wmsz88/flex-vib-monitor/资料/README.md

# 资料索引

> 本目录保存赛题原文、评分规则、硬件设计与软件方案说明，便于和代码对照阅读。
> 官方文件版权归竞赛组委会所有，此处仅作本项目归档与复盘使用。

## 00_命题

| 文件 | 说明 |
|---|---|
| `柔性检测模块设计及制作赛项命题（更新版）.pdf` | 2026 赛项一正式命题（10 页，答辩/实现以此为准） |
| `柔性检测模块设计及制作赛项命题（更新版）.docx` | 命题 Word 版，便于摘录 |
| `命题文字版.txt` | 从 PDF 提取的纯文本，方便全文搜索 |
| `旧版命题_20260908.pdf` | 早期版本，保留用于对比（线序、外框曾有冲突） |

## 01_规则与评分

| 文件 | 说明 |
|---|---|
| `2026年评分标准.pdf` | PCB 设计 40 分（扣分制）+ 制作及测试 60 分（现场发布） |
| `2026年评分标准_文字版.txt` | 评分标准纯文本 |
| `2026年竞赛通知及实施方案.pdf` | 赛事组织、赛程、参赛要求 |
| `规则与要求整理.md` | **推荐先读**：命题逐条整理、物料表、PCB 规范、模块说明 |

## 02_硬件设计

| 文件 | 说明 |
|---|---|
| `物料清单.xlsx` | 组委会物料清单（只能用清单内器件） |
| `网表_20260921.tel` | 定稿网表（PCB 与固件引脚依据） |
| `MPU6050引脚定义.docx` | 传感器模块引脚说明 |
| `柔性振动检测模块PCB设计文档.docx` | 本项目 PCB 设计说明 |
| `电路连接图.png` | 系统电路连接示意 |
| `系统框图.png` | 硬件系统框图 |
| `PCB布局分区图.png` | 柔性板布局与弯曲避让区 |
| `硬件设计说明/01-requirements.md` | 硬件需求 |
| `硬件设计说明/02-architecture.md` | 硬件架构 |
| `硬件设计说明/03-components.md` | 器件选型 |
| `硬件设计说明/04-constraints.md` | 结构与电气约束 |
| `硬件设计说明/05-validation.md` | 验证计划 |
| `硬件设计说明/06-decisions.md` | 关键决策记录 |
| `硬件设计说明/07-pinout.md` | **引脚分配总表** |
| `硬件设计说明/08-lceda-design-rules.md` | 立创 EDA 设计规则 |

## 03_软件与方案

| 文件 | 说明 |
|---|---|
| `软件说明书.md` | 固件结构、模块职责、串口命令、参数 |
| `现场输出文档.md` | 比赛口/调试口输出格式与现场排障 |
| `历届比赛串口协议调研.md` | 历届队伍协议做法与 `$VD` 设计依据 |
| `版本讲解/v5到v9说明书.md` | **推荐先读**：v5~v9 角色、差异、判据语义 |
| `版本讲解/v5到v6逐行讲解.md` | v6 接触三条逐行说明 |
| `版本讲解/v6到v7逐行讲解.md` | v7 输出适配逐行说明 |
| `版本讲解/v7到v8逐文件讲解.md` | v8 分层检测逐文件说明 |
| `版本讲解/可调参数总表.md` | `config.h` 参数分类与现场调整 |
| `版本讲解/其他改动要求.md` | 现场常见改法合集 |
| `版本讲解/三列输出改法.md` | 平台只要三列时的改法 |
| `版本讲解/指示灯闪烁常亮改法.md` | LED 语义与改法 |

## 阅读顺序建议

1. `背景与题目.md`（在仓库根目录）——先知道比赛要做什么；
2. `01_规则与评分/规则与要求整理.md`——逐条看硬性要求；
3. `00_命题/柔性检测模块设计及制作赛项命题（更新版）.pdf`——看原图与尺寸；
4. `02_硬件设计/硬件设计说明/07-pinout.md`——确认引脚；
5. `03_软件与方案/版本讲解/v5到v9说明书.md`——再看代码。
