wmsz88/flex-vib-monitor/资料/02_硬件设计/硬件设计说明/01-requirements.md

# 01 需求冻结 — 柔性振动检测模块（赛项一）

**项目**：2026 广东省工科大学生实验综合技能竞赛 · 柔性振动检测模块
**日期**：2026-09-20 | **模式**：快速模式（约束由竞赛命题锁定）
**参赛目标**：拿奖 + **软硬件全面能力提升**——硬件侧练柔性 PCB/电源设计/DFM 规则，软件侧练 I2C 驱动、采样与频谱分析（FFT/包络检测）、FreeRTOS 任务划分，一块板子把两条线都串起来

## 工程约束表

| 约束项 | 取值 | 来源 |
|---|---|---|
| 产品形态 | 柔性 PCB（PI 基底），贴合仿生手单指弧面 | 命题 |
| 外形尺寸 | 上限 ≤100×25mm；外框总长 **90.0mm = 左段 55.0×22.3mm + 右段 35.0×12.6mm**，弯曲避让区 15.2mm **嵌在右段起始处**（避让区之后净剩 **19.8×12.6mm** 可放器件） | 命题图4（2026-09-21 重测更正，详见 08 文档 §一） |
| 功能 | 检测 80~180Hz 持续振动频率 + 0~3Hz 启停频率（振动/静止周期）；接触状态识别；串口实时输出 | 命题 |
| 主控 | ESP32-C3 扩展模块（组委会封装，邮票孔，19×23mm） | 命题，锁定 |
| 传感 | MPU6050 扩展模块（组委会封装，14.86×11.5mm，板载 LDO + 5.1K I2C 上拉） | 命题，锁定 |
| 供电 | 外部 12V DC（杜邦线），4pin 接口线序 **①TX ②RX ③GND ④VIN** | 命题图 3（更新版 2026-09-29 确认，与网表一致） |
| 电源 | AMS1117-ADJ（SOT-223）12V→5V，红色 LED 指示输出正常 | 命题 |
| 电源开关 | 滑动开关 SK-3245S-L1-A，串联在 12V 前端，断开时零静态功耗 | 命题 |
| 指示灯 | 红=电源常亮；绿=MCU 控制闪烁；黄=预留可控 | 命题 |
| 串口 | TTL 电平（ESP32-C3 为 3.3V），GPIO21=TX / GPIO20=RX | 命题 + 模块引脚图 |
| 器件 | 只允许使用组委会物料清单（表1），不得超数量、不得外增 | 命题红线 |
| 提交 | 原理图源文件 + 原理图 PDF + PCB 源文件 + Gerber RS-274X，命名"学校+队名+PCB设计" | 命题 |
| 截止 | 校赛 2026-09-30 | 学校通知 |

## 假设清单（快速模式，可事后修改）

1. [假设] 现场考核不使用 Wi-Fi/蓝牙，仅 CPU + I2C + UART → 功耗按 ~100mA 预算。若必须开射频，需重新做热评估。
2. [假设] MPU6050 模块 VCC 接 5V 轨（模块板载 LDO 降压），其 I2C 上拉在模块内部。
3. [假设] 绿/黄 LED 由 GPIO 直驱（3.3V 逻辑），驱动电流 ~3mA 足够点亮 0805 LED。
4. [假设] 物料清单中 0805 电容耐压满足 12V 输入侧需求（组委会配套物料，默认按可用处理，焊接前复核丝印）。
5. [假设] 无反接保护（BOM 无二极管）→ 现场接线是唯一防线，列入高风险。
