wmsz88/flex-vib-monitor/资料/02_硬件设计/硬件设计说明/07-pinout.md

# 07 逐引脚接线表 — 柔性振动检测模块

**日期**：2026-09-20

> **用法**：本表逐脚列完全部器件的接线。已用的脚给出"接到哪"；未用的脚给出"**能接什么、什么类型、有什么限制**"，现场遇到余量时可直接照此扩展，不必回查手册。
> **依据**：引脚号与电气参数全部来自组委会《数据手册》原始文件（见每节"出处"行），**不以 AI 示意图为准**。
> **电平约定**：本文档"3.3V"指 ESP32-C3 供电域电平，VIH≥0.75×VDD=2.48V、VIL≤0.25×VDD=0.83V（手册表 5-4）。

---

## 0. 引脚清单总览（先看这张）

| 器件 | 引脚数 | 已接 | 未接（可扩展） |
|---|---|---|---|
| 4pin 开窗焊盘 | 4 | 4 | 0 |
| AMS1117-ADJ | 3（+散热片） | 3 | 0 |
| MPU6050 模块 | 8 | 5（VCC/GND/SCL/SDA/AD0） | 3（AUX_CL/AUX_DA/INT） |
| ESP32-C3 模块 | 16 邮票孔 | 6（5V/GND/GPIO8/GPIO9/GPIO10/GPIO20/GPIO21） | GPIO0~GPIO4、GPIO6、GPIO7、3.3V |
| 红 LED / 绿 LED / 黄 LED | 各 2 | 各 2 | 0 |
| 360Ω 限流电阻 | 2 | 2 | 0 |
| 滑动开关 | 6 焊盘（3 触点组） | 3 组 | 0 |
| 杜邦线 | 4 根 | 4 | 0 |
| 仿生手 | — | — | 机械件，无电气连接 |

---

## 1. 4pin 开窗焊盘（对外电源 + 串口）

**规格**：4 个开窗焊盘，每个开窗 **> 4mm × 2mm**；焊 4 根 **30mm 公头杜邦线**；线序按命题**图 3**（AT 已实测命题 PDF 第 4 页）。
**✅ 更新版赛题（2026-09-29）已删除旧正文"VIN/GND/TXD/RXD"的矛盾文字，图 3 为唯一权威：①TX ②RX ③GND ④VIN，与本项目网表一致，无需改动。**
**⚠ 线序是 Tx→Rx→GND→VIN，与"电源在前"的直觉相反，焊错会把 12V 灌进 GPIO21 烧模块。**

| 焊盘 | 丝印 | 名称 | 类型 | 数值 | 接到哪 | 备注 |
|---|---|---|---|---|---|---|
| ① | Tx | 串口发送 | 数字 **输出**（3.3V TTL） | 高电平 ≥2.64V | **ESP32-C3 GPIO21（U0TXD，芯片第 28 脚）** | 出板方向：MCU → 测试平台 |
| ② | Rx | 串口接收 | 数字 **输入**（3.3V TTL） | VIH≥2.48V | **ESP32-C3 GPIO20（U0RXD，芯片第 27 脚）** | 入板方向：测试平台 → MCU；该脚复位后带弱上拉 |
| ③ | GND | 地 | 电源 | 0V | GND 轨（返回外部电源负极） | 与 ④ 成对，必须共地 |
| ④ | VIN | 电源输入 | 电源 **输入** | **12V DC**，≤350mA 峰值 | **滑动开关 → AMS1117-ADJ VIN** | 主回路入口，按 30mil 以上加宽 |

**可接什么（若现场需要扩展）**：这 4 个焊盘是唯一对外接口，不可挪作他用。若要取 3.3V 给外部，**不能从 ① 或 ② 借线**（那是 UART），需另找模块的 3.3V 脚（见第 4 节）。
**出处**：命题 PDF 图 3、`附件1/柔性振动检测模块的设计赛项命题.pdf` 第 4 页；电平见单片机制手册表 5-4。

---

## 2. AMS1117-ADJ（SOT-223）

**⚠ 本芯片不是"VIN/GND/VOUT"排版：第 ① 脚是 ADJ/GND，不是 GND。** 引脚定义来自手册第 1 页 Pinning information。

| 引脚 | 名称 | 类型 | 数值 | 接到哪 | 备注 |
|---|---|---|---|---|---|
| ① | **ADJ/GND** | 反馈输入 | VREF 1.231~1.269V | **R1 120Ω → GND 轨** 且 **R2 360Ω → VOUT** | 只有约 1.25V，**不是地**；两路电阻都没焊时会输出接近 VIN 的电压 |
| ② | VOUT | 电源 **输出** | **5.02V**，≤1A | **5V 轨**（供 ESP32 5V 脚、MPU VCC、红 LED、去耦电容） | 主输出；输出精度 = ±1.5%（VREF 容差）± Iadj 项 |
| ③ | VIN | 电源 **输入** | 12V DC（极限 18V，推荐 12V） | **滑动开关动端**；CIN 10µF 就近到 GND | 与 VOUT 压差 7V，远大于压差 1.2V@1A |
| TAB | 散热片 | 机械/电气 | 与 ② 内部相连 | 铜皮加宽散热（**Rja=120°C/W**） | 不接也能工作，接 ② 更好散热；**切勿接到 ① 或地** |

**反馈网络两个电阻**（务必核对，这里最容易焊反）：

```
VOUT (②) ──[ R2 = 360Ω ]── ADJ (①) ──[ R1 = 120Ω ]── GND
                              │
                         Cadj 10µF → GND
```

| 电阻 | 位置 | 数值 | 若焊错会怎样 |
|---|---|---|---|
| R1 | ADJ → GND | 120Ω | R1/R2 对调 → Vout ≈ 1.63V，模块欠压不启动 |
| R2 | VOUT → ADJ | 360Ω | 同上 |

**出处**：`数据手册/电源稳压芯片.pdf`（UMW/UTD AMS1117，Mar.2025）第 1 页 Pinning、第 4 页电气特性、第 3 页热阻。

---

## 3. MPU6050 传感器模块（8 脚邮票孔）

**⚠ 引脚名以命题表 2 为准。** 规则整理文档里写的 "p4=SDA、p3=SCL" 与命题表 2 相反，**本表按命题表 2**（p3=SCL、p4=SDA）；布线前请再核一次组委会库的符号引脚名。

| 引脚 | 名称 | 类型 | 数值 | 接到哪 | 备注 |
|---|---|---|---|---|---|
| 1 | VCC | 电源 **输入** | **5V**（命题表 2 明写"工作电压 5V"） | **5V 轨**（跨弯曲避让区，20mil） | 模块板载 LDO 再稳到 3.3V 给芯片；**不要改接 3.3V 脚** |
| 2 | GND | 电源 | 0V | GND 轨（跨弯曲避让区） | 必须与 5V 一同跨区，共 2 根 |
| 3 | SCL | 数字 **输入**（双向总线） | 3.3V，模块板载 **5.1K 上拉** | **ESP32-C3 GPIO9**（跨弯曲避让区） | I2C 时钟，**板载上拉不可改**；跨区第 3 根 |
| 4 | SDA | 数字 **双向 I/O** | 3.3V，模块板载 **5.1K 上拉** | **ESP32-C3 GPIO8**（跨弯曲避让区） | I2C 数据，**跨区第 4 根** |
| 5 | AD0 | 数字 **输入** | — | **GND 轨**（就地接，在窄条侧） | 决定从机地址：AD0=0 → **0x68**（手册 6.4 节） |
| 6 | AUX_CL | 数字 **输出**（主机 I2C 时钟） | 3.3V 域 | **未接（悬空）** | **可接**：第二个 I2C 从器件的 SCL（MPU6050 可当主机读外部传感器）。本设计不用；焊盘留一个**过孔或测试点**，现场不必加器件 |
| 7 | AUX_DA | 数字 **双向 I/O**（主机 I2C 数据） | 3.3V 域 | **未接（悬空）** | **可接**：同 ⑥，第二从器件的 SDA。留测试点 |
| 8 | INT | 数字 **输出**（中断） | 3.3V，低有效可配，脉冲宽度 50µs | **未接（悬空）** | **可接**：任意空闲 GPIO（首选 **GPIO1**，见第 4 节），配 `INT_ENABLE` + `INT_PIN_CFG` 后可用中断唤醒代替轮询，降低 I2C 占用。本设计用轮询 |

**悬空脚的收尾要求**：⑥⑦⑧ 三个脚虽不用，但**建议各引出一个 ≥10mil 的测试点/过孔**，方便现场用示波器看 INT 波形或临时飞线，不占清单元件。

**芯片域参数（供固件配置，来自 InvenSense PS-MPU-6000A-00 Rev 3.4）**：

| 项目 | 值 | 对设计的意义 |
|---|---|---|
| 加速度量程 / 灵敏度 | ±2 / ±4 / ±8 / ±16g；16384 / 8192 / 4096 / 2048 LSB/g | **默认用 ±2g**（分辨率最高）；冲击削顶再退 ±4g |
| 输出数据率 ODR | 4 ~ 1000 Hz | 80~180Hz 振动需 ≥360Hz 采样，取 **500Hz 或 1kHz** |
| 低通滤波 LPF | 5 ~ 260 Hz | 截止频率取 **≥200Hz**，别把 180Hz 滤掉 |
| 工作电流 | 加速度计单独 **500µA**；陀螺+加速度计 3.8mA | 只开加速度计可省电，但电流预算已按 5mA 留 |
| I2C 速率 | 标准 100kHz / 快速 400kHz；**总线电容 Cb < 400pF** | **固件降到 100kHz**（见 04 文档约束） |
| 供电敏感性 | 0.2°/s（10–250Hz，100mVpp 纹波） | 5V 轨纹波会串成零漂，覆盖你要测的频段 → 去耦必须到位 |
| 零偏 | ±50mg（X/Y）、±80mg（Z） | 上电必须做静态零偏标定 |

**出处**：命题 PDF 表 2（模块引脚表、工作电压 5V、尺寸 14.86×11.5mm）；`数据手册/传感器模块.pdf`（InvenSense 原厂手册，即芯片级）6.1~6.9 节。

---

## 4. ESP32-C3 单片机模块（16 邮票孔，2.54mm 间距）

**⚠ 引脚序号不写死**：模块有 **16 个邮票孔**（手工数，见 `数据手册/单片机模块.pdf` 嵌图；文字层编码损坏，未文本化），但"第几号孔对应哪个 GPIO"**必须照组委会封装库的符号引脚名**逐脚核对后再落网表，不要凭本表序号布线。题目原文：*"Layout 时参考'封装库'文件中的封装。"*

**模块本身已包含**：板载 3.3V LDO、USB Type-C（烧录）、RST 键、BOOT 键。**12V/5V 不直接进芯片**。

### 4.1 已接引脚

| 信号名 | 类型 | 数值 | 接到哪 | 备注 |
|---|---|---|---|---|
| 5V | 电源 **输入** | 5.0V | **5V 轨** | 模块内 LDO 转 3.3V；这是模块唯一供电入口 |
| G / GND | 电源 | 0V | **GND 轨** | 与 4pin 的 GND 同网 |
| GPIO8 | 数字 **双向**（I2C SDA） | 3.3V，内部弱上拉 45kΩ | **MPU6050 p4**（跨弯曲避让区） | **复位时 IE，有内部弱上拉**：MPU 的 5.1K 上拉会让它上电即为高——这是正常态；**布线/调试时严禁把 SDA 短路到地** |
| GPIO9 | 数字 **双向**（I2C SCL） | 3.3V，内部弱上拉 45kΩ | **MPU6050 p3**（跨弯曲避让区） | 同上，**复位时 IE + WPU** |
| GPIO10 | 数字 **输出**（驱动 LED） | 3.3V，IOH=40mA | **→ 360Ω → 绿 LED → GND** | 心跳闪烁；电流约 2.8mA，余量充足 |
| GPIO20 | 数字 **输入**（U0RXD） | 3.3V，复位后 IE+WPU | **4pin 焊盘② Rx** | 接测试平台发送端 |
| GPIO21 | 数字 **输出**（U0TXD） | 3.3V | **4pin 焊盘① Tx** | 接测试平台接收端 |

### 4.2 未接引脚 —— 每脚能接什么（现场扩展直接照这个用）

| 引脚 | 芯片脚号 | 能做输入/输出 | 特殊功能 | 限制与建议 |
|---|---|---|---|---|
| **GPIO0** | 4 | 双向 I/O/T | ADC1_CH0、XTAL_32K_P、RTC 域 | **最佳备用脚**。属于 RTC 电源域，Deep-sleep 下仍可工作；**可接**：MPU6050 的 INT（省一个中断源）、测试点 |
| **GPIO1** | 5 | 双向 I/O/T | ADC1_CH1、XTAL_32K_N、RTC 域 | 同 GPIO0，**次选备用脚**；**可接**：MPU INT 首选（用 32K 晶振时避开 GPIO0/1） |
| **GPIO2** | 6 | 双向 I/O/T | ADC1_CH2、FSPIQ | ⚠ **复位时有 IE**，与 strapping 相关；**上电时禁止被外部拉低**，否则可能进不了正常运行。**建议不接任何东西**，最多留测试点 |
| **GPIO3** | 8 | 双向 I/O/T | ADC1_CH3 | 普通数字 I/O；**可接**：第二路 LED、按键、蜂鸣器（注意清单元件限制） |
| **GPIO4** | 9 | 双向 I/O/T | ADC1_CH4、MTMS、FSPIHD | **完全可用**。MTMS 只是芯片的默认复用功能，模块没引出 JTAG 排针、也没连外部调试器（调试走板载 USB 的 USB Serial/JTAG，在芯片 GPIO18/19 上，未引出），**重映射后就是普通 I/O**。**可接**：MPU INT（次选）、备用输出 |
| **GPIO5** | 10 | 双向 I/O/T | ADC2_CH0、MTDI、FSPIWP | **已是黄 LED 的预留控制脚**（见第 5 节）；同上，MTDI 只是默认复用 |
| **GPIO6** | 12 | 双向 I/O/T | MTCK、FSPICLK、I2S | **完全可用**，同上。**可接**：备用数字输出、I2S |
| **GPIO7** | 13 | 双向 I/O/T | MTDO、FSPID、I2S | **完全可用**，同上。**可接**：备用数字输出、I2S |
| **3.3** | — | 电源 **输出** | 3.3V（模块板载 LDO 输出） | **可接**：给外部小负载（≤模块 LDO 余量）、给 LED 做电平参考。**不要**用它给 MPU6050 供电（模块要求 5V，其内部 LDO 在 3.3V 输入下会压差不足）；**不要**用它给 5V 轨上的任何东西供电 |

**蜂鸣器/按键能否加**：清单元件里**没有按键和蜂鸣器**，所以这些脚在本次比赛中**只能做测试点或飞线口**，不得焊清单外器件（命题：非清单器件即取消资格）。

### 4.3 空闲引脚统计（决定能不能加第 5 根跨区线）

**真正空闲且无功能的脚有 7 个**：GPIO0、GPIO1、GPIO3、GPIO4、GPIO6、GPIO7（GPIO2 建议不接）。其中
**首选中断脚 = GPIO1**，理由：非 strapping 脚、非 RTC 域冲突脚、复位后为输入态、无外部上拉要求（对比 GPIO0 在部分模块上被用作 BOOT 键，接了会冲突）。

**结论：引脚完全不是瓶颈，跨弯曲避让区的走线额度才是**（见第 8 节）。

**模块自身的隐藏脚（不可用，仅供理解）**：芯片的 GPIO18/GPIO19（USB_D-/D+）、GPIO11~GPIO17（内部 SPI flash）、CHIP_EN、XTAL、VDDA 等**已被模块内部占用**，没有引到邮票孔。

**出处**：`数据手册/单片机模块.pdf`（乐鑫《ESP32-C3 系列芯片技术规格书 v1.9》）**附录 A 管脚总览**（第 60 页）、表 5-4 直流电气特性（第 49 页）、表 5-8/5-9 功耗（第 51 页）、图 2-3 电源管理（第 23 页）；模块外形/16 邮票孔/2.54mm 见命题第九节。

---

## 5. 三颗指示 LED

| LED | 阳极（+）接 | 阴极（−）接 | 类型 | 电流 | 亮度/用途 |
|---|---|---|---|---|---|
| **红** NCD0805R1 | **5V 轨** | **360Ω → GND 轨** | 电源指示 | **≈8.0mA** | 常亮 = 稳压输出正常（命题硬性要求） |
| **绿** NCD0805G1 | **GPIO10 → 120Ω** | GND 轨 | MCU 数字输出驱动 | **≈2.5mA**（VF≈3.0V 时） | 程序闪烁 = 电路正常运行 |
| **黄** NCD0805Y1 | **GPIO5 → 360Ω** | GND 轨 | MCU 数字输出驱动 | **≈2.8mA** | 预留，可控制亮灭 |

> 限流电阻以**定稿网表 `Netlist_PCB1_2026-09-24.tel` 为准**：R7=**120Ω**（绿）、R8=360Ω（黄）、R3=360Ω（红）。
> 本表旧版把绿 LED 写成 360Ω，已更正——120Ω 对绿 LED 更有利（见下方风险）。

**限流电阻位置说明**：红 LED 的 360Ω 画在**阴极→GND** 之间（与文档写法一致）；绿/黄 LED 的 360Ω 画在**GPIO→阳极** 之间。二者电气等效，**但要在原理图上统一**，避免评审对不上。

**电流校核（按最劣 VF 算）**：

| LED | 供电 | VF 范围（更新版表1 官方规格） | I = (V − VF)/R | 手册极限 IF | 余量 |
|---|---|---|---|---|---|
| 红 | 5.02V | 1.6 ~ 2.6V | 6.7 ~ 9.8mA（R3=360Ω） | 25mA | ≥2.5× |
| 绿 | 3.3V | **2.5 ~ 3.6V**（@20mA） | **0 ~ 6.7mA**（R7=120Ω） | **20mA** | 最劣 VF 时**可能不亮**，需实测 VF |
| 黄 | 3.3V | 1.6 ~ 2.6V | 1.9 ~ 5.0mA（R8=360Ω） | 25mA | ≥5× |

**⚠ 绿 LED 的风险（更新版表1 已把 VF 2.5~3.6V 写成官方规格）**：VF 上限 3.6V **高于 GPIO 的 3.3V**。
若实物 VF 偏高，绿 LED 电流趋近 0，可能不亮或极暗。**已决策（2026-09-29）：不改板**，理由是典型 VF≈3.0V 时
(3.3−3.0)/120Ω ≈ 2.5mA 仍可辨，且赛题只考核"闪烁"行为，距提交时间紧。现场预案（按序执行）：
1. 先换备件绿灯（清单每色 2 颗，本设计各用 1 颗）再观察；
2. 仍不亮 → 飞线改灌电流：LED 反接（阳极→5V 轨、阴极→R7→GPIO10），R7 由 120Ω 换 360Ω（(5−3.0)/360≈5.6mA 更稳，同封装换料，清单内）；
3. 固件 `LED_ACTIVE_LOW` 宏改 `1` 重烧（selftest / vibmon 顶部配置区均已预留）。

**"每个器件只能用一次"核对**：红/绿/黄 LED 清单各 **2 颗**，本设计各用 **1 颗**，剩余各 1 颗作为现场备件（焊接损坏时可换）。**三路指示必须用三颗不同颜色的 LED，不可一颗 LED 兼作两个指示**（命题要求红=常亮、绿=闪烁、黄=可控，三者状态独立）。

**出处**：`数据手册/红色LED.pdf`、`绿色LED.pdf`、`黄色LED.pdf`（国星 NCD0805 系列，表单 FGH/BD-0053.01-21B）；驱动能力见 ESP32-C3 手册表 5-4（IOH=40mA/IOL=28mA）。

---

## 6. 滑动开关 SK-3245S-L1-A

| 触点组 | 类型 | 接到哪 | 备注 |
|---|---|---|---|
| 组 1（焊盘 1 / 4，成对） | 电源 **输入** | **4pin 焊盘④ VIN（12V）** | 12V 入端 |
| 组 2（焊盘 2 / 5，成对） | 电源 **输出** | **→ AMS1117-ADJ 引脚③ VIN** | 开关闭合时导通 |
| 组 3（焊盘 3 / 6，成对） | 电源 **回流** | **GND 轨** | 供内藏指示/第二极用 |

**⚠ 封装与符号的引脚号必须对齐**：手册封装图上是 **6 个焊盘**（编号 1~6，1-4 / 2-5 / 3-6 在机械上成对），而题目文字是"卧贴**两档 3 脚**"。**建原理图符号时务必照组委会库的引脚编号**，否则网表上的 1/2/3 会落到错误的焊盘上（症状：开关不起作用或 12V 直通 LDO）。

**额定值校核**：开关额定 **DC 12V / 50mA**。AMS1117 是**线性稳压器，输入电流≈输出电流**（无 DC-DC 的 1/效率变换），12V 侧电流 = 5V 轨总负载 ≈ **75mA（典型）**，已**超过开关额定 50mA**——超幅 50%，属持续过载但 LDO 不产生开关峰，实际触点容量经验上可承受；**固件禁止开 Wi-Fi/BT**（峰值 350mA 属瞬态且射频禁用，不构成损坏，但会加剧触点负载）。**缓解手段 = 走线加宽给触点降阻补强**（开关前后 12V/5V 走线都取 30mil，减小接触电阻外的回路阻抗）。
→ **这是"固件禁止开 Wi-Fi/BT"的第二个理由**（第一个是 LDO 过热）。

**"断开时不得有静态功耗"**：开关串在 LDO **前端**，断开后 CIN/Cadj/Cout 随 5V 消失，反馈分流（10.4mA）也消失，**整板静态电流为 0**，满足命题要求 ✓。

**出处**：`数据手册/滑动开关.pdf`（XKB Industrial Precision，SK-3245S-X，Rating: DC 12V 50mA，Life 10,000 cycles）；封装配对表 `SK-3245S-L1-A → L1.2mm, foot A/B`。

---

## 6.5 MPU6050 的 INT 与 AUX（XDA/XCL）—— 题设"启停频率"到底要不要用？

**先说结论**：

| 问题 | 结论 |
|---|---|
| 测 0~3Hz 启停频率，**要不要接 XDA/XCL**？ | **不需要，要了也没用**。XDA/XCL 不是时钟输入、不是计时资源 |
| 要不要接 INT？ | **推荐接**，但**它不是"频率源"，是"采样时刻触发器"**；接了能消掉采样抖动 |
| 不接 INT 行不行？ | 行。1kHz/500Hz 定速轮询，每 3Hz 周期仍有 166~333 个样本点，足够 |

### 6.5.1 为什么 XDA/XCL 帮不上"启停频率"

手册对这两个脚的原文定义（第 7.6 节功能框图 + 引脚表）：

> **Master I2C Serial Interface / Auxiliary I2C serial interface for 3rd party magnetometer & other sensors**
> Pin 6 **AUX_DA**：I2C master serial data, for connecting to external sensors
> Pin 7 **AUX_CL**：I2C Master serial clock, for connecting to external sensors

即：这是 MPU6050 **当主机**、去读**第二个从器件**（磁力计等）的总线。它的电气特性（手册 Auxiliary I2C I/O 表）明确是 **I/O**：

| 参数 | 值 | 含义 |
|---|---|---|
| VIL / VIH | −0.5 ~ 0.3×VLOGIC / 0.7×VLOGIC ~ VLOGIC+0.5 | 是**信号电平**，不是时钟源指标 |
| IOL | 1mA @ VOL=0.4V | **只有 1mA 驱动能力**，极弱 |
| CI | < 10pF | — |

**三条硬理由说明它不参与计时**：

1. **它不是时钟输入**。芯片真正用于"与外部世界同步"的引脚是 **FSYNC**（手册 5.1 节："External sync signal connected to the FSYNC pin supports image, video and GPS synchronization"）和 **CLKIN**（可选外部基准时钟，32.768kHz 或 19.2MHz）。**这两个脚在模块上都没有引出**（模块只有 8 脚：VCC/GND/SCL/SDA/AD0/AUX_CL/AUX_DA/INT；手册第 7.1 节："FSYNC: Connect to GND if unused"）。
2. **驱动能力只有 1mA、且必须配从器件地址**，不能当 GPIO 用、不能做边沿计数。
3. **启停频率的"时基"根本不来自外部**。它来自 **MPU6050 自己的 ODR 时钟**（片上 timing generator，手册 5.5 节："On-chip timing generator **±1% frequency variation** over full temperature range"）。±1% 对 0~3Hz 的包络测量是 0.03Hz 的误差，完全够用。真正决定精度的不是有没有外部时钟，而是**你怎么判定"起/停"**（见 6.5.3）。

### 6.5.2 INT 有用在哪：它消掉的是**采样抖动**，不是频率误差

手册引脚表原文：

> Pin 12 **INT**：Interrupt digital output (**totem pole or open-drain**)
> （电气）VOL.INT1, INT Low-Level Output Voltage：OPEN=1, 0.3mA sink current → **0.1V**

数据手册级别**没有**中断源清单（它另外引用了《MPU-6000/MPU-6050 Register Map and Register Descriptions》——**那份文件不在组委会资料包里**，见第 10 节）。但按 MPU6050 通用寄存器定义，INT 的常用可编程事件包括：**Data Ready（DRDY，每个 ODR 周期触发一次）**、FIFO 水位、运动/零运动检测、自由落体、tap 检测。

**关键区别**：

- **DRDY 中断不是"频率源"**。它只是说"此刻有新样本"，跳变沿**不等于**振动周期。所以接到 MCU 上**不能直接拿去计数得到 80~180Hz**。
- 它的价值在于**把采样时刻锚定到传感器**：不接 INT 时，你在 I2C 读取完成时打时间戳，读 14 字节的耗时随总线竞争、电容、固件调度波动 → 时间戳抖动；接了 INT，DRDY 跳变即为新样本的字面时刻，抖动被消掉。
- 对 **80~180Hz 主频**来说这个抖动是"锦上添花"（500Hz 采样对 180Hz 只有 2.8× 过采样，抖动会影响波形质量）；对 **0~3Hz 启停包络**来说它**几乎无意义**（166 个样本点/周期，抖动淹没在判据里）。

**代价（这是真正的约束）**：MPU6050 在窄条区，INT 若要接回主体区，**弯曲避让区就从 4 根线变 5 根**。第 8 节的 4 根是"5V/GND/SDA/SCL 必须过"的最小集，第 5 根是纯余量——**弯曲区只有 15.2mm，是否能容纳第 5 根要按线距 ≥10mil 实算，不要想当然**。

### 6.5.3 真正决定启停频率精度的是判据，不是引脚

0~3Hz 启停频率 = **振动包络的周期性**。算法本身长这样，与 XDA/XCL、INT 都无关：

```
每个 ODR 周期读一次加速度幅值 A[n] = |a|（或某轴峰值）
  → 滑动窗 RMS / 包络检波 得 E[n]（窗长取 180Hz 的若干个周期）
  → 与滞回阈值 Th 比较：E>Th 判"振"，E<Th 判"停"
  → 对"振/停"边沿序列计时 → 求周期 → 得 0~3Hz
```

- **必须用滞回阈值（双阈值）**，单阈值会在噪声边界反复穿越，把 3Hz 数成几十 Hz；
- 采样率按 80~180Hz 奈奎斯特取 **≥500Hz**（建议 1kHz），此采样率下 3Hz 周期有 333 点，**分辨率绰绰有余**；
- 判定门限建议由现场静置标定得到（用 6.2 节的零偏 ±50mg 做基准，阈值取零偏噪声的 3~5 倍）。

**所以三项排序**：判据设计 ≫ INT 触发 ≫ XDA/XCL（后者为 0）。把精力放在阈值和包络窗上。

---

## 7. 被动件与去耦电容

| 元件 | 一端接 | 另一端接 | 位置要求 |
|---|---|---|---|
| CIN 10µF | AMS1117 引脚③ VIN | GND 轨 | 紧贴 LDO 输入脚（≤5mm） |
| Cadj 10µF | AMS1117 引脚① ADJ | GND 轨 | 紧贴 ADJ 脚，与 R1 同一节点 |
| Cout 22µF | 5V 轨 | GND 轨 | 紧贴 LDO 输出脚 |
| 0.1µF（去耦） | 5V 轨 | GND 轨 | **放窄条侧、MPU6050 模块 VCC 旁**（跨区后 5V 已劣化，去耦必须在负载端；若窄条空间不足才移至主体区，此时需实测 5V 纹波） |
| R1 120Ω | ADJ（①） | GND 轨 | 见第 2 节 |
| R2 360Ω | VOUT（②） | ADJ（①） | 见第 2 节 |
| 360Ω ×2 | GPIO10 / GPIO5 | 绿 LED / 黄 LED 阳极 | 紧邻 LED |
| 360Ω ×1 | 红 LED 阴极 | GND 轨 | 紧邻 LED |

**未使用的清单器件**：1µF×3、1KΩ×5、1.5KΩ×5、3KΩ×5、4.7KΩ×5（全部未用，**不要为了"用满清单"而加**——命题只限制"不得超过数量"，不要求用尽）。仅备选：若 LDO 过热，按 03 文档备选方案把 R1 改 1K∥1K、R2 改 1.5K。

---

## 8. 跨弯曲避让区的 4 根线（唯一允许跨区的线）

| # | 网络 | 从 | 到 | 线宽 |
|---|---|---|---|---|
| 1 | 5V | AMS1117 VOUT（主体区） | MPU6050 VCC（窄条） | 20mil |
| 2 | GND | 主体区 GND 轨 | MPU6050 GND（窄条） | 20mil |
| 3 | SDA | ESP32-C3 GPIO8 | MPU6050 p4 | 20mil |
| 4 | SCL | ESP32-C3 GPIO9 | MPU6050 p3 | 20mil |

**规则③（弯曲区禁放任何元器件、只允许走线+过孔）+ 04 文档要求 = 恰好 4 根** ✓
**AD0 的处理**：AD0 接 GND，但 **MPU6050 模块就在窄条上**，AD0→GND 的连线**在窄条侧就地完成**，不需要跨区（若误接回主体区，跨区线变 5 根，违规）。

---

## 9. 本表与旧文档的冲突清单（务必同步修正）

| # | 旧写法 | 正确写法 | 依据 |
|---|---|---|---|
| 1 | 4pin 线序 "VIN/GND/TXD/RXD" | **Tx / Rx / GND / VIN**（焊盘①→④） | ✅ **已由更新版赛题（2026-09-29）解决**：旧正文矛盾句删除，图 3 为唯一权威 |
| 2 | 02 文档路径⑯⑰ 把 TXD/RXD 写成焊盘③④ | 焊盘**①**/② | ✅ 同上，更新版图 3 确认 |
| 3 | 规则整理 "MPU6050 p4=SDA、p3=SCL" | **p3=SCL、p4=SDA** | ✅ 更新版表 2 再次确认（p3=SCL、p4=SDA、VCC=5V） |
| 4 | 04 文档 "MPU_VCC ← 5V 轨 → MPU6050 p1" ✓ 正确 | 保持 | ✅ 更新版表 2 "VCC 接标准电压 5V" 再次坐实；02 文档"MPU 改接 3.3V"的说法**作废** |
| 5 | 02 文档 "MPU6050 SDA(p4)" / "(p3)" | 保持 ✓ | — |
| 6 | 02 文档反馈支路标注 `R1=120Ω(Vout-ADJ)` | 应为 **R1(Vout-ADJ)=120Ω、R2(ADJ-GND)=360Ω** | 公式 Vout=1.25(1+R2/R1)+Iadj·R2；以网表 09-24 为准 |
| 7 | 07 文档初版把 GPIO4/6/7 标为"JTAG 占用、不接" | **错**，三者重映射后完全可用 | 附录 A：GPIO4=I/O/T(MTMS 仅默认复用)；模块未引出 JTAG | 
| 8 | 本表旧版把绿 LED 限流写成 360Ω | **R7=120Ω**（绿）、R8=360Ω（黄）、R3=360Ω（红） | 定稿网表 `Netlist_PCB1_2026-09-24.tel` |
| 9 | 嘉立创规则清单"55+15.2+35=105.2 与 90 矛盾" | **外框 90.0 = 55.0 + 35.0，15.2 弯曲区嵌在右段起始处** | 更新版图 4（新旧图一致，是清单自己相加的口径错了） |

---

## 10. 换器件前必须知道的认识边界

本表所有电气数值都来自组委会《数据手册》本地文件。有一份**关键文件组委会没有提供**：

**《MPU-6000/MPU-6050 Register Map and Register Descriptions》缺位。** MPU6050 的产品规格书（PS-MPU-6000A-00）里明确写着：

> "For references to register map and descriptions of individual registers, please refer to the MPU-6000/MPU-6050 Register Map and Register Descriptions."

也就是说：**寄存器名、寄存器地址、中断源清单、DMP 固件**这些"写代码才需要的东西"，**产品规格书里没有**。本表据此的表述边界：

| 内容 | 依据强度 |
|---|---|
| 引脚定义、电平、电流、量程、ODR、I2C 时序、地址 0x68 | **强**：产品规格书原文，可写进报告 |
| INT 支持哪些事件、`INT_ENABLE`/`INT_PIN_CFG` 寄存器地址 | **弱**：产品规格书只说"programmable interrupts（第 8 节）"，未列表。需另找官方寄存器手册（InvenSense/TDK 官网可下载），**报告里不要凭记忆写寄存器地址** |
| DMP 做运动/启动检测 | **不可用**：DMP 需要厂商提供的固件镜像，资料包里没有。**不要在设计里依赖 DMP** |

**行动项**：若报告要写寄存器级实现，**先联网下载官方《Register Map and Register Descriptions》（文档号 RM-MPU-6000A-00）**，再落笔。
