wmsz88/flex-vib-monitor/串口练习.md

# 串口练习：从 0x55 帧到能自己写协议

> 配套代码：`tools/serial_drill.py`
> 参考答案：`串口练习_答案.md`（做完再看）
> 目标：不是“看懂”，而是能独立写出编码器、解析器和测试，并能上板抓 hex 验证。

---

## 0. 先记住这张图

```text
发送端                                    接收端
Result                                  字节流
  │                                       │
  ├─ encode_frame() → bytes ── UART ──→  decode_frames() → 记录
  │     0x55 A5 02 01 01 0D              │
  │                                       └─ 缓冲、找帧头、校验、拼帧
```

串口问题永远分三层，排错也按这个顺序：

| 层 | 内容 | 典型问题 |
|---|---|---|
| 物理层 | TX/RX、GND、电平、波特率、8N1 | 没共地、TX/RX 接反、波特率不一致 |
| 帧层 | 字节顺序、帧头、长度、帧尾、校验 | 发成 ASCII、多一个 `\r\n`、字节序反了 |
| 应用层 | 字段含义、单位、无效值、更新率 | 165.2 发成 1652、无效值发 0 分不清 |

---

## 1. 热身题（不写代码，先算）

**1.1** 9600 8N1，1 个字节（8 数据位 + 1 起始位 + 1 停止位）在线上占多少毫秒？

**1.2** 6 字节一帧，在 9600 下传完需要多少毫秒？

**1.3** 每 20ms 发一帧，串口占用率大约是多少？

**1.4** 下面两句话分别错在哪？

```c
Serial1.print(buf);      // buf 里是 0x55 0xA5 ...
Serial1.println("OK");
```

**1.5** “8N1 的 1 位停止位”和“帧尾的停止位字节 0x0D”是一回事吗？

---

## 2. Level 1：手工编码

协议（默认 6 字节）：

```text
0x55 | 振动整数 | 振动小数 | 启停 | 接触 | 0x0D
```

规则：

- 频率按 0.1Hz 拆分，四舍五入；
- 无效频率发 `0, 0`；
- 启停：1 = 振动，0 = 停；
- 接触：1 = 接触，0 = 未接触；
- 整数部分超过 255 时饱和到 255。

写出下面每一组的十六进制字节：

| # | 频率 | 启停 | 接触 | 期望帧 |
|---|---|---:|---:|---|
| 1 | 165.2Hz | 1 | 1 | ? |
| 2 | 80.0Hz | 1 | 0 | ? |
| 3 | 179.9Hz | 1 | 1 | ? |
| 4 | 无效 | 0 | 0 | ? |
| 5 | 99.99Hz | 1 | 0 | ? |
| 6 | 165.26Hz | 1 | 1 | ? |
| 7 | 300.0Hz | 1 | 0 | ? |

**加练**：如果平台要求 5 字节（没有 0x0D），第 1 组应该是什么？

---

## 3. Level 2：写编码器

打开 `tools/serial_drill.py`，实现：

```python
def encode_frame(freq, vib, contact, trailer=True) -> bytes:
    ...
```

要求：

1. `freq is None`、`NaN`、`inf`、`<= 0` 都按无效处理，发 `0, 0`；
2. 用 `+0.5` 做四舍五入（不要用 `round()`，Python 的银行家舍入会让你踩坑）；
3. 整数部分限制在 `0..255`；
4. `trailer=False` 时返回 5 字节；
5. 不允许用字符串拼接，直接返回 `bytes`。

验收：

```text
python 代码\tools\serial_drill.py
```

做到 Level 2 时，编码相关用例应全部通过。

---

## 4. Level 3：写解析器

实现：

```python
class FrameParser:
    def feed(self, data: bytes) -> list[dict]:
        ...
```

要求：

1. 数据可能被任意切块：一次 1 字节、一次 100 字节都要能拼出完整帧；
2. 帧前可以有垃圾字节；
3. 帧尾不是 `0x0D` 时丢弃，并继续向后找下一帧；
4. 不完整帧要留在缓冲区，等下次 `feed()`；
5. 返回记录格式：

```python
{"freq": 165.2, "vib": 1, "contact": 1}
```

6. `fi == 0 and fd == 0` 时，`freq` 返回 `None`（表示无效）。

**关键陷阱**：85.0Hz 的整数部分是 `0x55`，和帧头一模一样。
解析器不能“看到 0x55 就当帧头”，必须按固定长度 + 帧尾判断。

验收用例：

| 输入 | 期望 |
|---|---|
| 单帧 | 1 条记录 |
| 两帧粘连 | 2 条记录 |
| 逐字节喂 | 1 条记录 |
| 帧前有 `AA BB` | 1 条记录 |
| 坏帧尾 + 好帧 | 只出好帧 |
| 85.0Hz 帧 | `freq=85.0`，不能被当成两个帧头 |
| 半帧 | 0 条记录，且保留缓冲 |

---

## 5. Level 4：故障注入

在解析器测试里加下面几组，必须都能过：

1. **帧头出现在数据里**：`55 55 00 01 00 0D`（85.0Hz）；
2. **坏帧尾**：`55 A5 02 01 01 00`；
3. **截断帧**：`55 A5 02`，再喂 `01 01 0D`；
4. **重复帧头**：`55 55 A5 02 01 01 0D`；
5. **高字节饱和**：频率 300Hz → 整数 255，小数 0。

想一想：如果协议没有帧尾、也没有长度，只靠 `0x55` 找帧，会出什么问题？

---

## 6. Level 5：上板验证

### 6.1 抓 hex

把串口助手切到 **HEX 显示**，确认收到：

```text
55 A5 02 01 01 0D
```

对应 165.2Hz、振动、接触、0x0D。

### 6.2 改 5 字节

把 `config.h` 改成：

```c
#define COMP_FRAME_TRAILER_EN 0
```

重新编译、烧录，确认收到 `55 A5 02 01 01`，并且主机测试仍是 22/22。

### 6.3 量波特率

用逻辑分析仪或示波器抓一个字节：

- 9600 下 1 bit ≈ **104.17µs**；
- 一个字节 10 bit ≈ **1.04ms**；
- 如果量到 52µs，说明实际是 19200，不是 9600。

### 6.4 故意制造故障

每次只改一个变量，记录现象：

| 改动 | 预期现象 |
|---|---|
| 波特率改成 115200，接收端仍 9600 | 全是乱码 |
| TX/RX 接反 | 完全收不到 |
| 不共地 | 偶发乱码或完全不通 |
| 把 `write` 改成 `print` | 遇到 `0x00` 截断，帧不完整 |
| 多加 `println` | 每帧后面多 `0D 0A`，解析错位 |

---

## 7. 自测清单

做完后，不看答案回答：

- [ ] 能说出 9600 8N1 每字节 1.04ms 是怎么来的；
- [ ] 能手算 165.2Hz → `A5 02`；
- [ ] 能解释为什么不能用 `print` 发二进制；
- [ ] 能写出带缓冲的解析器，并处理半帧；
- [ ] 能解释 85Hz 为什么会和帧头 `0x55` 撞车；
- [ ] 能说出帧尾/长度/校验各自解决什么问题；
- [ ] 能在串口助手里用 HEX 模式核对一帧；
- [ ] 能独立把协议从 6 字节改成 5 字节，并同步改测试。

全部打勾，再去看 `串口练习_答案.md`。

---

## 8. 延伸：如果让你设计下一版协议

在 `0x55 | fi | fd | vib | ct` 的基础上，加一个字节的 XOR 校验：

```text
0x55 | fi | fd | vib | ct | XOR | 0x0D
```

要求：

1. XOR 覆盖 `0x55` 到 `ct`；
2. 解析器校验失败时丢弃并重新同步；
3. 更新主机测试；
4. 想一想：加了校验后，帧尾还有必要吗？各解决什么问题？
