wmsz88/flex-vib-monitor/串口练习_答案.md

# 串口练习参考答案

> 对应练习：`串口练习.md`
> 建议先做完，再对照这里。

---

## 1. 热身题

**1.1** 8N1 一个字节 = 1 起始位 + 8 数据位 + 1 停止位 = 10 bit。
`10 / 9600 = 1.0417ms`，约 **1.04ms**。

**1.2** 6 字节 = 60 bit，`60 / 9600 = 6.25ms`。

**1.3** `6.25ms / 20ms = 31.25%`。
50Hz 发 6 字节在 9600 下完全来得及。

**1.4**

- `Serial1.print(buf)`：按文本发送，遇到 `'\0'` 会停；`0x00` 还会被当成字符串结束。
- `Serial1.println("OK")`：会自动追加 `\r\n`，打乱定长帧。

二进制协议必须用 `write(ptr, len)`。

**1.5** 不是一回事。

- 8N1 的停止位是 UART 电气层每个字节后面的 1 bit；
- 帧尾 `0x0D` 是协议层的一个数据字节，用来帮助接收端判断一帧结束。

---

## 2. Level 1 答案

| # | 频率 | 启停 | 接触 | 期望帧 |
|---|---|---:|---:|---|
| 1 | 165.2Hz | 1 | 1 | `55 A5 02 01 01 0D` |
| 2 | 80.0Hz | 1 | 0 | `55 50 00 01 00 0D` |
| 3 | 179.9Hz | 1 | 1 | `55 B3 09 01 01 0D` |
| 4 | 无效 | 0 | 0 | `55 00 00 00 00 0D` |
| 5 | 99.99Hz | 1 | 0 | `55 64 00 01 00 0D` |
| 6 | 165.26Hz | 1 | 1 | `55 A5 03 01 01 0D` |
| 7 | 300.0Hz | 1 | 0 | `55 FF 00 01 00 0D` |

几个换算：

- `165 = 0xA5`，`179 = 0xB3`，`80 = 0x50`，`100 = 0x64`，`255 = 0xFF`；
- `99.99 × 10 = 999.9 → +0.5 → 1000.4 → 1000 → 100, 0`；
- `165.26 × 10 = 1652.6 → +0.5 → 1653.1 → 1653 → 165, 3`；
- 300Hz 整数部分超过 255，饱和成 `0xFF`。

**5 字节版第 1 组**：`55 A5 02 01 01`。

---

## 3. Level 2 参考实现

```python
import math

HEADER = 0x55
TRAILER = 0x0D

def encode_frame(freq, vib, contact, trailer=True):
    fi = 0
    fd = 0

    if freq is not None:
        try:
            f = float(freq)
        except (TypeError, ValueError):
            f = float("nan")

        if math.isfinite(f) and f > 0.0:
            fq = int(f * 10.0 + 0.5)   # 0.1Hz，四舍五入
            fi, fd = divmod(fq, 10)
            if fi > 255:
                fi = 255

    out = bytes([
        HEADER,
        fi,
        fd,
        1 if vib else 0,
        1 if contact else 0,
    ])
    if trailer:
        out += bytes([TRAILER])
    return out
```

为什么不用 `round()`：

```python
round(1652.5)   # 1652，Python 是银行家舍入
int(1652.5 + 0.5)  # 1653，符合我们的预期
```

---

## 4. Level 3 参考实现

```python
class FrameParser:
    def __init__(self):
        self._buf = bytearray()

    def feed(self, data):
        self._buf.extend(data)
        out = []

        while True:
            i = self._buf.find(HEADER)
            if i < 0:
                # 没有帧头，全是垃圾，丢掉
                self._buf.clear()
                break
            if i > 0:
                del self._buf[:i]

            # 帧不完整，保留到下次
            if len(self._buf) < 6:
                break

            # 帧尾不对：丢掉这个 0x55，继续向后找
            if self._buf[5] != TRAILER:
                del self._buf[0]
                continue

            fi = self._buf[1]
            fd = self._buf[2]
            vib = self._buf[3]
            contact = self._buf[4]

            freq = None if (fi == 0 and fd == 0) else fi + fd / 10.0
            out.append({
                "freq": freq,
                "vib": vib,
                "contact": contact,
            })
            del self._buf[:6]

        return out
```

### 为什么 85Hz 不会解析错

85.0Hz 的帧是：

```text
55 55 00 01 00 0D
│  └─ 85，正好等于帧头
└─ 帧头
```

解析器不是“见到 0x55 就切一帧”，而是：

1. 从 0x55 开始取固定 6 字节；
2. 检查第 6 个字节是不是 `0x0D`；
3. 不是就丢掉当前字节，从下一个位置重新找。

所以第二个 `0x55` 在“帧内”时不会被误判。

### 为什么坏帧尾能恢复

```text
55 A5 02 01 01 00   55 A5 02 01 01 0D
└──── 坏帧 ────┘   └──── 好帧 ────┘
```

第一个 0x55 取 6 字节，帧尾 `00 != 0D`，丢掉它；
继续找下一个 0x55，正好是好帧的帧头。

---

## 5. Level 4 讨论

**如果只有 0x55 帧头，没有长度、帧尾、校验会怎样？**

- 数据里出现 `0x55` 就会被当帧头；
- 接收端无法知道一帧到哪里结束；
- 丢一个字节后可能永久错位；
- 只能靠“等一段时间没有新字节”来猜帧尾，不可靠。

所以至少要三选二：

| 手段 | 解决 |
|---|---|
| 固定长度 | 知道一帧取多少字节 |
| 帧尾 | 知道一帧在哪里结束 |
| 校验/CRC | 知道这帧是不是完整的 |

我们的 0x55 帧是“固定长度 + 帧尾”。再加 XOR 就更稳。

---

## 6. 扩展：加 XOR

```python
def encode_xor(freq, vib, contact):
    body = encode_frame(freq, vib, contact, trailer=False)  # 5 字节
    chk = 0
    for b in body:
        chk ^= b
    return body + bytes([chk, TRAILER])
```

解析时：

```python
if len(self._buf) < 7:
    break
if self._buf[6] != TRAILER:
    del self._buf[0]
    continue
chk = 0
for b in self._buf[:5]:
    chk ^= b
if chk != self._buf[5]:
    del self._buf[0]
    continue
```

帧尾和校验各解决不同问题：

- 帧尾：快速判断“这里是不是一帧的结束”；
- XOR：判断“这 5 个字节有没有被改坏”。

两者不能互相替代。

---

## 7. 上板核对

165.2Hz、振动、接触：

```text
55 A5 02 01 01 0D
```

5 字节版：

```text
55 A5 02 01 01
```

9600 下：

- 1 bit ≈ 104.17µs
- 1 字节 ≈ 1.04ms
- 6 字节 ≈ 6.25ms

如果串口助手文本模式看到乱码，先切 HEX；HEX 对得上，协议就对了。

---

## 8. 自测结果

参考实现跑 `tools/serial_drill.py`：

```text
serial_drill: 19 pass / 0 fail
```

如果你也是 19/19，说明编码、拆帧、缓冲、重同步都掌握了。
