wmsz88/flex-vib-monitor/背景与题目.md

# 背景与题目

> 赛项：2026 年广东省工科大学生实验综合技能竞赛 · 赛项一
> 题目：柔性振动检测模块的设计及制作
> 本文根据组委会命题与评分标准整理，原文见 `资料/00_命题/`。

---

## 一、赛项背景

机器人末端执行器正在从「刚性抓取」走向「柔性感知」。在精密抓取、易损物品、
复杂表面和动态交互场景里，仿生手不仅要夹得住，还要知道：

- 有没有接触目标物体；
- 接触是否稳定；
- 目标物体有没有在振动、振动频率是多少。

仿生手表面是弧面，传统刚性 PCB 很难稳定贴合，振动信号也容易衰减。
所以题目要求用**柔性 PCB（PI 基底）**贴合弧形单指结构，把 MPU6050
采集到的振动信号交给 ESP32-C3 处理，再通过串口实时输出给测试平台。

仿生手单指宽度约 **13mm**。

---

## 二、竞赛任务

赛项分三个环节：

| 环节 | 内容 |
|---|---|
| 第一环节 | 柔性 PCB 设计（赛前校内完成，按设计结果评分） |
| 第二环节 | 现场创新实践：焊接、组装、程序开发与调试，并提交方案文档 |
| 第三环节 | 现场考核：作品与测试装置连接，完成测评 |

总成绩 = 三个环节得分之和。

现场提供的物料包用于组装、结构集成和程序调试；参赛队需自备电脑、
PCB 设计软件、烧录工具（CH340 / USB Type-C）、可调温电烙铁（最低可设 180℃）、
12V 直流电源、少量杜邦线等。

---

## 三、功能指标

检测模块要完成三件事：

1. **接触状态识别**：判断仿生手是否接触目标物体；
2. **持续振动频率检测**：范围 **80Hz ~ 180Hz**；
3. **启停频率检测**：范围 **0 ~ 3Hz**
   （某一固定频率振动状态与无振动状态组成的周期频率）。

处理结果通过串口实时输出给外部测试平台。

---

## 四、硬件要求

### 4.1 核心器件

- 单片机：**ESP32-C3**（组委会提供的 SUPER MINI 模块）；
- 传感器：**MPU6050**（三轴加速度 + 三轴陀螺）；
- ESP32-C3 通过 **I2C** 连接 MPU6050，实时读取加速度信息；
- 数据处理与频率解析在单片机上完成。

### 4.2 电源

- 输入 **12V**，稳压到 **5V** 给单片机和传感器供电；
- 稳压芯片：**AMS1117-ADJ**（SOT-223）；
- **红色 LED 常亮**表示稳压输出正常（硬件直连，软件不可控）；
- **绿色 LED** 由单片机控制闪烁，表示电路正常运行；
- **黄色 LED** 预留，可控制亮灭；
- 电源总开关串在 **12V→5V 稳压电路前端**；
  开关断开时模块必须完全断电，**不得有静态功耗**。

### 4.3 结构与柔性

- 柔性 PCB，PI 基底，单面板或双面板；
- 最大外形 **100mm × 25mm**；
- 官方外框实测总长 **90mm**：左段 55mm（高 22.3mm）+ 右段 35mm（高 12.6mm）；
- 右段起始处有 **15.2mm 强制弯曲避让区**，区内严禁放器件，只允许走线与过孔；
- PCB 必须能完整贴合标准弧形仿生手单指结构。

### 4.4 4pin 接口

- 4 个开窗焊盘，每个开窗尺寸 **> 4mm × 2mm**；
- 焊 4 根 30cm 公头杜邦线；
- 线序以命题图 3 为准：

| 引脚 | 信号 |
|---|---|
| ① | TX |
| ② | RX |
| ③ | GND |
| ④ | VIN（12V） |

本项目网表：`U4.1=TX / U4.2=RX / U4.3=GND / U4.4=VIN`，与命题一致。

---

## 五、物料与资格规则

- 作品必须**全部使用组委会发放的物料**；
- 使用清单外物料 → **取消比赛资格**；
- 器件数量不得超过物料清单规定数量；
- 柔性 PCB 不能正常工作，或放弃使用自己设计的板子，可改用组委会标准板，
  但**扣除总分的 50%**；
- PCB 设计未按时提交、文件不全或命名含学校/个人信息 → 不予制板，不能参加后续比赛。

物料清单见 `资料/02_硬件设计/物料清单.xlsx`。

---

## 六、评分构成

| 部分 | 分值 | 说明 |
|---|---:|---|
| 柔性振动检测模块 PCB 设计 | 40 | 扣分制，扣完为止 |
| 制作及测试 | 60 | 评分标准现场发布 |

PCB 设计的主要扣分点：

- 文件命名/存放不规范，每类扣 1 分；
- 四类文件（原理图源文件、原理图 PDF、PCB 源文件、Gerber）缺一类扣 1 分；
- 文件里出现个人信息、学校信息、特殊标记，扣 10 分；
- 器件标号/参数/网络标号错误，或用了清单外器件，扣 1~6 分；
- 电源、单片机外围、传感器外围、指示灯电路不符合命题，每处扣 2~4 分；
- 板框不闭合、超尺寸、无布线、铺铜、Gerber 不可读等，扣 10 分；
- 线宽/线距/孔径/禁布区违规，按处扣分。

---

## 七、我们的实现

### 7.1 数据流

```text
MPU6050（I2C，1kHz）
  → sampler（环形缓冲、缺口检测）
  → dsp（去零偏 → 70Hz 高通 → 过零测频 / RMS 包络 / 启停状态机）
  → posture（START 姿态基线、开合角）
  → state（接触状态机）
  → output（比赛串口帧 + 调试串口 + LED）
```

### 7.2 关键设计

- 1kHz 定时采样，样本带序号与时间戳；
- 70Hz 二阶高通，覆盖 80~180Hz 命题频段；
- 过零 + 线性插值 + 周期中位数测主频；
- RMS 包络 + 双阈值滞回测启停；
- 陀螺积分测闭合角，加速度负责「认零位」；
- 接触三条（v6 起）：收拢并停 + 振动证据 → 接触；
  保持只看陀螺；张开或再转 10° → 分离；
- 参数全部集中在 `config.h`，编译期检查。

### 7.3 版本

| 版本 | 定位 |
|---|---|
| v1 | 单文件跑通 |
| v2 | 模块化重构 |
| v3 | 烧录版 |
| v4 | 平放基准 + 三重与 |
| v5 | 陀螺测闭合角 |
| v6 | 接触三条，出发版 |
| v7 | 现场输出适配 |
| v8 | 分层检测实验 |
| v9 | 平放基准时机实验 |

每一版的改动与遗留问题见 `版本沿革_v1-v9.md`。

### 7.4 串口协议

现场平台最终要求 **9600 8N1**，二进制定长帧：

```
0x55 | 振动整数 | 振动小数 | 启停 | 接触 | 停止位(0x0D)
```

赛后已将 v6 的 `compBuildFrame()` 改为该格式。
如果平台按 UART 的 1 位停止位理解（帧只有 5 字节），
把 `config.h` 的 `COMP_FRAME_TRAILER_EN` 改成 `0`。

---

## 八、决赛结果

2026-11-08 决赛中，模块链路正常、9600 波特率正确，但发出的仍是自定的
`$VD` ASCII 帧，平台只认 `0x55` 二进制帧，因此串口判为未通信。

抓包证据、时间线与教训见 `vibmon_v6/复盘_20261108_串口失分.md`。

一句话总结：**链路通不等于协议通，平台实机抓 hex 才算验证。**

---

## 九、资料索引

- 命题原文：`资料/00_命题/`
- 评分与规则：`资料/01_规则与评分/`
- 硬件与引脚：`资料/02_硬件设计/`
- 软件说明与版本讲解：`资料/03_软件与方案/`
- 总索引：`资料/README.md`

> 官方命题、评分标准、通知等文件版权归竞赛组委会所有，本仓库仅作学习与复盘归档。
