wmsz88/flex-vib-monitor/版本沿革_v1-v9.md

# 版本沿革：v1 → v9

> 项目：2026 广东省工科赛 · 赛项一「柔性振动检测模块」
> 硬件：ESP32-C3 + MPU6050
> 整理日期：2026-11-08

一句话主线：

**v1 单文件跑通 → v2 拆模块修缺陷 → v3 压缩成烧录版 → v4 换平放基准判据
→ v5 上陀螺测闭合角 → v6 定接触三条 → v7 做现场输出适配 → v8/v9 两条实验线。**

---

## 一、总览

| 版本 | 代码目录 | 时间 | 定位 | 一句话改动 | 结果 |
|---|---|---|---|---|---|
| v1.0 | `zlj/sketch_oct12a/` | 2026-10-12 | 单文件初版 | 1kHz 采样 + 高通 + 过零测频 + RMS 包络 + `$VD` 帧 | 跑通 |
| v1.1 | `vibmon/` | 2026-10-12 | 评审修正版 | M1~M9 九条修正，加调试总开关 | 稳定 |
| v2 | `vibmon_v2/` | 2026-10-12 | 模块化重构 | 拆成 mpu/sampler/dsp/state/output，修 12 类缺陷 | 可维护 |
| v3 | `vibmon_v3/` | 2026-10-19 | 烧录版 | 只做减法：删测试与 motor_test，算法不动 | 上板 |
| v4 | `vibmon_v4/` | 2026-10-29 | 判据换代 | 接触改用「平放基准 + 三重与」（`CT_MODE=3`） | 上板 |
| v5 | `vibmon_v5/` | 2026-10-30 | 陀螺版 | 陀螺积分测闭合角（`CT_MODE=4`），加 35 字节 `$VD` 帧 | 冻结基线 |
| v6 | `vibmon_v6/` | 2026-11-06 | 出发版 | 接触三条：收拢并停 + 振动证据；保持只看陀螺 | T013 验收 |
| v7 | `vibmon_v7/` | 2026-11-06 | 现场适配版 | 黄灯联动 + `y` 命令 + 三只预案宏 + 7 个变体 | 实板 7 条全过 |
| v8 | `vibmon_v8/` | 2026-11-07 | 分层检测实验 | 新增 `layered_detection` 与 `#LAYER` 行 | 未上板 |
| v9 | `vibmon_v9/` | 2026-11-08 | 基准时机实验 | 平放基准重采必须「真张开」 | 未上板 |

关系图：

```text
v1.0 ──→ v1.1 ──→ v2 ──→ v3 ──→ v4 ──→ v5 ──→ v6 ──┬──→ v7（输出适配）
                                                      ├──→ v8（分层检测）
                                                      └──→ v9（基准时机）
```

v7 / v8 / v9 都从 v6 拷贝，判据链保持可一键回退到 v6。

---

## 二、v1：单文件跑通

### v1.0（2026-10-12）

代码：`zlj/sketch_oct12a/sketch_oct12a.ino`

第一版把所有东西写在一个 `.ino` 里：

- `esp_timer` 1kHz 定时读 MPU6050，环形缓冲 512 点；
- 去直流 + 二阶高通（70Hz）保住 80~180Hz 命题频段；
- 每 64 点做滞回过零 + 线性插值 + 周期中位数，得到主频；
- RMS 包络 100Hz，双阈值滞回判振动启停；
- 启停频率用边沿周期统计；
- 50Hz 组 `$VD` ASCII 帧，115200 8N1 从 GPIO21 发出。

这一版证明了整条链路能跑：采样、滤波、测频、启停、串口输出。

### v1.1（2026-10-12）

按评审意见做了 9 条修正（代码头注释 M1~M9）：

| 编号 | 修正 |
|---|---|
| M1 | 补 `stdarg.h` / `stdio.h`，不再依赖 Arduino 隐式包含 |
| M2 | 新增 `SERIAL_VERBOSE` 总开关：关闭时比赛口只发 `$VD`，横幅/帮助/调试全静默 |
| M3 | 调试行默认关闭，现场按 `d` 打开 |
| M4 | 传感器故障改成「绿灯灭 + 黄灯 2Hz 快闪」，避免误判为正常运行 |
| M5 | 标定忙等里定期 `delay(1)`，喂空闲任务狗 |
| M6 | 启停统计窗 4s→8s，边沿缓存 16→32，下限 0.5Hz→0.25Hz |
| M7 | 去掉 UART 引脚上的 `pinMode`，避免与 UART 驱动抢引脚 |
| M8 | 帧格式加 `FRAME_WITH_CONTACT` 开关，默认与 v1.0 一致 |
| M9 | 状态行补协议开关与接触门限，方便现场排障 |

**遗留**：单文件难维护；接触判据只是「减零偏后的模长 EMA」，振动本身会把模长抬高。

---

## 三、v2：模块化重构

时间：2026-10-12（10-18 又同步过一版开发改动）
目录：`vibmon_v2/`（历史提交 `dc2d2c6` 的完整版，含主机测试与 `motor_test`）

核心算法与 v1.1 相同，重点是拆模块、补工程性缺陷：

```text
config.h   参数与编译期检查
mpu.*      MPU6050 驱动、寄存器回读、I2C 错误计数
sampler.*  1kHz 采样、序号/时间戳、环形缓冲、缺口检测
dsp.*      标定、去零偏、高通、RMS 包络、主频估计
state.*    启停、启停频率、接触状态、有效性
output.*   绘图行、调试行、LED、串口命令
```

相对 v1.1 修的 12 类问题，主要的几条：

- RMS 缓冲没清空，重标定后累计和会错位甚至开方出 NaN；
- MPU 初始化写入不检查返回值，现在逐项回读比对；
- 样本没有时间信息，现在带节拍序号与 `micros()`，断流可检测；
- 丢样后仍按等间隔算主频，现在不连续就清窗重攒；
- 启停频率原来用 8s 窗边沿数/时间，一次误触发就拉偏；改成相邻起沿周期取中位数、至少 2 个周期、1.5 倍稳定性检查；
- 主频旧值不清零，现在停振立即清零、300ms 未更新也清零；
- 运行中 I2C 断线一直发旧值，现在连续 20 次失败或 100ms 无新样本进入故障并自动重连；
- 接触判据加低通、滞回与 100ms 确认；
- 标定增加质量检查（标准差、零偏模长）；
- 统计削顶样本；
- 定时器回调去掉 `IRAM_ATTR`，改用 `ESP_TIMER_TASK`。

**遗留**：接触判据仍是「姿态距离」，振动与姿态耦合，空握/握物容易混。

---

## 四、v3：烧录版

时间：2026-10-19
目录：`vibmon_v3/`

这一版只做减法，不改算法：

- 删除 `test/` 主机测试与桩文件；
- 删除同板驱动马达的临时模块 `motor_test.*`；
- 清理 `.ino` / `output.cpp` 里对它们的引用与命令分支。

接触判据此时定为 **`CT_MODE=2`：到接触姿态的距离**。

**定位**：能烧、能演示的干净版本；算法与 v2 最后一版完全一致。

---

## 五、v4：平放基准 + 三重与

时间：2026-10-29
目录：`vibmon_v4/`

核心改动是 Q4 接触判据：从「到接触姿态的距离」换成
**`CT_MODE=3`：平放基准 + 姿态、幅值、频率三重与**。

- 上电平放静置，自动采一次平放基准（免现场按键）；
- 姿态回到基准附近，且幅值、主频同时过门限，才算接触；
- 三路都带滞回，避免边界抖动；
- 增加「夹住但没振动」与「有振动但没夹住」的区分能力；
- 同时修了数据无效时保持门不清零的问题，`STRICT=1` 成为默认。

**遗留**：平放基准用的是加速度姿态距离 `flatDist(D)`，分辨力不够，
夹持角度变化小时区分不开「张开」和「闭合」。

---

## 六、v5：陀螺测闭合角

时间：2026-10-30 ~ 10-31
目录：`vibmon_v5/`

这一版把接触判据升级为 **`CT_MODE=4`**：

- 新增陀螺仪支路：250Hz 读取（`GYRO_DIV=4`），积分得到闭合角度；
- 加速度继续负责「认零位」（`D` 小 = 已回到张开），陀螺负责「量转了多少度」；
- 闭合角 60° 进入、45° 退出；
- 幅值 400/300mg、主频 75/63Hz 作为振动证据；
- 每轮闭合后可自动重采平放基准；
- 新增 `posture.*` 静态姿态诊断（只诊断，不参与 contact）；
- 补上 35 字节 `$VD` 比赛帧与 `comp_frame_test`；
- T011 加启停保持门，`SS_HI/LO` 调整到 120/80mg。

实板结果：单轮接触/启停通过；5 轮重复性被 MPU6050 I2C 间歇掉线挡住。
2026-10-31 冻结为回退基线。

**遗留**：关掉振源后，只要手不动，接触仍会保持一段时间；
需要明确「保持」和「分离」的语义。

---

## 七、v6：接触三条（出发版）

时间：2026-11-06
目录：`vibmon_v6/`

从 v5 拷贝，只改接触逻辑：

1. **进入**：手指收拢 **并且已经停下**（4Hz 低通后 <10dps 持续 150ms）
   并且有振动证据（幅值+频率，或启停 ≥1.5Hz）；
2. **保持**：不再看加速度，只看陀螺——振源关掉但手不动，接触保持；
3. **分离**：陀螺判出张开，或进入后又净转过 10°（500ms 泄漏积分，来回摆会抵消）。

同时：

- 启停门 `SS_HI/LO` 从 180/150 降到 120/80；
- 收拢后第一次停住清启停历史；
- 接触中启停频率取最新一致段。

T013 实板验收：

- 松手 20~396ms 退出接触；
- 关振源但手握着，接触保持 16.4s 不退（有意设计）；
- 旧振子 2Hz 接触 100% 不掉；空握 0 误进；
- `$VD` 帧 35 字节、CHK 全对。

**v6 被定为出发固件，后续 v7/v8/v9 都从它拷贝。**

---

## 八、v7：现场输出适配

时间：2026-11-06
目录：`vibmon_v7/`

判据链（`state/dsp/posture/sampler/mpu`）与 v6 逐字节相同，只动输出侧：

- 黄灯从「振动中常亮」改成接触联动：CT=1 时 2Hz 闪；
- 新增 `y` 命令三态：AUTO → ON → OFF；
- 三只现场预案宏，默认全关：

| 宏 | 默认 | 作用 |
|---|---|---|
| `COMP_FRAME_CSV` | 0 | 改发 CSV 文本行 |
| `COMP_FRAME_DIV` | 1 | 2 = 25Hz，5 = 10Hz |
| `COMP_FRAME_GATED` | 0 | 收 `S` 开始发，`X` 停止 |

- 预编译 7 个变体：def / cl / csv / div2 / gate / v5sem / uart。

实板 7 条验收全过：黄灯闪/灭/闪、`$VD` 506 帧全 35 字节、CHK 全对。

**注意**：这一版仍然沿用 `$VD` ASCII 帧，现场平台最终要的是 `0x55` 二进制帧，
这个口径差异就是决赛失分的原因，详见 `vibmon_v6/复盘_20261108_串口失分.md`。

---

## 九、v8：分层检测实验

时间：2026-11-07
目录：`vibmon_v8/`

从 v6 拷贝，T014 实验线，新增 `layered_detection.h/.cpp`：

- 实时层：滞回 + 3 点确认，输出分层振动/接触标志；
- 均匀层：50 点滑窗中位数、P90-P10 离散度、有效率、`stable` 判据；
- `state.cpp` 每个包络点 `layerPush()` 旁挂喂数，不改判据；
- `output.cpp` 调试行加 `#LAYER`；
- `LAYERED_DETECT_ENABLE=0` 可完整回 v6（`v6_fallback` 89/89 证明）。

为保持实验静默，`COMP_FRAME_ENABLED=0`，不参加比赛输出。

宿主测试：contact 89/89、gyro 8/8、comp_frame 22/22、layered 8/8。
**未实板验证。**

---

## 十、v9：平放基准时机实验

时间：2026-11-08
目录：`vibmon_v9/`

从 v6 拷贝，删掉 v8 的分层件，只做基准时机：

- 新宏 `CT_REF_REOPEN_ONLY=1`：自动重采平放基准除了原来的三条件
  （静止 ≥2s、幅值 <100mg、角度 <8°），还要求角度确实回到张开区；
- 防的坑：手一直握着只关振源时，角度仍在闭合区，旧逻辑会把握持姿态
  当平放零点，下一轮接触判据全歪；
- 预留 `FLAT_REF_REZERO_ON_CLOSE=0`（默认禁止闭合时重采）；
- 新增宿主用例 R1（握着关源基准保持）/ R2（真张开+静止才重采）。

测试：contact 92/92、gyro 8/8、comp_frame 22/22、dump 15/19（既有）、ss_replay 可运行。
**未实板验证。**

计划中的「频率自适应幅值门」（80~180Hz 线性 250→300mg）没有落到 v9，
只留了 `CT_AMP_F_ENABLE` 宏。

---

## 十一、接触判据的四代演进

| 代 | 版本 | 判据 | 解决的问题 | 留下的问题 |
|---|---|---|---|---|
| 1 | v1 | 减零偏模长 EMA | 能判断「有没有压住」 | 振动会把模长抬高 |
| 2 | v2/v3 | 到接触姿态的距离 + 滞回 | 降低振动耦合，边界不抖 | 分辨力不足 |
| 3 | v4 | 平放基准 + 姿态/幅值/频率三重与 | 能区分空握与握物 | 加速度姿态距离分辨力仍不够 |
| 4 | v5 | 陀螺积分闭合角 + 幅值/频率 | 角度可量化，张开/闭合可分 | 关源手不动会一直保持 |
| 5 | v6 | 进入要「收拢并停」，保持只看陀螺，张开或转 10° 才分离 | 语义明确，误进/误退都低 | 需要上电时处于 START 姿态 |

关键教训：**模块上电/复位必须在张开（START）姿态**，
否则角度恒 0、闭合角失效，接触判据整体不可信。

---

## 十二、串口帧的演进

| 阶段 | 帧 | 说明 |
|---|---|---|
| v1 ~ v6 | `$VD,SEQ,FREQ,AMP,VIB,CT,SS,VALID,CHK\r\n` | 35 字节 ASCII，115200，XOR 校验 |
| v7 | 同上 + 3 只预案宏 | CSV / 分频 / 命令门控，均为自定格式 |
| 赛后 v6 | `0x55 / 振整数 / 振小数 / 启停 / 接触 / 0x0D` | 9600 8N1，现场平台口径 |

决赛失分的根因不是链路，而是**协议口径没有在赛前对齐**：
我们发的是自己设计的 `$VD`，平台只认 `0x55`。
这条教训已经写进复盘文档，也应该写进下一届的赛前检查表。

---

## 十三、每个版本留下的经验

| 版本 | 经验 |
|---|---|
| v1 | 先跑通整条链路，再谈优化 |
| v1.1 | 比赛口必须能一键静默，调试输出不能污染协议 |
| v2 | 时间戳、缺口检测、故障恢复要在第一版就补齐 |
| v3 | 烧录版要只做减法，避免「清理」顺手改算法 |
| v4 | 判据要能区分「没夹住」和「夹住但没振动」 |
| v5 | 加速度认零位、陀螺量角度，两个传感器各干各的活 |
| v6 | 接触语义要写清楚：进入、保持、分离三件事分开定义 |
| v7 | 现场预案要预编译好，不能现场改代码 |
| v8 | 实验版要能一键回退，且默认静默 |
| v9 | 基准重采的时机比阈值更关键 |

---

## 附：目录说明

- `zlj/sketch_oct12a/`：v1.0 单文件版
- `vibmon/`：v1.1 单文件评审修正版
- `vibmon_v2/`：v2 模块化重构完整版（含主机测试与 `motor_test`）
- `vibmon_v3/` ~ `vibmon_v9/`：各版本源码
- `vibmon_v10/`：现场临时拷贝目录，不属于正式版本线
