wmsz88/flex-vib-monitor/串口帧协议草案.md

# 串口比赛帧协议（v5 · 35 字节定长帧）

> 对应固件：`代码\vibmon_v5\output.cpp` `compBuildFrame()`
> 主机测试：`vibmon_v5\test\comp_frame_test.cpp` 22/22 通过
> 制定日期：2026-09-28 ｜ 更新日期：2026-10-31
> 状态：**待与组委会测试平台核对帧头/字段集后定稿**

---

## 一、物理层

| 项目 | 取值 | 说明 |
|---|---|---|
| 电平 | TTL（3.3V） | 4pin 开窗焊盘 + 杜邦线（30cm 公头） |
| 波特率 | **115200** | `config.h` `COMP_BAUD`，现场可改 |
| 数据格式 | **8N1** | |
| 引脚 | 本板 TX = **GPIO21**（4pin ①）；本板 RX = **GPIO20**（4pin ②）；③GND ④VIN(12V) | 命题图3 已确认 |
| 流控 | 无 | |

**接线**：平台 RX ← 本板①TX ；平台 TX → 本板②RX ；③GND 共地 。

---

## 二、帧格式

```
$VD,SEQ,FREQx10,AMP_MG,VIB,CT,SSx100,VALID,CHK\r\n
```

定长 **35 字节**（正文 30 + `,` + 2 位校验 + `\r\n`）。

| 字段 | 宽度 | 含义 | 标度与取值 |
|---|---|---|---|
| `$VD` | 3 | 帧头，固定 | 恒 `"$VD"` |
| `SEQ` | 4 | 循环序号 | `0000`~`9999`，发满回绕 |
| `FREQx10` | 5 | **持续振动主频** | 主频 ×10，0.1Hz 分辨率；`00000` = 无效/无振动 |
| `AMP_MG` | 5 | 振动幅值 | 三轴合成交流 RMS 包络，单位 mg；`99999` = 饱和 |
| `VIB` | 1 | 振动状态 | `0` = 停 ；`1` = 振 |
| `CT` | 1 | 接触状态 | `0` = 未接触/不可信 ；`1` = 接触 |
| `SSx100` | 3 | **启停频率** | 启停频率 ×100，0.01Hz 分辨率；`000` = 未确立/超时 |
| `VALID` | 1 | 有效性位图（见下） | `0`~`F` 十六进制 |
| `CHK` | 2 | XOR 校验 | 2 位大写十六进制 |

### VALID 位图

| bit | 含义 | 置 1 条件 |
|---|---|---|
| bit0 | 幅值有效 | 采样连续、未超时 |
| bit1 | 主频有效 | 频率窗预热完毕且未削顶降级 |
| bit2 | 启停频率有效 | 已测到 ≥2 个完整周期 |
| bit3 | 接触判定可信 | 已记录姿态基准（模式 2/3） |

示例：`F` = 全部有效；`1` = 仅幅值有效；`0` = 全部无效。

### CHK 算法

`CHK` = 从 `$` 到 `VALID` 最后一位之间所有字符的逐字节异或，取 2 位大写十六进制。

```c
uint8_t xorChk(const char* s, int n) {
  uint8_t x = 0;
  for (int i = 0; i < n; i++) x ^= (uint8_t)s[i];
  return x;
}
// body = "$VD,0137,01652,00966,1,1,120,F"（长度 30），CHK = xorChk(body, 30)
```

### 校验过的示例帧

| 场景 | 完整帧 |
|---|---|
| 上电静止、全部无效 | `$VD,0000,00000,00000,0,0,000,0,1A` |
| 仅幅值有效（静压 500mg） | `$VD,002A,00000,00500,0,0,000,1,?` |
| 接触振动 165.2Hz / 966mg / 启停 1.20Hz | `$VD,0137,01652,00966,1,1,120,F,63` |
| 主频饱和 9999.9Hz / 幅值 123456mg | `$VD,0000,99999,99999,1,1,999,F,?` |

> 饱和策略：字段超上限时直接钳位到 `99999` / `999`，由 `VALID` 位图辅助判断可信度。

---

## 三、调试行（`#` 前缀）

调试口（USB CDC 或 GPIO20/21）输出的可读行，**以 `#` 开头**。

约定：平台解析时忽略所有以 `#` 开头的行。

主要调试行：

| 命令 | 输出 | 说明 |
|---|---|---|
| `S` | 多行状态文本 | 配置、阈值、统计 |
| `w` | 一行 `#SWEEP` | `F A D ang tr vib ct grip cl w cliplim ax ok` |
| `Q` | 一行 `#POST` | 姿态分类诊断帧 |
| `T` | 多行时序统计 | 采样/输出时序诊断 |

比赛口（GPIO21/20）**只发 `$VD` 帧，绝不发任何 `#` 调试行**。

---

## 四、与 v1/v2（31 字节帧）的差异

| 项目 | v1/v2 | v5 |
|---|---|---|
| 总长度 | 31 | **35** |
| `VIB` / `CT` | 合并为 1 位（CT 字段实际发振动状态） | 拆分为独立 2 字段 |
| `VALID` | 无 | 新增 1 位十六进制位图 |
| 主机测试 | 无 | `comp_frame_test.cpp` 22/22 |
| 比赛口默认 | 编译即发 | `COMP_FRAME_ENABLED=0` 静默（协议未定） |

**切换**：改 `config.h` 中 `COMP_FRAME_ENABLED` 为 `1` 即可启用帧输出。

---

## 五、现场对接时最可能被要求改的三处

| # | 可能的要求 | 改哪里 | 工作量 |
|---|---|---|---|
| 1 | 换波特率（9600 / 230400 …） | `config.h` `COMP_BAUD` | 1 行 |
| 2 | 换帧头（如 `$VIB`） | `output.cpp` `compBuildFrame()` 格式串 | 1 行 |
| 3 | 换字段集 / 字段顺序 / 二进制帧 | `compBuildFrame()` 整体 + 主机测试 | 约 30 行 |

---

## 六、待确认清单

1. 平台的**确切波特率**（暂定 115200）
2. 平台是否接受 `#` 开头的调试行
3. 平台期望的**帧头与字段集**是否需要调整
4. 是否要求固定帧率（当前 50Hz / 20ms）或事件驱动
5. `AMP_MG` 的物理定义是否需明确（当前为三轴合成 RMS 包络）
6. 是否需要固件侧发 ACK / 心跳 / 请求-响应模式

---

## 七、Python 解析脚本（参考）

```python
import serial

def xor_chk(s: str) -> int:
    x = 0
    for c in s.encode("ascii"):
        x ^= c
    return x

def parse(line: bytes):
    s = line.decode("ascii", "replace").strip()
    if not s.startswith("$VD,"):
        return None
    body, chk = s.rsplit(",", 1)
    if xor_chk(body) != int(chk, 16):
        return None
    _, seq, f10, amp, vib, ct, ss100, valid = body.split(",")
    return dict(seq=int(seq), freq_hz=int(f10)/10.0, amp_mg=int(amp),
                vib=int(vib), contact=int(ct), ss_hz=int(ss100)/100.0,
                valid=int(valid, 16))

if __name__ == "__main__":
    ser = serial.Serial("COM8", 115200, timeout=1)
    while True:
        d = parse(ser.readline())
        if d:
            print(d)
```
