wmsz88/flex-vib-monitor/MPU6050寄存器速查.md

# MPU6050 寄存器速查（本工程用到的全部寄存器）

> 来源：**InvenSense《MPU-6000 and MPU-6050 Register Map and Descriptions》Rev 3.2（文档号 RM-MPU-6000A-00）**
> 核对日期：2026-09-28　｜　核对方式：逐项对照官方原文（含 DLPF 表与采样率公式）
>
> 为什么要单独做这份表：`docs\hardware\07-pinout.md` 第 10 节已明确 —— 组委会发放的
> 《传感器模块.pdf》只是**产品规格书**（PS-MPU-6000A-00），里面**没有寄存器地址**，
> 开头就写着 "please refer to the MPU-6000/MPU-6050 Register Map and Register Descriptions"。
> 所以寄存器地址**不能凭记忆写**，也不能抄中文博客。写方案文档要引用时，先下载官方 RM 原文留档。

---

## 一、器件标识

| 项目 | 值 |
|---|---|
| 7 位 I2C 地址 | **0x68**（AD0 接 GND）／ 0x69（AD0 接 VDD） |
| 8 位写地址 / 读地址 | 0xD0 / 0xD1 |
| I2C 速率 | 最高 **400kHz**（Fast Mode） |
| 本设计 AD0 | 接地 ⇒ **0x68**（定稿网表 `GND ; ... U3.5`） |

---

## 二、本工程用到的寄存器

| 地址 | 名称 | 位域 | 本工程写入值 | 含义 |
|---|---|---|---|---|
| **0x19** | `SMPLRT_DIV` | [7:0] | **`0x00`** | 采样率分频。见第三节公式 |
| **0x1A** | `CONFIG` | [2:0] `DLPF_CFG` | **`0x00`** | 数字低通滤波。见第四节 DLPF 表 |
| | | [5:3] `EXT_SYNC_SET` | `000` | FSYNC 输入关闭（本设计 FSYNC 未引出） |
| **0x1B** | `GYRO_CONFIG` | [4:3] `FS_SEL` | **`0x00`** | 陀螺仪量程 ±250 dps（131 LSB/(°/s)）。本程序不用陀螺仪，保持默认 |
| **0x1C** | `ACCEL_CONFIG` | [4:3] `AFS_SEL` | **`0x00`** | 加速度量程 ±2g（**16384 LSB/g**）。振动幅度小，用最细档 |
| **0x3B** | `ACCEL_XOUT_H` | — | 只读 | 突发读起点。0x3B~0x40 = X/Y/Z 各 2 字节，**大端**，二进制补码 |
| **0x41** | `TEMP_OUT_H` | — | 只读 | 0x41~0x42，温度；`T(°C) = raw/340 + 36.53`（自检程序用） |
| **0x43** | `GYRO_XOUT_H` | — | 只读 | 0x43~0x48；本程序不读（省 I2C 时间） |
| **0x6B** | `PWR_MGMT_1` | [6] `SLEEP` | **`0x00`** | 必须清 0 才退出睡眠（**上电默认是睡眠**，这是最常见的"读不到数"原因） |
| | | [2:0] `CLKSEL` | `0` | 内部 8MHz 振荡器（模块无外部晶振，只能选它） |
| | | [7] `DEVICE_RESET` | 先写 `0x80` | 软复位，自清零；等 100ms 再配置更可靠 |
| **0x75** | `WHO_AM_I` | [6:1] | 只读 | **MPU-6050 返回 `0x68`**。调 I2C 第一步就读它 |

### 关键地址一览（供查错）

```c
#define REG_SMPLRT_DIV   0x19   // 采样率分频
#define REG_CONFIG       0x1A   // DLPF_CFG
#define REG_GYRO_CONFIG  0x1B   // 陀螺仪量程
#define REG_ACCEL_CONFIG 0x1C   // 加速度量程
#define REG_ACCEL_XOUT_H 0x3B   // 加速度数据起始
#define REG_TEMP_OUT_H   0x41
#define REG_GYRO_XOUT_H  0x43
#define REG_PWR_MGMT_1   0x6B   // 睡眠/时钟
#define REG_WHO_AM_I     0x75
```

---

## 三、采样率公式（官方原文）

```
Sample Rate = Gyroscope Output Rate / (1 + SMPLRT_DIV)

其中 Gyroscope Output Rate = 8 kHz  — 当 DLPF 关闭（DLPF_CFG = 0 或 7）
                          = 1 kHz  — 当 DLPF 打开（DLPF_CFG = 1~6）

★ 官方原文 Note：The accelerometer output rate is 1 kHz.
  （即加速度输出率恒为 1kHz，与 SMPLRT_DIV 无关；采样率高于 1kHz 时，
    同一个加速度样本会被重复送到 FIFO / 传感器寄存器）
```

**这句话是本工程采样方案成立的根本依据**：

- 我们写 `DLPF_CFG = 0` + `SMPLRT_DIV = 0` ⇒「采样率」= 8000 Hz，但加速度计每 1ms 才产生一个新样本；
- 我们的 MCU 定时器也按 **1kHz** 读 ⇒ **每次读到的都是新样本，不重不漏，也不会混叠**；
- 因此「1kHz 采样 + 只突发读 6 字节加速度」是自洽的，且 I2C 只花 0.42ms（@200kHz），余量 2.4×。

> 如果改 `DLPF_CFG = 1`：基准变成 1kHz，`SMPLRT_DIV = 0` ⇒ 采样率恰好 1000Hz，寄存器刷新率与读取率严格 1:1。
> 代价是加速度带宽从 260Hz 降到 184Hz（180Hz 处约 -3dB）。**测频率不受影响**（过零点位置不变），
> 但幅值读数偏小 —— 若现场发现 180Hz 附近幅值偏低，先怀疑这里。

---

## 四、DLPF 配置表（官方原文，加速度 Fs = 1kHz）

| `DLPF_CFG` | 加速度带宽 | 加速度延迟 | 陀螺仪带宽 | 陀螺仪延迟 | 陀螺仪 Fs | 本工程 |
|---|---|---|---|---|---|---|
| **0** | **260 Hz** | 0 ms | 256 Hz | 0.98 ms | 8 kHz | **采用**（保住 180Hz） |
| 1 | 184 Hz | 2.0 ms | 188 Hz | 1.9 ms | 1 kHz | 备选（压噪声，180Hz 约 -3dB） |
| 2 | 94 Hz | 3.0 ms | 98 Hz | 2.8 ms | 1 kHz | 不可用（会砍掉 180Hz） |
| 3 | 44 Hz | 4.9 ms | 42 Hz | 4.8 ms | 1 kHz | 不可用 |
| 4 | 21 Hz | 8.5 ms | 20 Hz | 8.3 ms | 1 kHz | 不可用 |
| 5 | 10 Hz | 13.8 ms | 10 Hz | 13.4 ms | 1 kHz | 不可用 |
| 6 | 5 Hz | 19.0 ms | 5 Hz | 18.6 ms | 1 kHz | 不可用 |
| 7 | RESERVED | — | RESERVED | — | 8 kHz | 禁用 |

**选型理由**：赛题上限 180Hz，只有 `DLPF_CFG = 0`（260Hz）和 `1`（184Hz）能保住。
选 `0` 是因为带宽余量更大（180Hz 处约 -0.7dB，而 `1` 约 -3dB），且延迟为 0。

---

## 五、量程与换算

### 加速度计 `ACCEL_CONFIG` [4:3] AFS_SEL

| AFS_SEL | 量程 | LSB/g | 换算 |
|---|---|---|---|
| **0** | **±2g** | **16384** | `mg = raw * 1000 / 16384` |
| 1 | ±4g | 8192 | `mg = raw * 1000 / 8192` |
| 2 | ±8g | 4096 | |
| 3 | ±16g | 2048 | |

为什么选 ±2g：振动引起的加速度变化通常只有几十~几百 mg，±2g 档分辨率最高（0.061 mg/LSB）。
副作用：猛击模块时可能饱和 —— 但赛题测的是稳态振动，饱和由协议的 `AMP_MG = 99999` 标出。

### 陀螺仪 `GYRO_CONFIG` [4:3] FS_SEL

| FS_SEL | 量程 | LSB/(°/s) |
|---|---|---|
| **0** | **±250** | **131** |
| 1 | ±500 | 65.5 |
| 2 | ±1000 | 32.8 |
| 3 | ±2000 | 16.4 |

### 温度

```
T(°C) = TEMP_OUT / 340 + 36.53      // TEMP_OUT 为 int16
```

---

## 六、突发读的字节顺序

从 `0x3B` 起突发读，寄存器地址自动递增，**大端（高字节在前）**：

| 偏移 | 寄存器 | 内容 |
|---|---|---|
| +0 / +1 | `ACCEL_XOUT_H` / `_L` | Accel X（int16） |
| +2 / +3 | `ACCEL_YOUT_H` / `_L` | Accel Y |
| +4 / +5 | `ACCEL_ZOUT_H` / `_L` | Accel Z |
| +6 / +7 | `TEMP_OUT_H` / `_L` | 温度 |
| +8 / +9 | `GYRO_XOUT_H` / `_L` | Gyro X |
| +10 / +11 | `GYRO_YOUT_H` / `_L` | Gyro Y |
| +12 / +13 | `GYRO_ZOUT_H` / `_L` | Gyro Z |

- **vibmon**（主程序）只读 **6 字节**（+0~+5），不看陀螺仪 —— 省一半 I2C 时间，为 1kHz 采样留余量。
- **selftest**（自检）读 **14 字节**，把六轴 + 温度全打出来，人眼判好坏。

---

## 七、本工程**不用**的东西（避免误用）

| 项目 | 为什么不用 |
|---|---|
| `INT_ENABLE`(0x38) / `INT_PIN_CFG`(0x37) / DRDY 中断 | **INT 脚在柔性板上悬空**（网表未接），拿不到中断；改用 MCU 定时器定速采样 |
| `FIFO_EN`(0x23) / `FIFO_R_W`(0x74) | 不用 FIFO —— 1kHz 定时读已足够，且 FIFO 读更复杂更难调 |
| DMP | **DMP 需要厂商固件镜像，组委会资料包里没有**，设计里不得依赖 |
| `USER_CTRL`(0x6A) 的 I2C master 模式 | 外接磁力计才用；本设计 AUX_CL/AUX_DA 悬空 |
| `PWR_MGMT_2`(0x6C) 低功耗周期唤醒 | 采样率太低，不够测 80~180Hz |

---

## 八、调 I2C 的排错顺序（照这个顺序查，别乱试）

1. `WHO_AM_I`(0x75) 读回 **0x68**？读 `0xFF` = 总线没通；读 `0x70/0x98/0x72` = 疑似克隆片或别的芯片。
2. 读回值恒为 `0x40`？说明 `PWR_MGMT_1` 写的 `SLEEP=0` 没生效 —— 芯片还在睡眠。
3. 全部读到 `0x00` 或固定值？总线被拉死，或地址错（AD0 悬空则为 0x69）。
4. 静态 Z 轴不是 ≈ +1000mg？量程没配对，或模块焊歪，或片子坏。
5. 通信偶发失败？降 I2C 速率（200k → 100k），查上拉是否存在、杜邦线是否过长。
6. **上电前必做**：万用表量 SDA/SCL 对 GND 的空闲电压，**必须 ≤ 3.3V**。
   命题表2 只写了模块「内置 5.1K 上拉」但没写拉到哪一档；若拉到模块 VCC(5V)，
   会超过 ESP32-C3 的 IO 绝对最大值 3.6V。若是 5V，把 MPU 模块 VCC 改接 ESP32 的 3V3 脚。
