wmsz88/flex-vib-monitor/资料/01_规则与评分/规则与要求整理.md

# 2026年广东省工科大学生实验综合技能竞赛

# 「柔性振动检测模块的设计」赛项规则与要求整理

> **依据版本（2026-09-29 更新）**：`柔性检测模块设计及制作赛项命题（更新版）.pdf`（10 页）。  
> 已与旧版 `柔性振动检测模块的设计赛项命题.pdf` 逐句、逐图比对。  
> 两个历史冲突已由更新版解决：① 4PIN 线序**以图 3 为准 ①TX ②RX ③GND ④VIN**（旧版正文"VIN/GND/TXD/RXD"一句已删除）；② 外框 90 = 55 + 35（15.2 弯曲区嵌在右段起始处），见更新版图 4。

## 一、赛项背景

- 面向仿生手"柔性感知"应用：仿生手接触目标物体时，需实时感知接触状态、接触稳定性及目标物体微振动特征。
- 仿生手表面为弧面结构，传统刚性电路难以稳定贴合、振动信号易衰减，因此需采用**柔性PCB + 弧形结构贴合设计**。
- 模块工作原理：外部电源供电 → 仿生手单指接触带振动激励的目标物体 → 振动经接触面传导至柔性振动检测模块 → 板载传感器实时采集 → 单片机数据处理与频率检测 → **串口输出**给外部测试平台。
- 模块设有供电接口，并预留 4pin 标准接口（电源2pin + 串口信号2pin）。
- 仿生手单指宽度约 **13mm**。

## 二、竞赛任务

参赛队需完成：

1. 检测模块**柔性PCB（PI基底）的设计及制作**（设计由队伍完成，制板由组委会统一制作）；
2. **元器件焊接和组装**；
3. 接上电源后完成**程序编写和调试**。

组委会现场提供的物料包用于模块的组装、结构集成和程序调试。

## 三、核心规则

- **物料限制**：参赛作品必须**全部采用组委会发放的物料**制作；使用非组委会发放的物料 → **取消比赛资格**。
- **PCB设计提交**：校内完成柔性PCB设计并按规定时间/方式提交组委会评审，由组委会统一制作柔性PCB。
  - 设计不符合要求无法制板的队伍 → **不参加后续现场比赛**。
- **现场实践环节**：向PCB设计合格的队伍发放其设计并制作好的柔性PCB板和物料包，在规定时间内完成焊接、组装、程序开发和调试。
- **备用方案（惩罚性规则）**：柔性PCB不能正常工作、或放弃使用自己设计的PCB的队伍，可选用组委会提供的标准柔性PCB板和物料包完成焊接、程序开发、调试，但**扣除总分的50%**。
- 自备设备：笔记本电脑、PCB设计软件、嵌入式开发工具及烧录工具（CH340、USB Type-C线）、**可调温电烙铁（最低可设置到180℃）**、直流12V电源等调试仪表、少量杜邦线。

## 四、赛程安排（三个环节）

| 环节 | 内容 | 地点/时间 |
| ---- | --- | --- |
| 第一环节 | 柔性PCB设计 | 赛前校内完成，按设计结果评分 |
| 第二环节 | 现场创新实践：作品制作 + 程序调试 + 方案文档输出 | 现场，具体要求和评分标准现场发布 |
| 第三环节 | 现场考核 | 现场抽签定赛位号，作品与测试装置连接考核 |

**成绩** = 三个环节得分总和。

**同分排序规则**：现场考核成绩 → 设计环节成绩 → 仍相同则抽签。

**运行环境**：组委会提供以可控振动激励标准测试件为基础的标准化测试平台；现场提供220V交流电及必要辅助材料。

## 五、检测模块功能要求（第一环节设计内容）

### 功能指标

- 检测仿生手与目标物体的**接触状态**、目标物体的**持续振动或周期振动**。
- 需检测：
  - **持续振动频率：80Hz ~ 180Hz**
  - **启停频率：0 ~ 3Hz**（某固定频率振动状态与无振动状态组成的周期频率）

### 硬件架构要求

- 基**于ESP32-C3单片机模块 + MPU6050传感器模块，以柔性电路板为基础。**
- **ESP32-C3 通过 I2C 连接 MPU6050，实时读取加速度计信息，单片机完成数据处理与频率解析。**
- **稳压电路：输入 12V → 输出 5V（单片机和传感器供电）。**
  - **红色LED常亮 表征稳压输出正常；**
  - **绿色LED由单片机控制闪烁，显示电路正常运**行。
- **电源总开关**：串联在12V转5V稳压电路**前端**；断开时模块**完全断电，不得存在静态功耗**。
- **黄色LED**：需预留并可控制亮灭。
- 供电：组委会提供 **12V** 电源；电源接口采用**杜邦线方式**连接，通过指定焊盘预留焊接位置，**现场焊接杜邦线**。
- 串口：TTL电平，杜邦线方式连接，指定焊盘预留焊接位置，现场焊接。

### 4pin 标准接口要求

- 采用 **4个开窗焊盘**（每个开窗尺寸 **> 4mm × 2mm**）。
- 焊接 4 根 **30mm 公头杜邦线**作为电源与串口连接线（更新版正文写"30CM"，但表1 封装规格为"单公头 30mm"，以表1 为准）。
- **线序以命题图 3 为准：①TX ②RX ③GND ④VIN**。  
  （更新版已删除旧版正文中"线序依次为 VIN、GND、TXD、RXD"的矛盾表述，图 3 新旧版本一致，  
  与本项目网表 `U4.1=TX / U4.2=RX / U4.3=GND / U4.4=VIN` 完全吻合，PCB 无需改动。）

### 尺寸与外形

- 整体外形参考组委会提供的标准外框，**最大不超过 100mm(长) × 25mm(宽)**。  
  更新版图 4 实测：**总长 90.0mm = 左段 55.0mm（高 22.3mm）+ 右段 35.0mm（高 12.6mm）**，  
  15.2mm 强制弯曲避让区**嵌在右段起始处**（即右段净剩 19.8mm × 12.6mm 放器件）。
- **强制弯曲避让区**（外框图中黄色边框区域）：**严禁放置任何元器件**，只允许电气布线与过孔。
- 柔性PCB须能完整贴合组委会提供的标准弧形仿生手单指结构表面，需考虑弯曲区域设计。

## 六、元器件清单（表1，更新版新增"规格"列；只能用清单内器件，数量不得超）

| 序号 | 名称 | 型号/数值 | 封装 | 规格（更新版新增） | 数量 |
| -- | --- | --- | --- | --- | -- |
| 1  | 贴片电容 | 0.1uF | 0805_C | ±10%，50V | 3  |
| 2  | 贴片电容 | 1uF | 0805_C | ±10%，50V | 3  |
| 3  | 贴片电容 | 10uF | 0805_C | ±10%，**16V** | 2  |
| 4  | 贴片电容 | 22uF | 0805_C | ±20%，**16V** | 2  |
| 5  | 贴片电阻 | 120Ω | 0805_R | ±1%，125mW | 5  |
| 6  | 贴片电阻 | 360Ω | 0805_R | ±1%，125mW | 5  |
| 7  | 贴片电阻 | 1KΩ | 0805_R | ±1%，125mW | 5  |
| 8  | 贴片电阻 | 1.5KΩ | 0805_R | ±1%，125mW | 5  |
| 9  | 贴片电阻 | 3KΩ | 0805_R | ±1%，125mW | 5  |
| 10 | 贴片电阻 | 4.7KΩ | 0805_R | ±1%，125mW | 5  |
| 11 | 贴片LED  | 红色 | 0805_LED | **正向压降 1.6~2.6V**，测试电流 25mA | 2  |
| 12 | 贴片LED  | 绿色 | 0805_LED | **正向压降 2.5~3.6V**，测试电流 20mA | 2  |
| 13 | 贴片LED  | 黄色 | 0805_LED | **正向压降 1.6~2.6V**，测试电流 25mA | 2  |
| 14 | 滑动开关 | 卧贴两档3脚 | SK-3245S-L1-A | 柄长 2mm，卧贴双档 | 1  |
| 15 | 电源稳压芯片 | AMS1117-ADJ | SOT-223 | 输出电压 1.25V~10V，输出电流 1A | 1  |
| 16 | 单片机模块  | ESP32-C3 | ESP32C3 | **ESP32-C3-SUPER MINI** | 1  |
| 17 | 传感器模块  | MPU-6050模块  | MPU6050 | MPU6050 | 1  |
| 18 | 杜邦线 | 单公头30mm | 4PIN-Land | — | 6  |
| 19 | 仿生手 | / | / | — | 1  |

**规格列带来的三个工程结论**（详见《数据手册中文要点》与《07-pinout》）：

1. **绿 LED 风险被官方坐实**：VF 上限 3.6V 高于 GPIO 的 3.3V。本设计 GPIO10 → R7(120Ω) 拉电流驱动，  
   典型 VF≈3.0V 时约 2.5mA（偏暗但可辨）。已决定**不改板**，现场预案见第九节"三灯与绿灯预案"。
2. **C3(10µF) 压在 12V 输入**：耐压 16V，余量 1.33×，可接受；注意陶瓷电容直流偏压下容量衰减  
   （数据手册要点文档已有提醒）。22µF/16V 在 5V 轨 ✅。
3. **反馈电阻功耗**：R2(360Ω) 压差 3.77V → 39mW < 125mW ✅；R1 13mW ✅。

## 七、设计文件提交要求

- 使用电路设计软件（如 **Altium Designer、嘉立创EDA**）完成原理图和PCB设计。
- PCB采用**双面板或单面板**；器件标识和网络关系必须与原理图一致。
- 生成规范 **Gerber（RS-274X）** 制板文件。

### 提交内容

1. 原理图源文件
2. 原理图 PDF 格式文件
3. PCB 设计源文件
4. Gerber（RS-274X）制板文件（**单独放入以队伍编号命名的文件夹**）

### 打包与命名

- 每个文件以**队伍编号**命名（报名结束后发布）。
- 所有文件打包为：**队伍编号 + ZIP/RAR**，按组委会要求方式提交（时间/方式见后续通知）。

### 后果

- **未按时提交设计文档 → 取消后续比赛资格**。
- 制板文件数量不足、格式错误、文件命名出现学校或个人信息 → **不予制作**。

## 八、PCB设计规范（硬性制板要求）

1. **物料**：只能使用《物料清单》中的物料。
2. **板框**：放置在 **Keep-Out Layer（GKO）**；必须为**闭合图案**、线条宽度一致、**有且只有1个边框**；除边框外GKO层不能有其他任何图案。非闭合边框或超尺寸 → 不予制作。
3. **层与文件**：
   - 双面板至少包含：`GKO`、`GTL`、`GBL`、孔层（`TXT/DRL`）共 **4个文件**；
   - 单面板至少包含：`GKO`、`GTL/GBL`、孔层（`TXT/DRL`）共 **3个文件**。
4. **线宽与间距**：
   - 最小线宽 / 最小线间距（线边缘间距）：**10mil (0.254mm)**
   - 最大线宽：**100mil (2.54mm)**
   - 元器件最小间距：**20mil (0.508mm)**
   - 导线-焊盘、导线-过孔、焊盘-焊盘、过孔-过孔、焊盘-过孔间距：**≥ 10mil (0.254mm)**
   - 导线/过孔/焊盘 与 边框间距：**≥ 12mil (0.305mm)**
   - 单个封装内：焊盘宽度 ≥ 12mil (0.305mm)，焊盘中心间距 ≥ 25mil (0.635mm)，焊盘边缘间距 ≥ 12mil (0.305mm)
   - 板载连接器引脚最小间距：**≥ 100mil (2.54mm)**
   - 超范围 → 不予制作
5. **孔的规格（只有3种，全部圆形）**：
   - 插件焊盘（通孔）：内径 **47mil (1.20mm)**，外径 **90mil (2.3mm)**
   - 过孔：内径只有 **25mil (0.635mm)** 一种，外径 ≥ **45mil (1.143mm)**
   - 固定孔：以过孔形式放置，孔内径只能为 **118mil (3mm)**
   - 其他尺寸/形状的过孔、钻孔、通孔 → **一概不予制作**
6. **禁止铺铜**：所有电气连接均以走线（Track）方式连通，**不可使用铺铜（Poly）**，否则不予制作。

## 九、关键模块说明

### ESP32-C3 单片机模块

- 32位 RISC-V CPU，含FPU，支持单精度浮点；Wi-Fi/蓝牙双模。
- 组委会提供**扩展封装板**：单片机已焊好，13个引脚以**邮票孔**引出，脚间距 **2.54mm**，模块尺寸 **19mm × 23mm**。
- 板上有 RESET 按钮和 BOOT 按钮；用 **USB Type-C** 连接即可烧录。
- **进入下载模式**：按住BOOT → 按下RESET → 松开RESET → 松开BOOT。
- Layout时参考"封装库"文件中的封装。
- **禁止布线区**：为防止模块板后Type-C连接器部位两侧与PCB短接，需在PCB对应网格区域禁止布线（见命题图7）。

### MPU6050 传感器模块

- 集成外围LDO、I2C上拉电阻；3轴陀螺仪 + 3轴加速度计，各3个16位ADC。
- 扩展封装板：I2C引脚及控制引脚**邮票孔**引出，脚间距 2.54mm，尺寸 **14.86mm × 11.5mm**，工作电压 **5V**。

| 引脚号 | 名称 | 类型  | 功能 |
| --- | --- | --- | --- |
| 1 | VCC | 电源  | 电源输入，接5V |
| 2 | GND | 电源  | 电源地 |
| 3 | SCL | I/O | I2C时钟，内置5.1K上拉 |
| 4 | SDA | I/O | I2C数据，内置5.1K上拉 |
| 5 | AD0 | I/O | I2C地址配置脚 |
| 6 | AUX_CL | I/O | 主机I2C时钟接口（接外部传感器SCL） |
| 7 | AUX_DA | I/O | 主机I2C数据接口（接外部传感器SDA） |
| 8 | INT | I/O | 中断输出脚 |

### 三灯状态与绿灯现场预案（2026-09-29 决策：不改板）

| 灯 | 驱动 | 状态含义 |
| - | --- | --- |
| 红 | 硬件直连 5V 常亮（+5V→R3→LED3→GND），软件不可控 | 稳压输出正常 |
| 绿 | **GPIO10 → R7(120Ω) → LED1 → GND**（拉电流） | MCU 控制闪烁 = 电路正常运行 |
| 黄 | GPIO5 → R8(360Ω) → LED2 → GND（预留可控） | 固件赋予"检测到持续振动"语义 |

**绿灯风险**（更新版表1 官方规格：绿 VF 2.5~3.6V @20mA）：VF 上限 3.6V 高于 GPIO 高电平 3.3V。  
典型 VF≈3.0V 时电流约 (3.3−3.0)/120Ω ≈ 2.5mA，偏暗但肉眼可辨，赛题只考核"闪烁"行为，**决定不改板**。

**现场预案（若绿灯不亮/极暗，按序执行）**：

1. 断电，先换上剩余的备件绿灯（清单每色 2 颗，本设计各用 1 颗）再观察——可能只是器件 VF 离散；
2. 仍不亮 → 飞线改灌电流：LED 反接（阳极改接 5V 轨、阴极经 R7 接 GPIO10），R7 由 120Ω 换 360Ω  
   （(5−3.0)/360 ≈ 5.6mA，同封装直接换料，均在清单内）；
3. 固件把 `LED_ACTIVE_LOW` 宏改为 `1` 重新编译烧录（`代码\vibmon\vibmon.ino` / `selftest.ino` 顶部配置区）。

## 十、第二环节（现场实践）要点

- 规定时间内，按**现场发布**的任务命题，用现场材料完成电路制作、程序开发及烧写、调试。
- 需完成**方案文档**输出（含硬件设计与软件设计原理，模板由组委会提供）。
- 未完成电路制作/程序开发，或未提交方案文档 → 不能参与后续比赛环节。
- 自带焊接和调试工具；**有安全隐患的物品及不允许携带的物品不得带入现场，否则取消比赛资格**。

## 十一、组委会提供的资料

1. 物料清单
2. 主要物料的数据手册
3. 电子元器件PCB封装库与原理图库
