wmsz88/flex-vib-monitor/资料/02_硬件设计/硬件设计说明/04-constraints.md

# 04 约束输出 — 接口矩阵 / 电源树 / PCB 规则自检清单

**日期**：2026-09-20

## 接口矩阵

| 信号 | 源 | 目标 | 电平 | 方向 | 备注 |
|---|---|---|---|---|---|
| VIN | 4pin 大焊盘① | 开关→LDO IN | 12V | 输入 | 大焊盘开窗>4×2mm |
| GND | 4pin 大焊盘② | 全板地 | — | — | 与 5V 轨共地 |
| TXD | 4pin 大焊盘③ | ESP32 GPIO21(UART0 TX) | 3.3V TTL | 输出 | 对外测试平台 |
| RXD | 4pin 大焊盘④ | ESP32 GPIO20(UART0 RX) | 3.3V TTL | 输入 | |
| SDA | ESP32 GPIO8 | MPU6050 p4 | 3.3V，5.1K 上拉（模块内） | 双向 | 跨弯曲区 |
| SCL | ESP32 GPIO9 | MPU6050 p3 | 同上 | 双向 | 跨弯曲区 |
| AD0 | MPU6050 p5 | GND | — | — | 地址 0x68 |
| MPU_VCC | ESP32 模块 3.3V 脚 | MPU6050 p1 | 3.3V | — | 上拉电平须与 IO 耐压匹配（见 02 文档⑥说明） |
| 红 LED | 5V —360Ω—LED—GND | — | ~8mA | 常亮 | 输出正常指示 |
| 绿 LED | GPIO10 —360Ω—LED—GND | — | ~3mA | 程序闪烁 | 心跳 |
| 黄 LED | GPIO5 —360Ω—LED—GND | — | ~3mA | 预留 | |
| 烧录 | 模块 USB Type-C | — | — | — | 周围禁布区让开 |

## 电源树与电流预算

| 轨 | 来源 | 负载 | 电流（典型/峰值） |
|---|---|---|---|
| 12V 输入 | 外部电源，开关串联 | AMS1117 | ~100mA / 350mA（峰值仅瞬态） |
| 5V 轨 | AMS1117-ADJ（R1=120Ω/R2=360Ω → 5.02V） | ESP32 模块 ~50mA + MPU 模块 ~5mA + 红LED 8mA + 反馈分流 10.4mA | ~75mA / 350mA |
| 3.3V | ESP32 模块板载 LDO | 芯片本体 + GPIO 驱动 LED ~6mA | 模块内部 |

**热校核**：AMS1117 为线性稳压器，**输入电流≈输出电流**（无效率折算），12V 侧典型电流 = 5V 轨负载 ≈ 75mA；Pd = (12−5)V × 0.075A ≈ 0.53W（典型），SOT-223 ΔT ≈ 60~90°C/W × 0.53 ≈ 32~48°C——FPC 散热比 FR4 差，把 AMS1117 放主体区边缘、铜皮走线加宽散热；**固件禁止开 Wi-Fi/BT**（峰值 350mA 会把 Pd 推到 2.4W，过热保护会跳）。

**上电时序**：单轨上电，无次序要求；开关断开时全轨失电，无静态通路（反馈分流随 5V 消失）。

## PCB 规则自检清单（命题硬性红线，出 Gerber 前逐条打勾）

| # | 规则 | 限值 | ✅ |
|---|---|---|---|
| 1 | 板框 | KeepOut 层唯一闭合边框、等线宽、无其他图案 | ☐ |
| 2 | 外形 | 外框总长 90.0mm = 左段 55.0×22.3 + 右段 35.0×12.6；上限 ≤100×25mm | ☐ |
| 3 | 弯曲避让区（右段起始 15.2×12.6mm 黄框区） | 禁放任何元器件，只允许走线+过孔 | ☐ |
| 4 | 线宽/线距 | ≥10mil（0.254mm），最大 100mil | ☐ |
| 5 | 器件间距 | ≥20mil（0.508mm） | ☐ |
| 6 | 线/盘/孔间距 | 互间距 ≥10mil；与板框 ≥12mil | ☐ |
| 7 | 插件通孔 | 仅内径 47mil/外径 90mil 一种 | ☐ |
| 8 | 过孔 | 内径仅 25mil，外径 ≥45mil | ☐ |
| 9 | 固定孔 | 仅 118mil（3mm）过孔形式，全圆孔 | ☐ |
| 10 | 铺铜 | **禁止一切铺铜，全部走线连通** | ☐ |
| 11 | 4pin 焊盘 | 4 个开窗焊盘各 >4×2mm，线序 **①TX ②RX ③GND ④VIN**（更新版图 3 已确认） | ☐ |
| 12 | 器件 | 仅限物料清单，数量不超 | ☐ |
| 13 | 封装 | 使用组委会封装库（勿改动） | ☐ |
| 14 | Type-C 区 | 模块背面 Type-C 对应网格区禁止布线（命题图7） | ☐ |
| 15 | Gerber | RS-274X 双面板 4 件：GKO/GTL/GBL/TXT | ☐ |
| 16 | 命名 | 文件名不含学校/个人信息，命名"学校+队名+PCB设计" | ☐ |

## 布局分区建议

@image#2:"PCB布局分区图.png"

> 图：布局分区示意（AI 示意图，分区比例和位置以本节文字与组委会外框图4为准；图中 4pin 焊盘实际放主体区板边，非传感器区）

- **主体区 55×22.3mm**：ESP32-C3 模块（组委会封装实测 22.5×18.0mm，横向放）+ AMS1117（板边散热）+ 开关 + 红/绿/黄 LED + 4pin 大焊盘（板边一字排开，方便现场焊杜邦线）
- **弯曲避让区（右段起始 15.2×12.6mm）**：仅 3.3V/GND/SDA/SCL 四线跨越，线宽 20mil，尽量不过孔（MPU VCC 取自 ESP32 模块 3.3V 脚，保证 I2C 上拉电平 3.3V）
- **窄条余量（避让区之后）19.8×12.6mm**：MPU6050 模块（封装包围盒 18.67×9.14mm）**紧贴弯曲区一侧、不能居中**——横向仅余 1.13mm 总余量；0.1µF 去耦放模块 VCC 旁（若空间不足放主体区）
- 12V/5V 主干线宽 ≥30mil，GND 建议双面板背面整片走 GND 网络（注意规则10：不能用铺铜——用粗走线网格或顶层加粗地线）
