wmsz88/flex-vib-monitor/资料/02_硬件设计/硬件设计说明/06-decisions.md

# 06 决策门 — 已确定 / 待确认 / 高风险

**日期**：2026-09-20

## ✅ 已确定（可进入原理图绘制）

1. 主控/传感器/电源芯片 = 组委会指定器件，封装用组委会库
2. 稳压方案：AMS1117-ADJ，R1=120Ω / R2=360Ω，Vout≈5.02V，ADJ 旁路 10µF
3. 引脚分配：GPIO8=SDA、GPIO9=SCL、GPIO10=绿LED、GPIO5=黄LED、GPIO21/20=TXD/RXD
4. MPU6050 置于窄条紧贴弯曲区，跨区仅 4 线（5V/GND/SDA/SCL）
5. 双面板 + Gerber RS-274X 四件套
6. strapping 引脚核查：GPIO2 未使用 ✓；GPIO8（strapping，需高电平启动）被 MPU6050 模块板载 5.1K 上拉至 3.3V ✓；GPIO9=BOOT（模块板载按键+上拉，组委会模块本身如此设计）✓——不影响正常启动
7. **I2C 实现方式：用硬件 I2C（Wire 库），不用软件 I2C**（2026-10-01 定）。依据：ESP32-C3 内核 `variants/esp32c3/pins_arduino.h` 第 19/20 行 `SDA = 8`、`SCL = 9`——**本项目引脚恰好就是硬件 I2C 默认引脚**，`Wire.begin()` 零配置即正确；200kHz 下 1kHz 采样 × 7 字节 ≈ 72kbit/s，总线余量充足且 CPU 不空转；软件 I2C 在 ESP32 上稳定上限约 100kHz，1kHz 采样要吃掉约 2/3 的 CPU 周期，会挤压串口输出与包络计算。C3 只有 1 个 I2C 控制器——本项目 MPU6050 独占该总线，无需第二组，故无软件 I2C 的适用场景
8. **检测逻辑：两项指标同时输出，不切换采样率；不引入 PID**（2026-10-01 定）
   - 命题五节原文：需检测「**持续振动频率 80~180Hz**」与「**启停频率 0~3Hz**（某固定频率振动状态与无振动状态组成的周期频率）」。二者是**载波 / 包络**关系，**不是二选一**。
   - **逻辑上是串联依赖**：要算启停频率，必须先有「有振动 / 无振动」的判据；该判据来自 80~180Hz 那一路的能量（包络）经阈值判决。故两路共用同一条信号链，**不切换、不分时**。
   - **一个采样率吃两项**：1kHz 对 180Hz 载波是 5.5× 奈奎斯特余量，对 3Hz 包络余量 300×+。采样率无需切换；关键是 **DLPF 不能设窄**（DLPF_CFG=0 → 260Hz；设成几 Hz 会把 80~180Hz 直接滤没），并用高通（≥70Hz）去掉重力直流与低频漂移。
   - **不上 PID**：本模块是**检测/测量**设备，单向串口输出给外部平台，无执行器、无被控量、无设定值跟踪——PID 是闭环控制工具，此处无适用对象。幅度自适应应走**自适应阈值**（噪声底滑动平均 × 倍率），属统计方法而非 PID。唯一变数：第二环节任务现场发布，若临时包含控制要求再另行评估，但硬件上可控执行器仅三只 LED，不存在可 PID 的连续被控量。

## ❓ 待确认（负责人：际遇，截止 9/24）

1. 队伍名单/队名/指导老师 → 影响文件命名与报名（校赛 9/30 前必须定）
2. 学校提交方式与校赛具体时间地点 → 找负责老师确认
3. 绿/黄 LED 具体引脚是否与现场第二环节任务冲突 → 现场发布任务后可在固件层改，硬件无需改（预留即为此设计）

## 🔴 高风险（有缓解措施，需盯住）

| 风险 | 影响 | 概率 | 缓解/验证 |
|---|---|---|---|
| 12V 杜邦线接反（BOM 无反接保护） | 上电即烧 LDO/模块 | 中 | 现场接线时双查线序；上电前先测 VIN 极性 |
| LDO 过热（FPC 散热差） | 过热保护跳、输出掉电 | 中 | 固件不开 Wi-Fi；备选 R1=1K∥1K/R2=1.5K；V13 温升测试 |
| PCB 规则违例不予制板 | 直接失去比赛资格 | 低-中 | V1 十六条清单 + 嘉立创 DRC 双保险，9/27 前完成 |
| 弯曲区焊点疲劳 | 现场断线 | 低 | 跨区走线垂直弯曲轴、加宽、少过孔；V14 弯折测试 |
| I2C 在柔性板上受干扰 | 读数跳变 | 低 | SDA/SCL 远离 12V 干线；上拉已在模块内；必要时降速 100kHz |
