wmsz88/flex-vib-monitor/资料/03_软件与方案/版本讲解/可调参数总表.md

# 可调参数总表（周期、采样、幅值等其余可能改动的全部宏）

> 日期：2026-11-08
> 来源：`代码\vibmon_v6\config.h` 全部 150 条 `#define` 逐条过筛，按「现场可能被要求改」的角度分组。
> 行号均为 v6 的 `config.h`；已有专文的只留一行指针。危险等级：**低**（改了只影响输出形式）、**中**（改了要三项实测）、**高**（现场禁改，动了判据链结构）。

## 0. 改任何宏之前的三步

1. 查 §8 的编译期断言联动表——很多宏不是孤立的，改一个会牵动另一个（改错组合编译期直接 `#error`，不会带病上板）。
2. 改阈值类（幅值/角度/频率门）后**必做三项实测**：空握不进、振动接触进、松手退出。
3. 帧格式类改完跑帧核对；判据类改完跑宿主 `run_all.ps1` 对照基线。

## 1. 周期 / 帧率类（低～中）

| 宏（行号） | 默认 | 作用与改法 | 等级 |
|---|---|---|---|
| `COMP_PERIOD_MS`（41-43） | 20 | 比赛帧发送周期（20ms=50Hz）。改小只会发重复值（频率 15.6Hz、包络 100Hz 才有新数据）；要更慢配合 v7 `COMP_FRAME_DIV`，不动这条 | 低 |
| `COMP_FRAME_DIV`（仅 v7，`config.h:65-67`） | 1 | 发送分频 2=25Hz / 5=10Hz，SEQ 连续。首选降帧率手段 | 低 |
| `PLOT_MS`（581） | 20 | 绘图行周期 50Hz。比赛无关，纯调试显示 | 低 |
| `DBG_MS`（582） | 200 | 调试行周期 5Hz。现场看 `d` 行嫌慢可改 100（10Hz） | 低 |
| `FREQ_STALE_MS`（292） | 300 | 主频超此时间未更新即失效。平台嫌频率"过期值"太慢可缩短，太快会频繁掉 0 | 中 |
| `AMP_STALE_MS`（293） | 100 | 幅值过期时间（包络 100Hz 节奏对齐）。同上 | 中 |

## 2. 采样与 DSP 窗口类（高——现场禁改，列出只为答疑）

| 宏（行号） | 默认 | 作用 | 等级 |
|---|---|---|---|
| `FS_HZ`（189） | 1000 | 主采样率 1kHz。牵动 `GYRO_DT_S`、奈奎斯特断言（`config.h:639-641`）、`SS_T_MIN` 断言（`:659-661`）、宿主测试全链——现场**不许动** | 高 |
| `RING_N`（192） | 512 | 环形缓冲深度（2 的幂）。改小省 RAM 但抗缺口能力降 | 高 |
| `BLOCK_N` / `HOP`（213-216） | 128 / 64 | 主频估计窗长/步长 → 主频刷新 15.6Hz。断言：`FS_HZ/BLOCK_N < FREQ_LO_HZ`（`:642-644`，窗里装不下一整个 60Hz 周期就永远测不出） | 高 |
| `ENV_WIN` / `ENV_HOP`（230-233） | 30 / 10 | 包络 RMS 窗/步 → 包络 100Hz。断言 `ENV_HOP ≤ ENV_WIN`（`:615-617`） | 高 |
| `HP_FC_HZ`（218） | 70 | 二阶高通截止。命题下限 80Hz，**只能 ≤70 不能再高**（再高会削掉 80Hz 正常振动） | 高 |
| `MIN_PERIODS`（226） | 5 | 窗内有效周期数下限。改小主频更"跟手"但更抖 | 高 |
| `ZCL_K`（227）/ `ZCL_MIN_MG`（228） | 3.6 / 1.0 | 过零阈值 = K×带内噪声。平台件振动弱导致测不出频时**唯一可微调项**（降 K 或降 MIN_MG），代价是低幅噪声可能出假频 | 中 |
| `CLIP_SEVERE_RATIO`（300） | 0.10 | 主轴削顶 ≥10% 判主频失效。改量程后若误报 clip 失效可放宽 | 中 |

## 3. 幅值类（中——改后必三项实测）

| 宏（行号） | 默认 | 作用 | 等级 |
|---|---|---|---|
| `TH_HI_K`（248）/ `TH_LO_K`（249） | 5.0 / 2.5 | VIB 滞回阈值 = K×静置包络。平台件振幅小、VIB 不亮时降 K（如 4.0/2.0） | 中 |
| `TH_HI_MIN_MG`（250）/ `TH_LO_MIN_MG`（251） | 8 / 4 | 上述阈值的下限（静置包络很小时兜底） | 中 |
| `SS_HI_MG`（284）/ `SS_LO_MG`（287） | 120 / 80 | 启停边沿判幅（v6 已从 180/150 降过一次，依据见《v5到v6逐行讲解》§2.1）。平台件更弱再降，80 以下警惕噪声假边沿 | 中 |
| `CT_FLAT_A_ON_MG` / `OFF`（464-468） | 400 / 300 | 接触幅值门（进入/滞回退出）。真接触实测 500~1152mg、最坏瞬态 304mg——**OFF 不能低于 ~310**（低于瞬态会空握误进） | 中 |
| `CT_AMP_F_ON_MG`（477）/ `CT_AMP_F_OFF_MG`（480） | 250 / 187.5 | "幅值或频率"辅助证据的幅值支路 | 中 |
| `ACCEL_CLIP_RAW`（67） | 32700 | 削顶判定的原始值门（±4g 下 ≈2000mg）。改 `ACCEL_FS_SEL` 后按比例重算 | 中 |
| `ACCEL_FS_SEL`（60） | 1(±4g) | 量程。冲击削顶改 2（±8g）；细则见《其他改动要求》§2.3 | 中 |

## 4. 频率类（中）

| 宏（行号） | 默认 | 作用 | 等级 |
|---|---|---|---|
| `FREQ_LO_HZ` / `FREQ_HI_HZ`（220-224） | 60 / 220 | 主频有效区间。断言：`FREQ_HI×2 < FS_HZ`（奈奎斯特，`:639-641`）。平台件频率超出才动 | 中 |
| `CT_FLAT_F_ON_HZ` / `OFF`（495-496） | 75 / 63 | 接触频率门。OFF ≥ FREQ_LO 由整数镜像断言拦（`:573-578`）。细则见《其他改动要求》§2.2 | 中 |
| `CT_SS_ENTRY_MIN_HZ`（363-364） | 1.5 | 启停进入接触的最低节奏（0.5/1Hz 走幅值路径）。平台档位不同才动 | 中 |

## 5. 角度类（中）

| 宏（行号） | 默认 | 作用 | 等级 |
|---|---|---|---|
| `ANGLE_CLOSED_DEG` / `OFF`（108-111） | 60 / 45 | 闭合角进入/退出（滞回）。佩戴者手大/小导致闭合角天生不达标时降 ON | 中 |
| `ANGLE_OPEN_DEG`（114） | 20 | 低于此角且静止 = 回到张开位（角度清零基准） | 中 |
| `OPEN_D_MG`（117） | 400 | "已回到张开"的加速度距离门 | 中 |
| `CT_FLAT_D_ON_MG` / `OFF`（454-455） | 400 / 280 | 模式 3/4 姿态距离门（平放安装方向用） | 中 |

## 6. 时间常量类（中～高）

| 宏（行号） | 默认 | 作用 | 等级 |
|---|---|---|---|
| `CT_CONFIRM_MS`（339） | 100 | 接触翻转确认。缩短响应快但易抖 | 中 |
| `CT_HOLD_MS`（349-350） | 1200 | 振动证据保持窗（覆盖启停 OFF 段）。断言 `> CT_CONFIRM_MS`（`:704-708`）。v6 保持语义下此值只在宏关时起作用 | 中 |
| `SS_CONFIRM`（252-253） | 3 | 启停翻转确认（3 包络点=30ms） | 中 |
| `SS_T_MIN_MS` / `SS_T_MAX_MS`（259-264） | 200 / 12000 | 启停周期上下限（5Hz~0.083Hz）。平台档位超出才动；断言 `T_MIN ≥ 一个包络间隔`（`:659-661`） | 中 |
| `SS_MIN_PERIODS` / `SS_USE_PERIODS` / `SS_EDGE_MAX`（266-270） | 2 / 4 / 16 | 出启停读数的最少周期 / 取样中位数窗口 / 边沿历史深度。断言链：`MIN ≤ USE ≤ EDGE`（`:647-655`） | 中 |
| `SS_TIMEOUT_K`（290） | 2.0 | 超过 2×当前周期无新边沿 → 启停读数失效 | 中 |
| `SS_CONSIST_RATIO`（291） | 1.5 | 周期最大/最小超此比值判节奏不稳不给读数。平台振子节奏差可放宽 | 中 |
| `CT_SETTLE_DPS/MS`、`CT_RELEASE_DEG/TAU_MS`（385-393、410-412） | 10/150、10/500 | 接触三条参数，全表见《v5到v6逐行讲解》§2.2 与《其他改动要求》§2.2 | 中 |
| `CAL_BIAS_MS` / `CAL_NOISE_MS`（238-239） | 2000 / 1200 | 上电标定时长。缩短省开机时间，代价是标定方差变大（`CAL_MAX_STD_MG` 更易拦） | 中 |
| `CT_REF_SETTLE_MS` / `CT_REF_AVG_MS`（550-551） | 300 / 500 | 平放基准采集的稳定/平均窗 | 中 |
| `GYRO_STILL_MS`（86） | 500 | 陀螺"静止"判定窗（回零/冻结用） | 中 |
| `AUTO_ZERO_REST_MS`（134） | 2000 | 自动去零偏的静置窗 | 中 |
| `RECOVER_PERIOD_MS`（201） | 1000 | I2C 断线重连间隔 | 低 |
| `SENSOR_LOST_N` / `SENSOR_STALE_MS`（199-200） | 20 / 100 | 判传感器断线的连败次数/无样本时长 | 中 |
| `I2C_TIMEOUT_MS`（58） | 5 | 采样回调内 I2C 超时，**不许加大**（回调阻塞会丢样本） | 高 |

## 7. 硬件配置类（低～高）

| 宏（行号） | 默认 | 作用 | 等级 |
|---|---|---|---|
| `UART_SWAP`（13） | 1 | 调试口 TX/RX 交换。换排针接法才动 | 低 |
| `BAUD`（21） | 115200 | 调试口波特率（比赛口是 `COMP_BAUD`） | 低 |
| `PLOT_DEFAULT`（583） / `PLOT_WAVE_DEFAULT_DECIM`（586-588） | 1 / 4 | 上电绘图组 / 波形抽取比。UART 口建议 w8（`w` 命令可运行时改，零编译） | 低 |
| `MPU_ADDR`（56） | 0x68 | AD0 接地固定；换模块才动 | 高 |
| `I2C_CLOCK`（57） | 200k | I2C 时钟。弯折线上不稳可降 100k（换稳定性弃带宽） | 中 |
| `DLPF_CFG`（63） | 0 | 加速度带宽 260Hz——保住 180Hz 上限，**不许改**（改了测频端跟着变） | 高 |
| `GYRO_FS_SEL`（75） | 1(±500dps) | 陀螺量程。剧烈动作削顶才升 2 | 中 |

## 8. 编译期断言联动速查（改宏前对照，出错 `#error` 自带中文说明）

| 你改了 | 必须同时满足 | 断言行 |
|---|---|---|
| `FREQ_HI_HZ` ↑ | `FREQ_HI×2 < FS_HZ` | 639-641 |
| `BLOCK_N` ↓ | `FS_HZ/BLOCK_N < FREQ_LO_HZ` | 642-644 |
| `ENV_HOP` ↑ | `ENV_HOP ≤ ENV_WIN` | 615-617 |
| `SS_USE_PERIODS` ↓ | `SS_MIN_PERIODS ≤ USE ≤ SS_EDGE_MAX` | 647-655 |
| `SS_T_MIN_MS` ↓ | `T_MIN ≥ ENV_HOP×1000/FS_HZ`（=10ms） | 659-661 |
| `CT_HOLD_MS` ↓ | `> CT_CONFIRM_MS` | 704-708 |
| 模式 3 的 ON/OFF 浮点门 | ON > OFF（整数镜像同步改） | 561-578 |
| `CT_SETTLE_MS` | ≥ 0 | v6 700-707 |

## 9. 一页速记

- 输出节奏：`COMP_PERIOD_MS`（发多快）与 `COMP_FRAME_DIV`（v7 降档）二选一改，别同时动。
- 幅值三对滞回门：VIB `TH_HI/LO_K`、启停 `SS_HI/LO`、接触 `CT_FLAT_A_ON/OFF`——全按「ON 比 OFF 高 25~50%」的滞回关系改，改后三项实测。
- 频率端唯一现场可微调的是 `ZCL_K/ZCL_MIN_MG`（弱振动测不出频时）；`FS_HZ/BLOCK_N/ENV_*/HP_FC/DLPF` 全是结构参数，现场禁改。
- 时间常量改短=响应快但易抖，改长=稳但迟钝；`I2C_TIMEOUT_MS` 只许小不许大。
- 一切改动的护栏：§8 断言表 + 三项实测 + 宿主基线对照。
