wmsz88/flex-vib-monitor/vibmon_v9/测试/V6b/流程.md

# T013 实板体检流程（v6 出发前）

> 2026-11-06 · EXEC 准备。人类操作 + 助手后台采集/语音提示，**一轮跑完**（沿用 `..\..\vib_range_test\实板测试模式.md`）。
> 固件：`vibmon_v6\build_uart\`（CDC 构建 `esp32:esp32:esp32c3:CDCOnBoot=cdc`，编译见 `代码\README.md` §〇）。
> 数据全部落本目录（`测试\V6b\`）。

## 零、准备（人类）

1. 烧 v6，记下检测模块的 COM 口（下称 COMx）。
2. **上电/复位时必须处于张开(START)姿态** —— 否则 `ang` 恒 0、`closed=0`、`ct` 永远 0（踩过）。
3. 备好：旧振子、新振子、4cm 方块、夹具。
4. 采集脚本会先发 `d` 打开调试行，所以每段日志里会有 `#V6 closed= ang= lpW= settled= moved=`（5Hz）。

## 一、采集命令（助手；每段一条）

```bash
python -X utf8 -u 采集.py --port COMx --out <段名>.txt --secs <秒数>
```

开串口会复位模块 —— 脚本启动后**先别动**，等第一条 `$VD` 出来。

## 二、四个检查（助手语音提示 → 人做动作）

### 检查 A —— `#V6` 取证（旧振子 2Hz 启停 30s，手指保持不动）

| 步 | 助手说 | 做什么 |
|:--:|---|---|
| A1 | “请张开握好、别动，我要起采集 8 秒后开振源” | 助手 `--secs 45`；8s 后 `h`/`9`…把旧振子带到 2Hz 档 |
| A2 | “旧振子在 2Hz 启停，手别动，30 秒” | 保持 30s |
| A3 | “可以松手了” | 停振源、停采集 |

要报的：`lpW / settled / moved` 各列的中位与最大（把 RT012「来回摆」从推测变成证据）。

### 检查 B —— 退出延迟（连续振动中松手 ≥3 次）

| 步 | 助手说 | 做什么 |
|:--:|---|---|
| B1 | “握好，我在开连续振动” | 助手 `--secs 60`，开振源到稳定振动 |
| B2 | “松手，等 2 秒再握回去”（重复 3~5 次） | 按要求松/握 |

要报的：每次「松手 → `ct` 掉 0」的毫秒数（用 `$VD` 行的墙钟时间戳），与 v5 的 0.30~0.42s 对比。

### 检查 C —— 空握误进（空握 10 次）

| 步 | 助手说 | 做什么 |
|:--:|---|---|
| C1 | “空握 10 次，每次握一下就松开，间隔 2 秒” | 照做，全程不开振源 |

要报的：`ct=1` 的持续总时长（v6 两轮历史：1 次 2.2s / 0 次）。

### 检查 D —— 帧格式（不应变）

用检查 B 的同一段日志即可：出厂帧仍然 35 字节、`CHK` 全对；v6 只多 `#V6` / `#F=` 调试行，`$VD` 帧逐域与 T008 默认构建一致。

## 三、跑完要留的东西

- `测试\V6b\检查A.txt`~`检查D.txt`（或合并的原始日志）
- `测试\V6b\说明.txt`：采集顺序、固件 SHA、开没开 `d`
- 汇总进 `结果\RT013-YYYYMMDD.md`
