wmsz88/flex-vib-monitor/资料/02_硬件设计/柔性振动检测模块PCB设计文档.docx

# 柔性振动检测模块 PCB 设计文档

（学校：广州华立学院　队名：数据别和我作队　赛项：柔性振动检测模块的设计与制作）

# （一级标题）一、设计任务与总体方案

本赛项要求使用组委会锁定的物料清单，完成柔性振动检测模块的电路原理图设计与柔性 PCB 设计。模块以 ESP32-C3（ESP32-C3-SUPER MINI 模块）为主控、MPU6050 为振动传感单元，外部 12V 经滑动开关与 AMS1117-ADJ 线性稳压得到 5V 工作电源；MCU 对振动信号进行 1kHz 定速采样，经数字滤波与频率估计后通过 UART 串口将振动主频、幅值、接触状态与启停频率实时输出至组委会测试平台。

总体设计流程为：需求分析与规则梳理 → 器件选型核对（以组委会封装库为准）→ 原理图设计 → 原理图评审与修正 → PCB 布局布线 → 规则自检与 DRC → Gerber 导出与复核。

# （一级标题）二、原理图设计过程

# （二级标题）2.1 电源电路设计

输入 12V 经 4PIN 焊盘第 4 脚（VIN）进入板内，先经过滑动开关 SK-3245S-L1-A 再进入稳压电路，保证开关断开后整板静态电流为零。稳压芯片选用 AMS1117-ADJ（SOT-223 封装），反馈网络由 R1（120Ω，VOUT→ADJ）与 R2（360Ω，ADJ→GND）构成，输出电压按 VOUT = 1.25 × (1 + R2/R1) + IADJ·R2 计算得约 5.02V。ADJ 节点串联两颗电阻的分压设计同时保证了 AMS1117 所需的最小负载电流（1.25V/120Ω ≈ 10.4mA）。

输入侧配置 C1（0.1µF）与 C2（10µF）储能滤噪；输出侧配置 C3（22µF）满足手册强制稳定性要求，C4（0.1µF）补充高频去耦。大电容管能量、小电容管毛刺，两级配合覆盖宽频段。

# （二级标题）2.2 主控与传感电路设计

ESP32-C3 模块电源脚（5V，16 脚）直接取自 +5V 轨，就近配置 C6（1µF）储能；模块板载 LDO 输出 3.3V 供芯片本体，3V3 脚配置 C5（0.1µF）去耦。MPU6050 模块 VCC 接 +5V 轨，其板载 LDO 与 5.1kΩ I²C 上拉随 VCC 生效，AD0 接地使 I²C 地址固定为 0x68。

I²C 总线选用 GPIO8（SDA）、GPIO9（SCL）；两脚均为 strapping 引脚，依靠 MPU 模块板载上拉与模块内部处理保持启动电平。指示灯中绿色 LED 由 GPIO10 经 R5（120Ω）驱动作为心跳指示，黄色 LED 由 GPIO1（原理图网络 P5）经 R4（360Ω）驱动作为预留控制口，红色 LED 经 R3（360Ω）接 +5V 常亮作为电源指示。UART 调试与数据输出使用 GPIO21（TX）、GPIO20（RX）连接 4PIN 焊盘第 1、2 脚。

# （二级标题）2.3 原理图自查与评审

原理图完成后按数据手册逐项核对：ESP32-C3-SuperMini 符号的 5V/GND/3V3 引脚映射（16/15/14 脚）、MPU6050 模块引脚序（1=VCC、2=GND、3=SCL、4=SDA、5=AD0）、AMS1117 封装（3=VIN、2=VOUT 与 TAB 相连、1=ADJ、4=TAB 散热片接 VOUT 增强散热）。核对中曾发现并修正的典型问题包括：模块电源脚经电容误导通、3V3 脚误接地、LED 缺少限流电阻、4PIN 焊盘线序与命题图 3 不符等。最终以导出网表为基准完成图物一致性确认。

# （一级标题）三、PCB 设计过程

# （二级标题）3.1 板框与结构设计

依据命题图 4 设定柔性板外框：主体区 55.0mm × 22.3mm，右侧窄区 35.0mm × 12.6mm，总长 90.0mm，最大不超过 100mm × 25mm。右侧窄区起始处嵌入 15.2mm 强制弯曲避让区，区内严禁放置任何元器件与过孔，仅允许走线跨越。板框绘制于 Keep-Out 层，闭合唯一、线宽一致。布局上主控与稳压器置于主体区，MPU6050 置于窄条区贴近弯曲区，4PIN 大焊盘沿主体区板边一字排开便于现场焊接杜邦线。

# （二级标题）3.2 布局与布线

布线采用双面板。线宽分配：12V 主干与 GND 主干 30mil（兼顾载流余量与 AMS1117 散热），5V 主干 20mil，信号线（I²C、UART、LED 控制）统一 10mil，满足命题"线宽不小于 10mil"的要求。TAB 散热片出口局部加宽至 80mil 短粗段辅助散热后收窄为 30mil 主干。跨弯曲避让区的 I²C 与电源走线保持等宽平直，避免线宽突变形成应力集中点。全板禁止铺铜，过孔仅使用孔径 25mil/外径 45mil 一种规格，符合命题对孔型种类的限制。

# （二级标题）3.3 规则检查与 Gerber 导出

布线完成后运行 DRC 检查，并按命题逐条核对：线宽 10~100mil 区间、板框闭合唯一、弯曲区零器件、禁铺铜、孔型规格受限、丝印无学校与个人信息。通过后使用嘉立创 EDA 专业版一键导出 Gerber（RS-274X），包含 GTL/GBL（线路）、GKO（板框）、GTS/GBS（阻焊）、GTO/GBO（丝印）、DRL（钻孔）等完整图层，并导入 Gerber 查看器复核板框闭合与钻孔对位。

# （一级标题）四、关键设计决策与说明

1. 线性稳压 AMS1117 输入电流约等于输出电流，12V 侧典型电流约 75mA，走线按 30mil 加宽以降低回路阻抗；
2. I²C 速率与采样率经时序预算平衡后确定，保证 1kHz 采样周期内完成一次传感数据读取；
3. 绿色 LED 供电为 3.3V GPIO，而绿 LED 正向压降上限 3.6V 高于 3.3V，已在设计文档中记录该器件离散性风险并制定现场预案；
4. 固件不启用 Wi-Fi/蓝牙，避免射频峰值电流导致稳压器过热与开关触点过载；
5. 全部物料均取自组委会物料清单，未外增器件，封装均采用组委会提供的封装库。
