wmsz88/flex-vib-monitor/资料/03_软件与方案/版本讲解/README.md

# 版本讲解（v5 / v6 / v7 / v8 / v9）

> 日期：2026-11-08 · 来源：本机 `代码\vibmon_v6|v7|v8\` 三目录逐文件 diff + 现场修改实操记录（2026-11-08 冷编译实测）
> 2026-11-08 补：发现 `代码\vibmon_v9\`（平放基准时机实验版，由 v6 拷贝），已并入总览与说明书。

| 文档 | 讲什么 |
|---|---|
| [v5到v6逐行讲解.md](v5到v6逐行讲解.md) | v5→v6 的全部改动：接触三条（陀螺为主）+ 两级陀螺低通 + 净转角 + 启停阈值 180/150→120/80 + `#V6` 调试行，只动 `config.h`/`state.cpp`/`state.h`/`output.cpp` 四个文件 |
| [v6到v7逐行讲解.md](v6到v7逐行讲解.md) | v6→v7 的全部改动：`config.h` 三预案宏 + `output.cpp` 黄灯三态/`y` 命令/CSV/分频/门控，逐处给「模块+位置+作用」，附 8 项实操数据 |
| [v7到v8逐文件讲解.md](v7到v8逐文件讲解.md) | v7→v8 的全部改动：新增 `layered_detection` 模块（.h/.cpp 逐段）、`config.h` 9 个 `LAYER_*` 宏、`state.cpp` 旁挂喂数、`output.cpp` `#LAYER` 调试行 |
| [其他改动要求.md](其他改动要求.md) | 除版本讲解已覆盖项外的全部现场改动：总纪律、波特率/CL/静默、接触参数表、量程、三灯、振源占空比/供电、共地/I2C/烧录、换固件流程与变体对照、验证与回退、实操基线 |
| [三列输出改法.md](三列输出改法.md) | 平台只要「固定频率 / 启停 / 接触」三列时的三种改法：砍列定长帧（v6）、CSV 改格式串（v7 一行）、`D` 命令应急，含逐行代码与验收 |
| [指示灯闪烁常亮改法.md](指示灯闪烁常亮改法.md) | 绿灯心跳/常亮（`g` 命令或一行改）、黄灯接触常亮/闪烁 + 振动常亮/闪烁（v7 五态扩法或一行改法表），含闪烁周期公式与 FAULT/CAL 语义红线 |
| [可调参数总表.md](可调参数总表.md) | `config.h` 全部 150 条宏按「现场可能被要求改」分七类（周期帧率/采样DSP窗/幅值/频率/角度/时间常量/硬件配置）+ 危险等级 + 编译期断言联动表，禁改项标红 |
| [v5到v9说明书.md](v5到v9说明书.md) | **五版本整合说明书**：总览关系图、固件信息、模块职责、各版差异速览、判据语义对照、串口命令、测试基线矩阵、修改回退决策表、遗留与禁区（答辩/现场带这一份就够） |

五版本关系一句话：

- **vibmon_v6**：最终版/出发版，上板验收过，归档不动。
- **vibmon_v7**：现场适配参考版 = v6 判据链（逐字节相同）+ 黄灯/`y` + 三预案宏。
- **vibmon_v8**：分层检测实验版 = v6 判据链（逐字节相同）+ 旁挂分层观察层；不继承 v7 的现场件。
- **vibmon_v9**：平放基准时机实验版 = v6 判据链（判据不动）+ `CT_REF_REOPEN_ONLY=1`（张开才重采平放基准，防握物姿态被当零点）；删了 v8 分层件；`contact_test` 93/93（新增 R1/R2）。
- **vibmon_v5**：v6 的前身（加速度为主的接触判据），2026-10-30 冻结归档，只做历史追溯与回退。

考试式问答（四句）：

1. v5→v6 改了哪些文件？`config.h` + `state.cpp` + `state.h` + `output.cpp` 四个；接触判据从「加速度为主」反转为「陀螺先」。
2. v6→v7 改了哪些文件？只 `config.h` + `output.cpp` 两个；判据链 state/dsp/posture/sampler/mpu 一行未动。
3. v8/v9 是 v7 改出来的吗？不是。v7/v8/v9 是并列的三条线，都从 v6 拷贝；v8 加分层检测，v9 改平放基准时机。
4. 出问题怎么退？v6 是底牌；v7/v8/v9 判据链与 v6 相同；v8 把 `LAYERED_DETECT_ENABLE=0`、v9 把 `CT_REF_REOPEN_ONLY=0` 即回 V6 行为，v6 把 `CT_V6_ENABLE=0` 回 v5+T011 行为。
