wmsz88/flex-vib-monitor/vibmon_v4/README.md

# vibmon v4 维护说明

基于 `zlj/sketch_oct12a`（vibmon v1.1）的模块化重构版。核心算法与 v1.1 相同，这一版把它拆成模块，并修了下面列出的问题。`zlj` 原文件没有改动。

> **版本沿革**：v1.1（原始）→ v2（模块化重构 + 若干算法修复）→ v3（烧录版，接触判据用模式 2）→ **v4（本版）**。
> v4 相对 v3 的核心改动是 **Q4 接触判据换成「平放基准 + 三重与」**（见「Q4 接触判据」章节），其余模块同 v3。

当前串口只输出 Arduino 串口绘图器格式（`标签:值`）。比赛帧协议确定后再加，见「以后加比赛帧」。

## 模块划分

| 文件 | 模块 | 负责 | 依赖 |
|---|---|---|---|
| `config.h` | 配置 | 引脚、量程、采样率、滤波参数、阈值、串口参数 | 无 |
| `mpu.h/.cpp` | MPU 驱动 | 初始化、寄存器回读校验、读加速度、I2C 错误计数 | config |
| `sampler.h/.cpp` | 采样 | 1kHz 定时采集、样本序号和时间戳、环形缓冲、丢样和断线检测 | mpu |
| `dsp.h/.cpp` | 信号处理 | 标定、去零偏、高通、RMS 包络、姿态支路、主频估计 | sampler, mpu |
| `state.h/.cpp` | 状态判断 | 振动启停、启停频率、接触状态、结果有效性、超时 | dsp |
| `output.h/.cpp` | 输出 | 绘图行、调试行、LED、串口命令 | 上面全部（只读） |
| `vibmon_v4.ino` | 主程序 | 模块编排：运行、故障恢复、标定 | 全部 |

> **本目录是比赛烧录版（v3）**：已移除 `test/`（主机测试）与 `motor_test`（同板驱动马达的临时调试模块），
> 只保留编译固件所需的最小源码集。测试与调试模块仍在 git 历史 `dc2d2c6` 中（当时的路径是 `vibmon_v2/`），
> 需要时用 `git checkout dc2d2c6 -- vibmon_v2/test vibmon_v2/motor_test.cpp vibmon_v2/motor_test.h` 取回。

数据流：

```text
esp_timer 1kHz → mpuReadAccel → Sample{seq, tUs, raw} → 环形缓冲      (sampler)
loop: samplerPop → 缺样? dspOnGap → dspProcess → DspFrame           (dsp)
      → stateOnFrame / stateTick → Result                          (state)
      → 绘图行 / 调试行 / LED                                        (output)
```

约定：
- 只有 `state` 产生对外结果，`output` 只读 `Result`。
- `Result` 里的 `freqValid`、`ssValid` 为 false 时，对应数值一定是 0。比赛帧直接用 `Result`，不需要再判断。
- 新参数一律加到 `config.h`，不在 .cpp 里写数字常量。

## 本烧录版改进说明（相对 dc2d2c6）

本目录是比赛烧录版，相比上一版 `dc2d2c6` **只做减法与文档整理，未改动任何算法与运行逻辑**。
硬件行为、阈值、判据与 `dc2d2c6` 完全一致。

### 一、代码层面：去掉不参与固件构建的内容

| # | 改进 | 具体做法 | 影响 |
|---|---|---|---|
| 1 | **移除主机测试目录** | 删除 `test/` 共 17 个文件（12 个测试 + `Arduino.h`/`esp_timer.h`/`esp_timer_stub.cpp`/`lock_probe_counters.cpp` 等桩，另有被 gitignore 的 `host_test.exe`） | 这些测试只在 PC 上 `g++` 编译，Arduino 构建本就不会合并它们；删除后目录从 33 个文件降到 14 个 |
| 2 | **移除临时调试模块** | 删除 `motor_test.h/.cpp`（同板驱动马达扫频，`MOTOR_TEST_ENABLE` 默认 0） | 该模块默认就不编译，删掉消除"以为它在工作"的误解，也避免 GPIO3 被误占用 |
| 3 | **清理源码中的悬空引用** | 共 5 处：`.ino` 的 `#include` 与 `setup()/loop()` 两处条件调用；`output.cpp` 的 `#include` 与 `outPollCmd()` 中 `m/H/P/q/r/W` 命令分支 | 纯删除，无逻辑改动。命令表中这些字符改由 `default` 忽略，与原来 `MOTOR_TEST_ENABLE=0` 时的行为**完全等价** |

### 二、文档层面

| # | 改进 | 说明 |
|---|---|---|
| 4 | **模块表标注烧录版性质** | 在模块划分表后增加提示：本目录已移除测试与调试模块，并给出用 `git checkout dc2d2c6 -- ...` 一键取回的方法 |
| 5 | **测试章节改为"如何取回"** | 原文详细列出 12 个测试及编译命令，但目录里已没有 `test/`，照做会失败。改为说明"本烧录版不含 `test/`"+ 取回与运行命令 |
| 6 | **新增本章节** | 让拿到这份代码的人（队友、评委、未来的自己）清楚"这版和上一版的差别只是精简" |

### 三、验证

精简后做了以下检查，确认没有破坏可编译性：

| 检查项 | 方法 | 结果 |
|---|---|---|
| 悬空 include | 扫描全部 `#include "..."` 并检查目标是否存在 | 全部可解析 |
| 编译单元语法 | 用 Arduino/Wire/esp_timer 主机桩，对 `mpu/sampler/dsp/state/output` 五个 `.cpp` 跑 `g++ -std=c++17 -Wall -fsyntax-only` | 5/5 通过，0 error |
| 结构完整性 | 统计 `{`/`}` 与 `#if`/`#endif` 配平；确认 `outPollCmd` 的 `switch` 只有一个 `default` | 64/64、7/7 平衡 |

> **未做的验证**：本机没有 `arduino-cli`，上述检查用的是主机桩，**不等于真实 ESP32 工具链编译**。
> 烧录前请在 Arduino IDE 里实际编译一次。

### 四、如果只想看"改了什么代码"

> 注意：下面命令里的 `vibmon_v2/` 是**历史提交中当时的路径**（目录后来才改名为 `vibmon_v4/`），
> 照抄即可，不要改成 v3，否则 git 找不到对象。

```bash
git diff dc2d2c6 4db2630 --stat          # 文件级：21 个文件，+11 / -4144
git diff dc2d2c6 4db2630 -- vibmon_v2/output.cpp vibmon_v2/vibmon_v2.ino   # 仅有的两处源码改动
```

## 相对 v1.1 的修改

| 问题 | v1.1 的情况 | v2 的处理 | 位置 |
|---|---|---|---|
| RMS 缓冲没有清空 | `resetPipeline` 把累计和清零了，`g_envBuf` 里还是旧数据，之后累计和对不上，可能变成负数，`sqrtf` 得到 NaN | 重置时清空缓冲；每轮重新求和，消除浮点累积误差；开方前限制为非负 | `dsp.cpp envReset / dspProcess` |
| 初始化写入没有检查 | `mpuWrite` 的返回值被丢掉 | 每次写入都检查，写完逐个回读比对，失败时报告寄存器地址 | `mpu.cpp mpuInit` |
| 样本没有时间信息 | 缓冲里只有 xyz | 每个样本带节拍序号和 `micros()`。序号断开或间隔偏离超过 0.5ms 视为不连续 | `sampler.cpp` |
| 丢样后照常算 | 缺样的数据仍当作等间隔窗口算主频 | 不连续时清空窗口，重新攒满 128 个连续样本才出主频；缺超过 20 个样本时滤波器和包络也重置 | `dsp.cpp dspOnGap` |
| 启停频率统计方式 | 8s 窗内的边沿数除以时间跨度，没有超时，一次误触发就会拉偏结果 | 相邻"起"边沿算周期，取最近 4 个周期的中位数；至少 2 个周期才出数；周期最大/最小超过 1.5 倍判为节奏不稳；超过 2 倍当前周期没有新边沿就失效 | `state.cpp ss*` |
| 主频旧值 | 只在窗口计算时更新 | 振动停止立即清零；结果超过 300ms 没更新也清零 | `state.cpp stateTick` |
| 运行中断线 | 读失败时直接 return，一直输出最后一次的读数 | 连续 20 次读失败或 100ms 没有新样本就进入故障：清零结果，LED 快闪，每秒尝试重连，恢复后沿用原标定 | `sampler.cpp samplerSensorLost`，`.ino enterFault` |
| NaN 进入输出 | 没有检查 | 滤波输出出现非有限值时重置流水线；主频和启停频率都检查 `isfinite`；输出前再过一遍 `fin()` | `dsp.cpp`，`state.cpp`，`output.cpp` |
| 接触判据 | 原始数据减零偏后的模长做 EMA，振动本身会把它抬高；状态没有滞回 | 先对每个轴低通，再求模长，振动分量基本被去掉；加了滞回和 100ms 确认。**判据默认 `CT_MODE=2`：以「接触姿态」为参考点求三轴距离**（旧模式 0/1 相对"标定姿态"，实测会全程误报，保留做对比） | `dsp.cpp` 姿态支路，`state.cpp ctStep` / `stateStartTouchRef` |
| 标定质量 | 没有检查 | 记录阶段A 的标准差和零偏模长，标定时被碰过会提示"可疑" | `dsp.cpp dspCalibrate` |
| 削顶 | 没有检查 | 统计 \|raw\| > 32700 的样本数，在调试行里显示 | `dsp.cpp` |
| 回调属性 | `IRAM_ATTR` 加在会调用 Wire 的 esp_timer 回调上 | 去掉，显式指定 `ESP_TIMER_TASK` | `sampler.cpp` |

## 使用

### 编译和烧录

- 开发板选 ESP32C3 Dev Module，esp32 核心 3.3.12（已验证）
- 看哪个口：
  - **USB CDC On Boot = Enabled**：`Serial` 走 USB，直接用 USB 线看。三轴波形（绘图组 4）只能在这种模式下用。
  - **Disabled**：`Serial` 走 GPIO21(TX)/GPIO20(RX)，接 USB-TTL 模块看。
- 命令行：

```bash
arduino-cli compile -b esp32:esp32:esp32c3 --warnings all vibmon_v4
arduino-cli compile -b esp32:esp32:esp32c3:CDCOnBoot=cdc --warnings all vibmon_v4
```

上电后先标定 3.2s（绿灯和黄灯常亮），**这段时间不要碰模块**。

### 串口绘图器

打开 Arduino IDE 的「工具 → 串口绘图器」，波特率 115200。在输入框里发命令切换显示内容：

| 命令 | 显示 | 用途 |
|---|---|---|
| `1`（默认） | `Freq_Hz`、`Amp_mg`、`SS_Hz_x10`、`Vib_x50`、`Contact_x100` | 总览。启停频率乘 10、振动和接触状态放大，方便和主频画在同一坐标里 |
| `2` | 包络、启停高/低阈值、振动状态 | 调 `TH_HI_K` / `TH_LO_K` |
| `3` | 姿态偏差、接触阈值、接触状态 | 采接触实测数据，调 `CT_*` |
| `4` | 高通后的 X/Y/Z 波形，1kHz | 看原始振动、谐波、削顶（需要 USB CDC） |
| `0` | 关闭绘图 | |

其他命令（文字信息会打乱绘图，看文字时请用串口监视器）：

| 命令 | 作用 |
|---|---|
| `d` | 5Hz 调试文字行（自动关闭绘图）。`(x)` 表示该值无效 |
| `S` | 状态汇总：结果、各项统计、标定参数 |
| `c` | 重新标定（须静置） |
| `n` | 清零统计 |
| **`t`** | **记录接触姿态参考点**（握住测试件时按，等 0.8 秒）|
| **`t0`** | 清除接触姿态参考点（换机械手/工位时用）|
| `k0`~`k6` | 打标模式（仅输出 CSV，用于采接触判据数据）|
| `K` | 退出打标模式 |
| `?` | 帮助 |

**⚠️ 接触判据的现场流程**（`CT_MODE=2`）：

```
上电 → 自动标定 3.2 秒（必须静置）
     → 握住测试件 → 按 t → 等 0.8 秒
     → 松开，状态应显示"接触 0(可信)"
     → 开始测试
```

**每次重新标定（`c`）后必须重按 `t`** —— 标定改变零偏，
旧参考点不在同一坐标系，固件会自动清除它（`contactValid` 同步回 false）。

### LED

| 状态 | 绿 | 黄 |
|---|---|---|
| 正常 | 1Hz 闪 | 振动中常亮 |
| 标定中 | 常亮 | 常亮 |
| 传感器故障 | 灭 | 4Hz 快闪 |

## Q4 接触判据（v4 重点改动）

### 为什么又改了一次

v3 用的是模式 2：**先握住测试件记一个"接触姿态"参考点，之后判断当前姿态离它多远**。

问题出在"完全握住但没有物体"这个状态 —— 手是合上的、抖动幅度可能是全场最大，
但**根本没有物体可夹**。这时：

- 机械手确实做了"接触动作"，但物理上没有接触；
- 更致命的是：这时都没有可抓的物体，**参考点根本记不下来**，
  判据直接失效（`contactValid = false`），整段数据只能丢掉。

所以 v4 把参考基准换成了**平放姿态** —— 平放永远存在，不需要抓着任何东西就能采到。

### 三态分析：为什么光看姿态和幅值分不开

| 状态 | 姿态（到平放距离） | 幅值 | 频率 |
|---|---|---|---|
| ① 平放未握 | 小（≈0） | 有（地面振动上限） | 低 |
| ② 完全握住但没夹到物体（空夹） | **大** | **可能最大** | **偏低** |
| ③ 握住有物体 | 大 | 共振 | **≈物体固有频率** |

结论：**姿态只能分开 ①，分不开 ② 和 ③；幅值也分不开（②可能比③还大）。
只有频率能把 ② 和 ③ 分开** —— 空夹没有物体共振，频率上不去。

### v4 的判据：三条同时成立

```
contact = 姿态过门 && 幅值过门 && 频率过门
```

1. **姿态**：`到平放姿态距离 > CT_FLAT_D_ON_MG`（退出 < OFF）
   —— 排除"平放没握"。
2. **幅值**：`ampValid && amp > CT_FLAT_A_ON_MG`（退出 < OFF）
   —— 排除"握手了但完全静止"，不承担区分空夹的职责。
3. **频率**：`freqValid && freq > CT_FLAT_F_ON_HZ`（退出 < OFF）
   —— **区分空夹与真接触的唯一依据**。

进入需要三路全真（宁缺勿滥）；退出只需 `姿态 && (幅值 || 频率)` 任一失效，
这样可以避免某一通道瞬断导致接触被反复判掉。

### 空夹诊断

调试行里出现 `空夹?` 表示：**姿态已握下 + 有可信幅值 + 频率门没通过**。
即手合上了、在抖，却没有物体共振特征 —— 最可能是没夹到东西。

若幅值本身无效/极低，那报的是"握住静止"而不是空夹，两者处置不同：
空夹要调整物体位置，静止要检查激励。

### 阈值必须先实测

`config.h` 里模式 3 的六个阈值全部标了 `TODO(实测)`，**是占位值，不可信**。
v3 的 `CT_TOUCH_MG 400` 是"到接触姿态"的距离，与 v4 的"到平放姿态"距离量纲不同，
**不能直接搬过来用**。

采样步骤（每种状态至少 60 秒）：

1. 烧录后保持**平放静置** 60s，看调试行的 `平放到 … mg`、幅值、频率，记三个量的范围；
2. 让机械手**完全握住但不夹物体**（空夹）60s，记三个量的范围；
3. **握住并夹住测试件** 60s，记三个量的范围 —— 重点看频率比空夹高多少；
4. **松开** 30s，确认各量回落到状态 ① 的范围。

然后按"取两种状态典型值之间、且离噪声边界有余量"的原则填：

- `CT_FLAT_D_ON_MG` / `OFF`：填状态 ① 上限与状态 ② 下限之间；
- `CT_FLAT_F_ON_HZ` / `OFF`：填状态 ② 上限与状态 ③ 下限之间（**这一组最关键**）；
- `CT_FLAT_A_ON_MG` / `OFF`：填"握手静止"与正常抖动之间，只用于排除静止。

填完再跑一轮四态，确认 ② 判 `contact=0 空夹?`、③ 判 `contact=1`。

### 平放基准的采集

- 自动：上电后自动采集，采不到会自动重试 `CT_REF_AUTO_RETRY` 次；
- 手动：串口发 `t`（设备**平放**时）；`t0` 清除基准。
- 采集分两阶段：先稳定 `CT_REF_SETTLE_MS`，再平均 `CT_REF_AVG_MS`；
  期间三轴极差超过 `CT_REF_MAX_SWING_MG` 会**丢弃本次结果**并重试
  —— 采基准时设备在动的话，采到的平均姿态是错的。
- 基准在 `stateReset()` 之后**保留**（它是工位物理事实，不是一次测量）；
  只有重新标定（`c` 命令）才会让它失效。

## 验证状态（务必如实对外表述）

| 项目 | 状态 |
|---|---|
| ESP32C3 真实工具链编译（模式 3） | **通过**，361088 B（27%，CDC 版），全局变量 25940 B（7%），0 error 0 warning（2026-10-29 复验） |
| 模式 0/1/2 回归编译 | **通过**（四套 `CT_MODE` 全部能编） |
| 主机测试回归 | **通过**，见 §测试（2026-10-28 从 `dc2d2c6` 取回 `test/` 链 v4 源码重跑） |
| **实板三态验证** | **通过**（2026-10-29）：松手 `ct=0`、握紧无物 `ct=0`（`空夹?=1`）、接触+振动 `ct=1` 且 `F`=178.4Hz |
| **判据锁死 bug** | **已修**（2026-10-29）：`ctStep()` 中数据失效时清零 `s_ampHeld`/`s_freqHeld`，并把 `CT_FLAT_DEGRADE_STRICT` 默认改 1 |
| 六个阈值 | **仍是占位值**，`D`/`A`/`F` 的实测分布见 `进度.md` §8 |
| 接触但目标物不振 | **物理不可分**（实测），需两轴独立输出才能支持，见 `进度.md` §4.2 M2 |

> **未做的验证**：以上只有编译验证。判据能否真的分开"空夹"和"真接触"，
> 取决于频率在两种状态下的实际差距 —— 这个只能用实板四态采样回答，
> 代码里任何占位阈值都不构成证据。

> 主机回归的完整结果表、编译需要的 `-D` 开关、以及踩过的两个坑见 `实测记录.md` §3；
> 实板采样的流程与空白数据表见 `实测记录.md` §4~§5。

## 调参

参数都在 `config.h`。常用的几个：

| 现象 | 先看 | 调整 |
|---|---|---|
| 振动时 `Vib` 不起来，或静止时误报 | 绘图组 2 | `TH_HI_K`、`TH_LO_K`、`TH_*_MIN_MG` |
| 振动时主频时有时无 | 绘图组 4 看幅值；`S` 看 `zcl` | `ZCL_K` 调小（弱信号），`MIN_PERIODS` |
| 主频跳到 2 倍频 | 绘图组 4 看波形是否畸变 | 需要实测，可能要加 FFT 辅助 |
| 不连续计数一直增长 | `S` 看"不连续"和"读失败" | `I2C_CLOCK` 降到 100k，或 `FS_HZ` 降到 500（`FREQ_HI_HZ` 也要相应调整） |
| 启停频率出不来 | 调试行 `SS=…(x)` | `SS_CONSIST_RATIO` 放宽，`SS_T_MIN_MS`/`SS_T_MAX_MS` |
| 接触误判（平放被当成接触） | 调试行 `平放到 … mg` 与 `[V/-]` 标记 | 模式 3：`CT_FLAT_D_ON_MG`/`CT_FLAT_D_OFF_MG`；先确认基准已采到（`t` 可手动重采） |
| 空夹被判成接触 | 调试行 `空夹?` 与频率 `[V/-]` | 模式 3：`CT_FLAT_F_ON_HZ`/`CT_FLAT_F_OFF_HZ`（**专治空夹的关键阈值**，先按四态实测采样） |
| 基准采不到（提示"自动采集 N 次均判定为在动"） | 调试行基准极差 | 模式 3：放稳后按 `t` 重采；必要时放宽 `CT_REF_MAX_SWING_MG`、加长 `CT_REF_AVG_MS` |
| 接触误判（模式 2） | `S` 看"到接触姿态"距离 | 仅 CT_MODE=2 时用：`CT_TOUCH_MG`/`CT_TOUCH_OFF_MG`；先确认已按 `t` 记录参考点 |

## 测试

**本烧录版不包含 `test/`。** 主机测试在开发时用于验证 dsp/state 算法，它们只在本机编译运行、
从不参与固件构建，因此已从本目录移除以保持烧录包干净。原始测试套件（12 个，链接真实源码）
仍在 git 历史 `dc2d2c6` 中，需要回归时取回：

```bash
git checkout dc2d2c6 -- vibmon_v2/test        # 历史路径，取回后 test/ 会落在当前目录
cd vibmon_v4 && g++ -std=c++17 -Wall -I test -I . test/host_test.cpp dsp.cpp state.cpp -o test/host_test.exe
./test/host_test.exe
```

`ct_test` 需按判据模式分别编译：`CT_MODE=2/0/1` 三次（判据方向相反，各模式分别断言），
外加默认的 `CT_MODE=3`（v4 当前默认）。四次的结果都记在 `实测记录.md` §3.2。

其余测试需要额外的 `-D` 才能链上（漏了会报 `not declared in this scope`），
以及 `lock_probe` 必须带 `-DSMP_LOCK_PROBE` —— 完整命令表见 `实测记录.md` §3.4。

各测试的编译命令与 2026-10-28 的实际结果见 `实测记录.md` §3。

> **`ct_test` 在 `CT_MODE=3` 下有 6 项断言失败，这是预期的**：T10a/b/c/f/g 只喂姿态、
> 不喂幅值与频率，而模式 3 要求三重与，"握住但静止"按设计就不该判接触。
> 默认编译（即 `CT_MODE=3`）会看到 `6/23 项失败`，**不要误读成回归**。
> 需要验模式 3 本身时，得给 `step()` 补上 `vibAmpMg` 与 `freqHz` 再断言。

## 还没解决的问题

按"已实现 / 待实测 / 未实现"三类严格区分，**不把待实测写成已达标**。

| # | 项目 | 状态 | 说明 |
|---|---|---|---|
| 1 | **接触识别** | ⚠️ **模式 3 待实测** | 当前默认 `CT_MODE=3`（平放基准 + 三重与），**六个阈值全是占位值，未上板验证**。历史结论「判据 = 到接触姿态距离 < 400mg，实机 99.13% 零误报，握住 ≈0~50mg、松开 ≈1082~1750mg」属于 **v3 的 `CT_MODE=2`**，量纲不同、不可直接搬到模式 3。其中一条实测观察仍然成立且很关键：**姿态变化主要由指关节旋转引起，轻触不转测不到**。原始数据文档已不在仓库内，见 `实测记录.md` §2 |
| 2 | 主频抗谐波 | ⚠️ **主机已验证，待实测** | 20% 二/三次谐波 × 5 相位全部算对基频，无需 FFT。实板未验 |
| 3 | 采样时钟拍频 | ⚠️ **待实测** | 用 `T` 命令看 `spanUsMax-Min`；若抖动偏大把 `MPU_CLKSEL` 改 1（PLL） |
| 4 | 比赛帧 | ⚠️ **通道已就绪，帧未启用** | UART1 独立通道已建（`PIN_COMP_TX/RX`），但 `COMP_FRAME_ENABLED=0`，比赛口**完全静默**。等帧口径与对接方确认 |
| 5 | 边沿时间精度 | ✅ **主机已验证** | 阈值穿越插值把快/慢上升沿的周期差从 20~30ms 降到 0ms |
| 6 | 全部实板项 | ⚠️ **待实测** | 采样流程与数据表见 `实测记录.md` |
| 7 | ±2Hz、0.5s | ℹ️ 工程目标 | **不是官方公布的考核标准** |

## 测量能力边界（对外表述以此为准）

不要写"支持任意非零频率"或"覆盖整个加速度带宽"。准确的范围如下：

| 项目 | 赛题要求 | 内部可测（容错带） | 硬边界 |
|---|---|---|---|
| 持续振动 | 80~180 Hz | 60~220 Hz | `FREQ_LO_HZ`/`FREQ_HI_HZ` |
| 启停频率 | 0~3 Hz | 0.1~5 Hz | `SS_T_MAX_MS=12000` → 最低 0.083Hz |

- **0 Hz 启停**表示"没有周期启停"，此时 `ssValid=false`，**不是**"测得 0Hz"。持续振动和完全静止都不报启停频率。
- **低于 0.083Hz** 需要延长观察窗口，当前配置会把超长间隔当作"新一轮"，不报读数。
- **220Hz 以上**不作保证：周期过滤会在边界处泄漏，可能给出一个被截断的读数（偏离真实值 1.5Hz 以上），不会伪装成准确值。
- 以上是**算法能力**，不是赛题承诺。对外只承诺 80~180Hz / ±2Hz。

## 参数与自检

`config.h` 末尾有 28 条编译期检查，覆盖采样率、窗口关系、奈奎斯特、启停周期顺序、DLPF 带宽、索引容量等。
改错宏会**立即编译报错**而不是烧进去才发现。

大部分核心参数带 `#ifndef` 守卫，因此命令行 `-D` 可以覆盖，便于做对比实验：

```bash
arduino-cli compile -b esp32:esp32:esp32c3 --build-property "compiler.cpp.extra_flags=-DCT_MODE=1" vibmon_v4
```

`_probe/check_params.ps1` 曾用于自动验证这批检查（10 个错误用例都应被拦住），
但该脚本**不在当前仓库内**（`_probe/` 下目前只有 `capture_measure.py`）。
在补回之前，改宏后请用一次完整编译代替跑脚本：编译期检查会在 `arduino-cli compile` 时全部生效。

## 比赛帧

UART1 独立通道已就绪，与调试口完全解耦（`output.cpp compBegin`）。引脚在 `config.h` 的 `PIN_COMP_TX/PIN_COMP_RX`，
**改引脚只需改这两行**。

**当前 `COMP_FRAME_ENABLED=0`：比赛口一个字节都不发。** 这是有意的——帧口径确定前不发半成品，
避免平台误解析。状态报告走调试口：

```
[COMP] UART1 ready TX=21 RX=20 baud=115200，帧输出 关闭（协议未定）
```

帧格式（35 字节，`compBuildFrame` 已实现并经 `comp_test` 验证）：

```
$VD,SEQ,FREQx10,AMP_MG,VIB,CT,SSx100,VALID,CHK\r\n
```

`VALID` 位图：bit0=`ampValid`、bit1=`freqValid`、bit2=`ssValid`、bit3=`contactValid`。
**无效量一律发 0，靠 VALID 位区分"未知"与"测得 0"**——这是清单 A1 的核心要求。

启用后可用 `_probe/comp_sniff.py` 校验串口输出 —— **该脚本当前也不在仓库内**，
需要先补回或在 `COMP_FRAME_ENABLED=1` 后临时用串口监视器人工核对：

```bash
python _probe/comp_sniff.py COM5 115200 --secs 60
python _probe/comp_sniff.py --file dump.txt      # 离线校验
```

它会检查帧格式、XOR 校验、序号连续性、`VALID` 与数值的语义一致性，
并报出任何混入比赛口的调试文字（横幅/标定/绘图/帮助）。
