wmsz88/flex-vib-monitor/vibmon_v5/代码测试报告_20261102.md

# vibmon_v5 代码测试报告（2026-11-02）

> 仓库：`D:\大学\课程\工科赛\代码`
> 测试对象：`vibmon_v5` 当前工作区
> 代码基线：`101a395`（`chore(vibmon_v5): finish third-round cleanup`）
> 本轮结论：宿主机三套测试全过；发现 2 处 P2 语义差异；未改固件代码。
>
> 修复更新（同日后续）：FINDING-01/04 已在 `state.cpp` 修复，
> `contact_test` 的 C1/C3/C12 断言已改回语义期望，宿主测试 43/43，
> 双 FQBN 0 warning。详见 §8。

## 1. 工作区状态（测试前）

本轮测试针对当前工作区，不是干净的 `101a395`：

```text
M vibmon_v5/config.h
D vibmon_v5/比赛现场代码修改说明.md
?? vibmon_v5/test/contact_test.cpp   （本轮新增）
?? uart_loopback/
?? vib_range_test/
?? vibmon_v5/data/...                （未跟踪实测数据）
```

`config.h` 的工作区改动：

```diff
#define UART_SWAP      1
#define COMP_FRAME_ENABLED 1
```

也就是说，本轮双 FQBN 编译和主机测试是在“调试口交换 + 比赛帧开启”的配置下跑的。
这与文档里“`COMP_FRAME_ENABLED` 默认 0、比赛口静默”的描述不同，冻结前需要确认。

## 2. 宿主测试结果

编译统一使用：

```powershell
g++ -std=c++17 -Wall ...
```

| 测试 | 命令/入口 | 结果 | 说明 |
|---|---|---:|---|
| 陀螺积分与状态 | `test\gyro_test.exe` | 8/8 | G1/G3/G5/G5b/G5c/G6/G7 |
| 比赛帧编码 | `test\comp_frame_test.exe` | 22/22 | 帧格式、字段宽度、校验和、缓冲保护 |
| 接触判据状态机 | `test\contact_test.exe` | 43/43 | 本轮新增，见 §3 |
| 事件离线分析 | `python _probe\event_analyze.py --selftest` | 11/11 | 16 列 label CSV、平台角、回落稳定窗口 |
| 采集统计链路 | `python _probe\capture_measure.py --selftest` | 13/13 | 解析、统计、label CSV、EV/注释 |

三套 C++ 测试编译均 0 warning。

## 3. 新增 `contact_test` 覆盖内容

文件：`vibmon_v5/test/contact_test.cpp`

它直接用合成 `DspFrame` 驱动 `state.cpp`，不经过 `dsp.cpp`，因此只验证状态机
逻辑，不验证真实测频精度。覆盖：

1. 没有平放基准时的当前行为（C1）；
2. 稳定采集平放基准成功（C2）；
3. 采集期间在动，基准被拒绝（C3）；
4. 角度不足、三路全过（C4/C5）；
5. 角度滞回退出（C6）；
6. 幅值门 400mg 严格大于边界（C7）；
7. 频率门 75Hz 严格大于边界与 80Hz 下限（C8/C8b）；
8. contact 保持规则：姿态仍在且 A/F 有一路仍在（C9）；
9. 频率滞回 63Hz 与两路都掉后的退出（C10）；
10. 削顶/主频失效时的降级与退出（C11）；
11. 陀螺中断后 `angleValid`/`contactValid`/`contact` 归一（C12）；
12. 空夹诊断 `gripNoObject`（C13）；
13. 接触确认延时 100ms（C14）。

## 4. 问题清单

### P2 / FINDING-01：`CT_MODE=4` 缺少 `flatRefSet` 门控

**现象（可复现）**：没有采到平放基准、或基准采集因“在动”被拒绝后，只要来一帧
带陀螺的 `DspFrame`，`contactValid` 就变成 `1`，而 `flatRefSet` 仍为 `0`。

**证据**：

```text
[PASS] C1 未采基准：flatRefSet=0
[PASS] C1 未采基准：当前实现 contactValid=1（FINDING-01，文档约定为 0）
[PASS] C3 采集在动：flatRefSet=0
[PASS] C3 采集在动：当前实现 contactValid=1（FINDING-01，文档约定为 0）
```

**根因位置**：

```text
state.cpp:351  static bool postureInput(...)
state.cpp:352  #if CT_MODE == 4
state.cpp:354    return s_r.angleValid;      // 没检查 s_flatRefSet
state.cpp:372  if (!postureInput(...)) { ... contactValid=false; return; }
state.cpp:427  s_r.contactValid = true;      // 三门输入可用即置 true
state.cpp:630  flatRefCommit() 里 flatRefSet 才置 true
state.h:24     contactValid 注释只写了 CT_MODE=2/3 的语义
```

**影响**：

- 上电后约 0.8s 基准采集窗口内，或基准采集失败时，`contact=0` 会被标成
  “结论可信”；
- 如果设备上电时已经夹住，闭合角从 0 起算，可能输出 `closed=0` 且
  `contactValid=1`；
- 模式 3 的约定是“没有可信基准不得输出接触结论”，模式 4 当前行为与该约定
  不一致。

**建议**：二选一，但只选一个，避免双重门控：

1. 推荐：在 `postureInput()` 的 `CT_MODE == 4` 分支返回
   `s_r.angleValid && s_flatRefSet`；
2. 或者：保持 `postureInput()` 只回 `angleValid`，但在 `ctStep` 进入三门前
   单独用 `s_flatRefSet` 判断，不通过则按现在的早退块置
   `contact=0, contactValid=false`。

修改后需要：

- 把本报告 C1/C3 的期望改回“`contactValid=0`”；
- 重跑 `gyro_test`、`comp_frame_test`、`contact_test`；
- 重跑双 FQBN 编译，确认 0 warning。

### P2 / FINDING-04：判据输入失效时 `closed` 保留旧值

**现象（可复现）**：先建立 `contact=1`，再让陀螺中断超过 `GYRO_STALE_MS`，
`angleValid`/`contactValid` 都会归零，`contact` 也会变 0，但 `closed` 仍保持
上一轮的 `1`。

**证据**：

```text
[PASS] C12 陀螺失效：angleValid=0
[PASS] C12 陀螺失效：contactValid=0
[PASS] C12 陀螺失效：contact=0
[PASS] C12 陀螺失效：当前实现 closed=1（FINDING-04，语义应为 0）
```

**根因位置**：

```text
state.cpp:372  if (!postureInput(...)) {
state.cpp:376    s_r.contact = 0;
state.cpp:384    s_r.contactValid = false;
state.cpp:385    return;                 // 没有写 s_r.closed = false
state.cpp:445  s_r.closed = (s_ctPostCmd != 0);  // 只在三门路径里更新
```

`closed` 全工程只有 `state.cpp:445` 一处赋值；判据输入不可用时走早退块，
所以它不会被更新，保留上一轮的值。

**影响**：

- 调试口 `S` / 运行状态会显示 `closed=1, contact=0, contactValid=0`；
- 上电未采基准（FINDING-01）或陀螺中断时，上位机若只看 `closed` 会以为
  “姿态门仍成立”；
- 比赛帧不直接编码 `closed`，所以不影响 `$VD` 帧字段，但影响现场判读。

**建议**：在 `state.cpp:372` 的早退块里补一行：

```c
s_r.closed = false;
```

若同时采纳 FINDING-01，这里还应考虑把 `s_ctPostCmd = 0;` 一起清掉，
让下次判据恢复后重新过姿态门，而不是沿用中断前的门状态。

### P3 / FINDING-02：文档未写清 `CT_MODE=4` 的 `contactValid` 语义

`state.h` 的 `contactValid` 注释只列了 `CT_MODE=2` 和 `CT_MODE=3`；
README §3.5 的判据也只写了 `closed = angleValid && theta > 60°`，没有写
`contactValid` 是否要求 `flatRefSet`。建议在 FINDING-01 定案后同步补文档。

### P3 / FINDING-03：工作区配置与文档描述不一致

当前工作区已改为：

```text
UART_SWAP=1
COMP_FRAME_ENABLED=1
```

而 README / `当前状态.md` 仍写“`COMP_FRAME_ENABLED` 默认 0、比赛口静默”。
如果这就是比赛配置，需要更新文档；如果不是，冻结前要改回 0 并重烧。

## 5. 双 FQBN 编译

```powershell
$cli = "C:\Users\Lenovo\AppData\Local\Programs\Arduino IDE\resources\app\lib\backend\resources\arduino-cli.exe"
$src = "D:\大学\课程\工科赛\代码\vibmon_v5"

& $cli compile --fqbn "esp32:esp32:esp32c3:CDCOnBoot=cdc" $src --warnings all
& $cli compile --fqbn "esp32:esp32:esp32c3" $src --warnings all
```

结果：

```text
CDC 构建:    369800 B Flash / 30268 B RAM / 0 warning
非 CDC 构建: 364692 B Flash / 30092 B RAM / 0 warning
```

与 2026-10-31 记录的 0 版相比：

```text
CDC:    368804 -> 369800 B (+996 B)；RAM 30260 -> 30268 B (+8 B)
非 CDC: 363604 -> 364692 B (+1088 B)；RAM 30084 -> 30092 B (+8 B)
```

增量与当前工作区打开比赛帧/交换调试口的配置改动在同一时间点出现，具体归属
未逐项归因；冻结前需要把配置和文档一起定版。

## 6. 本轮未覆盖 / 残余风险

- `contact_test` 是合成 `DspFrame`，没有经过 `dsp.cpp` 的真实 RMS、过零、
  主频估计链路；
- 80Hz / 180Hz 实板边界仍无抽样，现有实证只有 157.8~179Hz、165~167Hz；
- 5cm C6 正向用例、5 轮重复性、T1 现场项仍因无板暂停；
- MPU6050 间歇 I2C 掉线问题未在代码侧解决。

## 7. 推荐顺序

1. 先决定 FINDING-01：`CT_MODE=4` 是否用 `flatRefSet` 门控
   `contactValid`/`closed`。建议修，改动小且能消除“无基准却标可信”的窗口。
2. 同时修 FINDING-04：在 `ctStep` 早退块补 `s_r.closed = false;`，并评估
   是否一并清 `s_ctPostCmd`。建议和 FINDING-01 一起改，避免多次回归。
3. 改完把 C1/C3/C12 断言改回语义期望值，重跑三套宿主测试 + 双 FQBN。
4. 确认 `UART_SWAP=1`、`COMP_FRAME_ENABLED=1` 是否为最终比赛配置；
   同步 README / `当前状态.md`。
5. 硬件恢复后按原计划补 80/180Hz、5cm C6、5 轮重复性、T1。

## 8. 修复记录（2026-11-02 后续）

| 项 | 处理 | 位置 |
|---|---|---|
| FINDING-01 | `CT_MODE=4` 的 `postureInput()` 改为返回 `s_r.angleValid && s_flatRefSet` | `state.cpp` |
| FINDING-04 | 判据输入不可用时清 `s_r.closed`、`s_ctPostCmd`、`s_ampHeld`、`s_freqHeld` | `state.cpp` |
| 测试同步 | C1/C3 期望 `contactValid=0`，C12 期望 `closed=0` | `test/contact_test.cpp` |

回归结果：

```text
gyro_test:        8/8
comp_frame_test:  22/22
contact_test:     43/43
CDC 构建:         369822 B Flash / 30268 B RAM / 0 warning
非 CDC 构建:      364714 B Flash / 30092 B RAM / 0 warning
```
