wmsz88/flex-vib-monitor/vibmon_v5/当前状态.md

# vibmon_v5 当前状态

> **记录日期**：2026-10-31
> **代码基线**：`a628014`（后续评审修复见最新提交）
> **装贴**：检测模块贴**中指指甲盖**，手指**背放**
> **振源**：独立板 `vibsource`，COM7；检测模块串口 COM8，115200
> **定位**：v5 是候选版本，不是已经完成全部统计验收的最终版
> **当前状态**：测试暂停（无备用板）；MPU6050 I2C 间歇掉线未解决

**冻结基线归档**

- 数据备份：`D:\大学\课程\工科赛\_backups\vibmon_v5_data_baada54_20261030.zip`
- 数据清单：同目录 `.sha256.txt`
- 数据规模：257 个文件，33959491 B；压缩包 SHA256 `0F628983FAD18BBC4D508EA11A9C1C8B36CDFC704EA6101D64E7FD39E8292FC6`
- 主机测试：`gyro_test` 6/6
- CDC 构建：368992 B Flash / 30268 B RAM / 0 warning
- 非 CDC 构建：363802 B Flash / 30092 B RAM / 0 warning
- C1/C3/C5/C6 实板回归：COM7 振源当前未在线，待补测

### 冻结版实板回归（2026-10-30）

使用冻结版固件短采 12 s/格：

| 格 | 条件 | contact 统计 | A 中位数 | F 有效条数 | 结论 |
|:--:|---|---:|---:|---:|:--:|
| C1 | 松手、振源关 | 0/46 | 5.7 mg | 0 | 通过 |
| C3 | 夹空气、振源关 | 0/46 | 6.2 mg | 2（低幅假频） | 通过 |
| C5 | 静止 4 cm、振源关 | 0/46 | 6.1 mg | 46（但 A≪400） | 符合设计 |
| C6 | 转动源、应接触 | 0/46 | 6.1 mg | 1 | **未耦合，待重做** |
| C6b | 转动源重试 | 0/46 | 5.9 mg | 0 | **未耦合，待重做** |
| C6c | 转动源重试 2 | 0/58 | 5.9 mg | 0 | **未耦合，D=4~55 mg** |

C1/C3/C5 证明姿态诊断未破坏原有接触判据；C6 两次 A 都只有约 6 mg，
说明模块没有真正压住转动源，不能用于反证主判据。

---

## 1. 版本与验证结果

| 项目 | 结果 |
|---|---|
| 主版本 | `vibmon_v5`，`CT_MODE=4` |
| 判据 | 陀螺积分闭合角判"松手/已闭合"；幅值 A + 主频 F 判"是否有振动接触" |
| 主机测试 | `gyro_test` 8/8；`comp_frame_test` 22/22 |
| 固件编译 | CDC 368804 B / 30260 B；非 CDC 363604 B / 30084 B，均 0 warning |
| 实板验证 | 单轮接触/启停通过；5 轮重复性未通过（I2C 间歇掉线） |
| 回退版本 | v4（`CT_MODE=3`），再回退 v3（`CT_MODE=2`） |

编译目标必须使用 `esp32:esp32:esp32c3:CDCOnBoot=cdc`，否则 USB CDC 串口不工作。

---

## 2. 当前生效参数

| 宏 | 值 | 含义 |
|---|---:|---|
| `GYRO_FS_SEL` | 1 | 陀螺量程 ±500 dps |
| `GYRO_DIV` | 4 | 陀螺 250 Hz，积分步长 4 ms |
| `GYRO_DEADBAND_DPS` | 1.5 | 小于此角速度视为静止 |
| `GYRO_STILL_MS` | 500 | 连续静止多久才认定停住 |
| `ANGLE_CLOSED_DEG` / `ANGLE_CLOSED_OFF_DEG` | 60 / 45 | 闭合进入/滞回退出角 |
| `OPEN_D_MG` | 400 | 判断回到张开位置的重力偏差门限 |
| `CT_FLAT_A_ON_MG` / `OFF` | 400 / 300 | 振动幅值进入/退出门限 |
| `CT_FLAT_F_ON_HZ` / `OFF` | 75 / 63 | 主频进入/退出门限，留 5Hz 测频余量 |
| `AUTO_ZERO_ENABLE` | 1 | 每轮闭合后自动重采一次基准 |
| `AUTO_ZERO_REST_MS` | 2000 | 自动重采要求的静止时间 |
| `AUTO_ZERO_AMP_MG` | 100 | 自动重采要求的幅值上限 |
| `AUTO_ZERO_ANGLE_DEG` | 8 | 自动重采要求的闭合角上限 |

---

## 3. 实板四格数据

| 格 | 条件 | `ang` | `A` (mg) | `F` (Hz) | `ct` | `grip` | 真值 | 结论 |
|:--:|---|---:|---:|---|:--:|:--:|:--:|:--:|
| C1 | 松手 | 0 | 5.3 | 无效 | 0 | 0 | 0 | 通过 |
| C3 | 夹空气、马达关 | 96~123 | 5~304 | 假频 86~169 | 0（15/15） | 0* | 0 | 通过 |
| C5 | 压住静止物体 | 91~116 | 8~209 | 无效 | 0 | 0* | 0 | 符合设计 |
| C6 | 压住转动马达 | 96~162 | 500~1152 | 157.8~179.0 | 1（15/15） | 0 | 1 | 通过 |

### 数据说明

- 松手与闭合的角度余量很大：松手约 0°，闭合约 90~160°。
- 空夹的幅值最坏瞬态曾到 304 mg，但频率无效；真接触幅值 500~1152 mg，且主频 157.8~179 Hz。
- C5 是"压住不振动的物体"，物理上没有振动证据，因此 `ct=0` 是当前设计的预期结果，不是漏检 bug。
- `grip=1` 的含义是"已闭合且幅值过门、但没有满足主频共振条件"，不是验收状态"握紧无物"。
- `*`：C3/C5 表中 `grip=1` 来自旧判据（`ampValid`）；当前代码要求 `ampHeld`，马达关时应为 0。该列需在下一轮实板复测确认。

---

## 4. 三态输出语义

验收状态只有三个：**松手 / 握紧无物 / 接触**。`grip` 是诊断位，不是第四个验收状态。

```text
closed=0                         -> 松手
closed=1 && ct=0 && grip=0       -> 已闭合，无振动证据（不知道是否夹到物体）
closed=1 && ct=1                 -> 接触
closed=1 && ct=0 && grip=1       -> 有振动但未形成接触共振（诊断为空夹）
```

必须区分：

- `closed=0` 才是明确的"松手"；
- `closed=1` 只证明手指已经合拢，不能单凭角度证明夹到了物体；
- `ct=0` 表示没有满足接触判据，不表示物理上一定没有物体；
- `gripNoObject` 已修正为要求 `ampHeld`，不能把"幅值可信但很小"误报成"没有物体"。

---

## 5. 已经确认不能单靠姿态解决的事

| 观测量 | 实测结果 | 结论 |
|---|---|---|
| 重力偏差 `D` | 空夹与夹 5 cm 方块只差约 10%，且跨位置可差到 1.8 g | 不能单独分空夹/夹物 |
| 闭合角 `theta` | 空夹 106~111°，夹 4 cm 方块 100°，只差 6~11° | 不能分空夹/夹物 |
| 三轴 Y/Z 静态向量 | 夹物时 Y +140~160 mg、Z -110~165 mg，但组内 std 69~119 mg | 只作为待研究特征，余量不足 |
| 无振动接触 | C5 幅值 8~209 mg、主频无效 | 没有振动证据时不猜接触 |

因此当前可靠的分工是：

1. **松手 vs 已闭合**：陀螺积分角度；
2. **闭合后是否有振动接触**：A/F 两轴；
3. **静止物体接触**：当前版本无法证明，保持 `ct=0`。

---

## 6. 机械限位：怎么加，做不到怎么办

现阶段优先让每次松手后的**张开起始位**可重复。闭合止位是后续机械实验分支，
会改变夹持力并可能妨碍不同尺寸物体，不能直接加入最终结构。

### 6.1 最小机械方案

1. 在中指根部/手背侧加薄尼龙或 3D 打印 L 形止位，接触面做圆角；
2. 用低刚度拉簧或橡皮筋把手指拉回止位；
3. 必要时加侧向导向片，减小 Y/Z 横向散布；
4. 限位件避开柔性板弯曲区和指甲盖模块，避免额外预紧力。

另有一个实验分支：在空握最终位置附近加可调闭合止位，使空握停在固定止位、
夹物时物体先挡住手指。它理论上能拉开角度差，但必须验证不会限制正常夹持力、
不会挤坏物体或柔性板；未验证前不采用。

### 6.2 验收方法

做 10 次"张开 -> 停 2 s -> 闭合 -> 张开"：

- 观察张开位 `ang`、`D` 的极差；
- 比较空握/夹物的 Y/Z 组内 std；
- 只有当类间差达到组内 std 的约 3 倍，才重新评估 `touchScore`。

### 6.3 机械限位做不到时的兜底

已实现的软件规则：

```text
本闭合周期闭合过
且静止 >= 2000 ms
且幅值 < 100 mg
且闭合角 < 8 deg
=> 清平放基准并自动重采一次
```

配套参数：`OPEN_D_MG=400`、`GYRO_STILL_MS=500`、`AUTO_ZERO_*` 见第 2 节。

兜底只解决零位漂移，不能消除不同张开位置造成的 Y/Z 差异。因此没有机械限位时：

- 继续用角度判松手/闭合；
- 继续用 A/F 判振动接触；
- 不把 `touchScore` 接入最终 `contact`；
- 不把"闭合但无振动证据"写成"握紧无物"。

---

## 7. 当前测试覆盖与缺口

### 已有证据

- `gyro_test`：G1/G3/G5/G6/G7 + G5b/G5c 共 8/8 通过；
- `event_analyze.py --selftest`：11/11 通过，能解析 16 列 label CSV、切出两段平台角事件并检测回落稳定窗口；
- 四格实板：C1/C3/C5/C6 通过；
- C6 连续约 15 s，15/15 条保持 `ct=1`；
- 自动重采后静置 10 s，`D` 不再在 `?` 和 0 之间反复跳。

### 仍缺

1. 每种状态 >=5~10 次独立试验，并跨 3 个摆放位置；
2. C6 连续 30~60 s 不掉线；
3. C3/C5 连续 30~60 s，确认瞬态和假频不会误点 `ct`；
4. 机械限位前后的 Y/Z、角度重复性对比；
5. 不同物体尺寸（至少 4 cm 与 5 cm）的交叉验证；
6. 限位后重新评估 `touchScore`；未完成前只做诊断输出。

### 事件采集状态（2026-10-30）

- 空握 p1：10 个事件（`start=10`）；为与 4 cm 对齐，用 `start=30` 时 7 个；
- 4 cm p1：8 + 3 = 11 个事件；
- 5 cm p1：已补到 10 个有效单周期事件，均有稳定回落；相对闭合角 80.5~105.3°，极差约 24.8°，仍不满足固定零点条件；
- 4 cm 与空握的 `gyroPeak`、`impactA` 有初步差异，但尚未完成跨位置验证。

### 三位置静态姿态（2026-10-30）

> 下面是早期静态记录；其中 FINISH 行已作废，FINISH 实际是缓降/回位阶段，
> 不能作为第三个静态中心。当前分法见本节后面的修正说明。

首轮三轴均值：

| 位置 | ctX | ctY | ctZ |
|---|---:|---:|---:|
| START | -85.39 | -141.72 | -24.60 |
| FINISH | 176.96 | -6.53 | 47.45 |
| HONGEST | 378.85 | -4.56 | 1572.87 |

三组欧氏距离约 303.8 / 1669.2 / 1538.7 mg，组内 std 远小于类间距离。
这说明三个机械位置可用三轴姿态向量区分；仍需 10 次独立重复和跨摆放位置验证。

后续循环采集进一步确认：FINISH 实际是握紧后的缓降/回位阶段，不是静态姿态。
START 与 HONGEST 可用三轴静态向量区分；FINISH 应改用回落阶段特征
（`releaseStable / settleAngle / cycleZeroAngle`），不能再当作第三个静态中心。

但两次修正顺序采集的三轴中心不一致：`static_cycle_2` 与 `static_cycle_3`
的 HONGEST X 从 521.7 变到 -377.2 mg，说明跨采集存在明显的姿态/装贴漂移。
三轴中心不能写死，必须先做同一 START 姿态的会话内标定。

> **顺序修正**：`static_cycle_2/3` 采用的是旧的
> `START -> HONGEST -> FINISH` 顺序；用户要求 FINISH 与 HONGEST 互换，
> 正确顺序应为 `START -> FINISH -> HONGEST -> START`。旧数据只作历史参考。

离线分类器已新增：`vibmon_v5\_probe\static_position_analyze.py`。
`static_cycle_3` 的 START/HONGEST 留一验证为 6/6；`static_cycle_2`
没有可靠 START，脚本只报告 HONGEST，不把 FINISH 误标成 START。

同一装贴下补采单段：`static_start_2` 的 START 中心约
`(270.3,31.8,266.2) mg`，`static_hongest_2` 的 HONGEST 中心约
`(-769.4,17.6,1551.2) mg`，中心距离约 1653 mg；仍需重复 10 次。

`static_start_repeat_1` 虽检测到 10 个稳定段，但中心约 `(809,-4,-1499) mg`，
与上一轮 START/HONGEST 都不一致，说明装贴或机械姿态发生了变化，不能直接合并。

同一文件验证 `static_start_hongest_same_1`：START 中心约
`(-0.5,-0.6,2.3) mg`，HONGEST 中心约 `(658.5,-3.7,1640.0) mg`，
距离约 1765 mg，留一验证 2/2；最后一次回到 START 未形成稳定段。

`static_pairs_1` 同一 session 重复：START 13 段中心约
`(53.6,10.3,24.5) mg`，HONGEST 6 段中心约 `(410.4,24.9,1576.4) mg`，
距离约 1592 mg，留一验证 19/19。默认自动稳定段分类可用；不要用 `--sequence`
强行按顺序标注。

固定止位后 `static_pairs_2/3` 两次 session：
START std 约 8.0/6.5 mg，HONGEST std 约 3.6/5.9 mg；
两次中心差约 50 mg，START/HONGEST 类间距离约 1709~1711 mg。
机械止位明显改善了重复性。

固定后的单段复核：START `(327.1,-130.9,-909.0) mg`（std 1.3），
HONGEST `(508.2,69.4,1650.0) mg`（std 3.4），中心距离约 2573 mg。
单段稳定性很好，但绝对中心仍需每次 START 基线校准。

最新确认 START 是近零姿态：`static_start_fixed_2` 中心
`(-11.7,9.3,-4.1) mg`（std 2.8），`static_hongest_fixed_3` 中心
`(850.2,-70.1,717.1) mg`（std 2.6），距离约 1127 mg。
绝对中心仍随 session 变化，必须做 START 基线。

分类器已改为最小三轴范数作 START；`static_pairs_6` 的 17 个稳定段
START 7 / HONGEST 10，中心距离约 1653.9 mg，留一验证 17/17。
固定后 `pairs_2/3/6` 三组均通过会话内验证。

固件已加入姿态诊断模块 `posture.h/posture.cpp`：`P` 采 START 基线，
`S` 输出 raw/stable 分类，`Q` 输出单行 `#POST`。该诊断不影响正式 `contact`。
实板已验证 START 基线、HONGEST 分类和 `stableCls` 防抖。

`P` 已增加 START 防误采：闭合角无效或超过 `AUTO_ZERO_ANGLE_DEG` 时拒绝；
重标定后旧基线失效；`P` 失败会显示“沿用旧 START 基线”。

`P` 还有第二道防误采：`ctDev > 300 mg` 拒绝。最新 CDC 构建
368992 B / 30268 B / 0 warning，已烧录；非 CDC 构建 363802 B / 30092 B。

最终实板验证：

- START 上 `P` 基线：`-72.2/0.5/-18.2 mg`
- HONGEST：`d=1708mg`，分类 HONGEST，窗口有效
- HONGEST 上按 `P`：拒绝，提示闭合角 115°、要求先回 START

连续复测两次有效：
START 基线分别为 `(-72.2,0.5,-18.2)`、`(-6.5,1.1,-1.7) mg`；
HONGEST 距离分别为 `1708`、`1765 mg`，`P` 均正确拒绝。
后续第 3 次有效基线 `(-70.5,1.4,-17.0)`，HONGEST 距离 `1751 mg`；
第 4 次因仍停在 HONGEST 被 `P` 拒绝，未计入。

最终完成 5 次有效循环，HONGEST 距离分别为
`1708 / 1765 / 1751 / 1708 / 1700 mg`；两次 HONGEST 上误按 `P`
分别被闭合角门限和 `ctDev=1605 mg` 门限拒绝。

新增 `Q` 单行 `#POST` 帧并完成 transition 采集：
START `d=0.3~5.3 mg`，HONGEST `d=1741.6~1755.6 mg`，
回程在 `220~335 mg` 的 UNKNOWN 区停留约 3 s；新版已改为 UNKNOWN 不提交
为稳定类别。

稳定防抖已加入：连续 3 个窗口才提交 `stableCls`。`posture_transition_5`
验证了 START 首次 `stable=0/scnt=2`、下一窗口 `stable=1/scnt=3`；
但该次没有实际进入 HONGEST，23 点全部是 START，transition 数据需重采。

`posture_transition_9` 验证了完整 transition：
START `stableCls=START/stable=1`；进入 HONGEST 首窗 `stable=0/scnt=2`，
下一窗 `stableCls=HONGEST/stable=1`；回程 `stableCls=HONGEST/stable=0`，
UNKNOWN 不再提交为稳定类别。

---

## 8. 现场使用

```text
上电 -> 保持张开静止 3.2 s 标定 + 0.8 s 采基准
张开 -> 停 2 s（自动归零）
闭合 -> 看 ct / closed / grip
再张开 -> 停 2 s（下一轮自动重采）
```

串口命令：

| 命令 | 作用 |
|:--:|---|
| `S` | 查看状态 |
| `w` | 输出一行 `#SWEEP` |
| `d` | 输出调试行 |
| `t` | 手动采基准 |
| `c` | 重新标定 |
| `0`~`4` | 选择绘图组 |

`#SWEEP` 字段：

```text
F A D ang tr vib ct grip cl w cliplim ax ok
```

---

## 9. 历史思路记录

- 坐标/轨迹位移思路见 `陀螺仪改造方案.md` §13；
- 三轴姿态向量实测见 §17；
- 多条件 `touchScore` 暂缓理由见 §18；
- 无机械限位兜底见 §19 和 §20；
- 外部论文/专利整理与闭合事件状态机草案见 `相关研究与闭合事件方案.md`。

这些思路没有被删除，但都还没有达到接入最终 `contact` 的证据门槛。

---

## 10. 2026-10-30 启停频率修复与实板复核

本节记录冻结基线 `baada54` 之后的现场修复。相关源文件修改已在
提交 `a628014` 中提交：

- `output.cpp`：补上 `c` 重标定命令解析；
- `output.cpp`：`CT_MODE=4` 的 `t` 改为采平放/START 基准；
- `state.cpp`：接触姿态与平放基准两套采集状态机按模式互斥，避免
  `stateTickTouchRef()` 在模式 4 提前消费掉 `stateTickFlatRef()` 的采集；
- `config.h/state.cpp`：新增启停专用 `ssVib` 包络状态，阈值
  `SS_HI_MG=180 / SS_LO_MG=150`，只驱动 `ssHz`，不改变 `contact`、
  `freqValid` 和 `gripNoObject` 的语义。

### 标定与静止漂移

重新标定后：

```text
[CAL] 有效标定 | 质量合格
[GYRO] 零偏 7.98/4.09/0.03 dps
```

随后保持静止 10 s：

```text
ang 0 -> 0 deg
w 中位数 0.20 dps，范围 0.10~1.00 dps
ct = 0/20
```

说明之前的 4.5~8 deg/s 漂移来自标定失败（陀螺零偏为 0），不是算法本身。

### 启停频率

保持接触、振源自动通断，每档采 9 s。下表取运行期间的有效读数：

| 设定 | 固件读数 | 周期数 | 结果 |
|---:|---:|---:|:--:|
| 0.5 Hz | 0.50 Hz | 4 | 通过 |
| 1 Hz | 1.00 Hz | 4 | 通过 |
| 2 Hz | 2.00 Hz | 4 | 通过 |
| 3 Hz | 2.94 Hz | 4 | 通过 |

停止自动通断后 `ssHz` 回到 0 并显示“未确立”，这是
`SS_TIMEOUT_K` 的超时语义，不代表刚才的读数失败。

原始数据：

- `data/startstop_freq_ss_20261030.raw.txt`
- `data/startstop_freq_20261030.raw.txt`（修复前对照）

### 接触回归

启停修复后保持闭合、100% 占空比运行 5.5 s：

```text
closed = 13/13
ct     = 12/13（首点频率窗预热）
ang    = 93 deg
A 中位 = 625.1 mg
F      = 174~176 Hz
```

原始数据：`data/ss_contact_regression_b_20261030.raw.txt`

### 静态与构建验证

- `gyro_test`：6/6 通过；
- CDC 构建：`368708 B Flash / 30252 B RAM / 0 warning`；
- 非 CDC 构建：`363508 B Flash / 30084 B RAM / 0 warning`。

### 5 轮重复性测试（未通过）

`repeat_5cycles_voiced_slow_20261030.raw.txt` 使用语音提示，每段动作后留
2 s，再采 5 s。结果：

| 状态 | 结果 |
|---|---|
| 空握 | 5/5 轮 `closed=10/10`，A 约 6~9 mg |
| 接触 | 第 1/4/5 轮 `ct=10/10、10/10、9/10`；第 2/3 轮 `ct=0/10` |
| START | 第 1 轮 `cls=1`；第 2~5 轮 `d=181~234 mg`，被判为 UNKNOWN |
| 回 START | `closed=0/10、ct=0/10`，但 `d=281~446 mg`，落在 UNKNOWN 区 |

第 2/3 轮接触时并非没有振动：A 中位数分别为 646.7/702.0 mg，
但闭合角只有 42~46°，低于 `ANGLE_CLOSED_DEG=60`，因此 `closed=0`，
接触被姿态门挡住。这是机械接触位置使闭合角变小，不是 A/F 失效。

待决策：模式 4 的 `closed` 是否增加 `flatDist > 1000 mg` 的并行门。
这 5 轮中该门可清晰分开 START（<235 mg）、空握/接触（>1500 mg），
同时不会把 START 误判为闭合；但改接触语义前需要单独评审和回归。

### 机械约束补充（2026-10-31）

- **比赛最终物体是 4 cm 左右的正方形物体，最终验收必须以 4 cm 为准**；
- 当前机械手能稳定夹住 4 cm 无振源方块，无法稳定夹住 5 cm 方块；
- 5 cm 振动方块只是目前唯一可用的**临时振动激励源**，不是最终验收物体；
- 因此上述 5 轮测试中的第 2/3 轮 `ang=42~46°` 不能作为
  “比赛 4 cm 接触姿态角度偏小”的算法证据，它们代表的是 5 cm
  临时夹具夹持失败；
- 不应为了适配夹不住的 5 cm 方块而降低 `ANGLE_CLOSED_DEG` 或加入
  `flatDist` 并行闭合门；
- 正确的验收方式是：用 4 cm 物体完成握持/角度/姿态验收，再把 5 cm
  振动源刚性固定在 4 cm 物体外侧或测试工装外侧，保证检测面受振，
  而不要求夹爪直接夹住 5 cm 方块；
- 4 cm 圆柱体可作为临时机械适配/夹持验证件，但它不是正方形物体，
  圆柱接触线和最终方块平面接触不同，不能替代最终 4 cm 正方形验收。

### 4 cm 圆柱体验证与 I2C 掉线（2026-10-31）

4 cm 圆柱体单次接触验证通过（振源由 COM7 控制）：

```text
闭合角 119~120 deg
A 中位数 965.7 mg
F 约 165~167 Hz
振动段 ct=11/12（首点预热）
关闭振源后 ct 在 0.4 s 内回到 0
```

原始数据：`data/cylinder_contact_check_20261031.raw.txt`

随后进行 5 轮语音提示测试时，第 1 轮空握阶段出现：

```text
[FAULT] 传感器无响应
[MPU] 初始化失败：无应答 (寄存器 0x75)
```

故障发生后采样器反复掉线，后续 `#SWEEP` 出现大量 `A=?、ang=?`，
5 轮数据不能用于算法验收。优先检查并加固 MPU6050 的 SDA/SCL、3V3、
GND 连接和柔性板焊点，做机械运动下的连续 10 分钟在线测试后，
再重跑 5 轮。

### 在线连接复核（2026-10-31）

在轻微弯折机械手/排线的 30 秒在线测试中：

```text
#SWEEP 59 条，完整 56 条，无效 3 条
I2C错 587，读失败 505，不连续 51（缺 104，抖动 19）
启动时出现一次 MPU 寄存器写失败（0x1C）
最终传感器恢复在线
```

这份结果仍不合格。当前问题已从“算法/接触判据”切换到
MPU6050 的 I2C 物理连接可靠性；在 `I2C错` 和 `读失败` 清零前，
不能继续用 5 轮数据做验收。优先检查 SDA/SCL/3V3/GND 焊点、
排线根部和接插件，并增加应力释放。

原始数据：`data/connection_test_20261031.raw.txt`

### 重新烧录后的连接复核（2026-10-31）

重新编译并烧录当前源码后：

```text
静止 20 s：#SWEEP 39/39 有效，I2C错=0，读失败=0，不连续=0，
           MPU 失败=0，传感器在线
动态 30 s：#SWEEP 58/58 有效，I2C错=0，读失败=0，MPU 失败=0；
           仅有 1 次抖动，不属于掉线
```

说明重新烧录后当前的 MPU6050 连接已恢复稳定；此前高 I2C 错误不是
由固件 I2C 初始化逻辑直接造成的第一证据。可以继续做功能验收，但仍需
在后续每次机械动作时观察 `I2C错`/`读失败` 是否再次出现。

原始数据：

- `data/post_reflash_connection_20261031.raw.txt`
- `data/post_reflash_dynamic_20261031.raw.txt`

### 重烧录后真实动作仍复现掉线

随后的 4 cm 圆柱体单轮测试在空握阶段再次出现：

```text
[FAULT] 传感器无响应
[MPU] 初始化失败：无应答 (寄存器 0x75)
```

短暂恢复后，接触段又能读到 A≈1.0~1.4 g，但采样已经不可信。
因此重新烧录只能暂时恢复，不能解决间歇性物理连接问题；在修复 SDA/SCL/
电源/接插件前，任何 5 轮数据都不能作为验收依据。

---

## 11. 测试暂停记录（2026-10-31）

当前没有备用检测板，现场测试到此暂停。代码和证据状态如下：

### 已完成且可作为基线

- 代码基线：`a628014`；评审修复见最新提交；
- `gyro_test`：6/6；
- CDC/非 CDC 编译通过，0 warning（失败前最后一次构建）；
- 标定成功后静止 10 s 角度 0 漂移；
- 3 Hz 以内启停频率读数通过：`0.50 / 1.00 / 2.00 / 2.94 Hz`；
- 4 cm 圆柱体单次接触通过：`closed=12/12`，`ct=11/12`，
  A 中位数 965.7 mg，F 约 165~167 Hz；
- 这是一条真实的 `ct=1` 正向接触证据；但不等同于原先 5 cm 振源的
  C6 工况，5 cm C6 仍需单独补测；
- 重新烧录后静止 20 s、轻动态 30 s 的短测无 I2C 错误。

### 不可作为最终验收

- 5 cm 方块 5 轮：机械夹持失败，不能作为算法结论；
- 4 cm 圆柱 5 轮：真实动作中 MPU6050 再次 `0x75` 无应答，数据无效；
- 任何伴随 `[FAULT] 传感器无响应` 或 `A=? / ang=?` 的数据；
- 当前没有完成 5 轮稳定重复性验收。

### 恢复测试的前置条件

1. 修复 MPU6050 的 SDA/SCL/3V3/GND 和接插件；
2. 静止 30 s：`I2C错=0、读失败=0、不连续=0`；
3. 动态弯折 30 s：仍为 0，且无 `[FAULT]`；
4. 用 4 cm 正方形物体做最终几何验收；5 cm 振动源仅作外部激励；
5. 重做单轮，再重做 5 轮。

---

## 12. 2026-10-31 代码评审修复

按评审清单处理了代码项，P0-2/P0-3 保留为赛前构建检查：

- P0-1：接触主频门限从 `120/90Hz` 经 `85/70Hz`、`78/65Hz` 最终降到
  `75/63Hz`，同步整数镜像宏；因为判据是严格大于且主频有 1~3Hz 抖动，
  `78` 对 80Hz 下限余量仍不足，最终 `75` 留出 5Hz 测频余量；
- P1-1：修正 `OPEN_D_MG` 的 `#ifndef` 缺少 `#endif`，避免外部预定义
  `OPEN_D_MG` 时把 `AUTO_ZERO_*`/`POSTURE_*` 静默包进条件块；
- P1-2：模式 3 的阈值编译期检查扩展到模式 4；
- P2-1：姿态运行窗口改用窗口内最大 `gyroW`，不再用结算帧瞬时值；
- P2-2：陀螺超量程锁存 `angleValid=false`，直到回到张开位 `parked`
  并清零后才恢复；
- P0-2：`COMP_FRAME_ENABLED` 仍默认 0，协议确认后再开启；
- P0-3：比赛烧录必须使用 `CDCOnBoot=cdc`，非 CDC 的 GPIO20/21
  与比赛口冲突。

验证结果：

```text
gyro_test:        8/8 通过（新增 G5b/G5c 超量程锁存）
comp_frame_test:  22/22 通过
外部 -DOPEN_D_MG: 编译通过
CDC 构建:         368804 B Flash / 30260 B RAM / 0 warning
非 CDC 构建:      363604 B Flash / 30084 B RAM / 0 warning
```

---

## 13. 第二轮修改工单落实（2026-10-31）

- M1：`CT_FLAT_F_ON/OFF` 最终改为 `75/63Hz`，`_INT` 镜像同步；
- M2：`config.h` 的幅值/频率注释和 `state.cpp` 的频率门标题已改为
  “幅值门实际把关、频率门是辅助证据”，不再声称频率是唯一依据；
- M3：`答辩准备文档.md` 的 Q3 已整段替换，数字与
  `当前状态.md` 的实板数据对齐；
- T1：`真接触 → 抽走马达但保持振源开启 → 观察 ct 是否退出` 尚未执行，
  因为没有板子；不要提前把 `combineContact` 的保持规则改成只用幅值。

T1 恢复硬件后按以下判读：

```text
100~300ms 内 ct 掉 0       正常
ct 一直 1 超过 5s          保持规则过宽，按工单方案 A 改
ct 在 0/1 间反复跳         检查滞回/假频
```

---

## 14. 第三轮收尾（2026-10-31）

- S1：`CT_FLAT_A_ON_MG` 注释统一为“空夹中位 6.2mg、最坏瞬态
  304mg；真接触 500~1152mg”，删除旧的 796~834mg 和 sqrt 推导；
- S2：新增编译期防呆
  `CT_FLAT_F_ON_HZ_INT >= 80` 即报错；临时以
  `-DCT_FLAT_F_ON_HZ_INT=85` 编译已验证确实触发 `#error`；
- S3：75/63 最终版本重新构建，尺寸为
  CDC `368804 B Flash / 30260 B RAM`、非 CDC
  `363604 B Flash / 30084 B RAM`，均 0 warning；
- T1：仍待有板后执行，不提前改 `combineContact`。

---

## 15. 宿主测试续测（2026-11-02）

在停板状态下继续做代码测试，新增 `test/contact_test.cpp`：用合成 `DspFrame`
驱动 `state.cpp` 的接触状态机，不依赖实板。测试针对当前工作区执行；工作区
包含未提交改动 `config.h`（`UART_SWAP=1`、`COMP_FRAME_ENABLED=1`）和
`比赛现场代码修改说明.md` 的删除，本轮未改固件代码。

结果：

```text
gyro_test:        8/8
comp_frame_test:  22/22
contact_test:     43/43（新增；含 C1/C3 的 FINDING-01、C12 的 FINDING-04）
event_analyze:    11/11
capture_measure:  13/13
CDC 构建:         369800 B Flash / 30268 B RAM / 0 warning
非 CDC 构建:      364692 B Flash / 30092 B RAM / 0 warning
```

发现两处 P2 语义差异：

- FINDING-01：`CT_MODE=4` 的 `postureInput()` 只检查
`angleValid`，未检查 `flatRefSet`，导致未采到平放基准或基准采集失败后，
只要有陀螺帧 `contactValid` 仍会变 1。是否按模式 3 语义加 `flatRefSet`
门控，待定。
- FINDING-04：`ctStep` 的早退分支（判据输入不可用）没有清 `s_r.closed`，
陀螺失效后会出现 `contact=0, contactValid=0` 但 `closed` 仍为上轮旧值 `1`。

完整问题清单、测试编号和推荐顺序见
`代码测试报告_20261102.md`。

---

## 16. FINDING-01/04 修复与配置冻结（2026-11-02）

- FINDING-01：`postureInput()` 的 `CT_MODE=4` 分支改为返回
  `s_r.angleValid && s_flatRefSet`，没有平放基准时不再把
  `contactValid` 置 1；
- FINDING-04：`ctStep()` 判据输入不可用的早退分支补清
  `s_r.closed`、`s_ctPostCmd`、`s_ampHeld`、`s_freqHeld`，
  陀螺失效后不再保留上一轮的 `closed=1`；
- `state.h` 同步了 `contactValid` 对 `CT_MODE=3/4` 的语义注释；
- `contact_test` 的 C1/C3/C12 断言改回语义期望后：
  `gyro_test 8/8`、`comp_frame_test 22/22`、`contact_test 43/43`；
- 修复后双 FQBN 编译 0 warning：
  CDC `369822 B Flash / 30268 B RAM`、
  非 CDC `364714 B Flash / 30092 B RAM`；
- 当前工作区配置冻结为 `UART_SWAP=1` + `COMP_FRAME_ENABLED=1`，
  比赛烧录必须使用 `CDCOnBoot=cdc`；官方未公开帧协议/波特率，
  现场平台确认前仍可改回 `COMP_FRAME_ENABLED=0`。
