wmsz88/flex-vib-monitor/vibmon_v5/相关研究与闭合事件方案.md

# 相关研究与闭合事件方案

> **记录日期**：2026-10-30
> **状态**：参考资料与实验方案记录，诊断功能已实现
> **边界**：闭合事件和 `touchScore` 只作为诊断/研究，不改变当前 `contact` 判据

---

## 1. 结论

外部资料支持当前的判断方向，但没有证明“仅靠 MPU6050、无振动、无机械限位”可以稳定判断静态夹物：

- 指尖 IMU 的常见用法是检测**接触事件、滑移、冲击和振动传导**；
- 静态抓握力或无振动接触通常需要压力、应变、力或主动振动等互补信号；
- 因此 v5 继续保留 `θ 判闭合 + A/F 判接触`，不把静态 Y/Z 加权直接接入 `contact`；
- 下一步更值得做的是**闭合事件窗口**，而不是继续调静态权重。

这条路线与当前 v5 的四格结果一致：C6 有明显 A/F 证据时可靠；C5 压住静止物体时没有足够证据，不能硬猜。

---

## 2. 参考资料的定位

| 资料 | 实际解决的问题 | 对本项目的启发 | 不能直接证明什么 |
|---|---|---|---|
| [Slip detection for compliant robotic hands using inertial signals and deep learning](https://www.frontiersin.org/journals/robotics-and-ai/articles/10.3389/frobt.2025.1698591/full) | 柔性手指尖 IMU，用加速度振动和陀螺姿态变化识别滑移 | 支持“事件型/动态证据”路线；IMU 对滑移和接触事件有效 | 不是静止夹物分类器 |
| [VibroTouch: Active Tactile Sensor for Contact Detection and Force Sensing via Vibrations](https://www.mdpi.com/1424-8220/22/17/6456) | 主动振动注入，通过加速度频谱判断接触和力 | 支持现有 A/F 判据的物理基础：接触会改变振动传导 | 需要主动振动源；不能证明无振动时也可判 |
| [Wrist2Finger: Sensing Fingertip Force for Force-Aware Hand Interaction](https://arxiv.org/abs/2510.04122) | 腕部 IMU/EMG 等互补信号估计指尖力和姿态 | 说明静态抓握力通常需要多模态信号 | 单一 MPU6050 没有力/应变通道 |
| [Tactile sensing with accelerometers in prehensile grippers for robots](https://www.sciencedirect.com/science/article/pii/S0957415815002007) | 夹爪手指加速度计触觉感知 | 加速度计适合事件和振动触觉 | 前提仍是运动/振动，不是完全静默的接触 |
| [一种适用于机械手的无需接触传感器的初始滑动检测方法](https://www.xjishu.com/zhuanli/52/202311635276.html) | 手指背面/侧面检测初始滑移振动 | 与“模块贴指甲背面、通过传导测振动”的装贴方式相近 | 主要针对滑移；该页面是二手专利页面，正式引用前需核对公开号 |

> 以上是用户提供检索结果的整理，不是系统性综述。引用时应以论文原文和正式专利公开文本为准。

---

## 3. 与当前 v5 的对应关系

当前实现的关键位置：

- `D:\大学\课程\工科赛\代码\vibmon_v5\state.cpp:258`：陀螺积分闭合角；
- `D:\大学\课程\工科赛\代码\vibmon_v5\state.cpp:321`：模式 4 的姿态门输入；
- `D:\大学\课程\工科赛\代码\vibmon_v5\state.cpp:390`：闭合角、幅值门、频率门合成 `contact`；
- `D:\大学\课程\工科赛\代码\vibmon_v5\output.cpp:319`：当前打标 CSV 写入点。

现有正式逻辑保持不变：

```text
closed        = angleValid && closeAngleDeg > 60 deg
strongContact = closed && ampHeld && freqHeld
contact       = closed && strongContact
```

注意：`ampHeld` / `freqHeld` 是带滞回的门状态，不应当用单帧数值直接替代。

---

## 4. 闭合事件状态机草案

目标是把一次“手指合上”的动作切成可重复的事件，避免把开合过渡混进稳态特征。

| 状态 | 进入条件（草案） | 主要动作 |
|---|---|---|
| `ARMED` | 角度接近 0，角速度在死区，且最近未提交事件 | 清空本次事件缓存，等待闭合 |
| `MOVING` | 角度开始增长或 `gyroW` 超过动作门限 | 记录起点，开始累计陀螺能量和事件统计 |
| `PLATEAU` | `MOVING` 后连续 200~300 ms 角速度在死区 | 记录候选停止点和过渡段特征 |
| `COMMIT` | `PLATEAU` 再持续 300~500 ms，未重新启动 | 冻结本次事件特征，递增 `eventId` |
| `OPEN` | 回到张开位并静止满 500 ms | 结束本次事件，回到 `ARMED` |

### 4.1 关键约束

- `PLATEAU` 不要求角度一定大于 60°。夹物时可能在较小角度提前停住，若过早要求“已闭合”，会错过有用事件。
- `COMMIT` 后不再更新本次事件的终值特征，避免手抖和等待时间改变分类结果。
- 回到张开位才算一次事件完整结束；若长时间不张开，保持 `COMMIT` 并标记超时。
- 一次闭合若出现多次短暂停顿，用“重新超过动作门限则回到 `MOVING`”处理，避免把中途抖动提交成事件。
- 事件状态机只做诊断，不直接改写 `contact`。

建议先按以下参数做实验，不先固化进 `config.h`：

```text
事件启动角        10 deg
动作角速度门限    3 dps
PLATEAU 初判      250 ms
COMMIT 确认       300 ms
回张开确认        500 ms
稳态均值窗口      500 ms
```

这些值需要用实际闭合曲线和日志重新确定，不能当作已验证参数。

---

## 5. 事件特征

定义：

- `t0`：`MOVING` 起点；
- `tPlat`：`PLATEAU` 起点；
- `tCommit`：`COMMIT` 时刻。

| 特征 | 定义 | 物理意义 | 注意 |
|---|---|---|---|
| `openToCloseMs` | `tPlat - t0` | 从开始闭合到停住的时间 | 受操作速度影响，需同人同动作比较 |
| `plateauAngle` | `COMMIT` 前 100~200 ms 的角度均值 | 被物体挡住时的停止角 | 仍受装贴位置影响 |
| `gyroPeak` | `[t0,tPlat]` 内最大 `gyroW` | 闭合峰值角速度 | 快速闭合时可能超量程 |
| `gyroEnergy` | `[t0,tPlat]` 内 `sum(gyroW^2 * dt)` | 转动过程能量 | 对采样中断敏感 |
| `impactA` | `[tPlat-50ms,tPlat]` 内最大幅值 | 停止前的机械冲击 | 需要 `ampValid` |
| `ringdown` | `tPlat` 后 100 ms 能量 / 停止前能量 | 停止后的振动衰减 | 无振动时无定义，不能硬填 0 |
| `decayTau` | 停止后包络指数拟合时间常数 | 冲击衰减速度 | 样本不足时不输出 |
| `ctYMean` | `[tCommit,tCommit+500ms]` 的 Y 均值 | 停止位姿的横向投影 | 跨摆放位置敏感 |
| `ctZMean` | 同窗口 Z 均值 | 停止位姿的另一投影 | 与 Y 不独立 |
| `angleSlope` | `tPlat` 前 100 ms 的角度斜率 | 到达停止点前的减速程度 | 需先做平滑 |

`ringdown`、`impactA` 和 `decayTau` 在振源关闭时可能无效；此时输出 `?` 或 `scoreValid=false`，不要填 0 后参与分类。

---

## 6. 数据输出草案

现有 CSV 是 `seq,t_ms,ctX,ctY,ctZ,ctDev,ampMg,vib,contact,cvalid,gap,label,ctTouchDist,closed,ang,gyroW`，
不要直接打乱现有列顺序，避免旧脚本失效。

建议新增独立的 `EV` 汇总行，或在新版本里追加列：

```text
EV,eventId,phase,closureMs,plateauAngle,gyroPeak,gyroEnergy,
impactA,ringdown,decayTau,ctYMean,ctZMean,angleSlope,touchScore,scoreValid
```

若在固件中实现，建议同时输出：

| 字段 | 用途 |
|---|---|
| `phase` | 离线复核事件切分是否正确 |
| `eventId` | 防止同一动作被重复计数 |
| `closureMs` | 比较闭合速度 |
| `plateauAngle` | 与现有 `ang` 对照 |
| `touchScore` | 仅诊断，不参与 `contact` |
| `scoreValid` | 避免把“没有足够数据”当成低分 |

---

## 7. 离线验证方案

### 7.1 数据采集

先做振源关闭的静态物体实验，避免 A/F 直接帮助分类：

- 类别：空握、4 cm 方块、5 cm 方块；
- 每个类别至少 10 次独立闭合事件；
- 至少 3 个摆放位置；
- 每个位置重新张开、停顿、闭合，不复用同一段连续数据；
- 每组另做一次振源开启数据，只用于检查事件特征是否被振动污染。

### 7.2 统计方法

1. 先画单次事件的 `ang(t)`、`gyroW(t)`、`ampMg(t)`；
2. 检查 `PLATEAU` 是否落在真正的停止段，而不是手抖或过渡；
3. 对单特征计算组间差、组内标准差和 AUC；
4. 用 LDA、逻辑回归或小决策树做离线分类；
5. 按“事件”分组划分训练/测试，不能把同一事件的相邻帧拆到两边；
6. 最好采用留一摆放位置验证，检查是否只对某一个位置过拟合。

### 7.3 接入正式判据的门槛

至少同时满足：

- 类间分离达到组内标准差的约 3 倍；
- 留一位置验证没有系统性误判；
- 关闭振源时仍能重复，不依赖偶然的 A/F；
- 机械限位前后结论一致，或限位后确实改善。

未达到时，`touchScore` 只能显示，不能改变 `contact`。

---

## 8. 机械方案的两个分支

### 8.1 张开止位（优先）

让每次松手后的起始姿态一致，主要改善角度零位和 Y/Z 的重复性。它不直接制造“空握 vs 夹物”的角度差。

### 8.2 闭合机械止位（实验分支）

也可以尝试在“空握最终位置”附近加一个可调硬止位：

- 空握时手指停在固定止位；
- 夹物时物体先挡住手指，使手指停在止位之前；
- 理论上可把“有没有物体”转成更稳定的角度差。

但不能直接采用，必须先验证：

1. 止位不会妨碍对物体施加正常夹持力；
2. 物体不会因为止位被挤坏；
3. 空握和夹物的停止顺序确实相反；
4. 柔性板、指甲盖模块和走线不会被止位挤压。

这是一项机械结构实验，不是当前固件可以单独解决的问题。

---

## 9. 实施顺序

1. 保持 v5 正式 `contact` 不变；
2. 先写离线事件切分和特征提取脚本，用已有 CSV 试跑；
3. 再决定是否在固件里增加事件状态机诊断输出；
4. 采集每类至少 10 次、跨 3 个位置的数据；
5. 做机械限位（先张开止位，必要时再试闭合止位）；
6. 只有统计验收通过，才增加默认关闭的 `weakTouch`；
7. 任何阶段都不把“无振动但闭合”写成“夹到物体”。

### 9.1 离线脚本已实现

已新增 `_probe/event_analyze.py`，不修改固件。自测：

```powershell
python -X utf8 vibmon_v5\_probe\event_analyze.py --selftest
```

当前自测 7/7 通过：解析 16 列 label CSV、检测两段不同平台角事件、记录重新张开。

使用 16 列 CSV：

```powershell
python -X utf8 vibmon_v5\_probe\event_analyze.py `
  vibmon_v5\data\event_air_p1.csv `
  --class-name air --plot
```

输出：

```text
event_air_p1.events.csv
event_air_p1.events.summary.txt
event_air_p1.events.png
```

采集时使用当前固件 `label` 模式。空握用 `label=4`，静止物体接触用 `label=1`，
每个文件只放一个类别、一个摆放位置：

```powershell
python -X utf8 vibmon_v5\_probe\capture_measure.py `
  --port COM8 --mode label --settle 8 `
  --steps 4:60 --out vibmon_v5\data\event_air_p1
```

采集前关闭 Arduino 串口监视器；振源先关闭，先用静态物体数据验证事件特征。

### 9.2 首次采集结果（2026-10-30）

当前脚本默认使用 `segment` 分段，`still=20 dps`，因为实际张开/闭合过程中
陀螺并不一定回到 1.5 dps 死区；状态机路径保留为 `--detector state` 调试。

| 组 | 文件 | 有效事件 | 备注 |
|---|---|---:|---|
| 空握 p1 | `event_air_p1b.csv` | 10（start=10）/ 7（start=30） | 部分周期闭合角偏小 |
| 4 cm p1 | `event_4cm_p1b.csv` + `event_4cm_p1d.csv` | 8 + 3 = 11 | 用 `start=30` 分段 |
| 5 cm p1 | `event_5cm_check.csv` | 1 | 单周期检查通过，平台角 100.8° |
| 5 cm p1 | `event_5cm_p1b.csv` / `event_5cm_p1c.csv` | 不可用 | 角度没有回到张开位，长段连续闭合 |

4 cm 组与空握组的初步事件特征（仅作趋势，不作验收）：

| 特征 | 空握中位数 | 4 cm 中位数 |
|---|---:|---:|
| `gyroPeak` | 92.3 dps | 190.6 dps |
| `impactA` | 145.6 mg | 255.5 mg |
| `plateauAngle` | 103.0° | 115.9° |

这些差异可能包含操作速度和回位不一致的影响，不能直接作为分类器权重。
5 cm 连续采集必须先解决“每次完全回到张开位”的机械/操作问题，否则不能进入统计。

### 9.3 用回落轨迹做复位：方向对，但不能在“刚进入缓降”时归零

观察到的典型回落形状确实是：

```text
峰值 -> 快速下降 -> 进入缓降 -> 接近静止 -> 下一次闭合
```

但不能把“刚到缓降位置”直接当作复位点，因为当前实测的缓降入口和最低点并不固定：

| 组 | 回落最低角 | 进入缓降时的角（粗测） |
|---|---:|---:|
| 空握 | 多次约 0.0~0.5°，个别 20.3° | 0~24° |
| 4 cm | 约 5.9~26.5° | 约 18~34°，个别受抖动影响 |

如果一进入缓降就把角度清零，零点会随每次动作漂移，下一次闭合角也会被改变。
更稳妥的做法是把回落分成三个阶段：

```text
RETURN_FAST   : 角度快速下降
RETURN_SLOW   : 下降速度明显减小
RETURN_STABLE : |角度斜率| < 2~3 deg/s 且角度极差 < 2~3 deg，持续 300~500 ms
```

只有 `RETURN_STABLE` 才设置本轮的 `cycleZeroAngle`，然后重新 `ARMED`。
输出时同时保留：

- `settleAngle`：稳定后的角度；
- `settleSlope`：稳定窗口内角度斜率；
- `settleStableMs`：满足稳定条件的时间；
- `closureAngleRelative = plateauAngle - cycleZeroAngle`。

这样即使机械手不能回到物理 0°，也可以用“本轮稳定回落点”作为相对零点；
但它不能和不同类别/不同位置的绝对角度直接混用。

验收条件：同一状态连续 10 次，缓降入口角的极差应小于约 3~5°，
稳定点角度极差也应小于约 3~5°；否则只能把回落轨迹当辅助特征，不能直接改固件零点。

### 9.4 回落检测已加入离线脚本

`event_analyze.py` 现已输出：

- `releaseFastMs`：从 plateau 到检测到快速下降的时间；
- `releaseSlowMs` / `releaseSlowAngle`：进入缓降的时间与角度；
- `releaseStableMs`：满足稳定窗口的时间；
- `returnMinAngle` / `returnMinMs`：回落最低点和时间；
- `settleAngle` / `settleSlopeDegS`：稳定窗口均值和斜率；
- `cycleZeroAngle`：只有 `releaseStable=1` 时才输出的本轮相对零点；
- `closureAngleRelative`：`plateauAngle - cycleZeroAngle`。

当前参数：快速下降门限 `20 dps`，缓降门限 `5 dps`，稳定斜率 `2.5 dps`，
稳定角度极差 `2.5°`，稳定窗口 `500 ms`。这些仍是实验参数。

实测：

- 4 cm p1 的 8 个事件全部检测到稳定回落，缓降入口约 16.5~28°，
  稳定点约 7.0~24.4°，相对闭合角约 91.9~108.8°；
- 空握 p1 只有部分事件能计算稳定回落，部分事件在释放段存在约 2 s 的数据缺口，
  不能伪造缺失段，直接标记为 `releaseStable=0`。

结论：回落检测已经可用，但“缓降入口”和“稳定点”的跨周期极差仍然偏大，
暂时只能作为离线相对零点和诊断特征，不能直接替代固件的绝对归零。

### 9.5 回落重复性统计

按当前参数统计已有事件：

| 组 | 事件数 | `releaseStable=1` | 缓降入口范围 | 稳定点范围 | 相对闭合角范围 |
|---|---:|---:|---:|---:|---:|
| 空握 p1 | 7 | 2 | 0.9~23.9° | 11.4~22.1° | 86.9~90.0° |
| 4 cm p1 | 11 | 10 | 16.5~31.9° | 7.0~29.9° | 91.9~108.8° |
| 5 cm p1 | 10 | 10 | 14.2~31.6° | 12.1~29.9° | 80.5~105.3° |

结论：

- 4 cm 的缓降入口和稳定点范围仍远大于 3~5°，不满足固定零点条件；
- 5 cm 的 10 个有效事件全部有稳定回落，但相对闭合角极差约 24.8°，
  仍不能满足固定零点条件；
- 空握多数事件因释放段有约 2 s 数据缺口，无法计算稳定回落，不能把缺失段当成 0。

因此当前最合理的用途是：

1. 保留 `releaseStable` 作为数据质量门；
2. 用 `cycleZeroAngle` 做同一轮内的相对角；
3. 暂不改固件的绝对角度复位；
4. 先解决采集缺口或机械回位重复性，再重新做 10 次以上统计。

### 9.6 START / FINISH / HONGEST 的机械定义

按用户图示：

| 标记 | 机械含义 |
|---|---|
| `START` | 初始张开位置 |
| `FINISH` | 握紧之后的缓降/回位位置 |
| `HONGEST` | 空握位置 |

图上的机械位置分离明显，但当前 `closeAngleDeg` 是“三轴积分后取绝对值最大”的
标量，丢失了方向和轴信息；因此机械上可分的三个位置，在标量角上可能重叠。

下一步应使用：

- `ctXMean / ctYMean / ctZMean`：平台段的三轴姿态向量；
- 后续若改固件，再输出 `angleX/Y/Z` 与 `gyroX/Y/Z`；
- 在二维机械平面或三维姿态空间里计算 `START / FINISH / HONGEST` 的类间距离。

`START` 与 `FINISH` 在图上较近，`HONGEST` 较远；`FINISH` 还应结合
`releaseStable` 判断，不能只靠静态角度。

### 9.7 三位置静态姿态首轮实测

> **注意**：本节表中的 `FINISH` 静态中心是早期记录，已被 §9.9 修正。
> `FINISH` 是缓降/回位阶段，不是静态位置；该行不能再用于分类。

分别保持 `START / FINISH / HONGEST` 各约 20 s，取稳定段计算三轴加速度均值：

| 位置 | `ctX` (mg) | `ctY` (mg) | `ctZ` (mg) | 组内最大 std |
|---|---:|---:|---:|---:|
| START | -85.39 | -141.72 | -24.60 | 0.69 |
| FINISH（5~15 s） | 176.96 | -6.53 | 47.45 | 4.93 |
| HONGEST | 378.85 | -4.56 | 1572.87 | 0.63 |

三维均值之间的欧氏距离：

| 位置对 | 距离 (mg) |
|---|---:|
| START ~ FINISH | 303.8 |
| START ~ HONGEST | 1669.2 |
| FINISH ~ HONGEST | 1538.7 |

首轮结果说明：

- 图上三个机械位置确实可以分开，而且 START 与 FINISH 虽然图上较近，
  三轴向量仍有约 304 mg 的间隔；
- 当前标量 `closeAngleDeg` 无法表达这个差异，三轴向量才保留了方向信息；
- 这还只是一次连续保持，不能替代 10 次独立重复；
- FINISH 采集中间有两次移动，当前取 5~15 s 稳定段，后续应单独采纯静态保持。

> **2026-10-30 二次修正**：用户再次确认 FINISH 与 HONGEST 要互换。
> 上面写的 `START -> HONGEST -> FINISH -> START` 仍然是错误顺序；
> 正确顺序应为 `START -> FINISH -> HONGEST -> START`。
> `static_cycle_2/3` 按旧顺序采集，只能作历史参考，不能用于最终训练。

### 9.8 修正顺序后的循环采集

文件：`vibmon_v5\data\static_cycle_2.csv`，90 s 连续采集，按稳定窗口分类：

| 位置 | `ctX` 均值 | `ctY` 均值 | `ctZ` 均值 | 组内最大 std |
|---|---:|---:|---:|---:|
| START | 20.7 | 10.5 | 5.6 | 47.7 |
| FINISH | 217.3 | 11.8 | 86.8 | 39.4 |
| HONGEST | 521.7 | 45.0 | 1631.9 | 25.0 |

三维中心距离：

| 位置对 | 距离 (mg) |
|---|---:|
| START ~ FINISH | 212.8 |
| START ~ HONGEST | 1702.1 |
| FINISH ~ HONGEST | 1575.1 |

修正顺序后仍然能形成三个明显簇；但 START/FINISH 的距离约 213 mg，
而 START 组内 std 约 48 mg，余量约 4.5 倍，尚需独立重复验证。

### 9.9 FINISH 的语义修正

继续采集后确认：`FINISH` 不是静态姿态，而是“握紧之后的缓降/回位阶段”。
在 `static_cycle_3.csv` 中，FINISH 段的三轴向量会从大约
`(260, 3, 142) mg` 连续滑到 `(80, -4, 34) mg`，不是固定中心。

因此：

- `START` 和 `HONGEST` 可以作为静态位置，用三轴向量分类；
- `FINISH` 应使用回落阶段特征（`releaseFastMs / releaseSlowMs / settleAngle /
  cycleZeroAngle`），不能当作第三个静态中心；
- 若一定要把 FINISH 当位置，只能定义成缓降稳定后的“回位终点”，
  该点可能与 START 很接近，不能再用静态距离硬分。

### 9.10 跨采集绝对向量漂移

对比两次修正顺序采集的三轴中心：

| 采集 | START | FINISH | HONGEST |
|---|---|---|---|
| `static_cycle_2` | (20.7, 10.5, 5.6) | (217.3, 11.8, 86.8) | (521.7, 45.0, 1631.9) |
| `static_cycle_3` | (105.1, -4.2, 45.0) | (654.1, 63.9, 780.8) | (-377.2, 98.6, 1976.8) |

以 START 为基准的相对向量也明显不同：

| 采集 | FINISH - START | HONGEST - START |
|---|---|---|
| `static_cycle_2` | (196.7, 1.3, 81.2) | (501.0, 34.6, 1626.3) |
| `static_cycle_3` | (549.0, 68.2, 735.8) | (-482.3, 102.8, 1931.7) |

结论：单次采集内三位置分得很开，但跨采集的绝对三轴向量会大幅漂移，
说明传感器/机械手姿态或装贴方向在两次采集之间发生了变化。
因此不能把某一次测到的三轴中心直接写死；必须先做同一姿态的 START 标定，
并在多次采集间验证坐标变换或机械重复性。

### 9.11 离线三位置分类器已加入

新增 `_probe/static_position_analyze.py`，不改固件。它会：

- 自动提取稳定保持段；
- 用低 X/Z 的 START 候选做会话内基线；
- 用三轴向量区分 START / HONGEST；
- 把 FINISH 段标为 `OTHER/FINISH`，不建立第三个静态中心；
- 从同一数据提取 FINISH 回落事件；
- 输出留一事件验证结果。

运行：

```powershell
python -X utf8 vibmon_v5\_probe\static_position_analyze.py `
  vibmon_v5\data\static_cycle_2.csv `
  vibmon_v5\data\static_cycle_3.csv `
  --out vibmon_v5\data\static_position_analysis
```

当前结果：

- `static_cycle_3`：START 4 段、HONGEST 2 段，留一验证 6/6；
- `static_cycle_2`：没有检测到可靠 START，只有 HONGEST 6 段，脚本明确不把 FINISH 误标为 START；
- FINISH 事件 7 个，其中 `releaseStable=1` 6 个。

这说明分类器不会为了凑三类而伪造 START；数据不足时必须先补采。

### 9.12 同一装贴下的 START/HONGEST 单段验证

新采：

- `static_start_2.csv`：START，稳定段中心 `(270.3, 31.8, 266.2) mg`，最大 std 7.0；
- `static_hongest_2.csv`：HONGEST，稳定段中心 `(-769.4, 17.6, 1551.2) mg`，最大 std 7.4。

两者三维中心距离约 **1653.0 mg**，在当前装贴状态下分离非常大。

注意：这是各 1 个单段样本，只能证明当前装贴下可分，不能替代 10 次独立重复。
`static_start_2` 后 4 s 有移动，脚本只取前 5 s 稳定段；`static_hongest_2`
整体较稳定。

复采 `static_start_repeat_1.csv` 时检测到 10 个稳定段，但三轴中心约为
`(809, -4, -1499) mg`，既不是上一轮 START `(270, 32, 266)`，也不是
HONGEST `(-769, 18, 1551)`。这说明机械手/模块在两次采集之间又换了姿态，
该文件的 START 标签不能直接并入上一轮数据。必须先固定机械姿态和装贴方向。

### 9.13 同一文件内 START/HONGEST 验证

`static_start_hongest_same_1.csv` 在同一段采集中完成
`START → HONGEST → START`，使用稳定段后得到：

| 位置 | 三轴中心 | 组内最大 std |
|---|---:|---:|
| START | (-0.5, -0.6, 2.3) | 0.85 |
| HONGEST | (658.5, -3.7, 1640.0) | 4.0 |

同一文件内中心距离约 **1765.3 mg**，START 1 段、HONGEST 2 段，
留一验证 2/2。最后一次回到 START 的稳定段没有被完整保持，因此未计入。

这证明：同一装贴/同一 session 内，START/HONGEST 是可以稳定区分的；
跨文件混用仍然必须先确认姿态是否一致。

### 9.14 同一 session 重复对采集

`static_pairs_1.csv` 连续采集 `START/HONGEST` 交替动作，自动稳定段分类结果：

| 位置 | 三轴中心 | 组内最大 std | 稳定段数 |
|---|---:|---:|---:|
| START | (53.6, 10.3, 24.5) | 38.8 | 13 |
| HONGEST | (410.4, 24.9, 1576.4) | 3.9 | 6 |

中心距离约 **1592.4 mg**，留一验证 **19/19**。

说明：

- 同一 session 内 START/HONGEST 已经能稳定分开；
- START 中包含一些接近但未完全回到同一姿态的段，后续应用固定止位进一步收紧；
- 不要用 `--sequence` 强行按顺序标注，实际采集中会出现额外的短暂稳定段；
  默认自动阈值分类更稳。

### 9.15 固定机械止位后的第二次 session

`static_pairs_3.csv`：

| 位置 | 三轴中心 | 最大 std | 稳定段数 |
|---|---:|---:|---:|
| START | (-137.7, 0.7, -52.4) | 6.5 | 7 |
| HONGEST | (348.8, 33.4, 1585.6) | 5.9 | 8 |

中心距离约 **1709.1 mg**，留一验证 **15/15**。

与固定后的 `static_pairs_2` 比较：

| session | START 中心 | HONGEST 中心 |
|---|---|---|
| `static_pairs_2` | (-167.6, -42.4, -61.2) | (333.9, -15.9, 1574.3) |
| `static_pairs_3` | (-137.7, 0.7, -52.4) | (348.8, 33.4, 1585.6) |

两次中心差约 50 mg，远小于 START/HONGEST 约 1710 mg 的类间距离。
固定止位后，START std 已从约 38.8 mg 降到约 6.5~8.0 mg，效果明显。

### 9.16 固定后的 START/HONGEST 单段复核

| 文件 | 位置 | 三轴中心 | 最大 std | 稳定段 |
|---|---|---|---:|---:|
| `static_start_fixed_1.csv` | START | (327.1, -130.9, -909.0) | 1.3 | 1 |
| `static_hongest_fixed_1.csv` | HONGEST | (508.2, 69.4, 1650.0) | 3.4 | 2 |

中心距离约 **2573.2 mg**。

这进一步确认固定后的 START/HONGEST 在单段采集中非常稳定；但 START 的绝对中心
仍和 `static_pairs_2/3` 不同，所以每次上电/换装贴后仍要做 START 基线，
不能把某一个绝对中心永久写死。

### 9.17 近零 START 的当前 session 配对

用户确认 START 是接近 `(0,0,0) mg` 的姿态。当前有效单段：

| 文件 | 位置 | 三轴中心 | 最大 std |
|---|---|---|---:|
| `static_start_fixed_2.csv` | START | (-11.7, 9.3, -4.1) | 2.8 |
| `static_hongest_fixed_3.csv` | HONGEST | (850.2, -70.1, 717.1) | 2.6 |

中心距离约 **1126.6 mg**。

注意：HONGEST 绝对中心与之前 session 的 `(508, 69, 1650)` 明显不同，
再次证明必须用本 session 的 START 基线，不能跨 session 直接复用三轴中心。

### 9.18 最小范数 START 基线后的第三组 session

绝对 Z 方向会随装贴翻转，因此分类器改用：

- 三轴范数最小的稳定段作为 START 基线；
- 到 START 的距离超过 500 mg 的稳定段作为 HONGEST；
- 不再依赖固定的 X/Z 正负或绝对 Z 门限。

`static_pairs_6.csv` 结果：

| 位置 | 三轴中心 | 最大 std | 稳定段数 |
|---|---:|---:|---:|
| START | (37.0, -1.9, -53.1) | 12.0 | 7 |
| HONGEST | (-502.2, -35.0, -1616.3) | 9.5 | 10 |

中心距离约 **1653.9 mg**，留一验证 **17/17**。

固定后的三组 session 均通过会话内验证：

| session | START std | HONGEST std | 类间距离 | LOO |
|---|---:|---:|---:|---:|
| pairs_2 | 8.0 | 3.6 | 1710.8 | 9/9 |
| pairs_3 | 6.5 | 5.9 | 1709.1 | 15/15 |
| pairs_6 | 12.0 | 9.5 | 1653.9 | 17/17 |

绝对中心仍会随 session 改变，因此固件应使用**每轮 START 标定 + 相对距离**，
不能写死某个三轴中心。

### 9.19 固件诊断模式已实现（不参与 contact）

新增 `posture.h / posture.cpp`：

- `P`：重新采集 START 基线（保持 START 约 2 s）；
- 运行时每 500 ms 取三轴均值；
- **固件**的 `P` 直接记录当前 START 窗口均值；多稳定段的“最小范数”规则只属于离线
  `static_position_analyze.py`，两者不能混写；
- 到 START 的距离 `<150 mg` 输出 START，`>500 mg` 输出 HONGEST；
- `S` 状态输出 `姿态诊断` 行；
- 明确只做诊断，不修改 `contact`。

`P` 现在增加了 START 防误采：闭合角无效，或闭合角超过 `AUTO_ZERO_ANGLE_DEG`
时拒绝采集。重标定成功后旧 START 基线会失效，必须重新按 `P`；`P` 失败时
`S` 会明确显示“沿用旧 START 基线”。

#### 实板验证结果

使用 `_probe/posture_test.py` 在同一串口 session 内完成：

1. 保持 START，发送 `P`；
2. 固件输出：`[POST] START 基线有效：-8.5/0.9/-1.3 mg，样本 1500`；
3. 切到 HONGEST，等待 8 s；
4. 发送 `S`，输出：

```text
接触 0(可信)  闭合角 120°
姿态诊断 | HONGEST d=1762mg x/y/z=597/15/1654 窗口=有效 n=501 基线=-8/1/-1
```

这证明当前诊断链路已经能从 START 基线切到 HONGEST 并正确分类，且正式
`contact` 仍为 0。`P` 在 HONGEST 上的拒绝分支还需要单独复测。

后续实测发现，仅靠闭合角不能防住“启动时停在 HONGEST”的误采，因此 `P` 又加入
`ctDev <= POSTURE_START_MAX_CTDEV_MG`（300 mg）门限。当前版本编译为
368314 B / 30260 B / 0 warning。

最终实板流程验证通过：

- START 上 `P`：`[POST] START 基线有效：-72.2/0.5/-18.2 mg`
- 切 HONGEST 后 `S`：
  `HONGEST d=1708mg x/y/z=536/36/1578 窗口=有效`
- 在 HONGEST 上再按 `P`：
  `#P 拒绝：当前闭合角 115°，请回到 START（<8°）再按 P`

说明 START 基线、HONGEST 分类和 P 防误采三条链路均已通过实板验证。

连续循环复测：

| 次数 | START 基线 | HONGEST 距离 | HONGEST 三轴 | P 拒绝 |
|---:|---|---:|---|---|
| 1 | (-72.2, 0.5, -18.2) | 1708 mg | (536, 36, 1578) | 115° 正确拒绝 |
| 2 | (-6.5, 1.1, -1.7) | 1765 mg | (571, 23, 1666) | 119° 正确拒绝 |
| 3 | (-70.5, 1.4, -17.0) | 1751 mg | (511, 8, 1635) | 120° 正确拒绝 |
| 4 | (-44.8, -29.4, -9.9) | 1708 mg | (525, -24, 1600) | 116° 正确拒绝 |
| 5 | (-25.0, 1.6, -7.5) | 1700 mg | (512, 16, 1606) | 115° 正确拒绝 |

两次在 HONGEST 上误按 `P` 均被拒绝：一次是 102° 角门限，另一次是
`ctDev=1605 mg` 超姿态门限；这些不计入有效循环。5 次有效循环的 HONGEST
距离为 1700~1765 mg，P 防误采全部正确。

### 9.20 `Q` 单行姿态帧与 transition 采集

为避免连续发 `S` 时多行状态串扰，新增单行 `Q` 输出：

```text
#POST cal=... act=... valid=... cls=... d=... x=... y=... z=...
       bx=... by=... bz=... n=...
```

`posture_transition_4.csv` 的 23 个点：

| 区段 | `d` 范围 | 分类 |
|---|---:|---|
| START 稳定段 | 0.3~5.3 mg | START |
| HONGEST 稳定段 | 1741.6~1755.6 mg | HONGEST |
| 回程过渡 | 220~335 mg | UNKNOWN |

150/500 mg 门限对静态 START/HONGEST 很安全，但回程会在 220~335 mg 的
UNKNOWN 区停留约 3 s。该区只能用于过渡诊断，不能作为第三个状态。

### 9.21 `stableCls` 防抖验证

`posture_transition_9.csv`：

| 区段 | raw `cls` | `stableCls` | `stable` | `d` |
|---|---|---|---:|---:|
| START 稳定 | START | START | 1 | 4.1~4.2 mg |
| 离开 START | UNKNOWN | START | 0 | -1（窗口无效） |
| 进入 HONGEST 第 1 窗 | HONGEST | START | 0 | 1740.1 mg |
| HONGEST 稳定 | HONGEST | HONGEST | 1 | 1713~1740 mg |
| 回程过渡 | UNKNOWN | HONGEST | 0 | 161~284 mg |

结论：

- UNKNOWN 不提交为稳定类别；
- 回程时 `stableCls` 保持上一个稳定类别，但 `stable=0`；
- HONGEST 需要连续窗口确认后才切换；
- `stable=1` 才能用于 UI/协议显示，`stable=0` 表示过渡或数据不足。

为防抖新增 `stableCls/stable/stableCount`：连续 3 个 500 ms 窗口同类别后才
提交稳定分类。`posture_transition_5.csv` 验证了启动阶段：

- 首个窗口 `raw=START, stable=0, scnt=2`；
- 下一窗口 `raw=START, stable=1, scnt=3`。

但该次操作没有实际切到 HONGEST，23 个点全部是 START（`d=0.1~5.6 mg`），
因此不能用于 transition 分布；需要重新采一次带 HONGEST 的过渡数据。

实板验证：`P` 成功得到 START 基线，`S` 显示 `d≈0 mg、窗口=有效、n≈502`。
HONGEST 的实际切换还需要继续用 `S` 读取验证。

### 9.22 冻结版实板回归

C1/C3/C5 通过；C6 两次都只有约 6 mg 的 A、F 基本无效，说明没有与转动振源
形成有效耦合；第三次 C6c 的 D 仅 4~55 mg、A 5.9 mg、F 全无效，同样没有
压到振源。C6 需要重新放置振源后重测。姿态诊断没有改变正式 `contact`。

---

## 10. 不采用的方案

- 不用手拍权重的 `0.4*Y + 0.3*Z + ...` 直接接入 `contact`；
- 不在过渡段上计算稳态 Y/Z；
- 不用单次动作或单帧分类结果替代统计验收；
- 不为静态触摸牺牲当前已通过的 80~180 Hz 振动检测；
- 不在比赛固件中引入数据量和部署成本都不合适的神经网络。
