wmsz88/flex-vib-monitor/vibmon_v4/实测记录.md

<!-- 本文件记录 vibmon v4 的验证状态与实板测量准备，与 README.md 配套：README 讲"代码怎么工作"，本文讲"已经证明了什么、还缺什么数据"。 -->
# vibmon v4 测试情况与实板测量记录

> **记录日期**：2026-10-28
> **固件版本**：`vibmon_v4`（默认 `CT_MODE=3`，平放基准 + 姿态/幅值/频率三重与）
> **装贴条件**：检测模块贴**中指指甲盖**，**手指背放**
> **本文分两半**：§1~§3 是**已完成**的验证（编译 + 主机测试）；§4~§7 是**实板测量的准备与空白数据表**，全部待填。
>
> **纪律**：§5 的表格里任何一格没实测就留空，不填推算值、不填占位值。
> `config.h` 里那六个 `TODO(实测)` 阈值在 §5 采完之前一律视为**不可信**。

---

## 1. 装贴条件

### 1.1 姿态定义（每次测量必须复现）

| 项 | 规定 |
|---|---|
| 手指 | **中指**（其余手指自然舒展，不借力压模块） |
| 模块位置 | **指甲盖正上方**，敏感元件（MPU6050）投影落在甲板中心 |
| 手的朝向 | **手指背放** —— 手背朝上、指甲朝上，中指平放于桌面或悬空静止 |
| 固定方式 | 胶带/绑带只压模块板体，**不遮指示灯**，不压住指甲边缘影响振动传导 |
| 排线 | 4PIN 杜邦线自然引出，不与桌面摩擦（避免摩擦噪声进包络） |

> **为什么要把姿态写死**：`CT_MODE=3` 的判据是「当前姿态到基准姿态的距离」。
> 基准是一次采集得来的，姿态不可复现就等于每次换基准，阈值全部作废。

### 1.2 基准采集时机（这条最容易做错）

`CT_MODE=3` 的参考点名字叫「平放基准」，但在本装贴方式下它的真实含义是
**「中指指甲盖 + 手指背放 + 静止」这个零点姿态**，不是"放在桌面上"。

固件上电后的自动流程是：

```
上电 -> dspCalibrate() 自动标定 3.2s（CAL_BIAS_MS 2000 + CAL_NOISE_MS 1200）
     -> stateApplyCal()          —— 这一步会清掉参考点
     -> stateTickFlatRef() 自动采集基准 0.8s（SETTLE 300ms + AVG 500ms）
```

所以**必须按这个顺序操作**：

1. 先把模块贴到中指指甲盖、摆成手指背放；
2. **再**上电/复位；
3. 全程 3.2s + 0.8s **不要动**（含绿灯+黄灯常亮的标定阶段）。

**反例（会静默出错）**：先在桌面上电（采到桌面姿态作零点），再贴到手指上。
此时重力分量在传感器坐标系里的变化会被当成「姿态偏离」，
`flatDist` 可能一上来就超过占位阈值 `CT_FLAT_D_ON_MG = 400mg`，
`contact` 直接判 1 —— **看起来"接触识别很灵敏"，其实是零点错了**。

> 历史实测佐证：v3 的 `CT_MODE=2` 数据里，"松开"态到参考点的距离是 **1082~1750mg**。
> 这个量级说明指关节旋转引起的重力分量变化远大于 400mg，
> 一次装贴姿势错误就足以吃掉整个判据余量。

### 1.3 采到基准的判据（每次开机都要确认）

串口发 `S`，看接触那一行：

| 输出 | 含义 | 处置 |
|---|---|---|
| `接触 0(可信)  平放到 3 mg …` | 基准已采到，可开始测量 | 继续 |
| `接触 采集中… 请让设备保持平放不动` | 正在自动采集 | 等 0.8s |
| `（自动采集 3 次均判定为在动，极差 X>60 mg；请放稳后按 't' 重采）` | 采集失败，**`contactValid=false`** | 停手 -> 按 `t` -> 等 0.8s |
| `接触 0(不可信)  未采到平放基准` | 未采集或已清除 | 按 `t` |

> `CT_REF_AUTO_RETRY = 3` 用尽后不会无限重试。
> 手指悬空静止比桌面静止更容易被 `CT_REF_MAX_SWING_MG = 60mg` 判成"在动"
> —— **建议手指背放时让中指自然搭在桌面上**，而不是悬空。
> 若确实需要悬空测量，先记录这一现象，再决定是否放宽该宏（放宽后要重新验 §5.1）。

### 1.4 重新标定 / 换姿态的连带后果

`stateApplyCal()` 会清掉基准。因此：

- 发过 `c`（重标定）-> **必须**让模块回到 §1.1 姿态，再按 `t` 重采基准；
- 换人 / 换手指 / 换绑带松紧导致甲板朝向变了 -> 同上，按 `t0` 再按 `t`；
- 断线恢复（黄灯 4Hz 快闪后恢复）**不需要**重采：基准跨 `stateReset()` 保留。

---

## 2. 模块上报的振动数据

**本表说明"能拿到什么数据"，不是实测结果。** 实测数值在 §5。

### 2.1 三个可用数据源

| 数据源 | 命令 | 速率 | 用途 |
|---|---|:--:|---|
| `#SWEEP` 行 | `w`（按需打印） | 手动 | **主频 / 幅值 / 到基准距离 + 有效性标记**，阈值采样用它 |
| 绘图组 1 | `1` | 50Hz | `Freq_Hz`、`Amp_mg`、`SS_Hz_x10`、`Vib_x50`、`Contact_x100`，串口绘图器看趋势 |
| 绘图组 4 | `4` | 1kHz 抽取 | 高通后 X/Y/Z 三轴波形，看谐波与削顶（**需 USB CDC**） |
| 打标 CSV | `k0`~`k6` / `K` | 100Hz | 三轴低通值 + `ctDev` + `ampMg` + 状态，看时序与判定翻转过程 |
| `S` 状态汇总 | `S` | 单次 | 结果 + 各项计数 + 标定参数（含 `平放到 … mg`） |
| `T` 时序统计 | `T` | 单次 | 读耗时 / 样本间隔 / 主循环 / 缓冲水位，验采样健康度 |

### 2.2 `#SWEEP` 字段（阈值采样的主数据源）

```
#SWEEP t=12s F=  129.7Hz A=   41.3mg D=     3mg tr=   12mg vib=1 ct=0 grip=1 cliplim=0 ax=2 ok=1
```

| 字段 | 来源 | 单位 | 无效时 |
|---|---|---|---|
| `F` | `Result.freqHz` — 滞回过零 + 线性插值 + 周期中位数 | Hz | `?` |
| `A` | `Result.ampMg` — 三轴合成 30ms RMS 包络 | mg | `?` |
| `D` | `Result.flatDist` — **到基准姿态的距离**（`CT_MODE=3` 第 1 路） | mg | `?`（未采基准） |
| `tr` | `Result.flatRefSwing` — 采基准时窗口内最大单轴极差 | mg | `?` |
| `vib` | `Result.vib` — 启停双阈值 + 3 次确认 | 0/1 | — |
| `ct` | `Result.contact` — 三重与 + 100ms 确认 | 0/1 | — |
| `grip` | `Result.gripNoObject` — 姿态门过 + 幅值可信 + 频率门未过（**空夹诊断**） | 0/1 | — |
| `cliplim` | `Result.freqClipLimited` — 主频因削顶被降级 | 0/1 | — |
| `ax` | `Result.axis` — 本窗主频取用的轴 0=X 1=Y 2=Z | — | — |
| `ok` | `F` 与 `A` 都有效且未降级 | 0/1 | — |

> **`?` 与 `0` 的区别是这套固件的关键设计**：`?` = 没测出来，`0` = 测出来是 0。
> 写数据表时**不能把 `?` 抄成 0**，否则启停/漏检会被统计成"读数为 0Hz"。

### 2.3 量程与削顶线

| 项 | 当前值 | 依据 |
|---|---|---|
| 加速度量程 | **±4g**（`ACCEL_FS_SEL=1`） | `config.h:49` |
| 削顶判定 | `abs(raw) > 32700`，±4g 下 **≈4000mg** | `ACCEL_CLIP_RAW` |
| 加速度带宽 | 260Hz（`DLPF_CFG=0`） | 保住 180Hz |
| 采样 | 1000Hz，I2C 200kHz，只读 6 字节加速度 | `FS_HZ` / `I2C_CLOCK` |
| 时钟源 | 内部 8MHz（`MPU_CLKSEL=0`） | 若 §5.5 抖动偏大改 1 = PLL |

±4g 下 4000mg 的削顶线离指甲盖传导的微振动幅度很远，**预期不削顶**；
`cliplim` 若持续为 1，优先怀疑量程或机械撞击，而不是算法。

### 2.4 能力边界（写对外结论时照这个措辞）

| 项目 | 赛题要求 | 内部可测带 | 硬边界 |
|---|---|---|---|
| 持续振动 | 80~180 Hz | 60~220 Hz | `FREQ_LO_HZ` / `FREQ_HI_HZ` |
| 启停频率 | 0~3 Hz | 0.1~5 Hz | `SS_T_MAX_MS=12000`，最低 0.083Hz |

- 持续振动与完全静止都**不报启停频率**（`ssValid=false`），不是"测得 0Hz"。
- 220Hz 以上不保证：周期过滤在边界处会泄漏，可能给出偏离 >1.5Hz 的截断读数。
- **±2Hz、0.5s 是本组工程目标，不是官方公布的考核标准。**
- 对外只承诺 80~180Hz / ±2Hz。

---

## 3. 测试情况

### 3.1 编译（已完成）

```powershell
arduino-cli compile -b esp32:esp32:esp32c3 --warnings all `
  --build-path "<临时目录>" "D:\大学\课程\工科赛\代码\vibmon_v4"
```

| 项 | 结果 |
|---|---|
| Flash | **355910 B（27%）** / 上限 1310720 B |
| 全局变量 | **25764 B（7%）** / 上限 327680 B，余 301916 B |
| 诊断 | **0 error 0 warning** |
| 工具链 | esp32 内核 3.3.12，FQBN `esp32:esp32:esp32c3` |
| 日期 | 2026-10-28 |

> `README.md` 原写 354912 B，是旧构建数字，已更正。
> 加 `--build-path` 是为了不把 `build/` 产物落进源码目录。
> **尚未复验** `CDCOnBoot=cdc` 版本（绘图组 4 依赖 CDC 模式）。

### 3.2 主机测试回归（已完成）

`test/` 已从烧录版移除。本次从 git 历史 `dc2d2c6` 取回后**链接 v4 真实源码**重跑：

```powershell
$w  = "<临时工作区>"
git -C "D:\大学\课程\工科赛\代码" archive dc2d2c6 vibmon_v2 | tar -x -C $w
$v4 = "D:\大学\课程\工科赛\代码\vibmon_v4"
Set-Location "$w\vibmon_v2"
g++ -std=c++17 -Wall -I test -I $v4 test/host_test.cpp "$v4\dsp.cpp" "$v4\state.cpp" -o host.exe
```

> 用 `git archive` 解到临时目录而不是 `git checkout dc2d2c6 -- vibmon_v2/test`，
> 是因为后者会把 `test/` 落回工作树、并连带恢复 `motor_test.*`，污染烧录包。

| 测试 | 项数 | 结果 | 需要的额外 `-D` |
|---|:--:|:--:|---|
| `host_test` | 14 | 全通过 | 无 |
| `cal_test` | **45** | 全通过 | 无 |
| `gap_test` | 41 | 全通过 | `-DSTATE_TEST_HOOKS` |
| `sweep_test` | 36 | 全通过 | `-DSTATE_TEST_HOOKS` |
| `clip_test` | 38 | 全通过 | 无 |
| `recover_test` | 21 | 全通过 | 无 |
| `sampler_test` | 41 | 全通过 | `-DSMP_TEST_HOOKS` |
| `timing_test` | 24 | 全通过 | `-DSMP_TEST_HOOKS` |
| `wrap_test` | 14 | 全通过 | `-DSMP_TEST_HOOKS` |
| `comp_test` | 29 | 全通过 | 无，且**不链接** `output.cpp` |
| `lock_probe` | 15 | 全通过 | **`-DSMP_LOCK_PROBE`** `-DSMP_TEST_HOOKS` |
| `ct_test` | 23 | **17/23**（6 项失败） | 默认即 `CT_MODE=3` |

`host_test` 关键实测输出（合成信号，1kHz）：

```
[PASS] 持续 80.0Hz   -> 80.01Hz
[PASS] 持续 123.4Hz  -> 123.40Hz
[PASS] 持续 180.0Hz  -> 179.87Hz
[PASS] 弱信号 150Hz/20mg -> 149.68Hz
[PASS] 启停 0.50Hz -> 0.500Hz (3 周期) | 1.20Hz -> 1.204Hz (4) | 3.00Hz -> 3.018Hz (4)
[PASS] 频繁缺样：主频判为无效（不按残缺窗口计算）
[PASS] 断线：全部结果清零
```

### 3.3 `ct_test` 的 6 项失败：是测试过期，不是固件回归

失败项：`T10a 阶跃到接触态后 contact=1`、`T10b 缓慢过渡`、`T10c 进入接触态`、
`T10c 滞回带内(64.0)仍 contact=1`、`T10f 缺口打断后重新累计确认`、`T10g 已确认接触`。

根因：`ct_test.cpp` 的激励只喂**姿态**（默认 `step(devMg, vibAmpMg=0)`），
而 `CT_MODE=3` 要求 `姿态 && 幅值 && 频率` 三路全真才进接触
（`state.cpp combineContact`，进入需三路全真）。测试断言的是 v3 模式 2 的语义。

**旁证（说明不是逻辑坏了）**：

```powershell
g++ -std=c++17 -w -DCT_MODE=2 -I test -I $v4 test/ct_test.cpp "$v4\dsp.cpp" "$v4\state.cpp" -o ct2.exe
./ct2.exe   # -> 全部通过（39/39 项通过，0 项失败）
```

按模式 2 编译就全过，说明状态机与确认链本身工作正常。
但**结论不能反过来**：`ct_test` **没有覆盖模式 3 的幅值门与频率门**，
也就是"空夹判 0、真接触判 1"这条 v4 的核心命题**至今没有任何测试证据** ——
这正是 §4~§5 实板数据要回答的问题。

### 3.4 重跑时会踩的两个坑

| # | 现象 | 原因 | 正确做法 |
|---|---|---|---|
| 1 | `lock_probe` 报 **14/15**：`[FAIL] 确实进过临界区（最大深度 0）` | 漏了 `-DSMP_LOCK_PROBE`，计数钩子没编进去，`g_lockMax` 恒 0 | 加 `-DSMP_LOCK_PROBE`，得 15/15 |
| 2 | 链接报 `stateTestInjectEnv / stateTestPeriods / samplerTestTickBegin was not declared` | 测试钩子默认不编译（正式固件不该带） | `gap/sweep` 加 `-DSTATE_TEST_HOOKS`；`sampler/timing/wrap` 加 `-DSMP_TEST_HOOKS` |

另：`cal_test` 实际 **45 项**，历史文档写的 54 项不符，本表已按实测更正为 45。

### 3.5 明确还没做的事

| # | 未做 | 阻塞 |
|---|---|---|
| 1 | **§5 全部实板数据** | 需装贴 + 激励源，本文档就是为它准备的 |
| 2 | `CT_FLAT_*` 六个阈值定稿 | 依赖 §5.1 |
| 3 | 模式 3 的**空夹 / 真接触**区分能力 | 依赖 §5.1 状态 ②③ |
| 4 | 绘图组 4（三轴波形） | 需 `CDCOnBoot=cdc` 版本复验 |
| 5 | `ct_test` 对模式 3 的断言 | 需给激励函数补幅值与频率 |
| 6 | 比赛帧启用（`COMP_FRAME_ENABLED`） | 需与对接方确认帧口径 |
| 7 | `_probe/check_params.ps1`、`_probe/comp_sniff.py` | **文件不在仓库内**，README 已注明 |

---

## 4. 测量准备（SOP）

### 4.1 需要准备的硬件

| # | 项 | 说明 |
|:--:|---|---|
| 1 | USB 数据线 + 串口 | **同一时刻只能一个程序占用 COM 口**（串口监视器和采集脚本不能同时开） |
| 2 | 12V 电源 + 板上滑动开关 | 走正常供电链路 |
| 3 | **振动激励源** | 偏心马达 / 音圈 / 振动台。**必须有一个可信的参考频率**，否则 §5.2 的误差算不出来 |
| 4 | 胶带或绑带 | 固定于指甲盖，不遮灯、不压甲缘 |
| 5 | 万用表 | 上电前三项检查（`代码/README.md` §四），软件测不出来 |

### 4.2 采集工具

`_probe/capture_measure.py`（本次新增，纯 PC 侧，**不改固件**）：

```powershell
python -X utf8 _probe\capture_measure.py --list
python -X utf8 _probe\capture_measure.py --port COM5 --mode sweep `
    --steps 0:60,4:60,6:60,3:30 --out data\run01
```

| 参数 | 作用 |
|---|---|
| `--mode sweep` | 每秒发 `w`，收 `#SWEEP` 行 -> **采阈值用这个** |
| `--mode label` | 发 `k0~k6` 进打标模式，收 100Hz CSV -> **看时序 / 判定翻转过程用这个** |
| `--steps` | `状态:秒数` 逗号分隔，状态号沿用固件 k0~k6 |
| `--rate` | sweep 发 `w` 的间隔，默认 1s |
| `--settle` | 开串口后的静默等待，默认 8s（标定 3.2s + 基准 0.8s + 余量） |
| `--out` | 输出前缀，生成 `<out>.csv`（解析后）+ `<out>.raw.txt`（原始行取证） |

采完自动按状态分组给 `min / median / max`，并按"取两态之间"原则打印
`CT_FLAT_D / A / F` 建议值与两态余量。**建议值仅供参考，填进 `config.h` 前人工复核。**

> `F` / `A` 无效时脚本在 CSV 里**留空**而不是写 0，与固件的 `?` 语义一致。
> `label` 模式的 CSV **没有 `freqHz` / `flatDist`**，别拿它采阈值。

### 4.3 测量前检查清单

- [ ] 万用表三项检查通过（SDA/SCL 对地 ≤3.3V；开关断开时 5V 轨为 0V；12V 端不短路）
- [ ] 模块按 §1.1 贴在**中指指甲盖**、**手指背放**
- [ ] **先装贴、后上电**，上电后 3.2s + 0.8s 全程不动
- [ ] `S` 显示 `接触 0(可信)  平放到 <100 mg`
- [ ] `T` 显示「读耗时 平均 <500 us」「样本间隔 min/max 接近 1000 us」「缓冲水位 <50%」
- [ ] `#SWEEP` 里 `tr`（基准极差）< 60 mg
- [ ] 记录：日期、室温、激励源型号与设定频率、绑带松紧、中指搭桌面还是悬空

---

## 5. 数据记录表（待填）

### 5.1 六格采样 —— 决定六个阈值

> **本次装贴方案的权威测量计划是 `进度.md` §1~§3 的六格表（C1~C6）**，
> 状态口径为**三态：松手 / 握紧无物 / 接触**，振动开/关只是测量工况，不并入验收状态。
> 每格都要在每个松手朝向下采一遍；测 `C4`（握紧无物 + 振源开）时**振源必须开着**。
> 下面是通用版六格表；手指场景以 `进度.md` 为准，两者数据不要混用。

**每态至少 60s**：`--steps 0:60,4:60,6:60,3:30`

| 状态 | 操作定义 | `D` 到基准 mg<br>min / med / max | `A` 幅值 mg<br>min / med / max | `F` 主频 Hz<br>min / med / max | `ct` | `grip` | `F` 有效占比 |
|---|---|---|---|---|---|---|---|
| ① **空闲** | 手指背放伸直，不碰任何物体（label 0） | __ / __ / __ | __ / __ / __ | __ / __ / __ | __ | __ | __% |
| ② **空夹** | 中指压住**没有振动的东西**（或空气），有抖动但无物体共振（label 4） | __ / __ / __ | __ / __ / __ | __ / __ / __ | __ | __ | __% |
| ③ **真接触** | 中指压住**正在振动**的测试件（label 6） | __ / __ / __ | __ / __ / __ | __ / __ / __ | __ | __ | __% |
| ④ **释放** | 回到 ①，确认各量回落（label 3） | __ / __ / __ | __ / __ / __ | __ / __ / __ | __ | __ | __% |

**填完先看这三件事**：

1. **①与② 的 `D` 区间分得开吗？** -> 决定 `CT_FLAT_D_ON/OFF`（占位 400/280）。
   若 ① 的上限就超过 400，说明基准采错了或姿态不可复现 —— **先解决装贴复现性，不要调阈值**。
2. **②与③ 的 `F` 区间分得开吗？这是 v4 的核心假设** -> 决定 `CT_FLAT_F_ON/OFF`（占位 120/90）。
   **若 ② 的 `F` 中位数已 ≥120，或两区间重叠，"用频率区分空夹"这条设计就不成立**，
   得回到方案层面重想（幅值门承担更多、或改用接触前后的差分特征）。
3. **②与③ 的 `A` 分得开吗？** -> 只用于排除"握住静止"，不承担区分空夹（占位 30/20）。

### 5.2 主频精度（对外承诺 ±2Hz）

| 参考频率 Hz | 测得中位 Hz | 误差 Hz | ≤±2Hz? | `ax` 取用轴 | `cliplim` | 备注 |
|---|---|---|---|---|---|---|
| 80 | __ | __ | __ | __ | __ | 赛题下限 |
| 100 | __ | __ | __ | __ | __ | |
| 130 | __ | __ | __ | __ | __ | 队内基准点 |
| 160 | __ | __ | __ | __ | __ | |
| 180 | __ | __ | __ | __ | __ | 赛题上限 |
| 70 | __ | __ | __ | __ | __ | 带内边缘 |
| 200 | __ | __ | __ | __ | __ | 带外：不保证 |

### 5.3 启停频率 0~3Hz

| 设定 Hz | 首次出数用时 s | 测得中位 Hz | 误差 | 停止后是否立即失效 | 备注 |
|---|---|---|---|---|---|
| 0.1 | __ | __ | __ | __ | 接近下限 0.083Hz |
| 0.25 | __ | __ | __ | __ | |
| 0.5 | __ | __ | __ | __ | |
| 1.0 | __ | __ | __ | __ | |
| 2.0 | __ | __ | __ | __ | |
| 3.0 | __ | __ | __ | __ | 赛题上限 |

### 5.4 响应延迟（工程目标 0.5s）

| 场景 | 次数 | 起振->`vib=1` | 停振->`vib=0` | 接触->`ct=1` | 松开->`ct=0` |
|---|---|---|---|---|---|
| 突然起振/停振 | __ | __ ms | __ ms | — | — |
| 突然压住/松开 | __ | — | — | __ ms | __ ms |

> 理论下界：包络窗 30ms（`ENV_WIN=30`）+ 启停 3 次确认 ≈30ms；
> 接触还要加 `CT_CONFIRM_MS=100ms`（三路门全过之后）。
> 实测若远大于此，先查 `T` 的输出耗时与缓冲水位，再怀疑算法。

### 5.5 采样健康度（`T` 命令）

| 指标 | 本次 | 期望 |
|---|---|---|
| 读耗时 平均 / 最大 us | __ / __ | <500 / <1000 |
| 样本间隔 min / max us | __ / __ | 接近 1000 |
| 缺样次数 / 抖动次数 | __ / __ | 0 |
| 读失败次数 | __ | 0 |
| 缓冲水位最高 % | __ | <50% |
| 削顶次数 | __ | 0 |

### 5.6 重复性（每次开机都要能复现）

| 开机序号 | `tr` 基准极差 mg | ① 态 `D` mg | ③ 态 `D` mg | 备注 |
|---|---|---|---|---|
| 1 | __ | __ | __ | |
| 2 | __ | __ | __ | |
| 3 | __ | __ | __ | |

> 三次开机 ①/③ 的 `D` 若飘移 >±50mg，结论是**姿态不可复现，不能定阈值**，
> 需先改装贴方式（加定位块 / 换绑带 / 换固定位置）。

---

## 6. 阈值填写规则

采完 §5.1 后按此填 `config.h:224~249`：

```
CT_FLAT_D_ON_MG  = ①上限 + (②下限 - ①上限) * 0.75    // 占位 400
CT_FLAT_D_OFF_MG = CT_FLAT_D_ON_MG * 0.7              // 占位 280
CT_FLAT_F_ON_HZ  = ②上限 + (③下限 - ②上限) * 0.75    // 占位 120  <- 最关键
CT_FLAT_F_OFF_HZ = CT_FLAT_F_ON_HZ * 0.75             // 占位 90
CT_FLAT_A_ON_MG  = "握住静止"与"正常抖动"之间          // 占位 30，仅排除静止
CT_FLAT_A_OFF_MG = CT_FLAT_A_ON_MG * 0.67             // 占位 20
```

**四条硬约束**（`config.h` 末尾有编译期检查，违反直接编译报错）：

| 约束 | 违反后果 |
|---|---|
| 三组都要 `OFF < ON` | 滞回带反了，接触在阈值处反复抖动 |
| `CT_FLAT_F_ON_HZ <= 220` | 高于 `FREQ_HI_HZ` 则接触永远不可能成立 |
| `CT_FLAT_F_OFF_HZ >= 60` | 低于 `FREQ_LO_HZ` 则空夹时主频被下限钉住，退出条件永不满足 |
| `*_INT` 整数副本要与浮点原值同步改 | 编译期检查用的是 `_INT` 版本，只改浮点会绕过校验 |

填完做两件事：

1. 重跑 §5.1，确认 ②（握紧无接触 + 振动）判 `ct=0 且 grip=1`、③（真接触）判 `ct=1`
   —— **注意：主机探针显示按当前判据这两条同时成立做不到**（② 会误报 `ct=1`，
   静止的 ③ 会漏报 `ct=0`）。若实测复现，必须先走 `进度.md` §4.2 改结构，不能只调阈值。
2. 两个 FQBN 都编译一遍（`esp32c3` 与 `esp32c3:CDCOnBoot=cdc`）。

---

## 7. 已知风险与待观察

| # | 风险 | 为什么会出问题 | 怎么验 |
|:--:|---|---|---|
| 1 | **基准姿态 ≠ 测量姿态** | 在桌面上电采了桌面零点，再贴到手指（§1.2 反例） | §5.6 重复性表 |
| 2 | **悬空静止采不到基准** | `CT_REF_MAX_SWING_MG=60` 对手抖敏感，重试 3 次就放弃 | 看 `S` 是否报"3 次均判定为在动" |
| 3 | **频率门分不开空夹** | v4 假设"空夹没有物体共振所以频率上不去"；若皮肤/指甲/指骨本身把激励传成结构共振，② 的 `F` 会和 ③ 一样高 | §5.1 第 2 条，**最可能推翻设计的一条** |
| 4 | **接触靠关节旋转而非压力** | v3 实测过：轻触不转测不到。模块在指甲（远节指骨），DIP 关节转角直接改重力分量 —— 对本装贴方式是好事，但意味着"压得重但完全不动"测不出来 | §5.1 状态 ② 里补一次"压住但绝不转指"的采样 |
| 5 | **`ax` 取用轴在态间切换** | 主频自动选交流能量最大的轴；换激励方向或换绑带松紧，主轴可能从 Y 跳到 Z | §5.2 的 `ax` 列 |
| 6 | **USB CDC 未复验** | 绘图组 4（三轴波形）只能在 CDC 模式看；非 CDC 下 `Serial` 走 GPIO21/20 | §3.1 补一次 `CDCOnBoot=cdc` |
| 7 | **比赛口静默** | `COMP_FRAME_ENABLED=0`，4PIN 上**一个字节都不发**，现场联调前必须先定帧口径 | §3.5 第 6 条 |
| 8 | **禁止 Wi-Fi/BLE** | AMS1117 压差 7V、Pd≈0.4W，射频峰值 300mA 会热关断 | 代码里无任何 `WiFi`/`BLE` 调用，改代码时别引入 |
