wmsz88/flex-vib-monitor/vibmon_v5/结果/RT014-20261108.md

# RT014-20261108 — v8 分层检测代码改动与编译验证

任务号: T014
执行模型: EXEC (flash)
执行日期: 2026-11-08
署名: 2026-11-08 00:45 · flash (EXEC)
基线: git `a6dc1a1`（v8 初版）+ 本轮未提交实操改动

## 改动摘要（做了什么）

1. **新增 `vibmon_v8` 实验目录**
   - 由 `vibmon_v6` 复制；
   - `vibmon_v6.ino` 改名 `vibmon_v8.ino`；
   - V6 与 V7 均未改动。

2. **新增分层模块**
   - `layered_detection.h`
   - `layered_detection.cpp`

3. **接入 `state.cpp`**
   - 新增 `LayerInput s_layerInput`；
   - `stateReset()` 中调用 `layerInit()`；
   - `stateOnFrame()` 的 `envReady` 分支中调用 `layerPush()`；
   - 不修改 V6 现有 `Result` 判据。

4. **接入 `output.cpp`**
   - `d` 调试模式下新增：

```text
#LAYER vib= ct= stable= fmed= fspread= amed= aspread= ssmed= valid=
```

5. **`config.h` 新增分层参数**
   - `LAYERED_DETECT_ENABLE`
   - `LAYER_WINDOW_N`
   - `LAYER_VIB_HI_MG`
   - `LAYER_VIB_LO_MG`
   - `LAYER_VIB_CONFIRM`
   - `LAYER_FREQ_SPREAD_MAX`
   - `LAYER_ENV_SPREAD_MAX`
   - `LAYER_VALID_RATIO_MIN`

6. **修正分层推送节奏**
   - 初版曾把 `layerPush()` 放在 `stateOnFrame()` 末尾；
   - 本轮移入 `envReady` 分支；
   - 原因：`f.env` 只有在 `envReady` 时有效，1kHz 全量推送会混入 0 值，破坏实时确认计数与滑窗统计。

7. **新增宿主测试**
   - `test/layered_detection_test.cpp`
   - 覆盖实时振动、实时接触、稳态判据、稀疏有效率、滑窗行为。

8. **`run_all.ps1` 纳入新测试**
   - `layered_detection`
   - `v6_fallback`

## 测试数据（测到什么）

### 1. 全量宿主测试

```text
contact_test      89/89
gyro_test          8/8
comp_frame_test   22/22
dump_test        15/19（4 项既有列数失败）
ss_replay         可运行
layered_detection 11/11
v6_fallback       89/89
```

全部 0 warning。

### 2. 宏关闭回归

显式编译：

```text
-DLAYERED_DETECT_ENABLE=0
```

结果：

```text
comp_frame_test 22/22
contact_test    89/89
CDC 构建        0 warning
```

说明 `LAYERED_DETECT_ENABLE=0` 时：

- `state.cpp` 不再调用 `layerInit / layerPush`
- `output.cpp` 不再输出 `#LAYER`
- V6 行为可回退

### 3. 双 FQBN 编译

| FQBN | Warning | Flash | RAM | `.bin` SHA-256 |
|---|---:|---:|---:|---|
| `esp32:esp32:esp32c3` | 0 | 369904 B | 30932 B | `9a0dbf9c…` |
| `esp32:esp32:esp32c3:CDCOnBoot=cdc` | 0 | 375014 B | 31108 B | `7a7a0b2a…` |

### 4. 分层宏关闭 CDC 构建

```text
FQBN     esp32:esp32:esp32c3:CDCOnBoot=cdc
Warning  0
Flash    371996 B
RAM      30332 B
```

### 5. RAM 变化

V6 CDC 基线 RAM 约 30340 B。

V8 CDC：

```text
分层开启: 31108 B (+768 B)
分层关闭: 30332 B
```

增加来自固定长度滑窗数组与统计缓存，无动态内存分配。

## 数据结论（结论是什么）

1. V8 已在 V6 基础上完整接入分层检测：
   - 实时层：`vib / contact`
   - 均匀层：`stable / fmed / fspread / amed / aspread / ssmed / valid`
2. 分层输出不改变 V6 判据：
   - contact_test 保持 89/89
   - comp_frame_test 保持 22/22
   - `$VD` 帧默认仍为 35 字节
3. `LAYERED_DETECT_ENABLE=0` 可完整回退 V6 行为。
4. 双 FQBN 均 0 warning。
5. V8 仍不是最终版：
   - 尚未实板验证
   - 尚未采集 `#LAYER`
   - 最终版仍为 V6

## 异常与未解决项

1. 未上实板。
2. `#LAYER` 未实测。
3. 尚未确认 50Hz `$VD` 输出与 `#LAYER` 调试行是否互相干扰。
4. `dump_test` 4 项失败为既有列数问题，未处理。

## 下一步实测流程

1. 用 CDC 构建烧 V8；
2. 打开调试口，发 `d`；
3. 确认 `#LAYER` 出现；
4. 空握 10 次：
   - 预期 `vib=0`
   - 预期 `ct=0`
   - 预期 `stable=0`
5. 持续振动接触：
   - 预期 `vib=1`
   - 预期 `ct=1`
   - 预期 `stable=1`
6. 松手：
   - 预期 `ct=0`
7. 启停振动：
   - 预期 `ssmed` 正确
   - `stable` 允许为 0
8. 再烧 `LAYERED_DETECT_ENABLE=0` 版本：
   - 预期无 `#LAYER`
   - `$VD` 仍 35 字节
