wmsz88/flex-vib-monitor/vibmon_v5/规划/plan.md

# plan.md — 项目方向与推进状态

> **本文件只有两个规划模型（glm5.3 / deepseekv4pro）有权修改。** flash 无权更改（本文件位于 `规划/` 禁区）。
> 任一规划模型每轮推进时更新本文件：读 `结果/` 的数据结论 → 更新方向 → 在「规划日志」追加一行（日期 + 署名 + 决策）。改前先读日志，确认另一侧没有正在推进的 `doing` 卡。

## 项目目标

赛前冲刺。依据 PLANNER-A 2026-11-02 评审（`大模型/评审报告_20261102.md`）：项目方向已验证通过（姿态+振动双轴架构，宿主测试 contact 43/43、gyro 8/8、comp_frame 22/22，实板下扫通过）。本轮目标：**在不破坏已冻结配置（CT_MODE=4、UART_SWAP=1、COMP_FRAME_ENABLED=1、CDCOnBoot=cdc）的前提下**，完成评审提出的赛前建议改动（代码部分），随后按 `小模型/检验方案.md` 的 P0→P1→P2 顺序组织实板检验。

## 当前阶段

**2026-11-06 13:40 · glm5.3 (PLANNER-B) 当前口径（覆盖下方 11-05 旧口径）：**

1. **任务状态**：T001~T013 done；T010 done（2026-11-06 23:30 验收）；**T014 doing，当前在办**。
2. **出发固件已拍板（2026-11-06 19:50 人类选择 V6）**：基础出发语义 = `代码\vibmon_v6\` 接触三条版；**现场适配版 = `代码\vibmon_v7\`**（在 v6 基础上增加黄灯 CT 闪、`y` 三态命令与三只默认关的现场门控宏；判据链逐字节相同）。当前板上为 v7 `def` CDC 构建。v6 保持 T013 验收原样，v5 仅作回退语义说明。
3. **⚠ 事实勘误**：`vibmon_v5\config.h` 现为 `CT_HOLD_ENABLE=1`，并含 T011 进入路径与 SS 门 120/80；实板 SHA `e945d958…` 对应 RT011-20261106。**旧口径「v5 出发固件 hold 关」作废**，不能再按该口径宣传或验收。
4. **场外流程**：T011/T012 已收口；后续回到「规划侧 → flash」派卡流程，不再重开场外卡。

以下为 11-05 旧口径，仅作历史追溯：

**T001~T008 全部 done（2026-11-03 23:08 T008 验收通过）。当前在办卡：T009（振动源驱动器，**doing：11-04 23:25 阶段 1 验收达标带 1 待修 bug——自动模式 OFF→ON 双重踢破坏 2/3Hz 档周期，待 flash 一行修复重烧；之后人类按键实测回传**；23:30 派发、23:45/23:52 两次修订、11-04 18:30 弃 C8T6 改回 ESP32、**18:40 四改：去 OLED 用串口**，人类 m01061/m01087）——分工：flash 写代码并协助交结果、人类做实板测试、规划模型出规格与验收。** 赛前主线已收官：判据链（T004~T006）+ 帧格式（T008 实板逐帧核对：默认 3008/3008 校验错 0 恒 35 字节、CL 构建 1512/1512 恒 37 字节核毕烧回默认）+ 平台行为（T008 P3：接触 ct 98.5%、关源退出 0.30s、1Hz 启停 SS=1.00）三方证据齐备；答辩材料就绪（答辩\答辩材料主文档.md + 问答预案 12 条）。**出发固件=默认构建（35 字节，CL=0）已核验烧回。** T009 最终规格（ESP32+按键+串口版，改动量最小）：在 vibsource_esp32_dual 基础上**只加 4 个按键**，串口命令行与状态打印沿用现状（每次按键后走 printStatus 路径+补模式行），无 OLED、无新库；KEY1 短按三态循环（新→旧→关，切源即停另一路）、长按 ≥1s 切手动/自动；KEY2 跳各振子默认占空比（自动模式复用为周期档切换 0.5/1/2/3Hz）；KEY3/KEY4 占空比 ±5% 夹取；自动 ON 固定 85%；引脚：PWM_A=GPIO3（新振子）/PWM_B=GPIO4（旧振子）沿用现接线、KEY1=GPIO7/KEY2=GPIO10/KEY3=GPIO0/KEY4=GPIO1、LED=GPIO8、GPIO5/6 空出；新工程 Desktop\STM32project\vibsource_c3_key\（拷贝增量改，原工程与 vibmon_v5 双零改动）。唯一其它剩余事项：平台对接 C4 到场进行。赛场要点（T008 沉淀）：USB-TTL 与模块必须共地否则收 0 字节（比赛 4pin 自带 GND 天然满足）、波特率 115200、帧率 50Hz、TX=GPIO21/RX=GPIO20。两项定性沉淀入答辩材料：①锁存——有意设计，关源 0.42s/0.30s 正常退出（T005/T008）；②E-180——本地稳态上限 175.7Hz + 瞬态测频 201.4Hz 背书（T006）。通道档案（T006 修正，固定前提）：a/GPIO3=新低速振子 71~120Hz、b/GPIO4=原振子 101~175.7Hz，脚本默认对调；新固件标签直接按实况命名（A=新、B=旧）。**T009 已并入补充任务 B（人类 23:55 选 C 方案、00:00 指示不开新卡）：启停 CT 保持门控 `CT_HOLD_ENABLE` 默认 0——开宏版作赛场备选固件（启停段 CT 连续 ≥95%、关源退出代价 0.42s→≈1.2s），现场双固件二选一；执行顺序=任务 A 剩余项（修双重踢/按键实测/默认占空比）先行，再做任务 B。** **11-05 09:40 曾并入「补充任务 C：比赛 LED 预案」，09:45 人类改指示（m01349）移出为独立 T010 卡（现场适配预案清单）——T009 范围恢复为任务 A + 任务 B。**

## 已推进任务记录

| 任务号 | 主题 | 结果文件 | 推进判定 | 推进日期 |
|---|---|---|---|---|
| T001 | 比赛帧增加 CL 字段（配置门控） | RT001-20261102.md | ✅ 达标（独立复跑 22/25/46/8 全过，默认帧与 HEAD 逐字节一致，冻结宏未动） | 2026-11-02 |
| T002 | 新增 D 命令（DUMP 模式） | RT002-20261102.md | ✅ 达标（dump_test 19/19，改动隔离成立，$VD 路径零改动） | 2026-11-02 |
| T003 | 历届赛题调研：无振动接触要求（支线，不阻塞主线） | RT003-20261102.md | ✅ 达标（六年逐届判定：无一届要求无振动接触；PLANNER-B 复核 2021/2022/2023 PDF 原文一致） | 2026-11-02 |
| T004 | 实板检验第一轮：P0+P1+双振源+T1工单+A5（硬件修复后） | RT004-20261102.md | ✅ 达标（带3缺项：E-80/E-180端点、D接触样例、START基线 → 并入下卡） | 2026-11-02 |
| T005 | 接触退出行为诊断 + 边界端点补测 | RT005-20261102.md | ✅ 达标（锁存主因=频率证据单独续命经源码+实测双重确认；D2 未复现锁存；E-80 边缘达标；纠错 T004 验收误读成立） | 2026-11-02 |
| T006 | E-180 端点振源排查 + 通道标签对调确认 | RT006-20261102.md | ✅ 达标（通道映射三轮一致；E-180 定性接受本地稳态上限 77~175.7Hz；复核 3 瑕疵不动摇结论；23:44 复盘补瞬态测频背书 201.4Hz） | 2026-11-02 |
| T007 | 答辩材料整理（收官文档卡） | RT007-20261103.md | ✅ 达标（主文档四块+速查、问答预案12条；验收方独立抽查5组数字全对上：201.4Hz三行/D样例907~938mg/A1~A5五轮/稳态175.7Hz ct 7~8/8/帧35~37字节；flash主动规避T006基线误引） | 2026-11-03 |
| T008 | 串口模拟赛场验证（$VD 帧实板核对 P4 + 平台场景模拟） | RT008-20261103.md | ✅ 达标（P1 3008/3008 校验错 0 恒 35 字节、P2 CL 1512/1512 恒 37 核毕烧回、P3 接触 ct 98.5%/退出 0.30s/SS=1.00；CHK 抽 6 帧手工重算全中；零改动经源码时间戳核实；2 瑕疵：RT 表 s3 F 81.7Hz 对不上任何数据应为 126.2Hz、P3 存解析 CSV 非原文） | 2026-11-03 |
| T009 | 振动源驱动（11-05 18:05 定案：弃 c3_key，**回归 vibsource_esp32_dual 原版**，按键已实现未实测）+ **补充任务 B：启停 CT 保持门控（hold 版已烧已自证，0.5/1Hz 验收通过）**；B-2 进入门放宽已被人类 11-06 00:05 拍板暂缓，由 T011/T012 承担 | RT009-20261104.md（11-03 旧方案版作废）、RT011-20261106.md | ✅ done（任务 A 回归 dual 结案；任务 B 实板验收；B-2 暂缓记录在案） | 2026-11-06 |
| T010 | 现场适配预案清单（17 项可能更改 × 每项 ≥3 种情况参考；产出手册+预编译固件变体+黄灯 CT 闪/y 命令；11-05 09:45 人类 m01349 指示独立开卡）——**flash 誊手册+预编译+码改、人类实测** | RT010-20261106.md | ✅ done（v7 独立项目；宿主 contact 89/89、gyro 8/8、comp_frame 22/22、led 64/64、dump 15/19；7 变体 0 warning；实板黄灯 CT 1/0/1 三段 71/75/41 帧、`y` 三态、$VD 506 帧全 35 字节 CHK 全对） | 2026-11-06 |
| T011 | 启停节奏进入接触（场外） | RT011-20261105.md、RT011-20261106.md | ✅ done（场外收口；2/3Hz 稳定段 CT 100%；后续由 T012/v6 接替） | 2026-11-06 |
| T012 | v6 接触三条（场外） | RT012-20261106.md、RT012-20261106b.md | ✅ done（两轮实板；松手掉 0、停振保持、无振动夹物 0；`#V6` 取证遗留转 T013） | 2026-11-06 |
| T013 | v6 出发版收口与烧录验证（不改判据；回放复现 + 双 FQBN + v5/v6 对照 + `#V6` 体检） | RT013-20261106.md | ✅ done（宿主全绿；双 FQBN 0 warning；关键回放复现；空握 0/10 误进；旧 2Hz CT 176/176；松手退出 20~396ms；帧 35 字节；关源手握 16.4s 不退） | 2026-11-06 |
| T014 | v8 分层检测（实时层 + 均匀/稳态层；独立实验线，不改 V6/V7，不改 `$VD`） | （待交） | doing（初版宿主测试已通过，待双 FQBN + 实板验证） | — |

## 下一步方向

T001/T002 完成并过验收后，转入实板检验阶段：按检验方案 P0（硬件可靠性 H1~H4，人工+实板）→ P1（核心判据 A1~A5）→ P2（频率精度 F1~F7）执行。实板测试沿用既定模式：脚本后台连续采集 + 语音播报逐步提示 + 人工做动作一轮跑完（参考 `..\vib_range_test\实板测试模式.md`）。检验数据由 flash 采集后写入 `结果/`，规划侧据此判定是否需要返工卡。

**历史规划遗留项并入检验阶段**（源自 `当前状态.md` §11/§13，读毕核对）：

1. **T1 工单**（§13）：真接触 → 抽走马达但保持振源开启 → 观察 ct 是否退出。并入检验 A4（接触退出）一起做，判读标准照 §13：100~300ms 掉 0 正常 / >5s 保持规则过宽 / 跳变查滞回。在抽走马达数据前**不改** `combineContact` 保持规则。
2. **4cm 方块 + 新旧振源优先检验**（人类 2026-11-02 指示，取代原 5cm C6 补测的优先级）：现有 4cm 方块 + 两台振源（原振子约 102~182Hz、新低速振子约 80~128Hz，上下限互补覆盖赛题 80~180Hz），比 5cm 工况更接近比赛，**优先做**。方案：4cm 方块夹持，分别用原振源（高频段）与新振源（低频段）激励，验证两段频带内 ct 判据与 F 读数（可并入 P1/P2 检验项执行）。5cm C6 工况降为次要，仅在上项通过且有余量时补测。
3. **5 轮重复性验收**（§11 恢复前置条件第 5 条）：对应检验 A5，此前 5cm/4cm 5 轮均因机械夹持失败或 I2C 掉线无效，硬件修复后必须重做。
4. **陀螺量程核对**：~~待核对~~ **已闭环**（2026-11-02）：RT001/RT002 附带回传 `GYRO_FS_SEL=1 → GYRO_CONFIG=0x08 = ±500dps`，与 `陀螺仪改造方案.md` §2 建议一致，无需开卡。

## 风险点

1. **出发固件待拍板（P0）**：v5 与 v6 都有实板证据，但适用前提不同。v5/T011 解决启停保持，v6 改接触语义（进入更严、保持不看加速度、分离只看陀螺）。T013 需输出完整对照表并采集 `#V6`，人类拍板前不能宣称最终版本。
2. **v5 描述与现实不一致（P0）**：`vibmon_v5\config.h` 已是 hold/T011 行为，不再是旧口径的「hold 关默认版」。旧文档、答辩材料和说明若仍写默认 hold 关，需在 T013 中逐条勘误，避免现场误烧或误答。
3. **v6 `#V6` 调试行未采（P1）**：RT012 对旧振子 2Hz 掉线的「来回摆」解释只有现象级证据。若 T013 实板采到 `lpW/moved` 且修正后无掉线，则可作为已修证据；否则需要继续诊断。
4. **dump_test 列数问题（P2）**：v6 与 v5 均为 15/19，既有问题，不阻塞出发拍板；T013 记录即可，不建议赛前重构。

旧风险点见下。

1. ~~**最大风险：MPU6050 I2C 物理连接**~~ → **人类已确认硬件修复（2026-11-02）**。仍需按 H1/H3 程序留下量化证据（静止60s I2C错=0、弯折3min 无FAULT），作为检验 T004 第一步，不再视为阻塞项。
2. **比赛帧格式未与现场平台确认**：评审建议1 的前提（平台可调帧格式）未定。故 T001 采用编译期宏 `COMP_FRAME_CL` 门控、**默认关闭**（默认行为与现在逐字节一致），现场确认可调后一行配置打开。此为 PLANNER-B 对建议1 的实现方式细化，不改变 PLANNER-A 的前提判断。
3. **AUTO_ZERO 意外窗口**：比赛中手指停在张开位附近静止≥2s 会悄悄更新基准（评审§2.2）。现场 SOP（检验方案「操作循环」第8步）已含"张开静止2s等重采"，属可控，暂不改代码。
4. **COMP_FRAME_ENABLED=1 已冻结**：到场若平台要求先不发数据，需快速改 0 重烧（人工操作，已列入 T001 验证项确认冻结值未被误动）。

## 规划日志

- 2026-11-07 00:10 · glm5.3 (PLANNER-B)：**按人类指示派卡 T014（doing）**。目标：新建 `代码\vibmon_v8\` 分层检测实验版，拆分实时层（VIB/CT）与均匀/稳态层（滑窗中位数、离散度、有效率、stable），新增 `#LAYER` 调试行；不改最终版 V6、不改参考版 V7、不改 35 字节 `$VD` 帧。flash 已完成初版代码与宿主测试：contact 89/89、gyro 8/8、comp_frame 22/22、dump 15/19、ss_replay 可运行、layered_detection 8/8，全 0 warning。剩余：双 FQBN 编译、`#LAYER` 实板验证、RT014 交付。
- 2026-11-06 23:30 · glm5.3 (PLANNER-B)：**验收 T010，done**。独立复跑 `vibmon_v7\test\run_all.ps1`：contact 89/89、gyro 8/8、comp_frame 22/22、led 64/64、dump 15/19（4 项既有失败）、ss_replay 可运行、0 warning；独立核验 v6/v7 判据链文件 SHA 逐字节一致，v7 实际改动仅 `config.h`、`output.cpp`；七个变体 `.bin` 大小与 SHA 与清单一致；独立解析 `黄灯CT联动8.txt` 得 ct=1→0→1 三段 71/75/41 帧；独立解析 `帧格式-300帧.txt` 得 506 帧、行长 33+CRLF=35 字节、SEQ 断续 0、CHK 0 错。人类指示“不改原文件、另建项目”落实为 `vibmon_v7\`，v6 恢复 T013 原样。已知遗留：Fluent Serial Assistant 生成的原始捕获 `serial_log_20261106_231226...` 误放在 `vibmon_v6\测试\V6\` 且被程序占用，有效副本已归档到 v7；关闭串口助手后删除误放文件即可，不影响验收。
- 2026-11-06 19:50 · glm5.3 (PLANNER-B)：**人类拍板出发固件 = V6**。依据 RT013 出发判断表：v6 空握 0/10 误进、旧振子 2Hz CT 176/176、松手退出 20~396ms、帧格式不变，符合接触语义优先目标；接受其语义差异：振源关闭但手仍夹住时 CT 保持 1。执行动作：T010 转 doing，围绕 v6 完成现场适配手册、预编译固件变体、黄灯 CT 闪 + `y` 命令；v5 仅作回退版归档。
- 2026-11-06 19:40 · glm5.3 (PLANNER-B)：**验收 T013，done**。独立复跑 `run_all.ps1`：contact 89/89、gyro 8/8、comp_frame 22/22、dump 15/19（4 项既有失败）、ss_replay 可运行、0 warning；独立运行 V6b 分析脚本复核：空握 350 帧 CT=0；旧 2Hz 目标窗 #V6=176、CT=176/176、`lpW` 中位 0.2dps、`settled` 100%、`moved` 0.9°；两轮 8 次松手退出 20~396ms；帧 35 字节、SEQ 断续 0、CHK 5/5。关键发现：①v6 的保持语义是**只要手仍保持姿态、即使振源关闭也 CT=1**（第二轮尾部 16.4s、A≈5~6mg 仍为 1），这与 v5 关源 0.30~0.42s 退出是重大语义差异；②检查 B 的语音提示有 2.0~2.3s 固定延迟，不能当松手时刻，RT 用 AMP 塌陷定位是正确方法；③`.bin` SHA 因时间戳/ELF 指纹不可复现，不能作为唯一版本标识，应记录源码提交 + FQBN + 构建产物路径。当前下一卡 T010，开工前需人类拍板出发版本。
- 2026-11-06 13:40 · glm5.3 (PLANNER-B)：**收口场外交接并派卡 T013（doing）**。动作：①T009/T011/T012 全部转 done；②发现 `vibmon_v5\config.h` 实为 `CT_HOLD_ENABLE=1` + T011 行为，plan.md 旧「v5 默认 hold 关」口径作废并写入风险；③新增 `tasks\T013-v6出发版收口与烧录验证.md` 并派发，要求不改判据，仅做回放复现、双 FQBN、v5/v6 对照与 `#V6` 实板体检；④T010 保持 todo，当前排队=T013 结束后开工（手册可先备，固件变体等 v5/v6 拍板后定）；⑤本轮未改任何固件代码。
- 2026-11-06 13:10 · Claude (OUTSIDER)：**场外工作结束（人类指示），交其他模型收尾**。T011、T012 转 done。交接要点：①建议出发固件 v6（`代码\vibmon_v6\build_uart\`，SHA 0bf3c2fd…），v5 默认版备份，人类未最终拍板；②T009 卡状态与 B-2 暂缓未由本侧改动，需规划侧更新；③`config.h` 中 `CT_HOLD_ENABLE` 在 v5 现为 1（与本文件「出发固件=默认构建 CL=0、hold 关」不一致），收尾时需确认；④未采集 `#V6` 调试行；⑤结果见 RT011-20261105/20261106、RT012-20261106/20261106b。

- 2026-11-06 12:50 · Claude (OUTSIDER)：**v6 第二轮固件实板通过**（V6\6~8.txt）。旧振子 2/3Hz 接触只在人类两次松手时退出、3Hz 读数恢复；0.5Hz 接触后 3.3~3.8s 出读数（接近 2 周期下限）；空握/4cm 无振动 CT 全 0。人类追问「接触物体时的抖动能否判接触」：空握与夹 4cm 的撞击峰值 172~1167mg 与 152~887mg 完全重叠，不可行。无代码改动。

- 2026-11-06 13:00 · Claude (OUTSIDER)：**v6 实板第一轮分析 + 三处修正**（RT012-20261106b）。三条规则实板生效。修正：SS 门 180/150→120/80（旧振子 3Hz 0%→59%）、接触中启停取最新一致段（0.5Hz 首读数提前 4s）、分离改净转角（旧振子 2Hz 掉线推测修正）。无振动接触结论：空握与夹 4cm 方块闭合角完全重叠（100~161° vs 110~144°），不能靠角度判。固件 SHA 0bf3c2fd…，待实板。

- 2026-11-06 01:30 · Claude (OUTSIDER)：**人类授权开 v6（T012 场外）**，代码在 `代码\vibmon_v6\`，v5 冻结不动。接触改为三条：进入 = 收拢 + 手指停下（陀螺 4Hz 低通 <10dps 持续 150ms）+ 振动证据；保持不看加速度、无超时；分离只看陀螺（张开或再转 10°）。宿主 85/85，关 v6 回 67/67，固件 0 warning（SHA 4e8ef5f4…）。待实板，重点看 `#V6` 行振动时 lpW 能否 <10。详见 T012 卡与 RT012-20261106.md。

- 2026-11-06 00:40 · Claude (OUTSIDER)：**T011 实板复测分析**（RT011-20261106）。2/3Hz 稳定段 CT 100% 达标；**勘误**：空握（新\1.txt）出现 1.78Hz 启停读数，T011 路径误进 1 次 5.7s，另 5 次误进来自原幅值路径。修正 0.5Hz 中途掉线（采样缺口后假起振边沿，`SS_EDGE_FIX_ENABLE` 跟随 hold，固件 SHA e945d958…）。人类追问「闭合期间无振动接触保持 1」，取决于新\1.txt 空握振动来源，待人类答复。

- 2026-11-06 00:05 · Claude (OUTSIDER)：**人类拍板：T009 补充修订 B-2（进入门 400→250mg）暂缓**，2/3Hz 进入由 T011 承担。人类已按 T011 固件实板复测（结果\T009\新\1~4.txt），2/3Hz 接触为 0 的问题人类确认已解决；本条只记录决定，T009 卡由规划侧更新。

- 2026-11-05 23:30 · Claude (OUTSIDER)：**人类授权开场外卡 T011（启停节奏进入接触），已实现+宿主验证，待实板**。2/3Hz CT=0 改用「姿态 + 启停频率锁定 ≥1.5Hz」作第二条进入证据（宏 `CT_SS_ENTRY_ENABLE` 跟随 `CT_HOLD_ENABLE`，宏关默认行为不变）。宿主 65/65，固件 0 warning（`_probe\t011\build_uart\` SHA 2ad0072e…），回放预计 2/3Hz 稳定段 CT 92~100%。**与 T009 B-2 分歧**：单测 1~3 中手指动作瞬态有 17 段连续 3 帧 ≥250mg、峰值至 1179mg，B-2 降门到 250mg 有闭合误进风险；建议 B-2 暂缓，由人类拍板。本条不改 T009 卡与状态。详见 T011 卡与 RT011-20261105.md。

- 2026-11-05 21:50 · glm5.3 (PLANNER-B)：**按人类指示（m01717「行就是行，不行就是不行，语义和合理为什么不思考完善代码」）追加 T009 补充修订 B-2：启停档 CT 进入门放宽**。接受批评并勘误 21:20 条立场：2/3Hz CT=0 不是"物理不可达备答辩口径"，400mg 进入门是自定标定参数可调。根因链：hold 已解决 OFF 段保持（0.5/1Hz 验收 5 通过），遗留卡在**进入门**——ON 窗 250/167ms 内 ERM 只建到 300~430/160~350mg 过不了 400mg。B-2 规格（宏 CT_HOLD_ENABLE=1 时生效，默认构建逐字节不变，全在任务 B 已豁免 4 文件内）：进入门 400→250、保持门 300→180（滞回带 70mg）、确认 100→60ms；空握 9~26mg 对 250 门 10 倍余量（宿主用例 R1~R4 锁定）；3Hz 实测 <95% 可降第二档 200/150/50ms；驱动侧非对称占空比（dual CYCLE_TABLE，2Hz ON400/OFF100、3Hz ON250/OFF83）作末位备选。验收 B2-1~B2-6：2/3Hz 档 CT 连续占比 ≥95%（基线 2Hz 35/38 与 0/18、3Hz 0/0）+ 回归不劣化 + 现场决策表升三行。正向副作用：5 号场景 96~99Hz/300mg 平台段将进 CT（82%→~100%），并顺带覆盖 T010 预案⑦平台弱激励场景。派 flash 实现+实板复测。

- 2026-11-05 21:20 · glm5.3 (PLANNER-B)：**6.1/6.2 四档复测复算：任务 B（CT_HOLD）实板验收通过；「SS 全 000」勘误为 PLANNER-B 解析 bug（十六进制 VALID 域幸存者偏差），固件 SS 四档读数全准（0.50~0.52/1.00/1.99~2.02/2.90~2.96）；hold 生效铁证（0.5/1Hz OFF 相位 CT=1 保持）**。唯一遗留 2/3Hz 档 CT=0：ERM 起振时间常数 ~100ms vs ON 窗 250/167ms，amp 只建到 300~430/160~350mg 不过 400mg 门——物理限制非 bug，SS 考核点已全准，答辩口径备好（1Hz 档演示 CT 保持）。T009 待办收窄：驱动板烧回 dual 原版（可选，去双重踢对 amp 的影响）+ 检测板测后烧回默认构建（CT_HOLD_ENABLE 改回 0）+ 可选 dual 下复测 2/3Hz amp。分析脚本留存 单测\_p63/_p64。详见 T009 卡完成记录 21:20 条。（**本条「物理不可达」立场已被 21:50 条 B-2 勘误取代：进入门是标定参数，已派放宽修订**）

- 2026-11-05 18:05 · glm5.3 (PLANNER-B)：**按人类指示（m01501/m01509）任务 A 最终定案：弃 vibsource_c3_key，驱动板回归 vibsource_esp32_dual 原版**。按键硬件从未接线且串口命令（大小写敏感）用户已摸清，c3_key 增量价值无从发挥；dual 原版零改动、采集脚本零适配，且双重踢 bug 为 c3_key 引入、原版天然无此问题。T009 剩余：①驱动板烧 dual 原版 ②四档 T0~T3 各 ≥20s 复测（2/3Hz 档 amp 是重点）③检测板 hold 版四档 CT 抬升验证（任务 B 验收 5，D 命令已自证 holdOk 列在板）④测后烧回默认构建。按键项标记"已实现未实测（无硬件）"，c3_key 工程存档。详见 T009 卡完成记录 18:05 条。

- 2026-11-05 17:05 · glm5.3 (PLANNER-B)：**单测 1~6 独立验收 + RT009-20261105 复核：任务 A 双重踢修复与任务 B CT_HOLD 门控代码/构建全部就绪（宿主 56/56、hold 产物 elf 实证宏开），但本轮实板数据均采自旧固件——两块板都没烧新 bin**。单测判决：1 移动 CT 尖峰 0.68s 非bug；2/3 零误报 ✅（3 号 CT=0 是预期语义，纠正 RT191 行误判）；4 新振子证据帧 CT=97.6%（连续 60.3s）优；5 旧振子 82.1%（96~99Hz/300mg 平台未过 400mg 门=如实）；6 四档 SS 全准但 CT 34.3%/37.5%/0%/0%。**固件版本裁定三条证据**：CT 边沿后 100~120ms 掉 0（=默认 CT_CONFIRM_MS 行为，hold 应 ≥1200ms）、2/3Hz 档 amp p50 仅 205/127mg（双重踢未修指纹）、日志无 hold 列/[SRC]/[MODE] 行——人类自述"烧的 CT_HOLD 开宏版"与数据不符，判定烧错 bin。纠正 RT 结论 8 过度推断（SS 准不能证明修复上板，SS 事件计时与踢一脚无关）。T009 仍 doing；转 done 前必须两板各烧新 bin（驱动板 `_probe\t009\build_uart\` SHA d49b1737…、检测板 `_probe\t009b\build_hold_uart\` SHA ef87b296…）+ 烧后自证（D 命令 holdOk 列、q 命令 [MODE] 行）+ 四档复测各 ≥20s + 按键序列。详细判决已落 T009 卡完成记录。

- 2026-11-05 09:45 · glm5.3 (PLANNER-B)：**按人类指示（m01349「不对应该写成T010，先把所有可能更改的东西列出来，然后每个至少给出3种情况参考」）撤销 09:40 的"任务 C 并入 T009"决策，开独立卡 T010-现场适配预案清单.md（todo）**。T010 核心=预案清单 17 项（帧格式/波特率/帧率/编码GBK/发送使能/CT 语义/判据门限/量程/绿黄红 LED/占空比/启停档/供电/共地/I2C/烧录模式），每项 ≥3 种情况参考+对应改法（宏名级）；产出=《现场适配预案手册》+预编译固件变体清单（默认 35B/CL 37B/CT_HOLD 开宏，可选 CSV 门控预写）+唯一必做码改（黄灯 CT 接触闪 2Hz+`y` 命令三态，仅 output.cpp，$VD 帧零变化验收含 300 帧校验）。执行约束：与 T009 任务 B 共文件 output.cpp 串行——手册与固件预编译可先行，码改排任务 B 验收后。T009 卡与 plan.md 已回滚（09:40 并入记录保留作历史）。09:40 核对结论（绿灯 1Hz 已达标/GBK 纯 ASCII 零改动/红灯硬件）并入 T010 手册素材。

- 2026-11-05 09:40 · glm5.3 (PLANNER-B)：**按人类指示（m01295「准备现场各种情况：用的语言是GBK、绿灯每 1 秒闪一次、黄灯每次接触闪，等等」）向 T009 并入「补充任务 C：比赛三色 LED 预案」**。核对结论（依据=赛题 §五原文 + 07-pinout.md §5 + config.h/output.cpp 实读）：①绿灯 GPIO10 1Hz 心跳已达标零改动（`output.cpp:719 (nowMs/500)&1` 即人类要的每秒一闪，PIN_LED_G=10 与比赛 PCB 网表一致）；②红 LED=5V 轨常亮为硬件行为零固件事；③GBK 无需任何代码——$VD 帧纯 ASCII，GBK/UTF-8 平台均可直接解析（历届组委会从未规定帧格式）；④唯一代码缺口=黄灯 GPIO5：现状「振动中常亮」（output.cpp:720 `r.vib==1`），规格改为 CT 接触联动 2Hz 闪 + 串口 `y` 命令三态手动控制（AUTO→ON→OFF，演示赛题"可控制亮灭"硬性要求）；只动 output.cpp（ledUpdate/命令分发/printStatus），绿灯心跳、FAULT/CAL 分支、$VD 帧路径全部零改动；七条验收含 ≥300 帧零变化校验。执行顺序 A 剩余项→B→C（B/C 共文件 output.cpp 串行）。T009 卡已更新（派卡日期六改、目标段三任务、转 done 前置第 ⑤ 条、完成记录 09:40 条目）。

- 2026-11-05 00:03 · glm5.3 (PLANNER-B)：**按人类指示（m01268「不需要开新卡，继续在T009补充就行」）撤销 T010 卡，规格并入 T009 为「补充任务 B」节**。执行动作：删除 规划\tasks\T010-启停CT保持门控.md；T009 卡新增补充任务 B 全文（目标/豁免文件范围/改动规格/九条验收/数据要求/纪律），实现约束 #8 与验收标准 #8 的「零改动」范围改写为仅约束任务 A（驱动部分，vibsource_c3_key），任务 B 豁免范围=config.h/state.cpp/test\contact_test.cpp/output.cpp(#if 门控)；T009 转 done 前置增加第 ④ 条（任务 B 九条验收）。T009 任务表行同步更新。23:56 派 T010 的日志条目保留作历史，以本条为准。

- 2026-11-04 23:56 · glm5.3 (PLANNER-B)：**人类三现象问询闭环 + 拍板选 C → 派卡 T010（todo，前置 T009 done 后开工）**。测试2.txt 三现象逐帧分析答复：①SEQ 218~224 空握 VIB=1 = 手指拍合真实机械瞬态（191~195Hz/9~26mg/7帧），VIB 门限是标定噪声级、CT 门 400mg 未动，非 bug 不改（操作：合拢放缓 ~0.5s）；②SEQ 280~297 主频 106→109 漂移 = ERM 开环占空比控制无频率闭环，物理转速随负载/电压/温度摆 ±2~5Hz（T006 先例同档两轮 162.3/171.6Hz），测量误差 <0.2Hz vs 赛题 ±2Hz，非 bug 不改（答辩口径「读数忠实反映物理转速」）；③1Hz 启停段 CT 每拍闪 1/0（占空比 ≈55~70%）= 设计行为（CT 证据驱动 vs SS 事件驱动）。三选项 A 不改/B 直接改/C 门控默认关，**人类 23:55 选 C（m01247）**。T010 规格：`CT_HOLD_ENABLE` 默认 0（出发固件逐字节不变），开宏版 `CT_HOLD_MS=1200` 让 `postureOk && 1200ms 内有振动证据` 保持 CT=1（覆盖 0.5Hz 档 OFF 1s；姿态路不动，松手立即掉 0；进入条件不放宽）；实板验收 = 开宏版 1Hz 启停 CT 连续 ≥95%（基线 55%）+ 松手 ≤0.2s 掉 0 + 关源退出 ≈1.2s 如实记 + 测后烧回默认构建 + 现场决策两行表。卡与 T009 无文件交集但按「一次一卡」排队。

- 2026-11-04 23:25 · glm5.3 (PLANNER-B)：**T009 阶段 1 验收：达标（带 1 个待修 bug），卡转 doing**。flash 交 RT009-20261104.md（RT009-20261103.md C8T6 旧方案作废）；独立复核：源码逐条对卡全过、双零改动经时间戳核实、测试2.txt 4835 帧逐帧复核（六帧证据链对上、尾部 800 帧 SS 全 1.00）、数据文件与 RT 一致。**PLANNER-B 审查发现 RT 未报的 bug：自动模式 OFF→ON 双重踢一脚**（autoTick 80ms 显式踢 + setOut 自身 200ms 踢 = 280ms，原固件只踢一次 80ms）——1Hz 档正常（SS=1.00 实测已证），**2Hz 档实际 ~1.9Hz、3Hz 档 ~2.24Hz**，四档 SS 验收 2/3Hz 会不过，待 flash 一行修复重烧。阶段 4 CT 语义发现（自动启停 OFF 段 CT 掉 0）逐帧复核属实，**定性为设计行为非 bug**（CT=姿态+振动证据，CL 才表达夹持；T008 P3 先例 ct=55%），PLANNER-B 立场赛前不改 vibmon 判据——启停考核点在 SS/VIB 读数（测试2 已证 SS=1.00），3 天内动 state.cpp 回归风险大于收益。BROWNOUT×1 提示现场避免弱 USB 口供电。待办：修 bug + 人类按键实测回传 + 默认占空比登记。

- 2026-11-04 18:40 · glm5.3 (PLANNER-B)：**T009 四改（人类 m01087）：去 OLED，串口即状态界面**。改动量再降一档：固件只加 4 个按键，串口命令行/状态打印/双路 PWM/踢一脚/四档表全部沿用现状，无新库依赖；按键映射到现有命令语义（KEY1 三态≈a/b/z 但按"切源即停另一路"实现、KEY1 长按≈T 通断切换、KEY2 手动≈p 跳默认（PRESET_DUTY 改各振子独立默认）/自动≈T0~T3 循环、KEY3/4≈+/-）；每次按键后走 printStatus 路径并补模式行。引脚去 OLED（GPIO5/6 空出）：KEY1=GPIO7/KEY2=GPIO10/KEY3=GPIO0/KEY4=GPIO1。新工程目录改 Desktop\STM32project\vibsource_c3_key\。验收 9 条：四档 SS 用 vibmon $VD 帧佐证（1Hz≈1.00 对齐 T008 P3）、按键与串口同一状态机互查一致、原工程+vibmon_v5 双零改动。方案演变定稿：C8T6+OLED → ESP32+OLED → **ESP32+按键+串口**。

- 2026-11-04 18:30 · glm5.3 (PLANNER-B)：**T009 三改（人类 m01061）：弃 C8T6，改回 ESP32-C3**。理由：①USB 烧录免 ST-Link（Arduino IDE 同 vibmon 工具链）；②vibsource_esp32_dual 现成代码（双路 PWM/踢一脚/四档表/20kHz/串口命令行）全部复用，只增量加按键+OLED+UI；③T004~T008 宿主采集脚本零改动可用。卡重写为 ESP32 版：引脚 PWM_A=GPIO3（新振子）/PWM_B=GPIO4（旧振子）沿用现接线（标签按 T006 实况命名 A=新/B=旧）、OLED SDA=GPIO5/SCL=GPIO6、KEY1=GPIO7/KEY2=GPIO10/KEY3=GPIO0/KEY4=GPIO1（INPUT_PULLUP 按下 LOW）、LED=GPIO8；**串口命令行保留不动**（与按键+OLED 并存，日常操作走按键）；按键规格/OLED 显示/必移植行为沿用前两轮修订；新工程 Desktop\STM32project\vibsource_c3_oled\（拷贝增量改）；验收 9 条加「原工程+vibmon_v5 双零改动」。C8T6 方向废弃不再回退。

- 2026-11-03 23:52 · glm5.3 (PLANNER-B)：**T009 二次修订（人类 m01047）：去串口，改 OLED 显示**。无串口后人机界面全靠屏幕，三处适配：①**KEY1 长按 ≥1s=手动/自动切换**（bool 的唯一物理入口，短按仍是选源三态循环）；②OLED 显示规格进卡（0.96" SSD1306 I2C PB6/PB7，四行：模式/源/占空比/状态，按键响应 ≤200ms）；③**显示不得阻塞启停时序**——I2C 刷屏一屏 20~30ms，3Hz 档半周期仅 167ms，刷屏限频写入约束；验收加「四档 SS 实测各 ≥20s」用 vibmon $VD 帧佐证（1Hz 档 SS≈1.00 对齐 T008 P3 先例）。原串口命令行条目删除，改为纯板卡交互。

- 2026-11-03 23:45 · glm5.3 (PLANNER-B)：**修订 T009 分工与引脚**（人类 m01023 澄清：flash 写代码并协助交结果、人类只做实板测试——非"人类全程自己写"）。PLANNER-B 通读原双路固件全文（vibsource_esp32_dual.ino 278 行 + config.h 75 行），沉淀五项必移植行为进卡：①踢一脚启动（0→非0 先 100%/200ms，低于 74% 启动门槛）；②自动通断 ON 占空比固定 85%（CYCLE_ON_DUTY，每拍补 80ms 小踢）——决策不与手动设定联动；③四档周期表 1000/500/250/167ms 照抄；④PWM 载波 20kHz；⑤LED 运行指示。**引脚方案拟定**：PA6/PA7（TIM3_CH1/CH2）双路 PWM、PB0/PB1/PB10/PB11 四按键（内部上拉低有效）、PA9/PA10 USART1 命令行、PC13 板载 LED；**通道标签定死为新板新标签**（PWM_A=新振子、PWM_B=旧振子，摆脱历史"标签反"包袱）。KEY2 复用：手动=跳默认、自动=切周期档（免第 5 键）。工程目录建议 Desktop\STM32project\vibsource_c8t6\（不进 vibmon_v5 仓库）。

- 2026-11-03 23:30 · glm5.3 (PLANNER-B)：人类指示开 T009（m01001）——振动源驱动从 ESP32 双路固件迁移到 **STM32F103C8T6 + 4 物理按键**。四项规格经 ask_user_question 确认（m01006）：①KEY3/KEY4 步进=**占空比 ±5%**（不做频率标定）；②KEY2=跳**各振子独立默认占空比**（默认值待人类接线后登记进卡）；③自动启停=**周期可切**（0.5/1/2/3Hz 四档，覆盖赛题 0~3Hz）；④KEY1=三态循环（新→旧→关）确认无误。派卡 规划\tasks\T009-C8T6振动源驱动器.md（todo）。

- 2026-11-03 23:08 · glm5.3 (PLANNER-B)：验收 T008，**done——T001~T008 八卡全部收官，赛前项目状态完整**。flash 23:03 交卷（RT008-20261103.md，COM4 USB-TTL→GPIO21）。独立复核：①四段 summary 独立读取全对上（P0 510/510、P1 3008/3008 校验错 0 恒 35 字节 50.2Hz、P2 CL 1512/1512 恒 37 字节 10 域、烧回后 303/303 恒 35）；**CHK 抽 6 帧手工 XOR 重算全部命中**——T001 遗留 P4 实板帧核对闭环；②P3 scene.csv 3534 帧逐段重算：s1 接触 ct 1489/1512（98.5%）F 中位 159.7Hz A 633mg、s2 关源 amp 725mg 衰减 ct 续命至第 16 帧≈0.30s 退出（对齐 A4 0.42s 量级）、s3 1Hz 启停 SS={1.00,1.02} VIB 交替；③零代码改动经 sketch 源码时间戳核实（全部 ≤11-02）。两个瑕疵记录在卡：RT 表 s3"F 中位 81.7Hz"对不上任何数据（实测中位 126.2/均值 118，前两轮 127.8~132，来源不明，以 scene.csv 复算为准）；P3 存解析 CSV+chk_ok 列而非逐行原文（与卡面字面有偏差但证据等价）。CL=1 轮全 CL=0（张开姿态）符合"按实际姿态记录"不返工。**赛场要点沉淀：USB-TTL 与模块必须共地否则收 0 字节（比赛 4pin 自带 GND 天然满足）；出发固件=默认构建 35 字节已核验烧回。** 唯一剩余：平台对接 C4 到场。

- 2026-11-03 12:58 · glm5.3 (PLANNER-B)：人类指示「最后加一个 T008 用串口模拟赛场」→ **派卡 T008（串口模拟赛场验证，todo）**。设计：宿主脚本（pyserial）扮演比赛平台，经 USB-TTL 从 GPIO21 比赛口收 $VD 帧。四段内容：P0 接线与链路确认（波特率以 config.h 实读为准，乱码即报不硬凑）→ P1 默认构建 35 字节帧 ≥60s 逐帧校验（帧头/域数/CHK 重算/帧长恒 35/帧率统计，闭环 T001 遗留 P4）→ P2 CL=1 构建 37 字节再核后**烧回默认构建**（现场带默认固件出发）→ P3 平台场景模拟（振动开/关源退出延迟/启停档 SS 读数，字段语义对齐历史值）。纪律：零代码改动（烧录切换构建需在 RT 写明烧了什么烧回什么）、数据难看如实记、USB-TTL 未到位则停在接线确认回报不伪造。前置人类操作：USB-TTL RX→GPIO21、GND→GND、不接电源脚。18:45 补「执行模式」节：振源由脚本经 COM7 自动控制（退出延迟 ~0.42s 量级需精确对齐 t=0）、人类只做物理动作、语音播报提示。

- 2026-11-03 12:55 · glm5.3 (PLANNER-B)：验收 T007，**done——T001~T007 全部收官，赛前主线完成**。flash 12:47 交卷（RT007-20261103.md + 答辩\答辩材料主文档.md 四块+速查 + 答辩\答辩问答预案.md 12 条）。验收方独立抽查 5 组关键数字全部对上原始数据：①201.4Hz 瞬态三行 @12:51:07.854（A 35.1/53.0/58.7mg）；②D 样例 907.1/907.7/937.5mg；③A1/A2 五轮全 0/10、A3 五轮均 9/10；④稳态上限段 p1_new_100 8 行采样 7 行 ct=1（首行 103.4Hz 为升速瞬态，flash「ct 7/8」为严谨口径，与 T006 卡「连续8行ct=1」口径互补均成立）；⑤帧 35/37 字节、供电 5V 无跌落。加分：主动规避 T006 START 基线误引、「±5Hz」如实标注为概括说法。小瑕疵：Q12 引用 vibsource config.h 超出卡内读范围（只读无害）。剩余两项人类/到场依赖：USB-TTL $VD 帧实板核对（GPIO21）、平台对接 C4。

- 2026-11-02 23:45 · glm5.3 (PLANNER-B)：人类提问"记得有过 178 左右的震动"触发**全库数据复盘**（两个项目全部 CSV 扫 174~185Hz + 连续段分析）：证实记忆正确但定性为**电机升速瞬态扫频**（启停测试电机反复重启，F 估计器跟踪转速扫过 176~201Hz，A 20~320mg、ct=0），稳态真接触唯一 >174Hz 段仍是 T006 新方块 174.6~175.7Hz/8s/ct=1——**T006 结论不变，但新增测频背书：瞬态正确跟踪 201.4Hz**（远超赛题 180Hz），已补进 T006 卡完成记录。复盘后按人类指示**派卡 T007（答辩材料整理，todo）**：四块结构（独有增量/量化证据/设计定性/风险预案）+ 问答预案 ≥10 条，产出 `答辩\` 目录（卡内授权写入），只引用已有 RT/数据不新造，验收方将抽查 10 个数字对原始数据。

- 2026-11-02 23:37 · glm5.3 (PLANNER-B)：验收 T006，**done（带 3 瑕疵说明）**。独立复核：通道→频段映射三轮一致（a/GPIO3=低速 71~120Hz、b/GPIO4=高速 101~175Hz）；p2c 正式数据两套复算一致（162.3/171.6Hz，ct 9/10，新块段角度全有效）；复核 3 瑕疵：START 基线数值张冠李戴（笔误）、newblock 轮基线实际未建立（P 两拒，角度有效靠 rebase，p1 段角度无效但正式段不受影响）、「F 跟物理通道」判别实验未真做（脚本无 --old-sel，同映射三轮=可复现性证据；接线反 vs 标签反软件侧不可区分且修复相同）。**两项定性**：E-180 接受本地上限 77~175Hz 不再开卡（测频有 162~172Hz 实读背书）；通道档案修正为固定前提。**下一步：答辩材料整理卡（待派）**——判据链/六年调研/CL/CT/DUMP 独有增量/锁存与 E-180 定性/频段覆盖证据；剩余硬件依赖（USB-TTL $VD 帧核对、平台对接 C4）等人类/到场。

- 2026-11-02 23:12 · glm5.3 (PLANNER-B)：验收 T005，**done**。独立复核：D1 源码推演吻合（**锁存主因 = 保持规则允许频率证据单独续命，F_OFF 下限 63Hz**），D2 三次关源 0.42s 正常退出未复现锁存；RT005 纠正 T004 验收误读（"dual 关源锁存 4s"实为 0.64s 正常退出，T004 卡已勘误署名）。**三项推进决策**：①锁存——**赛前冻结不改码**（证据仅 T1 一例，比赛关源场景安全，保持规则系有意设计），定性写进答辩材料；②E-180 未达标（原振子满档实测 165.8Hz）→ 派 T006 排查（供电/换档/接受覆盖上限三路分支）；③通道标签疑似接反 → T006 软件对调 `--old-sel/--new-sel` 确认。派卡 **T006（E-180 端点振源排查 + 通道标签对调确认，todo）**，纯硬件侧排查，不改判据代码。

- 2026-11-02 22:48 · glm5.3 (PLANNER-B)：**派卡 T005（接触退出行为诊断 + 边界端点补测，todo）**。诊断优先不改码：D1 静态分析（退出条件全清单+滞回参数+T1/dual 两时序手工推演）→ D2 实板关源复现追 D 命令中间量（≥3次）→ 补测 E-80/E-180/E-mid/新振子提档 P-new/D 接触样例/START 基线（T004 全部缺项）。三份锁存证据（T1 余振锁存 6s、dual 关源锁存 4s A 仅 7~9mg、A4 余量 0.1s）同根源，诊断结论决定是否开"改 combineContact"代码卡。

- 2026-11-02 22:46 · glm5.3 (PLANNER-B)：验收 T004，**done（带 3 缺项）**。独立复核全部通过：P0 硬件修复量化成立（段内 I2C错/读失败增量 0）、P1 五轮 A1~A4 全达标、**A5 五轮重复历史首次通关**、双振源两段频带 ct 稳定、D 命令实板可用。缺项（E-80/E-180 端点、D 接触场景样例、START 基线情况）并入下卡补测。验收方补充发现：dual 关源段 ct 锁存 4s（幅值仅 7~9mg），与 T1 锁存同根源。**下一步方向：T005 接触退出行为诊断**——T1（余振 80~220mg 跳回锁存 6s）+ dual 关源锁存 + A4 余量 0.1s 三份证据指向同一根源（退出条件/保持规则/滞回），flash 先诊断定位（用 D 命令中间量 + 原始波形），诊断清楚再决定是否改 combineContact；同卡顺带补 E-80/E-180 端点与新振子提档测试。

- 2026-11-02 22:39 · glm5.3 (PLANNER-B)：执行人类指令，新增**署名制规则**并写入 AGENTS.md §4 第 8 条 + 大模型/规则.md 新增「六、署名制」：大小模型每次行为（派卡/验收/评审/改规则）与每份结果（RT 文件/数据目录）必须标注「日期 + 模型」，无署名记录视为无效。`小模型/规则.md` 属 flash 领地未直接改动——AGENTS.md 为全体模型开工必读，该条款对 flash 同样生效；flash 下次维护其规则文件时应同步镜像此条。

- 2026-11-02 17:50 · glm5.3 (PLANNER-B)：验收 T003，**done**。独立抽查：pymupdf 复核 2023 直链 PDF（24 页有效、"接触"2 处均为操作规则）、2021/2022 同法复核，与 flash 判定表完全一致。**历届六年（2021~2026）无一届要求"无振动接触检测"**——静态夹物场景不构成命题缺口，ct 判据维持"θ判闭合+A/F判接触"现状的决策获得历届证据支撑；同赛项他人开源代码（zongjisa-mpu6050）连接触判定都没有，我方 CL/CT 输出为独有增量。至此 T001~T003 全部 done，唯一在办 T004（实板检验）。
- 2026-11-02 18:02 · glm5.3 (PLANNER-B)：读共享记忆 `projects\工科赛.md`，把四条实测经验补进 T004 卡：① 每 session 先 `P` 采 START 基线（动作顺序 START→FINISH→HONGEST→START，P 防呆被拒不绕过）；② 空握终角 111° vs 夹物 100° 只差 11~24°（机械重复性），A2 误报第一嫌疑是装贴不是阈值；③ 幅值门才是把关者（假频与真接触频段重叠）；④ 新增第 5 组边界端点抽样（E-80/E-180/90Hz/165Hz 回归，历史从未实测的缺口）。数据要求同步加两条。

- 2026-11-02 17:20 · glm5.3 (PLANNER-B)：人类确认硬件已修复。风险点1 解除阻塞（仍留 H1/H3 量化证据要求）。派卡 **T004（实板检验第一轮）**，todo：P0 硬件证据 + P1 核心判据 + 4cm 方块双振源（人类优先项）+ T1 工单 + A5 五轮重复 + D 命令/帧格式实板顺带验证，按历史既定「后台采集+语音播报+一轮跑完」模式执行。T004 为当前主线卡，T003 支线不阻塞。

- 2026-11-02 17:10 · glm5.3 (PLANNER-B)：验收 T001/T002，双双 **done**。验收方式：读 RT001/RT002 + 独立复跑五项宿主测试（22/22、25/25、19/19、46/46、8/8，输出到临时目录不动工作区）+ 抽查代码落点（case 'D'@output.cpp:817、CL 门控、冻结宏 UART_SWAP=1/COMP_FRAME_ENABLED=1/CT_MODE=4 原样）。低风险遗留挂到检验阶段：CL 实板 37 字节抓帧（P4）、D 实板验证、k0~k6 与 D 混行互斥（实板若干扰再开卡）。遗留项4（陀螺量程 ±500dps）由 RT 附带回传确认，闭环。下一步：等 T003 支线结果；主线转实板检验（前置 = 人工修 I2C 焊点过 H1/H3）。

- 2026-11-02 16:55 · glm5.3 (PLANNER-B)：人类提问"理想流程是否与赛题一致"，核对赛题原文（`电路搭建\柔性振动检测模块_规则与要求整理.md`）。结论：理想流程整体一致，唯"握无振动物体 ct=1"与赛题不符——比赛测试件始终带可控振动激励，且静态夹物非 MPU6050 可稳定判断（历史调研结论），该诉求由 closed 语义承载（T001 的 CL 字段）。代码侧全部实现（判据 43/43、启停 4 档实测、F 165~167Hz、下扫 55% 全 ct=1）；未闭环项 = I2C 可靠性、5 轮重复性（A5）、双振源两段频带、180Hz 端点、T1 工单、平台对接（C4）。
- 2026-11-02 17:05 · glm5.3 (PLANNER-B)：用 ego-browser 侦察官网（jnds.gdut.edu.cn）验证历届命题可达性：赛项安排页为空壳，命题公告在「大赛动态」`/dsdt.htm` 分页新闻（编号约 12xx~13xx）。人类指示开支线，派卡 **T003（历届赛题调研：同类赛项是否要求无振动接触）**，todo，侦察结论已写入卡内供 flash 直接续做，不阻塞主线 T001/T002。

- 2026-11-02 16:35 · glm5.3 (PLANNER-B)：读 PLANNER-A `大模型/评审报告_20261102.md` 与 `小模型/检验方案.md`，整理立项；派卡 **T001（比赛帧 CL 字段，配置门控默认关）**、**T002（D 命令 DUMP 模式）**，均 todo；评审建议2（COMP_FRAME_ENABLED 确认）并入 T001 验证项不单开卡；I2C 物理风险列入风险点交人工处理。
- 2026-11-02 16:45 · glm5.3 (PLANNER-B)：补读历史规划（`陀螺仪改造方案.md`、`相关研究与闭合事件方案.md`、`当前状态.md` 全 16 节、`代码测试报告_20261102.md` 引用）。核对结论：T001/T002 与历史规划无冲突；4 项历史遗留（T1 工单、5cm C6 补测、5 轮重复性、陀螺量程核对）已并入「下一步方向」检验阶段。另确认 flash 已于 16:36 开工 T001（工作区见 `COMP_FRAME_CL`），等待其结果文件。
- 2026-11-02 16:52 · glm5.3 (PLANNER-B)：人类指示落地——遗留项 1（T1 工单）维持原判读标准不变；遗留项 2 优先级改写：**优先检验 4cm 方块 + 新旧双振源**（102~182Hz 与 80~128Hz 互补覆盖 80~180Hz，最贴近比赛工况），5cm C6 降为次要。T001 仍 doing，等待 flash 结果文件。
