wmsz88/flex-vib-monitor/vibmon_v5/结果/RT010-20261106.md

# RT010-20261106 — 现场适配预案清单

任务号: T010
执行模型: EXEC (flash)
执行日期: 2026-11-06
署名: 2026-11-06 21:00 · flash (EXEC)
基线: git `a57322d`（代码改动）→ `08af7bc`（手册与变体清单）→ 本卡收尾时按人类指示改为独立项目（见下）
出发固件: v6（2026-11-06 19:50 人类拍板）；**本卡的现场适配版 = `代码\vibmon_v7\`**

## 改动摘要（做了什么）

- **版本位置调整（人类指示，本卡收尾）**：改动一开始落在 `vibmon_v6` 原地，人类指出"不该改原文件、要另建项目"。遂把带改动的整份拷成 **`代码\vibmon_v7\`**（`.ino` 相应改名 `vibmon_v7.ino`、`README.md` 重写），再把 **`vibmon_v6\` 整体恢复到 T013 验收时的状态**（`git checkout 366874e -- vibmon_v6`，即 `vibmon_v6` 树 `1de3b95`）。v6 与 v7 的固件源码差异**只有 `config.h` 与 `output.cpp` 两个文件**，判据链逐字节相同。
- `代码\vibmon_v7\output.cpp`：
  - `ledUpdate` 的 `LED_RUN` 分支：黄灯从"振动中常亮"改为**接触联动** —— CT=1 时 2Hz 闪（`(nowMs/250)&1`）、CT=0 灭；绿灯心跳 `(nowMs/500)&1` 不变；`LED_FAULT`（4Hz）与 `LED_CAL` 分支一字未动。
  - 新增黄灯三态 `LEDY_AUTO/ON/OFF` 与 `'y'` 命令（命令分发里、与 `'d'`/`'S'` 同区），回显 `[LEDY] AUTO|ON|OFF`。
  - `outPrintStatus` 增黄灯状态行；`'?'` 帮助增 `y 黄灯`。
  - 预案宏落地：`compBuildFrame` 增 CSV 分支；`compPeriodic` 增发送分频与比赛口 `'S'`/`'X'` 命令门控；编号编码函数按 `COMP_FRAME_CSV` 条件编译。
- `代码\vibmon_v7\config.h`：新增三只默认关的门控 `COMP_FRAME_CSV=0`、`COMP_FRAME_DIV=1`、`COMP_FRAME_GATED=0` + 编译期校验。
- `代码\vibmon_v7\test\led_test.cpp`（新增，64 项）：绿灯心跳、黄灯 AUTO/ON/OFF、FAULT/CAL 不回归、帮助含 y。
- `代码\vibmon_v7\test\Arduino.h`：`SerialStub` 支持喂命令/读回显；`digitalWrite` 增加电平钩子（函数内静态量，GCC 6.3 可用）。
- `代码\vibmon_v7\test\run_all.ps1`：纳入 `led_test`。
- `代码\vibmon_v5\答辩\现场适配预案手册_20261106.md`（新增）：17 项 × 3 情况 + 改法（宏名/文件/改动量）+ 验证方法 + 成本分类；现场决策两行表；串口速查；GBK 答辩口径。
- `代码\vibmon_v7\_variants\`（新增）：七个预编译变体 + `固件变体清单.md`。
- **未改**：`规划\`、`大模型\`、v5 源码；`vibmon_v6\` 已恢复原样；v7 的判据链（`state.cpp`/`dsp.cpp`/`posture.cpp`/`sampler.cpp`/`mpu.cpp`）与 v6 逐字节相同。

## 测试/测量数据（测到什么）

### 1. 全量宿主测试（`test\run_all.ps1`，MinGW g++ 6.3.0，`-std=c++17 -Wall`）

| 目标 | 警告 | 结果 | 基线 | 判定 |
|---|---:|---|---|---|
| contact_test | 0 | 89/89 | 89/89 | OK |
| gyro_test | 0 | 8/8 | 8/8 | OK |
| comp_frame_test | 0 | 22/22 | 22/22 | OK |
| dump_test | 0 | 15/19（4 fail） | 15/19 | OK |
| **led_test**（新） | 0 | **64/64** | — | OK |
| ss_replay | 0 | 可运行 | — | OK |

`led_test` 覆盖：绿灯 9 个相位全对（1Hz）；黄 AUTO 下 CT=0 九个相位全灭、CT=1 九个相位全按 2Hz；`y` 三次回显 `ON`/`OFF`/`AUTO` 且 ON 常亮、OFF 常灭；FAULT 绿灭+黄 4Hz 九个相位全对；CAL 两灯亮且 `ledUpdate` 不覆盖；帮助含 `y 黄灯`。

### 2. 双 FQBN 与七个变体（arduino-cli 1.5.1 + esp32 3.3.12，`--warnings all`）

| 变体 | 编译宏 | FQBN | Warning | Flash (B) | RAM (B) |
|---|---|---|---:|---:|---:|
| `def`（出发版） | 无 | esp32c3 + CDC | 0 | 373262 | 30340 |
| `cl` | `-DCOMP_FRAME_CL=1` | esp32c3 + CDC | 0 | 373358 | 30340 |
| `csv` | `-DCOMP_FRAME_CSV=1` | esp32c3 + CDC | 0 | 372940 | 30340 |
| `div2` | `-DCOMP_FRAME_DIV=2` | esp32c3 + CDC | 0 | 373318 | 30340 |
| `gate` | `-DCOMP_FRAME_GATED=1` | esp32c3 + CDC | 0 | 373462 | 30340 |
| `v5sem` | `-DCT_V6_ENABLE=0` | esp32c3 + CDC | 0 | 372070 | 30300 |
| `uart` | 无 | esp32c3（非 CDC） | 0 | 368156 | 30156 |

产物在 `代码\vibmon_v7\_variants\<变体>\`，`.bin SHA-256` 与重编方法见同目录 `固件变体清单.md`。
七个变体全部从 `vibmon_v7` 编译。中途观察到：7 个并行编译时 `gate` 失败过一次（`Error during build: exit status 1`、无编译错误信息），单独重编即 0 warning 通过 —— 是多个 arduino-cli 争用同一个 `Arduino15` 构建缓存，不是代码问题。

改动 A 带来的体积变化：出发版 CDC 从 373000 → **373262 B**（+262 B），RAM 30340 不变。

### 3. 实板验证（改动 A 的 7 条验收）

上板：v7 `def` CDC 构建（写入 373408 字节，`Hash of data verified`），检测模块走 COM9。

| # | 验收项 | 结果 |
|---|---|---|
| 1 | 绿灯 1Hz 不变 | 该分支代码未动；`led_test` L1 九相位全对；实板全程正常心跳（未逐秒计数） |
| 2 | 黄灯 CT 联动 | ✅ `ct` 时序：夹住振动件 **1（71 帧 / 14.2s）** → 抽走方块摊平 **0（75 帧 / 15.0s）** → 再夹 **1（41 帧 / 8.2s）**；三段都 ≥10 帧。人确认灯态为「闪 → 灭 → 闪」 |
| 3 | `y` 三态回显 | ✅ `[LEDY] ON` → `[LEDY] OFF` → `[LEDY] AUTO`；`S` 状态行含 `黄灯 [LEDY] ON（y 切换：…）`；帮助行含 `y 黄灯` |
| 4 | `$VD` 零变化 | ✅ 4pin/CH340 采 **506 帧**：整行全部 **33 字符 + CRLF = 35 字节**；逐帧重算 XOR 校验 **506/506 全对**；`SEQ` 不连续 **0**；字段仍是 `SEQ/FREQx10/AMP/VIB/CT/SSx100/VALID/CHK`（无 CL、无 CSV） |
| 5 | FAULT/CAL 不变 | `led_test` 64/64（FAULT 九相位、CAL 不被 `ledUpdate` 覆盖）；实板 `c` 触发 `[CAL] 开始标定 3200 ms`，标定窗口内 `LED_CAL` 两灯同亮 |
| 6 | 宿主全量回归 | ✅ 见 §1（含 led 64/64） |
| 7 | GBK 答辩口径 | ✅ 手册 §5 + 本文件结论 5 |

证据文件：`测试\V7\黄灯.txt`（`y` 三态）、`测试\V7\黄灯CT联动8.txt`（`ct` 时序）、`测试\V7\帧格式-300帧.txt`（506 帧 `$VD`）。

## 数据结论（结论是什么）

1. 改动 A 在宿主侧可证：`led_test` 64/64 覆盖了绿灯 1Hz、黄灯三态、FAULT/CAL 不回归；`y` 走的是真实命令分发与真实 `outPrintf` 回显。
2. 三只预案宏默认值下行为与出发前一致：`COMP_FRAME_DIV=1` 时分频后周期表达式仍等于 `COMP_PERIOD_MS`（编译期折成 20ms）、`COMP_FRAME_GATED=0` 与 `COMP_FRAME_CSV=0` 时对应代码不参与编译；`contact_test` 89/89、`comp_frame_test` 22/22 都是证。
3. 七个变体全部 0 warning，Flash 368156~373616 B（28%），RAM 30156~30340 B（9%）。
4. v7 的黄灯语义相对 v6 变了：不再是"振动中常亮"，而是"接触中 2Hz 闪 + `y` 三态"。这也是 v7 需要单独建目录的原因 —— v6 保持 T013 验收时的行为不变。
5. **GBK 答辩口径**：比赛帧 `$VD,` 开头，35 字节纯 ASCII（字母/数字/逗号/两位十六进制校验），不含多字节字符，GBK/UTF-8 环境都能直接解析；平台显示异常时切十六进制核对字节。
6. 改动 A 的 7 条验收全部有数：`ct` 1→0→1 三段 71/75/41 帧、人确认灯态「闪→灭→闪」；`$VD` 506 帧全部 35 字节、CHK 506/506 对、SEQ 断续 0；宿主含 `led_test` 64/64 全绿。

## 异常与未解决项

- 实板验收进度：v7 `def` 已上板（373408 字节，Hash verified）；`y` 三态回显、`S` 状态行黄灯、帮助含 `y`、`c` 触发 3.2s CAL **已从串口证实**（`测试\V7\黄灯.txt`）；灯态本身需人目视确认。
- **黄灯 CT 联动还没测到**：振动源驱动不起来。实测 A/B 两路 90% 时检测模块都只读到 `A 中位 6mg`（T013 同工况是 584mg），且这期间**振源板 COM7 从系统消失几秒又回来**（USB 重枚举）= 电机一启动就把板子拉跌复位，PWM 输出归零，电机实际没转。属供电问题（T009 记过的 BROWNOUT），不是端口映射或固件问题。
- 上面这条已澄清：真因是**接错电源**；换对电源后 `A` 中位 934~1007mg，接触正常建立。
- 观察项（未单独验证）：`ct` 时序那一轮里 `#V6 ang` 从 124° 单调升到 223°，横跨「夹住 / 抽出方块 / 再夹」三段都没回落到 0；`closed` 在抽出段有 51/81 帧变成 0。可能是抽插方块时手部转动累积，也可能是强振动下陀螺积分漂移，本轮没做对照。
- 两趟实板测试是靠换线完成的（本机只有两个 USB 口）：COM9 拿 `#F`/`#V6`，COM4 拿 `$VD`，不能同时插。
- 手册里"绿灯 1Hz 不亮/极暗"的三步预案、红灯排查属于硬件操作，未实测。
- 变体 `.bin` 未入库（项目 `.gitignore` 忽略 `*.bin`），只入库清单与 SHA；换机器要重新编（同源同宏即可，`.bin` SHA 会不同）。
- `dump_test` 4 项既有失败仍在，本卡未动。
