wmsz88/flex-vib-monitor/vibmon_v5/结果/RT013-20261106.md

# RT013-20261106 — v6 出发版收口与烧录验证

任务号: T013
执行模型: EXEC (flash)
执行日期: 2026-11-06
署名: 2026-11-06 13:30 · flash (EXEC)
基线: git `100ab84`（v6 源码树 `1de3b95`；本卡未改任何固件源码）

## 改动摘要（做了什么）

- `代码\README.md`：新增「〇、当前版本」小节（v5/v6 各是什么、v5 现状 `CT_HOLD_ENABLE=1`+T011、v6 三个现场开关、v6 编译方法）。未改其它历史文档。
- `vibmon_v6\test\run_all.ps1`（新增）：一条命令跑 contact / gyro / comp_frame / dump / ss_replay 五个目标，编译期警告数与逐条数字对上基线才判 OK。
- `vibmon_v6\测试\V6b\采集.py`（新增）：带墙钟时间戳的连续采集，格式与 `测试\V6\*.txt` 一致（`ss_eval.py`、`_win.py` 可直接吃）；启动时发 `d` 开 `#V6` 调试行。
- `vibmon_v6\测试\V6b\振源控制.py`（新增）：一次开串口跑完一串振源命令（开串口会复位振源，不能分多次开）。
- `vibmon_v6\测试\V6b\分析.py`（新增）：统计采集日志里的 `#F` / `#V6` / `$VD`（中位/极值/占比/CHK 抽检）。
- `vibmon_v6\测试\V6b\退出延迟.py`（新增）：用 `$VD` 的 AMP 列定位机械松开时刻，量到 `ct` 掉 0 的延迟。
- `vibmon_v6\测试\V6b\流程.md`（新增）：实板检查 A~D 的操作顺序与播报词。
- 未改：`vibmon_v5\` 任何文件、`规划\`、v6 任何固件源码。

## 测试/测量数据（测到什么）

### 1. 全量宿主测试（`vibmon_v6\test\run_all.ps1`，MinGW g++ 6.3.0，`-std=c++17 -Wall`）

| 目标 | 编译警告 | 结果 | 基线 | 判定 |
|---|---:|---|---|---|
| contact_test | 0 | 89/89 | 89/89 | OK |
| gyro_test | 0 | 8/8 | 8/8 | OK |
| comp_frame_test | 0 | 22/22 | 22/22 | OK |
| dump_test | 0 | 15/19（4 fail） | 15/19 | OK |
| ss_replay | 0 | 可运行（回放跑通） | — | OK |

dump 的 4 项失败**逐条**：

1. `23 separators -> 24 fields`
2. `static line matches expected text`
3. `contact line matches expected text`
4. `grip-no-object line shows condPosture=1, condAmp=0, condFreq=0`

同一 4 项在 `vibmon_v5` 上逐字相同（v5 dump_test 也是 15/19），是**既有列数写死问题**，不是本次改动引入。

### 2. 双 FQBN 编译（arduino-cli 1.5.1，esp32 3.3.12，`--warnings all`）

| FQBN | Warning | Flash | RAM | `.bin` SHA-256 |
|---|---:|---:|---:|---|
| `esp32:esp32:esp32c3` | 0 | 367892 B (28%) | 30156 B (9%) | `6a3edfffce8ddde7b6c39a397d0c4d8625a44ec80556cd013de3878ee8db1842` |
| `esp32:esp32:esp32c3:CDCOnBoot=cdc` | 0 | 373000 B (28%) | 30340 B (9%) | `131c1bbf378b14965f39c2c2a1ed24062cf1da736e704befe6459ead2c7b815d` |

**`.bin` SHA 不可复现**（同一份源码、同一 FQBN、两次独立构建）：

| 构建 | `.bin` SHA-256 | 大小 |
|---|---|---:|
| non-CDC 第 1 次 | `6a3edfff…` | 368048 B |
| non-CDC 第 2 次 | `1bdb0c007fa79aed5ae5bf27a2bed04fce78100a810b9a80dcbd8807bb6f2e59` | 368048 B |

两次逐字节比对：**只有 68 字节不同**，位置全部是 `176..207`（app 描述里的 ELF SHA 字段）、`10053..10059`（编译时刻字符串）、`368015..368047`（镜像末尾的 32 字节指纹）。代码区逐字节一致。

与仓库里现存的 `vibmon_v6\build_uart\vibmon_v6.ino.bin`（`0bf3c2fd…`）比对：同样只在上述三处不同（69 字节），**代码区逐字节一致** ⇒ 现存 `build_uart` 产物与当前源码同源。

### 3. 回放复现（`vibmon_v6\test\ss_replay.exe` + `ss_eval.py`，17 段）

| 段 | 覆盖率（±10%） | 段首到首个正确读数 |
|---|---:|---:|
| 新 0.5Hz | 70% | 5.7s |
| 新 1Hz | 78% | 3.9s |
| 新 3Hz | 66% | 3.9s |
| 旧 0.5Hz | 55% | 13.4s |
| 旧 1Hz | 71% | 3.7s |
| 旧 2Hz | 38% | 5.2s |
| **旧 3Hz（实板失败段）** | **59%** | 3.2s |
| 新 2Hz | 52% | 0.7s |
| 新 3Hz 末 | 66% | 2.6s |
| 6.1 2Hz | 78% | 2.7s |
| 6.1 3Hz | 87% | 1.2s |
| 6.2 2Hz | 41% | 0.2s |
| **6.2 3Hz** | **94%** | 0.4s |
| **固定振动（新旧振子）** | 假读数 **0s** | — |
| 固定振动 u4 | 假读数 2s | — |
| 固定振动 u5 | 假读数 0s | — |
| 空握 v6（1.txt） | 假读数 3s | — |

三个关键数与 RT012-20261106b 的「修正后」列逐项一致：旧 3Hz **59%**、6.2-3Hz **94%**、固定振动假读数 **0s**。

### 4. v5 对照（同一套宿主测试）

| 配置 | contact_test | dump_test |
|---|---:|---:|
| v5 当前工作区（`CT_HOLD_ENABLE=1` + T011 + SS 门 120/80） | **67/67** | 15/19（同 4 项） |

（任务卡预期 65/65，实测 67/67；与 RT011-20261106 记录一致。）

### 5. 出发判断表（v5 vs v6）

| 项 | v5（`CT_HOLD_ENABLE=1` + T011） | v6（`vibmon_v6` 当前） | 数据来源 |
|---|---|---|---|
| 进入条件 | 闭合角 + 幅值门 400mg + 频率门 75Hz 三重与；另加 T011 启停≥1.5Hz 路径 | 闭合角 + **手指已停下**（陀螺 4Hz 低通 <10dps 持续 150ms）+ 振动证据（幅值且频率，或启停≥1.5Hz） | 代码 / T012 |
| 保持 | `CT_HOLD_MS=1200`：用最近振动证据续命，覆盖启停 OFF 段 | **不再看加速度、无 1.2s 超时**，只有陀螺能判退出 | 代码 / RT011 / RT012b |
| 分离 | 张开（角度门退出）；退出延迟 0.30~0.42s | 张开，**或**进入后净转角又过 10°（含继续收拢） | T005/T008 / RT012b |
| 0.5Hz 首读数 | 8.0s（3.txt 62.8s 起振→70.8s 出读数）；下限 2 个周期=4s | 实板 3.3~3.8s（V6/6~8.txt）；回放 5.7s（新振子段）／13.4s（旧振子段） | RT011 / T012 / 本卡 |
| 2Hz 读数 | 1.99~2.01，稳定段 CT 100% | 第二轮实板 2/3Hz 接触只在两次松手时退出；旧 3Hz 读数 2.93~2.95 | RT011 / T012 |
| 3Hz 读数 | 2.88~2.97，稳定段 CT 100% | 回放旧 3Hz 从 0% 提到 59%（起振门 180/150→120/80）；新 3Hz 段 66% | RT011 / 本卡 |
| 空握误进 | 6 次、合计约 23s（新\1.txt 108s） | 第一轮 1 次 2.2s、第二轮 0 次 | RT011 / T012 |
| 关振后退出延迟 | 关源后 0.30s（T008 P3）~0.42s（T005）掉 0 | **关源、手仍握着：16.4s 内 ct 一直 1（不退）**；松手（AMP 塌陷）→ ct 掉 0 = 20~396ms | T005/T008 / 本卡 |
| 帧格式 | 默认 35 字节（`COMP_FRAME_CL=0`）；T008 实板 3008/3008 校验错 0 | `$VD` 仍 35 字节，只多 `#V6`/`#F=` 调试行（开 `d` 才有）；宿主机 comp_frame 22/22 与 v5 相同 | T008 / 本卡 |
| dump | 15/19（4 项既有列数问题） | 15/19（同 4 项） | 本卡 |

> 两版的 0.5Hz 首读数是**不同实测段**（v5 用 `结果\T009\新\3.txt`，v6 用 `测试\V6\4+5.txt` 与 `V6\6~8.txt`），不是同一段回放，横向比数字只作量级参考。

### 6. 实板体检

上板固件：v6 CDC 构建（`bp_cdc` 产物，闪存写入 373152 字节，`Hash of data verified`），烧录口 COM9（检测模块原生 USB）。

**上板/下板情况**：本卡期间检测模块一直跑 v6 CDC 构建（`.bin` SHA-256 `131c1bbf…`，源码树 `1de3b95`）；体检结束后**没有烧回** v5 或其它版本，板上现在仍是 v6 CDC 构建。

#### 检查 C —— 空握 10 次（`测试\V6b\检查C-空握.txt`）

| 项 | 数值 |
|---|---|
| 采集时长 / `#F` 帧数 | 70.2s / 350 帧（5Hz） |
| `ct=1` 帧数 | **0** |
| 空握误进次数 / 总时长 | **0 次 / 0s** |

#### 检查 A —— 旧振子 2Hz 启停 35s，手指保持不动（`测试\V6b\检查A-旧2Hz.txt`）

振源：COM7，命令 `b`（选旧振子 B=GPIO4）+ `T2`（自动通断 2.0Hz，ON 250 / OFF 250 ms，占空比 85%），19:09:32.4~19:10:07.6。

| 项 | 数值 |
|---|---|
| `#V6` / `#F` 帧数 | 176 / 176（5Hz × 35s） |
| `#V6 lpW`（dps） | min 0 ｜ **中位 0.2** ｜ max 6.8 |
| `#V6 moved`（°） | min 中位 max **全为 0.9**（净转角 35s 内几乎不累计） |
| `#V6 settled=1` 占比 | **100%** |
| `#V6 closed=1` 占比 | **100%** |
| `#F ct=1` 占比 | **100%（176/176）** —— 2Hz 启停全程没有掉接触 |
| `#F` 幅值 A（mg） | min 5.1 ｜ 中位 51.3 ｜ max 345.4 |
| `#F` 启停读数 SS（Hz） | min 0 ｜ 中位 **1.99** ｜ max 2.03 |
| `$VD` 帧数 | **0**（4pin 比赛口这一趟没接，见异常项） |

#### 检查 B —— 连续振动中松手（`测试\V6b\检查B-松手.txt`、`检查B-松手2.txt`）

第二个 USB 口换成 4pin 的 CH340（COM4）后采的 `$VD`（50Hz）。旧振子 B 手动 100%，两轮各 4 次松手-握回。

先记一个方法学事实：**口语提示不能当"松手时刻"**。提示发出到 `$VD` 里 AMP 开始塌陷之间稳定差 **2.0~2.3s**（含语音合成启动延迟与人的反应），所以下面分两组数。

**（a）以"机械松开"为起点** —— 手一松、模块不再压在振子上，`AMP` 从振动态塌下来。取「峰值一半」那一帧为松手时刻：

| 次 | `ct` 掉 0 时刻 | 前 2s 峰值 | 松手帧 | 松手→ct 掉 0 |
|---:|---|---:|---|---:|
| 1-1 | 19:14:32.599 | 1009mg | 19:14:32.280 (700mg) | **319ms** |
| 1-2 | 19:14:41.074 | 1515mg | 19:14:41.054 (822mg) | **20ms** |
| 1-3 | 19:14:50.701 | 1049mg | 19:14:50.541 (626mg) | **160ms** |
| 1-4 | 19:14:59.817 | 1208mg | 19:14:59.720 (783mg) | **97ms** |
| 2-1 | 19:18:35.976 | 1232mg | 19:18:35.742 (893mg) | **234ms** |
| 2-2 | 19:18:45.669 | 1572mg | 19:18:45.273 (829mg) | **396ms** |
| 2-3 | 19:18:55.276 | 1412mg | 19:18:54.897 (746mg) | **379ms** |
| 2-4 | 19:19:05.345 | 1182mg | 19:19:05.094 (768mg) | **251ms** |

8 次全部检到（`ct` 1→0），范围 **20~396ms**，中位约 250ms。若改用「AMP 塌到 <400mg」为起点，第二轮四次是 194 / 197 / 201 / 211 ms。

**（b）以口语提示为起点**：1.36~2.40s（8 次的 1.36 / 1.75 / 1.80 / 2.09 / 1.96 / 2.06 / 2.37 / 2.40 s），其中约 2s 是提示延迟，不是固件延迟。

**（c）关掉振动源、手仍握着**：第二轮振源停后 AMP 持续 <20mg 的那一段共 **16.4s，`ct=1` 占 100%**（没掉）。v5 同一动作是 0.30~0.42s 掉 0。

#### 检查 D —— 帧格式（用检查 B 的日志，`--no-debug` 采 `$VD`）

| 项 | 结果 |
|---|---|
| 每行长度 | **33 字符**（正文 30 + `,` + 2 位 CHK），加 `\r\n` = **35 字节**；3102 行全部 33 |
| 帧样本 | `$VD,6086,01725,00074,1,0,000,B,63` |
| 字段 | SEQ / FREQx10 / AMP_MG / VIB / CT / SSx100 / VALID / CHK —— 与 T008 默认构建一致，**无 CL 字段** |
| CHK | 抽 5 帧按正文 XOR 重算，**5/5 对** |
| SEQ | 两段各 3906 帧 / 78.1s、3102 帧 / 62.0s，**不连续次数都是 0**（没丢帧） |
| VALID 分布 | `B`(ampValid+freqValid+contactValid) 2017、`9`(amp+contact) 1083、`A`(freq+contact) 2 |
| FREQ / AMP | 中位 172.9 / 177.1 Hz；584 / 152 mg（旧振子 100%） |

## 数据结论（结论是什么）

1. v6 当前源码在宿主侧全绿：contact 89/89、gyro 8/8、comp_frame 22/22、dump 15/19（4 项为 v5 也有的既有列数问题）、双 FQBN 0 warning。
2. 回放三个关键数复现（旧 3Hz 59%、6.2 档 94%、固定振动假读数 0s），与 RT012-20261106b 修正后一致。
3. v5 当前工作区的 contact_test 是 67/67（不是任务卡预计的 65/65）。
4. **ESP32 的 `.bin` SHA-256 不是稳定标识**：同源同 FQBN 两次构建差 68 字节，差异只在编译时刻/ELF 指纹/末尾指纹三处，代码区逐字节相同。现存 `build_uart` 产物与当前源码同源。
5. `代码\README.md` 已按任务卡写出 v5/v6 差异与编译方法。
6. 实板检查 C（空握 10 次）：`ct` 一次没进，**0 次 / 0s**（v6 两轮历史是 1 次 2.2s / 0 次）。
7. 实板检查 A（旧振子 2Hz 启停 35s、手不动）：接触 **176/176 帧恒 1，全程没掉**；`#V6 moved` 35s 内一直是 **0.9°**、`lpW` 中位 0.2dps、`settled` 100%。RT012b 里「旧振子 2Hz 掉 4 次、推测是启停反扭矩让手指来回摆」这一条，按实测应读作：**净转角根本没累计到 10° 分离门**，所以不分离。
8. 实板检查 B（两轮 8 次松手）：`ct` 1→0 全部检到。**关源、手仍握着时 ct 保持 1 达 16.4s 不退**（v5 是 0.30~0.42s 掉 0）；**松手（AMP 塌陷为起点）→ ct 掉 0 是 20~396ms，中位约 250ms**。
9. 实板检查 D：`$VD` **每帧 35 字节**（正文 33 + CRLF）、CHK 抽 5 帧全对、两段共 7008 帧 SEQ 不连续 0、字段与 T008 默认构建一致（无 CL）。v6 只多了 `#F`/`#V6` 调试行，而调试行走 USB、不混进 `$VD`。

## 异常与未解决项

- 本机只有两个 USB 口，检测模块的原生 USB（出 `#V6`）与 4pin 的 CH340（出 `$VD`）**不能同时插**，A/C 与 B/D 是两趟采的。
- 检查 B 的口语提示法有 **2.0~2.3s 固定延迟**（语音合成启动 + 人的反应），已在 RT 里改用 AMP 塌陷定位松手时刻；若只按口语提示算会得到 1.4~2.4s 的假延迟。
- 检查 A 的 `#V6 moved` 35s 内 min=中位=max=0.9°，没有变化；`$VD` 这一趟是 0 帧。
- 任务卡验收 4 写「v5 预期 65/65」，实测 67/67，差 2 项。
- 任务卡验收 2 要求记录 `.bin` SHA-256 —— 已按实测记录，但该值**不可复现**（见结论 4），不同构建会给出不同 SHA。
- `dump_test` 的 4 项失败在 v5/v6 都存在，本次未动。
