wmsz88/flex-vib-monitor/vibmon_v5/小模型/检验方案.md

# 赛题检验方案（vibmon_v5）

> **来源**：PLANNER-A 2026-11-02 评审
> **用途**：赛前逐项验证，按 P0→P1→P2→P3→P4 顺序执行
> **带 ⭐ 的是比赛前必须通过的**

---

## ⭐ P0 — 硬件可靠性

> 不通过则后续全无意义。优先修 SDA/SCL/3V3/GND 焊点和接插件。

| 编号 | 检验项 | 方法 | 合格标准 |
|---|---|---|---|
| H1 | I2C 静态稳定性 | 上电后静止 60s，`S` 命令检查 | `I2C错=0, 读失败=0, 不连续=0` |
| H2 | I2C 动态稳定性 | 连续 10 次"张开→闭合→张开"，每次动作后查 `S` | 全程无 `[FAULT]`，`I2C错=0` |
| H3 | 柔性板弯折可靠性 | 模拟仿生手指弯折，连续运行 3 分钟 | 无 `[FAULT]`，无 `传感器无响应` |
| H4 | 电源稳定性 | 万用表测 5V 轨 | 5V±0.25V，断开开关后电流=0 |

---

## ⭐ P1 — 核心判据验证

> 证明算法在实板上成立。

| 编号 | 检验项 | 操作 | 数据采集 | 合格标准 |
|---|---|---|---|---|
| A1 | 松手判据 | 张开手指，静止 10s | 每秒 `w` 一次 | `closed=0` 10/10, `ct=0` 10/10 |
| A2 | 空握判据 | 闭合但不接触任何物体，静止 10s | 每秒 `w` 一次 | `closed=1` 10/10, `ct=0` 10/10 |
| A3 | 接触判据(4cm) | 夹住 4cm 方块+振动源，持续 10s | `w` | `closed=1, ct=1` 保持率 ≥90% |
| A4 | 接触退出(关振源) | A3 进行中关闭振源 | `w` | `ct` 在 0.5s 内变 0 |
| A5 | 5 轮重复性 | A1→A2→A3→A4 重复 5 次 | 打标 CSV 或 `w` | 5/5 轮 A1/A2/A3 均通过 |

A3 关键判读：
- `closed=1`：角度超过 60°
- `ct=1`：幅值超过 400mg 且频率超过 75Hz

A2 关键判读（这是最容易误报的场景）：
- `closed=1`：手指确实合拢了
- `ct=0`：没有振动证据（关键：不要误报成 1！）

---

## ⭐ P2 — 频率检测精度

> 覆盖赛题要求的 80-180Hz 持续振动和 0-3Hz 启停。

| 编号 | 检验项 | 振源设置 | 合格标准 |
|---|---|---|---|
| F1 | 80Hz 下限 | 80Hz 持续 | `F` 读数 80±5Hz, `ct=1` |
| F2 | 180Hz 上限 | 180Hz 持续 | `F` 读数 180±5Hz, `ct=1` |
| F3 | 中频 130Hz | 130Hz 持续 | `F` 读数 130±5Hz |
| F4 | 启停 0.5Hz | 0.5Hz 通断 | `ssHz=0.50±0.05` |
| F5 | 启停 1Hz | 1Hz 通断 | `ssHz=1.00±0.05` |
| F6 | 启停 2Hz | 2Hz 通断 | `ssHz=2.00±0.05` |
| F7 | 启停 3Hz | 3Hz 通断 | `ssHz=3.00±0.10` |

---

## P3 — 边界与鲁棒性

| 编号 | 检验项 | 方法 | 合格标准 |
|---|---|---|---|
| B1 | 上电时已闭合 | 先闭合手指，再上电，等待标定完成 | 不崩溃；张开后功能正常 |
| B2 | 快速动作 | 1 秒内完成"张开→闭合→张开" | 不误报，不丢帧 |
| B3 | 削顶行为 | 用小量程(±2g) + 强振动 | `freqClipLimited=1` 且 `ct` 不误报 |
| B4 | 长时间运行 | 连续运行 10 分钟（可间歇动作） | 无 `[FAULT]`，角度不漂移 |
| B5 | AUTO_ZERO 行为 | 闭合→张开→静止 3s，检查基准 | 基准被正确重采，`D` 归零 |

---

## P4 — 比赛帧验证

| 编号 | 检验项 | 方法 | 合格标准 |
|---|---|---|---|
| C1 | 帧格式正确 | 串口助手验证比赛口输出 | 每 20ms 一帧，`$VD,...\r\n` |
| C2 | 校验和正确 | XOR 手动验算 10 帧 | 全部正确 |
| C3 | 字段语义一致 | 对照 `S` 状态核对 | FREQ/AMP/CT/SS 与 `S` 一致 |
| C4 | 现场平台对接 | 到场后与测试平台联调 | 确认波特率、帧格式 |

---

## 现场操作 SOP

```
上电前：
  1. 万用表确认 4PIN 线序：①TX ②RX ③GND ④VIN
  2. 确认模块平放、不接触任何物体
  3. 确认开关处于 OFF

上电：
  4. 合上开关 → 红灯亮
  5. 等待 5s：标定 + START 基线采集
  6. 绿灯 1Hz 闪烁 = 就绪
  7. 按 S 确认：I2C错=0, calOk=1

操作循环（每次检测）：
  8. 张开手指、静止 2s（等 AUTO_ZERO 重采基准）
  9. 闭合手指夹住物体
  10. 按 w 观察 ct=1
  11. 打分结束后张开，回到步骤 8
```

---

## 关键串口命令速查

| 命令 | 作用 | 常用时机 |
|:--:|---|---|
| `S` | 完整状态（I2C错、ct、closed、角度、频率…） | 每次动作前后 |
| `w` | 一行 `#SWEEP`（F/A/D/ang/vib/ct/cl…） | 检测时持续观察 |
| `T` | 采样时序统计 | 怀疑丢帧时 |
| `Q` | 一行 `#POST`（姿态诊断） | 怀疑姿态不对时 |
| `P` | 重采 START 基线 | 机械姿态变了时 |
| `c` | 重新标定 | 偏差明显时 |

---

## 赛前建议代码改动清单

| 优先级 | 改动 | 涉及文件 | 估计工作量 |
|---|---|---|---|
| 建议 1 | 比赛帧加 `closed` 字段 | `output.cpp`, `comp_frame_test.cpp` | 30 分钟 |
| 建议 2 | 确认 `COMP_FRAME_ENABLED` 最终值 | `config.h` | 5 分钟 |
| 建议 3 | 新增 `D` DUMP 命令 | `output.cpp`, `output.h` | 30 分钟 |

以上三个建议需由规划模型（deepseekv4pro 或 glm5.3）拆成任务卡，派给 flash 执行。不要自己直接改代码。
