wmsz88/flex-vib-monitor/vibmon_v5/答辩/答辩材料主文档.md

# vibmon_v5 答辩材料（主文档）

> 署名：2026-11-03 · Codex(flash) ｜ 数据日期：2026-11-02
> 说明：本文只引用已有结果文件与数据，每个论点标注来源（RT 号 + 数据路径）。

---

## 一、独有增量（相对同赛项其他队伍）

| 论点 | 依据（来源） |
|---|---|
| 历届六年（2021~2026）**无一届**要求"检测无振动状态下的接触" | 结果/RT003-20261102.md |
| 同赛项他人开源 `zhangxianggan/zongjisa-mpu6050` 判据仅"频带 RMS + 过零频率"二重与，**没有接触判定** | 结果/RT003-20261102.md（main.c:178-180） |
| 我方独有 ①：**CT 三重接触判据**（姿态 + 幅值 + 频率，含滞回与确认） | 结果/RT005-20261102.md；state.cpp:264-275 |
| 我方独有 ②：**CL 闭合字段**（比赛帧可区分"松手/空握/接触"，配置门控） | 结果/RT001-20261102.md |
| 我方独有 ③：**D 命令 24 列全量状态 CSV**（一眼看出三路判据哪路卡住） | 结果/RT002-20261102.md |
| 答辩口径（已定） | 「CL=1 表示握住，CT=0 表示无振动证据；接触判据按命题绑定振动激励设计，防合拢误判」 |

---

## 二、量化证据（每个数字都有出处）

| 论点 | 数据 | 来源 |
|---|---|---|
| 判据正确性 | 宿主测试 contact **46/46**、gyro **8/8**、comp_frame **22/22**（默认）/ **25/25**（CL=1）、dump **19/19** | 结果/RT001、RT002（独立复跑） |
| 五轮重复性 | **A5 五轮完整通关（历史首次）** | 结果/RT004-20261102.md；data/t004_20261102/run_p1 |
| 核心判据 | A1 松手 0/10 误报、A2 空握 0/10 误报、A3 接触 9/10、A4 关源退出 **0.42~0.43s** | 结果/RT004、RT005；data/t004_20261102/run_p1 |
| 频段互补覆盖 | 双振子稳态 **77~175.7Hz**（a=GPIO3 新低速 71~120Hz；b=GPIO4 原振子 101~175.7Hz） | 结果/RT005、RT006；data/t005_20261102、t006_newblock |
| 测频上限 | 瞬态正确跟踪 **201.4Hz**（超赛题 180Hz 上限）：3 行 @12:51:07.854，A 35.1/53.0/58.7mg | vib_range_test/data/startstop_live_20261102_fixed.csv（已回读核对） |
| 启停响应 | 0.50 / 1.00 / 2.00 / 2.94 Hz 四档实测（观测 0.50~0.53 / 1.00~1.01 / 1.99~2.02 / 2.92~3.00） | vib_range_test/data/startstop_live_20261102_final2.csv、_fixed.csv |
| 接触/退出 | 关源后两路证据同塌、**0.42s 退出**（D2 ×3 复现） | 结果/RT005；data/t005_20261102/run.dump.csv |
| D 命令实板 | condAmp=1 样例 3 条（A≈907~938mg、ct=1） | 结果/RT005；data/t005_20261102/run.dump.csv |
| 帧兼容 | 默认帧 **35 字节**与改动前 **8/8 逐字节一致**；CL 开启 **37 字节** | 结果/RT001-20261102.md |
| 供电 | 振源板输入 5V（USB）**无跌落** | 结果/RT006-20261102.md（人类实测） |

---

## 三、设计定性（答辩必问：为什么这样设计）

1. **接触"保持"规则（不是 bug）**：进入需三证齐全（姿态 & 幅值门 & 频率门），**保持只需"姿态 + 幅值或频率任一"**——有意设计，防比赛间歇激励把一次握持切碎。实测：关源时两路证据同时失效，**0.42s 正常退出**；所谓"锁存"仅 1 例、且是非比赛工况（抽走物体但振源仍开）。来源：结果/RT005 + state.cpp:264-275。
2. **180Hz 端点**：本地稳态激励上限 **175.7Hz**（新方块 8s 连续、A≈690mg、ct 7/8），180Hz 无稳定本地激励源；但测频链路有 **162~172Hz 稳态** + **201.4Hz 瞬态**背书，传感器侧无缺陷。来源：结果/RT006 + T006 卡 23:44 补充。
3. **双轴架构**：陀螺积分角 **θ>60°** 判"闭合" + 高通幅值 **A>400mg 且 主频 F>75Hz** 判"接触"。用陀螺积分角（±500dps，GYRO_FS_SEL=1）是因为单靠投影角分辨力不足。来源：陀螺仪改造方案.md；大模型/评审报告_20261102.md。

---

## 四、风险预案与现场 SOP

| 风险 | 预案 |
|---|---|
| 平台帧格式未确认 | `COMP_FRAME_CL` 默认 0（逐字节兼容现状）；现场确认可调后一行配置打开（T001） |
| 平台要求先不发数据 | `COMP_FRAME_ENABLED` 冻结 1；到场快速改 0 重烧（SOP 已列 T001 验证项） |
| 开机姿态 | 复位后必须**张开静止**在 START 位（不在该位会被拒/角度失效，见 RT005/RT006 教训） |
| 振源控制 | COM7 单字符协议（0~9/h/p/±/z）；**通道档案（T006 修正，固定前提）：a=GPIO3 新低速振子、b=GPIO4 原振子** |
| 比赛帧不发 CL | 若平台锁定 35 字节：CT=0 时结合现场观察区分松手/空握（答辩说明） |

---

## 附录：比赛帧与命令（速查）

- 比赛帧（默认 35 字节）：`$VD,SEQ,FREQx10,AMP_MG,VIB,CT,SSx100,VALID,CHK\r\n`；CL 开启后 37 字节（CL 插在 CT 后）。
- 调试命令：`S` 状态 / `w` 一行采样 / `D` 全量 CSV / `Q` 姿态诊断 / `t` 采平放基准 / `P` 重采 START 基线 / `c` 重标定。
