wmsz88/flex-vib-monitor/vibmon_v5/结果/RT001-20261102.md

# RT001-20261102 — T001 比赛帧增加 CL 字段（配置门控）

任务号: T001
执行模型: flash
执行日期: 2026-11-02

## 改动摘要（做了什么）

| 文件 | 改动 |
|---|---|
| `config.h:51-60` | 新增 `#ifndef COMP_FRAME_CL / #define COMP_FRAME_CL 0`，附 35/37 字节两种帧格式说明与 CL 位语义 |
| `output.cpp:120-160` | `compBuildFrame()`：新增 `COMP_BODY_SIZE`/`COMP_OUT_MIN`（32/36 → 34/38）与 `#if COMP_FRAME_CL` 双分支 snprintf（CL 拼在 CT 之后）；字段取值先落局部量再拼装，CL=0 分支的格式串与传参顺序与改动前相同 |
| `output.cpp:197-205` | `outPrintBanner()` 在 CL 开启时多打一行「帧含 CL 字段：37 字节」（仅调试口，比赛口仍完全静默） |
| `output.h:27-31` | `compBuildFrame()` 注释补充两种帧长与缓冲区要求 |
| `test/comp_frame_test.cpp:1-9` | 修正文件头编译命令（原命令缺 `dsp.cpp`，`dspCalReport/dspCal/calResultStr` 链接失败），补 `-DCOMP_FRAME_CL=1` 第二条命令 |
| `test/comp_frame_test.cpp:78-96` | 断言改为随 `COMP_FRAME_CL` 自动切换的常量：`BODY_LEN/FRAME_LEN/OUT_MIN/BODY_ZERO/BODY_CTACT` + 字段偏移 `OFF_SEQ/OFF_FREQ/OFF_AMP/OFF_CT/OFF_CL/OFF_SS/OFF_VALID` |
| `test/comp_frame_test.cpp:160-172` | 新增 CL=1 专项 3 条断言（CL 位随 `closed` 翻转、closed=false 的期望正文、校验随 CL 翻转而变） |

未改动：`state.cpp`、`state.h`、`dsp.cpp`、`sampler.cpp`、`vibmon_v5.ino`。

## 测试/测量数据（测到什么）

### 1. 两种构建的一帧完整样例

默认构建（`COMP_FRAME_CL=0`，比赛配置）：

| 用例 | 文本帧（含 CRLF） | 字节数 | hex |
|---|---|---|---|
| all-zero | `$VD,0000,00000,00000,0,0,000,0,1A\r\n` | 35 | `2456442C303030302C30303030302C30303030302C302C302C3030302C302C31410D0A` |
| 典型接触 (seq=137) | `$VD,0137,01652,00966,1,1,120,F,63\r\n` | 35 | `2456442C303133372C30313635322C30303936362C312C312C3132302C462C36330D0A` |

CL 开启构建（`COMP_FRAME_CL=1`）：

| 用例 | 文本帧（含 CRLF） | 字节数 | hex |
|---|---|---|---|
| 典型接触 + closed=1 (seq=137) | `$VD,0137,01652,00966,1,1,1,120,F,7E\r\n` | 37 | `2456442C303133372C30313635322C30303936362C312C312C312C3132302C462C37450D0A` |
| 典型接触 + closed=0（同上，仅 closed=0） | `$VD,0137,01652,00966,1,1,0,120,F,7F\r\n` | 37 | `2456442C303133372C30313635322C30303936362C312C312C302C3132302C462C37460D0A` |

### 2. 双 FQBN 编译（arduino-cli `--warnings all`）

| 构建 | FQBN | warning 行数 | 退出码 | flash / 静态 RAM |
|---|---|---|---|---|
| CDC（比赛用） | `esp32:esp32:esp32c3:CDCOnBoot=cdc` | **0** | 0 | 369884 B (28%) / 30268 B (9%) |
| 非 CDC（验证用） | `esp32:esp32:esp32c3` | **0** | 0 | 364784 B (27%) / 30092 B (9%) |
| CDC + `-DCOMP_FRAME_CL=1`（门控分支目标端可编） | `esp32:esp32:esp32c3:CDCOnBoot=cdc` | **0** | 0 | 369988 B (28%) / 30268 B (9%) |

### 3. 宿主测试

| 测试 | 编译 | 结果 |
|---|---|---|
| `comp_frame_test`（默认模式） | `g++ -std=c++17 -Wall -I test -I . test/comp_frame_test.cpp output.cpp state.cpp dsp.cpp` | **22 pass / 0 fail**（与改动前同数同项） |
| `comp_frame_test`（CL=1 模式） | 同上 + `-DCOMP_FRAME_CL=1` | **25 pass / 0 fail**（22 条 + CL 专项 3 条） |
| `contact_test`（回归） | `g++ -std=c++17 -Wall -I test -I . test/contact_test.cpp state.cpp` | **46 pass / 0 fail** |
| `gyro_test`（回归） | `g++ -std=c++17 -Wall -I test -I . test/gyro_test.cpp dsp.cpp state.cpp` | **8 pass / 0 fail** |

### 4. CL=1 模式下 XOR 校验手工验算

正文 `$VD,0137,01652,00966,1,1,1,120,F`（32 字节），逐字符码位：

`36,86,68,44,48,49,51,55,44,48,49,54,53,50,44,48,48,57,54,54,44,49,44,49,44,49,44,49,50,48,44,70`

逐字节 XOR = `0x7E`，与实测帧 `...,F,7E` 的校验位一致；同一正文把 CL 由 1 改成 0 得 `0x7F`，与实测 `...,F,7F` 一致 ⇒ 校验覆盖 CL 字段。

### 5. `config.h` 冻结宏当前值

| 宏 | 值 | 位置 |
|---|---|---|
| `UART_SWAP` | 1 | `config.h:13` |
| `COMP_FRAME_ENABLED` | **1（未被误动）** | `config.h:39` |
| `COMP_FRAME_CL` | 0 | `config.h:52` |
| `COMP_BAUD` | 115200 | `config.h:35` |
| `COMP_PERIOD_MS` | 20（50Hz） | `config.h:42` |
| `CT_MODE` | 4 | `config.h:329` |

### 6. 「默认构建与改动前逐字节一致」的对比证据

用 `git archive HEAD vibmon_v5` 导出改动前的源码树，与工作区各编一个 dump 程序（同一份 `dump_frames.cpp`，只在 CL=0 下跑），对同一组 8 个 `Result` 输入打印帧的文本与 hex：

| 输入 | 改动前(HEAD) 长度 | 工作区(CL=0) 长度 | 结果 |
|---|---|---|---|
| all-zero | 35 | 35 | 文本+hex 一致 |
| typical-contact | 35 | 35 | 一致 |
| low-band (82.45Hz/5.1mg) | 35 | 35 | 一致 |
| high-band (185.9Hz/1450mg) | 35 | 35 | 一致 |
| saturation (9999.95Hz/123456mg/9.999Hz) | 35 | 35 | 一致 |
| amp-only | 35 | 35 | 一致 |
| closed-no-vib | 35 | 35 | 一致 |
| exact-zero | 35 | 35 | 一致 |

`Compare-Object` 两文件无差异（8/8 逐字节相同）。

## 数据结论（结论是什么）

1. 默认构建（`COMP_FRAME_CL=0`）的 `$VD` 帧仍是 35 字节，8 组输入与 HEAD 逐字节一致；冻结宏 `COMP_FRAME_ENABLED` 仍为 1、`UART_SWAP=1`、`CT_MODE=4` 未被改动。
2. `-DCOMP_FRAME_CL=1` 时帧为 37 字节，CL 位于 CT 之后（正文字节偏移 25），XOR 覆盖该字段；该分支在主机（25/25）与 ESP32-C3 目标端（0 warning）均可编译运行。
3. 三项宿主测试在默认构建下全部通过（22/22、46/46、8/8），门控未触碰既有命令与 `$VD` 拼装路径以外的任何逻辑。

## 异常与未解决项

- `test/comp_frame_test.cpp` 文件头原有编译命令 `... ../output.cpp ../state.cpp` **链接必然失败**（`dspCalReport()`/`dspCal()`/`calResultStr()` 未定义，来自 `output.cpp` 对 `dsp.cpp` 的依赖）；已按实测可用命令改写文件头。工作区里原有的三个 `.exe` 与文档命令不一致，无法据此复现。
- `test/gyro_test.cpp`、`test/comp_frame_test.cpp` 的旧注释用 `-I .. ../xxx.cpp` 形式，要求在 `test/` 目录下执行；实际可用形式是在 `vibmon_v5/` 下用 `-I test -I .`、无前缀路径。本次结果统一用后者。
- `contact_test` 现为 46/46（`当前状态.md` 存档记为 43/43），差异来自本轮之前工作区已有的 `state.cpp`/`state.h` 未提交改动，不是本次改动引入。
- 未做实板验证：本轮全部为主机测试与目标端编译，`COMP_FRAME_CL` 在实板上的实际发送字节数（37）未用串口抓取核对。
- `compPeriodic()` 的 `char buf[40]` 容纳 37 字节帧有余量（37+1 ≤ 40），未改缓冲区大小。

## 附：陀螺量程（按 `规划/plan.md` §下一步方向 第 4 条要求顺带回传）

- `config.h:75`：`GYRO_FS_SEL = 1` → 满量程 **±500 dps**。
- `mpu.cpp:74`：写入 `REG_GYRO_CONFIG(0x1B) = (GYRO_FS_SEL & 0x03) << 3 = 0x08` —— 与 `陀螺仪改造方案.md` §2 建议的 `GYRO_CONFIG=0x08 / ±500dps` **一致**。
- `mpu.cpp:124`：`mpuLsbPerDps() = 131.0 / (1 << 1) = 65.5` LSB/dps。
- 本轮未改动该配置。
