wmsz88/flex-vib-monitor/vibmon_v5/结果/RT002-20261102.md

# RT002-20261102 — T002 新增 D 命令（DUMP 全量状态 CSV）

任务号: T002
执行模型: flash
执行日期: 2026-11-02

## 改动摘要（做了什么）

| 文件 | 改动 |
|---|---|
| `output.h:35-48` | 新增 `extern const char OUT_DUMP_HEADER[];` 与 `int outBuildDump(const Result&, char*, int)`（纯格式化函数，便于主机测试） |
| `output.cpp:527-621` | 新增 `OUT_DUMP_HEADER`（23 列名常量）、`outBuildDump()`（组装数据行）、`static dumpLine()`（表头行 + 数据行，输出到调试口 `OUT`） |
| `output.cpp:817` | `outPollCmd()` 命令分发新增 `case 'D': setPlot(PLOT_OFF); dumpLine(); break;`（`D` 为大写，与小写 `d` 调试行开关不冲突） |
| `output.cpp:707` | `'?'` 帮助新增一行：`D 全量状态CSV(表头+数据)：看接触三路 condPosture/condAmp/condFreq` |
| `test/dump_test.cpp` | 新增主机测试 19 条断言（列数一致、静态/接触/空夹三例全文、缓冲区保护、表头必备列） |

未改动：`compBuildFrame()`、`compPeriodic()`、`$VD` 帧格式串、`COMP_PERIOD_MS`、`state.cpp/h`、`dsp.cpp`、`vibmon_v5.ino`。`OUT` 宏 = `Serial`（调试口），`Serial1`（比赛口）在 D 路径上完全没有调用。

## 测试/测量数据（测到什么）

### 1. D 命令输出完整样例（宿主注入，实测输出）

表头行（每次敲 D 先输出这一行）：

```
#DUMPH,t_ms,closed,flatDist,flatDistValid,closeAngleDeg,angleValid,condPosture,condAmp,condFreq,ct,ctValid,vib,freqHz,freqValid,ampMg,ampValid,ssHz,ssValid,grip,gyroW,ax,cliplim,ok
```

| 场景 | 数据行（实测，`dump_test` 逐字节断言） |
|---|---|
| 静态（无基准、无振动、角度无效） | `#DUMP,0,0,-1.0,0,0.0,0,0,0,0,0,0,0,0.0,0,0.0,0,0.00,0,0,0.0,0,0,0` |
| 模拟接触（三路判据全 1，t=12345ms） | `#DUMP,12345,1,486.4,1,72.5,1,1,1,1,1,1,1,165.2,1,965.7,1,1.20,1,0,12.3,2,0,1` |
| 空夹（握下但幅值/频率没起来） | `#DUMP,0,1,520.0,1,0.0,0,1,0,0,0,1,0,0.0,0,0.0,0,0.00,0,1,0.0,0,0,0` |

（空夹例可直接读出：condPosture=1 而 condAmp=0、condFreq=0 ⇒ 卡在振动证据，不在姿态。）

### 2. 字段与取值来源对照表

| 列 | 取值来源 | 单位/编码 |
|---|---|---|
| `t_ms` | `millis()` | ms |
| `closed` | `Result.closed`（姿态门过） | 0/1 |
| `flatDist` | `Result.flatDist`，`flatRefSet=false` 时强制输出 -1 | mg |
| `flatDistValid` | `Result.flatRefSet` | 0/1 |
| `closeAngleDeg` | `Result.closeAngleDeg`，`angleValid=false` 时输出 0.0 | 度 |
| `angleValid` | `Result.angleValid` | 0/1 |
| `condPosture` | `Result.condPosture`（`flatDist > CT_FLAT_D_ON_MG`，即时、无滞回） | 0/1 |
| `condAmp` | `Result.condAmp`（`ampValid && ampMg > CT_FLAT_A_ON_MG`） | 0/1 |
| `condFreq` | `Result.condFreq`（`freqValid && freqHz > CT_FLAT_F_ON_HZ`） | 0/1 |
| `ct` | `Result.contact`（含滞回与确认延时） | 0/1 |
| `ctValid` | `Result.contactValid` | 0/1 |
| `vib` | `Result.vib` | 0/1 |
| `freqHz` | `Result.freqHz`（`freqValid` 为假或非有限值 → 0.0） | Hz |
| `freqValid` | `Result.freqValid` | 0/1 |
| `ampMg` | `Result.ampMg`（同上 → 0.0） | mg |
| `ampValid` | `Result.ampValid` | 0/1 |
| `ssHz` | `Result.ssHz`（`ssValid` 为假或非有限值 → 0.00） | Hz |
| `ssValid` | `Result.ssValid` | 0/1 |
| `grip` | `Result.gripNoObject`（空夹） | 0/1 |
| `gyroW` | `Result.gyroW`（合成角速度） | dps |
| `ax` | `Result.axis` | 0~2 |
| `cliplim` | `Result.freqClipLimited`（主频因削顶降级） | 0/1 |
| `ok` | `freqValid && ampValid && !freqClipLimited`（与 `#SWEEP` 的 ok 同口径） | 0/1 |

### 3. 双 FQBN 编译

| 构建 | warning 行数 | 退出码 | flash / 静态 RAM |
|---|---|---|---|
| `esp32:esp32:esp32c3:CDCOnBoot=cdc`（比赛用） | **0** | 0 | 371442 B (28%) / 30268 B (9%) |
| `esp32:esp32:esp32c3`（验证用） | **0** | 0 | 366342 B (27%) / 30092 B (9%) |

### 4. 宿主测试（含既有三项防回归）

| 测试 | 结果 |
|---|---|
| `dump_test`（本轮新增） | **19 pass / 0 fail** |
| `comp_frame_test`（默认 CL=0） | **22 pass / 0 fail** |
| `comp_frame_test`（`-DCOMP_FRAME_CL=1`） | **25 pass / 0 fail** |
| `contact_test` | **46 pass / 0 fail** |
| `gyro_test` | **8 pass / 0 fail** |

`dump_test` 覆盖：表头与数据行逗号数一致（23 个分隔符 = 24 字段）、表头含当场必需的 8 个列名、静态/接触/空夹三例全文比对、`out=nullptr` 与 32 字节小缓冲返回 -1。

### 5. 改动隔离（D 分支未触碰 `$VD` 帧拼装路径）

- `compBuildFrame()` 与 `compPeriodic()` 的函数体、帧格式串、`COMP_PERIOD_MS` 本轮一个字都没改（T002 只落在新增常量/函数/一个 `case`/一行帮助）。
- D 的输出全部经 `outPrintf()` → `OUT`（`Serial`，调试口）；比赛口 `Serial1` 只出现在 `compPeriodic()`，D 路径无任何 `Serial1` 调用。
- `case 'D'` 只做 `setPlot(PLOT_OFF)` + 一次格式化输出，不读串口缓冲之外的任何状态、不改 `Result`、不改 seq/时间基准。

## 数据结论（结论是什么）

1. 敲 `D` 得到「表头行 + 数据行」两行；数据行 24 列，与表头列名一一对应（测试用逗号数锁死，23 个分隔符），现场不用翻代码即可定位列。
2. 接触判据三路即时结果 `condPosture/condAmp/condFreq` 与 `closed`、`flatDist`、`closeAngleDeg`、`ct`、`ctValid` 全部在同一行内可读；空夹场景实测行能直接区分「姿态没下去」与「振动证据没起来」。
3. 新增仅走调试口，`$VD` 比赛帧的 35 字节格式、50Hz 节奏与 `compBuildFrame/compPeriodic` 代码均未变；双 FQBN 0 warning，既有 4 项宿主测试（22/25/46/8）全过。

## 异常与未解决项

- D 命令未做实板验证：全部数据来自宿主注入的 `Result`，未在 ESP32-C3 上实际敲 `D` 抓串口。
- 打标模式（`k0~k6`）与 D 的交互未加互斥：打标期间敲 `D`，表头与数据行会混进那条独占 CSV 里。本轮未加判断。
- `OUT_DUMP_HEADER` 是 `output.cpp` 里的全局常量、`output.h` 里 `extern` 声明；ESP32 构建 0 warning，但常量表与数据行是两份并列文本，靠测试的「逗号数一致 + 关键列名存在」两条断言防漂移，列**顺序**写错不会被这两条断言抓到（三例全文断言能兜住顺序，但新增列时仍需同步两处）。
- 数据行格式串固定为 24 列，缓冲区 192 字节；`t_ms` 64 位溢出与本函数无关（`unsigned long` 在 ESP32 为 32 位，约 49.7 天回绕，与 `#SWEEP` 的 `t=` 同口径）。
- 文件行尾：`config.h`/`output.cpp` 工作区为 CRLF（与仓库 `.gitattributes` 的 `eol=lf` 不一致，git 提交时会报警并归一），`output.h`/`test/*.cpp` 为 LF。本轮未改动行尾风格。

## 附：陀螺量程（按 `规划/plan.md` §下一步方向 第 4 条要求顺带回传）

- `config.h:75`：`GYRO_FS_SEL = 1` → 满量程 **±500 dps**。
- `mpu.cpp:74`：写入 `REG_GYRO_CONFIG(0x1B) = (GYRO_FS_SEL & 0x03) << 3 = 0x08` —— 与 `陀螺仪改造方案.md` §2 建议的 `GYRO_CONFIG=0x08 / ±500dps` **一致**。
- `mpu.cpp:124`：`mpuLsbPerDps() = 131.0 / (1 << 1) = 65.5` LSB/dps。
- 本轮未改动该配置。
