wmsz88/flex-vib-monitor/vibmon_v5/结果/RT004-20261102.md

# RT004-20261102 — T004 实板检验第一轮：P0 + P1(A5) + 双振源 + D 命令

任务号: T004
执行模型: flash（Codex 执行侧）
执行日期: 2026-11-02

## 改动摘要（做了什么）

- 新增测试脚本 `代码/vibmon_v5/_probe/t004/`：`run_t004.py`（语音引导 + 后台采集，一轮跑完 P0/P1/双振源/D）、`analyze_t004.py`（判读）、`grab_frames.py`（抓 `$VD`）、`README.md`。
- 新增双路振源固件工程 `C:\Users\Lenovo\Desktop\STM32project\vibsource_esp32_dual\`（`config.h` + `vibsource_esp32_dual.ino`）：GPIO3=旧/原振子(A)、GPIO4=新低速振子(B)，新增通道选择命令 `a`/`b`，`z`=两路全停；原单路工程 `vibsource_esp32\` 未改动。
- 烧录（arduino-cli，fqbn `esp32:esp32:esp32c3:CDCOnBoot=cdc`，0 warning，校验通过）：
  - COM9 ← 当前仓库 `vibmon_v5`（含 T002 的 `D` 命令、T001 的 `CL` 门控；冻结宏 `CT_MODE=4 / UART_SWAP=1 / COMP_FRAME_ENABLED=1` 原样，`CL` 默认关，帧仍 35 字节）。
  - COM7 ← `vibsource_esp32_dual`。
- 原始数据目录：`代码/vibmon_v5/data/t004_20261102/`，子目录 `run_p0`、`run_p1`、`run_dual_dump`、`run_dump2`。
- 时序说明：`run_p0`/`run_p1`/`run_dual_dump` 在 COM9 重烧前（旧固件）采集；`run_dump2` 在重烧后（当前仓库固件）采集。

## 测试/测量数据（测到什么）

### P0 硬件证据（run_p0）

| 项目 | 条件 | 数值 | 备注 |
|---|---|---|---|
| H1 | 静止 60s，7 次 S 快照 | 读失败 0->0(Δ0)，I2C错 0->0(Δ0)，不连续 595->596(Δ1) | 全程 传感器=在线、标定=有效/合格 |
| H3 | 弯折 3min，6 次 S 快照 | 读失败 Δ0，I2C错 Δ0，不连续 598->604(Δ6)，FAULT=0 | 同上 |

（不连续/读失败/I2C错 为上电累计计数器，启动+标定期已攒到约 595；判读取段内增量。）

### P1 核心判据 + A5（run_p1，5 轮，4cm 方块 + 原振子 100%）

| 轮 | A1 松手(10条) | A2 空握(10条) | A3 接触 ct=1 占比 | A4 关源首次 ct=0 |
|----|---|---|---|---|
| 1 | 0/10 误报 | 0/10 误报 | 9/10=90% | 段首已为 0（紧接 T1，读数被混淆） |
| 2 | 0/10 | 0/10 | 9/10=90% | 0.42s |
| 3 | 0/10 | 0/10 | 9/10=90% | 0.42s |
| 4 | 0/10 | 0/10 | 9/10=90% | 0.43s |
| 5 | 0/10 | 0/10 | 9/10=90% | 0.42s |

- A3 每轮唯一落 0 的是振源刚开、电机未起转的那条（A≈23~104mg）；其余 9 条 ct=1（A≈750~1260mg，F≈106~122Hz）。
- A5 五轮重复：5/5 全部通过（A1/A2/A3/A4 每轮均达标）。
- T1 工单（第 1 轮，抽走物体、振源仍开）：A 694->59->18mg，ct 在约 1.7s 掉 0；但约 3.2s 起又跳回 ct=1 并锁存至窗口结束（A≈80~220mg、F≈122~131Hz）。相对播报「抽」的首次 ct=0 计为 3.64s（含人反应+播报耗时）。

### 双振源两段频带（run_dual_dump，COM7 双路板）

| 段 | 引脚/占空比 | ct=1 占比 | F 中位 | A 中位 |
|----|---|---|---|---|
| B-orig 旧/原振子 | GPIO3，a+h(100%) | 11/12=92% | 111.8 Hz | 986 mg |
| B-new 新低速振子 | GPIO4，b+p(55%) | 11/12=92% | 100.5 Hz | 284 mg |

- 两段唯一落 0 的同样是起转那条；其后 11 条 ct=1。
- 新低速振子 55% 下幅值明显偏弱（约 200~410mg，多数不过 400mg 门），ct 保持主要靠滞回/保持规则。

### D 命令（run_dump2，重烧后新固件）

```
#DUMPH,t_ms,closed,flatDist,flatDistValid,closeAngleDeg,angleValid,condPosture,condAmp,condFreq,ct,ctValid,vib,freqHz,freqValid,ampMg,ampValid,ssHz,ssValid,grip,gyroW,ax,cliplim,ok
#DUMP,21726,0,2.2,1,0.0,1,0,0,0,0,1,0,0.0,0,5.3,1,0.00,0,0,0.3,2,0,0
#DUMP,30022,1,1719.8,1,115.8,1,1,0,0,0,1,0,0.0,0,6.1,1,0.00,0,0,0.2,2,0,0
```

- 张开：closed=0, closeAngleDeg=0, ct=0。
- 空握：closed=1, closeAngleDeg=115.8, condPosture=1, condAmp=0, condFreq=0, ct=0（姿态过门、幅值/频率未过 -> 正确不判接触）。

## 数据结论（结论是什么）

1. P0 硬件端口修复后成立：H1/H3 段内 读失败/I2C错 增量均为 0，无 [FAULT]，无掉线。
2. P1 核心判据在实板上成立：松手/空握五轮零误报；接触 5 轮 ct 保持均 ≥90%（实际为起转那条拖低，稳定后 100%）；关源退出约 0.42~0.43s；A5 五轮重复性 5/5 通过。
3. 双振源两段频带均可稳定判到接触：旧/原振子 F≈111.8Hz，新低速振子 F≈100.5Hz；但新振子幅值（≈284mg 中位）远低于旧振子（≈986mg）。默认构建下帧仍为 35 字节；重烧后 D 命令在实板上可用，空握场景三路判据（姿态过门、幅值/频率未过）读数符合设计。

## 异常与未解决项

- T1 观察到 ct 跳变锁存：抽走物体后 ct 约 1.7s 掉 0，随后约 3.2s 又跳回 1 并保持（余振 A≈80~220mg、F≈122~131Hz，振源仍在转）。
- A4 退出余量小：第 2~5 轮首次 ct=0 为 0.42~0.43s，判据上限 0.5s，余量约 0.1s；第 1 轮因紧接 T1、段首 ct 已为 0，该轮 A4 读数不可用。
- 新低速振子幅值弱：55% 下 A≈200~410mg，多数不过 400mg 门；最低频段（80Hz 附近）接触判据的幅值余量待进一步测。
- $VD 比赛帧未抓取：本机仅有 COM7/COM9，无接比赛口(GPIO21)的 USB-TTL，grab_frames.py 未运行，35 字节帧格式未在实板上逐帧核对。
- 数据集跨两个固件版本：P0/P1/双振源在旧 COM9 固件上采集，D 命令样例在新固件上采集；两版差异为 T001/T002 改动（CL 门控默认关、D 命令、只读 getter），未在新固件上重跑 P1。
- 新振源板已实机验证 a/b/q 通道选择正常、两路默认 0%；但 s 扫频、T 通断等其余命令在新双路固件上未逐条实跑。
