wmsz88/flex-vib-monitor/vibmon_v5/结果/RT005-20261102.md

# RT005-20261102 — T005 接触退出行为诊断 + 边界端点补测

任务号: T005
执行模型: flash（Codex 执行侧）
执行日期: 2026-11-02
署名: 2026-11-02 · Codex(flash)

## 改动摘要（做了什么）

- 新增诊断/补测脚本 `代码/vibmon_v5/_probe/t005/run_t005.py`；D1 静态分析 `_probe/t005/D1-退出条件源码分析.md`。
- **未改任何固件代码**（T005 要求诊断优先）。
- 数据目录 `代码/vibmon_v5/data/t005_20261102/`：`run.csv`（扫描）、`run.dump.csv`（D2 中间量时序）、`run.dump.txt`（D-contact）、`run.__start.txt`（START 基线）、`run.raw.txt`。
- 本卡实测前期踩坑一次：首次启动模块在复位时不在 START 姿态，`ang` 全程为 `?`、姿态退回 flatDist 判闭合，全部 wait_open 超时；重跑（保持 START 静止）正常。此现象与 T004 备注一致，记入异常项。

## 测试/测量数据（测到什么）

### D1 退出条件（源码，只读）

`combineContact()`（state.cpp:264-275）：
- 进入：`姿态 && ampHeld && freqHeld`（三路全真）
- 保持：`姿态 && (ampHeld || freqHeld)`
- 退出：`!姿态 || (!ampHeld && !freqHeld)`，再过确认延时 `CT_CONFIRM_MS=100ms`

滞回/门限（config.h）：姿态角 60°/45°（角度无效时退回 flatDist 400/280）；幅值 400/300 mg；频率 75/63 Hz；`ampValid/freqValid=false` 时对应保持位显式清零（state.cpp:418-432）；`CT_FLAT_DEGRADE_STRICT=1`。

**T1 时序推演（r1_t1_pull）吻合**：抽走物体后 A 694→59→18mg（幅值门清 0），但残余/窜振 F 仍 115~131Hz 且有效 → 频率门保持 1 → 保持规则成立 → ct 锁在 1；1.70s 处 F 变无效（两路全无）才退出；3.19s 起靠幅值 400 门被瞬态重新锁存再次进入。**锁存主因 = 保持规则允许「频率证据单独续命」（freqHeld 退出下限仅 63Hz）。**

### D2 关源追中间量（run.dump.csv，3 次，每次 50 行 @ ~2.4Hz）

| 段 | 首行 | 首个 ct=0 | 关源后中间量 |
|---|---|---|---|
| d21_off | ct=1 A=907 F=113.7 | **0.43s** | ampMg 5~19mg（condAmp=0），freqValid=0（condFreq=0） |
| d22_off | ct=1 A=907 F=109.7 | **0.42s** | 同上 |
| d23_off | ct=1 A=937 F=116.4 | **0.42s** | 同上 |

→ 关源后 **约 0.42s 即退出**：amp 落 300 以下、且 `freqValid` 立刻变 0，两路证据全无 → 退出。**未复现"幅值塌了 ct 仍锁存"的区间。**

### 补测扫描（4cm 方块夹持；通道 A=GPIO3、B=GPIO4；每档 8s）

| 通道/占空比 | F 中位 | A 中位 | A 最大 | ct=1 |
|---|---|---|---|---|
| GPIO3 55% | 70.9 | 394.9 | 579.5 | 7/8 |
| GPIO3 60% | 77.1 | 402.4 | 536.3 | 8/8 |
| GPIO3 70% | 92.5 | 378.4 | 523.9 | 8/8 |
| GPIO3 80% | 103.5 | 423.2 | 494.0 | 8/8 |
| GPIO3 90% | 111.6 | 555.7 | 616.0 | 8/8 |
| GPIO3 100% | 119.8 | 769.5 | 891.1 | 8/8 |
| GPIO4 55% | 104.4 | 219.5 | 231.5 | 7/8 |
| GPIO4 60% | 114.5 | 289.5 | 497.1 | 8/8 |
| GPIO4 70% | 133.5 | 611.1 | 644.0 | 8/8 |
| GPIO4 80% | 148.7 | 760.5 | 780.2 | 8/8 |
| GPIO4 90% | 160.2 | 925.8 | 1002.7 | 8/8 |
| GPIO4 100% | 165.8 | 962.3 | 985.5 | 8/8 |

（每档唯一落 0 的是 55% 的起转那条；其余 8/8 或后续全 1。）

**通道↔振子 疑似接反**：按频段——GPIO3 实测 71~120Hz，落在「新低速振子 80~128Hz」区间；GPIO4 实测 104~166Hz，落在「原振子 102~182Hz」区间。即脚本标注的 old=GPIO3 / new=GPIO4 可能与实物"原/新"相反（软件可对调 `--old-sel/--new-sel`，无需重接线）。

### 边界端点补测判定

| 项 | 目标 | 实测（按频段落位） | 判定 |
|---|---|---|---|
| E-80 | 新低速最低档 ≈80Hz | GPIO3 60% = 77.1Hz（55% = 70.9Hz，70% = 92.5Hz） | 边缘达标（77Hz∈80±5，ct 8/8） |
| E-180 | 原振子最高档 ≈182Hz | GPIO4 100% = 165.8Hz（已是该路最高） | **未达标（165.8 不在 175~185）** |
| E-mid 90 | 90Hz 档 | GPIO3 70% = 92.5Hz，ct 8/8 | 达标（92.5∈90±5） |
| E-mid 165 | 165Hz 档 | GPIO4 100% = 165.8Hz，ct 8/8 | 达标（165.8∈165±5） |
| P-new | 新振子稳定过 400mg 的最低档 | GPIO3 各档 A 中位 395/402/378（55/60/70%）；Amax 均>500 | 无清晰稳定档（60% 中位 402 勉强过门，55/70% 中位 <400） |

### D-contact + START 基线

- **D-contact（condAmp=1 的 #DUMP 行）3 条**：d21_off/d22_off/d23_off 首行，`condAmp=1 condFreq=1 ct=1 ampMg=907/908/938`。
- 空握样例（dcon_empty）：`closed=1 condPosture=1 condAmp=0 condFreq=0 ct=0`。
- **START 基线已采**：`[POST] START 基线有效：0.0/0.3/-0.1 mg，样本 1500`。

## 数据结论（结论是什么）

1. 退出规则全清单与参数已给出；**接触锁存的主因是「保持规则允许频率证据单独续命」**（频率门退出下限仅 63Hz），T1 时序手工推演与实测逐点吻合。
2. **"三份锁存证据"经实测复核只有 T1 一份成立**：D2 三次关源均 0.42~0.43s 内正常退出（关源会同时使 amp<300 且 freqValid=0），dual 关源段同样 ~0.6s 退出；"dual 关源锁存 4s"与原始数据不符。A4 是退出耗时（~0.42s）问题，非锁存。
3. 两路频带实测：GPIO3 71~120Hz、GPIO4 104~166Hz；据此 E-80 边缘达标（GPIO3 60%=77Hz），**E-180 未达标（原振子最高仅 ~166Hz，够不到 182Hz）**；E-mid 90/165 达标。
4. 新振子提档：低幅值振子各档 A 中位 378~402mg，无清晰"稳定过 400mg"的最低档（60% 勉强 402）。ct 各档基本 8/8。

## 异常与未解决项

- 卡的「证据② dual 关源锁存 4s」与 `run_dual_dump` 原始行不符（实测 0.64~0.65s 即 ct=0）；D2 实测亦为关源 0.42s 退出、无锁存。**锁存现象目前仅有"物体抽走但振源仍开"（T1）一例。**
- 通道↔振子标签疑似接反（GPIO3=低段、GPIO4=高段，与脚本 old/new 标称相反）；本卡按"频段落位"给判定，标签以实物为准。
- E-180 未达标：原振子在当前供电/接线（GPIO4 100%）实测最高 ~166Hz，达不到 182Hz；是否与供电/接线相关未确认。
- 本卡未复现"幅值塌了 ct 仍 1"的中间量区间（D2 因关源即失频率有效而快速退出）；若要观测该区间，需用"抽走物体但振源仍开"的工况（T1 已给一例）。
- 首次启动姿态错误导致整轮作废（并已被重跑覆盖），START 姿态必须在开串口复位时保持。
- 双路固件的 `s` 扫频 / `T` 通断仍未逐条实跑。
