wmsz88/flex-vib-monitor/vibmon_v5/结果/RT006-20261102.md

# RT006-20261102 — T006 E-180 端点振源排查 + 通道标签对调确认

任务号: T006
执行模型: flash（Codex 执行侧）
执行日期: 2026-11-02
署名: 2026-11-02 · Codex(flash)

## 改动摘要（做了什么）

- 新增脚本 `_probe/t006/run_t006.py`（通道确认 + 最高档正式数据；含开机姿态自动恢复）。
- **未改任何固件代码、未改任何阈值**（纯硬件侧）。
- 数据目录：`data/t006_20261102/`（第一轮）、`data/t006_p2c/`（原方块 165Hz 专项）、`data/t006_newblock/`（更换方块材质后）。
- 期间人类实测：振源板输入端 **5V（USB 供电）无跌落**（分支 A 结论）。

## 测试/测量数据（测到什么）

### 通道标签对调确认（4cm 方块，各档 8s）

| 通道 | 占空比 | F 中位 | A 中位 | ct |
|---|---|---|---|---|
| GPIO3 | 55% | 73.4 | 139.7 | 7/8 |
| GPIO3 | 100% | 115.4 | 454.5 | 8/8 |
| GPIO4 | 55% | 104.7 | 168.0 | 0/8 |
| GPIO4 | 100% | 174.9 | 684.9 | 7/8 |

（三个独立轮次 t005 / t006_20261102 / t006_newblock 的"通道→F"关系一致：GPIO3 低频段、GPIO4 高频段。）

**结论**：F 由物理通道决定，**不是接线接反**——是两台振子实际频段与脚本 old/new 标签的对应关系反了。**修正档案：GPIO3 = 新低速振子（≈73~120Hz）、GPIO4 = 原振子（≈101~175Hz）**；软件把默认选择对调（`--old-sel b --new-sel a`）即可，无需重接线。

### E-180 三路排查

| 分支 | 结果 |
|---|---|
| A 供电 | 振源板输入 5V（USB 供电）无跌落 —— 供电不是瓶颈 |
| B 提压/换档 | 未做（5V 已足） |
| C 接受上限 | 见下 |

**原振子(GPIO4) 100% 满档上限实测**：
- 旧方块：T005 = 165.8Hz；T006 专项 10s = 162.4Hz（158.8~163.6）
- **更换方块材质后**：抽样 8s 中位 **175.1Hz**（174.6~175.7，A≈666~698mg）；专项 10s 中位 **171.6Hz**（167.2~172.9，A≈556~635mg）
- 判定：换材质后满档由 ~166 提到 ~172~175Hz，**处于 180±5(175~185) 的临界**——专项 10s 中位 171.6 未达，抽样段多条 175.1~175.7 恰在下沿；**是否算达标取决于取哪一段，且对夹持/材质敏感**。

### 165Hz 档正式数据（GPIO4 100%，10s，逐条）

旧方块（`t006_p2c`）：F 从 131.6(起转)→158.8~163.6，中位 **162.4Hz**；A 822~1169；**ct 9/10=1**。

新方块（`t006_newblock` p2c）：F 从 167.2~172.9，中位 **171.6Hz**；A 556~635；**ct 9/10=1**（首条起转 0）。

### START 基线

- t006_20261102：`[POST] START 基线有效：-19.5/14.3/-6.4 mg，样本 1501`
- 注：本轮多次出现"开机不在 START 姿态"（`closed=1`/`ang≈85°`）导致首次 `wait_open` 超时，已由脚本"自动重采 START 基线"恢复；t006_newblock 轮次首段即触发该恢复。

## 数据结论（结论是什么）

1. **通道↔标签**：F 跟随物理通道而非标签——GPIO3=低段（新低速振子）、GPIO4=高段（原振子）；**非接线接反**，软件对调默认选择即可。
2. **供电**：输入端 5V 无跌落，排除供电不足。
3. **E-180**：原振子满档上限旧方块 ~162~166Hz、新方块 ~172~175.7Hz。**新方块提升了约 10Hz，但稳定超过 175Hz 不稳定**；专项 10s 中位 171.6Hz。180Hz 端点仍属"本地难以稳定复现"。
4. **165Hz 档正式数据两套均达标**（ct 9/10），测频能力有 >=162~172Hz 实读背书。

## 异常与未解决项

- 原振子满档在旧/新方块间差约 10Hz（166 vs 175），对夹持/材质敏感；同一新方块轮次内抽样段(175.1)与专项段(171.6)也差 ~3.5Hz。E-180 达标与否取决于取段与夹持，未稳定。
- 180Hz 端点本地仍无稳定激励源；是否与马达个体/供电曲线相关未进一步排查。
- 多次"开机不在 START 姿态"导致首轮作废，需在复位+标定期保持张开静止（脚本已加自动重采恢复）。
- 双路固件 `s`/`T` 命令仍未逐条实跑。
