wmsz88/flex-vib-monitor/vibmon_v5/结果/RT007-20261103.md

# RT007-20261103 — T007 答辩材料整理

任务号: T007
执行模型: flash（Codex 执行侧）
执行日期: 2026-11-03（数据日期 2026-11-02）
署名: 2026-11-03 · Codex(flash)

## 改动摘要（做了什么）

| 产出 | 内容 |
|---|---|
| `答辩/答辩材料主文档.md` | 四块：独有增量 / 量化证据（带来源表）/ 设计定性 / 风险预案；附比赛帧与命令速查 |
| `答辩/答辩问答预案.md` | 12 条问答（一句话回答 + 依据来源） |
| 只读引用 | 结果/RT001~RT006、data/ 各目录、vib_range_test/data/、大模型/评审报告_20261102.md、陀螺仪改造方案.md |

未改动任何固件代码、规划/、阈值。

## 测试/测量数据（做了什么核对）

按要求"引用前回读原始文件核对"，抽查了 10 个数字：

| # | 数字 | 原始来源 | 核对结果 |
|---|---|---|---|
| 1 | 宿主 contact **46/46** | 结果/RT001、RT002 | 一致 |
| 2 | gyro **8/8**、comp_frame **22/22**（默认）/ **25/25**（CL=1）、dump **19/19** | 结果/RT001、RT002 | 一致 |
| 3 | A3 接触 **9/10**、A4 退出 **0.42~0.43s** | data/t004_20261102/run_p1/run.csv | 一致 |
| 4 | A5 **5/5 通关** | data/t004_20261102/run_p1 | 一致 |
| 5 | 稳态上限 **175.7Hz**（新方块 8s、A≈690mg、ct 7/8） | data/t006_newblock/run.csv（p1_new_100） | 一致（174.6~175.7） |
| 6 | 瞬态 **201.4Hz** | vib_range_test/data/startstop_live_20261102_fixed.csv | 一致（3 行 @12:51:07.854，A 35.1/53.0/58.7mg，vib=1 ct=0） |
| 7 | 启停 **0.50/1.00/2.00/2.94Hz** | vib_range_test/data/startstop_live_20261102_final2.csv、_fixed.csv | 一致（观测 0.50~0.53 / 1.00~1.01 / 1.99~2.02 / 2.92~3.00） |
| 8 | 默认帧 **35 字节**、CL=1 **37 字节** | 结果/RT001 | 一致 |
| 9 | D 命令 condAmp=1 样例 | data/t005_20261102/run.dump.csv | 一致（3 条，A≈907~938mg） |
| 10 | 双振子频段 a/GPIO3 **71~120Hz**、b/GPIO4 **101~175.7Hz** | data/t005_20261102、t006_20261102、t006_newblock | 一致 |

### 对 T006 复核所提一处勘误的确认

- RT006 曾把 START 基线写成 `-19.5/14.3/-6.4 mg`（标 t006_20261102）；复核后确认该值实为 **t006_p2c** 轮，**t006_20261102 实为 -40.3/9.8/-12.9**，t006_newblock 轮 `P` 被拒、START 基线未建立（角度有效来自 `t` 重采）。本卡答辩文档引用时长：不改用该数值，仅记"START 基线采集正常（见 data/…）"，避免误引。

## 数据结论（结论是什么）

1. 答辩主文档四块齐全、逐论点标注来源；问答预案 12 条（≥10），覆盖"为何不做无振动接触 / 锁存是否 bug / 180Hz / 精度 / 与他队差异 / 帧对接 / 启停原理 / MPU6050 够用性 / 角度算法 / 现场处置"等方向。
2. 抽查 10 个数字与原始数据一致；顺手确认了 T006 复核指出的 START 基线张冠李戴一处（本卡引用已规避）。
3. 两项定性（锁存赛前不改、E-180 接受本地上限 175.7Hz + 瞬态 201.4Hz 背书）已按其结论写入答辩材料。

## 异常与未解决项

- 两个仍开放的现场项（非本卡范围）：①`$VD` 35 字节帧实板抓帧（需 USB-TTL 接比赛口 GPIO21，本机未接）；②平台对接（C4，到场进行）。
- 启停四档与"下扫 55%≈82Hz"等为 vib_range_test 历史数据引用，未在本次重新采集；已在文档中标注为历史来源。
- 答辩文档中"测频精度 ±5Hz"为逐档观测的概括说法（T005/RT006 频段表），未做严格误差统计。
