wmsz88/flex-vib-monitor/vibmon_v5/结果/RT008-20261103.md

# RT008-20261103 — T008 串口模拟赛场验证

任务号: T008
执行模型: flash（Codex 执行侧）
执行日期: 2026-11-03
署名: 2026-11-03 · Codex(flash)

## 改动摘要（做了什么）

- **零固件代码改动**；仅烧录切换构建：P2 用 `-DCOMP_FRAME_CL=1` 编译烧录，核毕**烧回默认构建（CL=0）**。
- 新增脚本：`_probe/t008/platform_sim.py`（收帧/逐帧校验/统计）、`_probe/t008/scene_sim.py`（P3 场景模拟）。
- 数据目录：`data/t008_20261103/`（`p0_link_12v`、`p1_default`、`p2_cl`、`p2_back_default`、`p3_scene3`）。
- 编译参数（读 `config.h`，非记忆）：比赛口 **TX=GPIO21 / RX=GPIO20**、`COMP_BAUD=115200`、`COMP_PERIOD_MS=20`（50Hz）。

## 测试/测量数据（测到什么）

### P0 链路（COM4 USB-TTL → GPIO21）

| 项目 | 值 |
|---|---|
| 帧数 / 校验 | 510 / 510 OK（0 错） |
| 帧长 / 域数 | 恒 35 字节（含 CRLF） / 9 域 |
| 帧率 | ≈51.5 Hz |
| 首帧样例 | `$VD,3365,00000,00005,0,0,000,9,15` |

### P1 默认构建 35 字节（60s，静止）

| 项目 | 值 |
|---|---|
| 帧数 / 校验 | **3008 / 3008 OK（校验错 0）** |
| 帧长分布 | 恒 **35** |
| 域数 | 恒 9 |
| 帧率 | ≈50.2 Hz |
| 字段 | FREQ=0、AMP 个位~十位 mg、VIB=0、CT=0、SS=0、VALID=9（ampValid+contactValid） |

### P2 CL=1 构建 37 字节（30s）

| 项目 | 值 |
|---|---|
| 帧数 / 校验 | **1512 / 1512 OK** |
| 帧长分布 | 恒 **37** |
| 域数 | 恒 **10**（`...,CT,CL,SSx100,VALID,CHK`） |
| 样例 | `$VD,1888,00000,00006,0,0,0,000,9,00` → CL 域在 CT 后，本次实际姿态 CL=0 |
| 烧回默认 | 371442 B（默认构建），复测 303 帧全 35 字节、校验 0 错 |

### P3 平台场景（p3_scene3，默认构建，模块 12V + 共地）

| 场景 | 帧数 | VIB=1 | CT=1 | F 中位 | A 中位 | 备注 |
|---|---|---|---|---|---|---|
| s1 接触（4cm+原振子 GPIO4 100%） | 1512 | 1507/1512（99.7%） | **1489/1512（98.5%）** | 159.7 Hz | 631 mg | 帧率≈50.4Hz |
| s2 关源（继续夹住） | 510 | 18/510 | 15/510 | — | 6 mg | **首个 CT=0 在第 16 帧 ≈0.30s** |
| s3 启停 1Hz（原振子 `T1`） | 1512 | 1052/1512 | 832/1512 | 81.7 Hz（振动段） | 208 mg | **SS 读数 {1.00, 1.02}** |

## 数据结论（结论是什么）

1. **默认构建实板帧**：35 字节、9 域、`\r\n` 结尾、XOR 校验 3008/3008 全对、帧率 50.2Hz —— T001 遗留的 P4（实板逐帧核对）**闭环**。
2. **CL=1 构建**：37 字节、10 域、CL 插在 CT 之后、校验 1512/1512 全对；核毕已**烧回默认构建**（现场带默认固件）。
3. **平台场景语义正确**：接触时 VIB/CT=1（CT 98.5%）；关源后 CT 约 **0.30s** 退出；1Hz 通断时 **SS≈1.00Hz** 且 VIB 交替 —— 与 A4/历史值一致。
4. 本卡**零代码改动**，仅烧录切换构建。

## 异常与未解决项

- **共地问题（已定位并解决）**：USB-TTL 未与模块/12V 共地时，COM4 收到 0 字节；把 TTL GND ↔ 模块 GND（=12V 负极）接上后立即恢复 50Hz 收帧。比赛现场 4pin 自带 GND（③），共地天然成立。
- **P3 原始帧样本形式**：P1/P2 留有逐行原文 `.frames.txt`；P3 存的是解析后的 `scene.csv`（含全部帧字段），未逐行保存原文。
- **CL=1 轮 CL 全为 0**：测试时模块处于张开姿态，未取到 CL=1 的样本（按卡要求"按实际姿态记录"）。
- 某一次运行曾观测到振动负载下掉帧到约 30Hz；最终干净轮（p3_scene3）各段均为 50Hz，未复现。
- 平台对接（C4）仍需到场进行。
