wmsz88/flex-vib-monitor/vibmon_v5/结果/RT009-20261103.md

> ⚠️ **本文件已作废**（2026-11-04）：T009 方案第四次变更（弃 C8T6/OLED，改回 ESP32 + 4 按键 + 串口）。现行交付见 `RT009-20261104.md`，保留本文件仅作留痕。

# RT009-20261103 — T009 C8T6 振动源驱动器（阶段 1：代码完成 + Keil 编译通过）

任务号: T009
执行模型: flash（Codex 执行侧）
执行日期: 2026-11-03 ~ 11-04
署名: 2026-11-04 · Codex(flash)

> 本卡分工（任务卡）：**flash 写代码并协助交结果；人类做实板测试；规划模型出规格与验收。**
> 本份 = 阶段 1 交付（可烧录工程 + 编译 0 错 0 警）；阶段 2 = 人类实板测试后补数据。

## 改动摘要（做了什么）

工程位置：`C:\Users\Lenovo\Desktop\STM32project\vibsource_c8t6\`（从 vibsource 单路版复制改造，Keil uVision 工程，STM32F103C8T6 标准外设库）。

| 文件 | 改动 |
|---|---|
| `User\config.h` | **全部重写**：双路 PWM 引脚（PA6=新/PA7=旧）、四按键（PB0/PB1/PB10/PB11）、OLED 引脚（PB6=SCL/PB7=SDA）、PC13 LED、各振子默认占空比（新 70 / 旧 100，可改）、踢一脚参数、四档周期表（0.5/1/2/3Hz）、长按阈值 1s、OLED 刷新间隔 60ms |
| `Hardware\PWM.c/.h` | **重写**：TIM3 双通道（CH1=PA6、CH2=PA7），PSC=36-1/ARR=100-1 → 载波 20kHz，`PWM_SetCompareA/B(duty)` 0~100 直接对应百分比 |
| `Hardware\Key.c/.h` | **重写**：PB0/PB1/PB10/PB11 上拉输入；短按边沿触发；KEY1 原始电平轮询接口 `Key1_Down()` 供 main 做长按判定（长按/短按互斥在 main 实现） |
| `Hardware\OLED.c` | 仅改引脚宏：SCL=PB6、SDA=PB7（驱动逻辑未动，软件 I2C 开漏） |
| `User\main.c` | **全部重写**：三态选源（NEW/OLD/OFF 循环）、KEY1 长按切手动/自动、KEY2 跳默认/自动切周期档、KEY3/KEY4 ±5% 夹取、SysTick 1ms 时基、自动启停状态机（ON 固定 85%、每拍开启补 80ms 短踢）、0→非0 踢一脚 200ms、OLED 限频刷新（不在踢一脚窗口内刷屏）、LED 运行亮/空闲 1Hz 闪 |
| `User\stm32f10x_it.c` | 清掉模板里的空 `SysTick_Handler`（避免与 main.c 的重复定义） |
| `Project.uvprojx` | 移除 Motor.c/Motor.h（新工程不再用该抽象）；其余 Start/Library 组未动 |

## 测试/测量数据（阶段 1：编译）

| 项 | 值 |
|---|---|
| 工具链 | Keil uVision（UV4 -b 命令行），ARMCC V5.06 u5 |
| 编译结果 | **0 Error(s), 0 Warning(s)** |
| 产物 | `Objects\Project.hex`（19,356 B，2026-11-04 00:20） |
| Program Size | Code=4976 RO=1836 RW=52 ZI=1636 |

## 数据结论（结论是什么）

1. T009 要求的固件行为已全部落到代码：KEY1 三态循环选源（短按）/手动↔自动（长按≥1s）、KEY2 跳默认（手动）/切 0.5/1/2/3Hz 档（自动）、KEY3/KEY4 ±5% 夹取、自动 ON 固定 85% + 每拍 80ms 短踢、0→非0 踢一脚 200ms、20kHz 载波、OLED 全状态显示（≤200ms 响应 + 60ms 限频兜底刷新）、LED 语义对齐原固件。
2. Keil 编译 0 错 0 警，hex 已生成，等待人类烧录（ST-Link / 串口 ISP 任一）。
3. vibmon_v5 侧零改动（本卡只动 Desktop\STM32project\vibsource_c8t6\）。

## 异常与未解决项

- 工具链备注：原计划 Arduino STM32duino（T009 卡建议）因 arduino-cli 下载 308MB xpack-gcc 连续两次网络中断而放弃，改用本机已有 Keil uVision + 标准外设库（与旧 vibsource 单路版同栈，代码风格一致）。烧录方式按人类手头工具（ST-Link 或串口 ISP）执行。
- 待人类实板确认/登记：①四按键与 OLED 实际接线是否按本表；②新/旧振子默认占空比（当前占位：新 70%、旧 100%，现场可调后可改 config.h 两宏重编）；③振子供电电压（5V 或 12V，由人类定并记入完成记录）。
- 阶段 2（人类实测）待回传：KEY1 三态循环 ×4、长按切模式、KEY2 跳默认、±5% 步进与夹取、四档周期 SS 实测（需 vibmon $VD 佐证，对齐 T008 先例）、OLED 响应 ≤200ms 主观验证。
