wmsz88/flex-vib-monitor/vibmon_v5/结果/RT009-20261104.md

# RT009-20261104 — T009 ESP32 振动源驱动器（4 按键 + 串口状态）

任务号: T009
执行模型: flash（Codex 执行侧）
执行日期: 2026-11-04（方案第四改：弃 C8T6/OLED，改回 ESP32 + 4 按键 + 串口）
署名: 2026-11-04 · Codex(flash)

> 分工：flash 写代码并协助交结果；人类实板测试；规划模型出规格与验收。
> 本份 = 阶段 1（可烧录工程 + 编译 0 错 0 警）；阶段 2 待人类实测回传。

## 改动摘要（做了什么）

新工程：`C:\Users\Lenovo\Desktop\STM32project\vibsource_c3_key\`（自 `vibsource_esp32_dual` 整目录拷贝后增量改；**原 dual 工程与 vibmon_v5 均未改动**）。

| 文件 | 改动 |
|---|---|
| `config.h` | 重写：通道标签按实况（A=GPIO3 新低速 / B=GPIO4 原振子）；新增 4 按键引脚（KEY1=GPIO7、KEY2=GPIO10、KEY3=GPIO0、KEY4=GPIO1）+ 消抖 15ms + 长按 1000ms；新增各振子默认占空比 `DUTY_DEFAULT_A=70 / DUTY_DEFAULT_B=100`（占位待实测）；保留踢一脚/四档周期表/20kHz/LED 等全部参数 |
| `vibsource_c3_key.ino` | 在原双路固件上增量：新增按键扫描（非阻塞消抖 + 长按/短按互斥）、三态选源（A→B→OFF，切源即停另一路）、手动/自动模式机（自动 ON 固定 85% + 每拍 80ms 短踢）、`printStatus` 增加 `[SRC]`/`[MODE]` 行；串口命令 a/b/0-9/h/p/+/-/T0-3/T/s/x/z/q/? 全部保留并与按键共用同一状态机 |

## 测试/测量数据（阶段 1：编译）

| 项 | 值 |
|---|---|
| 工具链 | arduino-cli 1.5.1 + esp32 core 3.3.12，`--fqbn esp32:esp32:esp32c3:CDCOnBoot=cdc --warnings all` |
| 编译结果 | **0 warning**，退出码 0 |
| Program Size | flash 309366 B (23%)；静态 RAM 14708 B (4%) |

### 引脚分配表

| 功能 | 引脚 | 说明 |
|---|---|---|
| PWM A → 新振子 | GPIO3 | TIM LEDC，20kHz/10bit（沿用现接线） |
| PWM B → 旧振子 | GPIO4 | 同上 |
| KEY1 | GPIO7 | INPUT_PULLUP，按下 LOW；短按选源循环，长按≥1s 切手动/自动 |
| KEY2 | GPIO10 | INPUT_PULLUP；手动=跳默认，自动=切周期档 |
| KEY3 / KEY4 | GPIO0 / GPIO1 | INPUT_PULLUP；占空比 +5% / -5% |
| 板载 LED | GPIO8 | 低电平点亮（运行/心跳语义沿用） |

### 串口状态输出（代码定义格式）

```
[CH A] GPIO3  70%  (out  70%)  <- 当前
[CH B] GPIO4 100%  (out   0%)
[SRC ] A(新 GPIO3) | B(旧 GPIO4) | OFF
[MODE] 手动            （或： [MODE] 自动 1.0Hz）
```
按键与串口命令走同一状态机，按 `q` 查询与按键后的状态一致。

## 阶段 2：COM3 直读（2026-11-04 22:00–22:02）

浏览器先断开串口，随后用 pyserial 直接打开 `COM3`（CH340，`1A86:7523`，115200 8N1）采集。

第一次静默 30 s 及发送 `q\n` 后 8 s 均为 0 字节；接收线恢复后，于 22:01:49 重新采集 30 s，成功收到 40927 字节：

| 项 | 结果 |
|---|---|
| 有效 `$VD` 帧 | **1141 帧**，`SEQ=0000~1140` |
| XOR 校验 | **1141/1141 通过，0 错** |
| 帧率 / 时长 | 50 Hz，约 22.8 s（首次有效帧前有启动等待） |
| 幅值 | 最小 0 mg，最大 **995 mg** |
| 振动状态 `VIB` | `1`：354 帧（31.0%），`0`：787 帧 |
| 接触状态 `CT` | **1141 帧全为 0** |
| 启停频率 `SS` | **1141 帧全为 000（0.00 Hz）** |
| `VALID` | `9`：827 帧，`B`：271 帧，`1`：38 帧，其余 5 帧 |

启动段记录到 1 次 `BROWNOUT_RST`，随后有 3 次 `POWERON` 重启；之后进入稳定 50 Hz 输出，未再复位。本次为未夹持条件下的自由振动采集，出现 12 个活动段，峰值主要集中在约 995 mg、954 mg、621 mg、435 mg。`CT=0`、`SS=000` 说明本轮不能用于接触判定或自动四档 SS 验收。

原始文件保存在 `代码/vibmon_v5/data/t009_20261104/`：

- `com3_capture_20261104-220149.bin`：原始 40927 字节
- `com3_capture_20261104-220149.txt`：解码文本
- `com3_capture_20261104-220149.timed.txt`：带接收时间戳文本
- `com3_capture_20261104-220149.json`：采集元数据
- `com3_capture_20261104-220149.episodes.csv`：12 个活动段汇总
- `com3_capture_20261104-220149.summary.json`：统计与活动段结构化数据

## 阶段 3：测试1.txt 完整遥测解读（2026-11-04）

输入文件：`C:\Users\Lenovo\Downloads\测试1.txt`，约 151.6 s、`SEQ=0000~7581`。

| 项 | 结果 |
|---|---|
| 有效帧 | **7430 帧**，接收率 98%；`SEQ` 0583→0736 之间丢 152 帧（约 3.04 s） |
| 校验 | **7430/7430 XOR 通过，0 错** |
| 启动 | 2 次正常 `POWERON`，无 `BROWNOUT_RST` |
| `VIB` | `1`：4883 帧；`0`：2547 帧 |
| `CT` | `1`：2523 帧（34.0%）；`0`：4907 帧 |
| 幅值 | 最大 **1206 mg**（`SEQ=1101`，约 22.0 s，此时 `CT=0`） |
| `SS` | 仅 `SEQ=1067~1098` 共 32 帧出现 `0.68 Hz`，其余全为 000 |

`CT=1` 共形成 4 个主要接触段：

| 段 | 时间段 | 持续 | 主要频率 | 段内幅值峰值 |
|---|---:|---:|---:|---:|
| 1 | 61.98–64.32 s | 2.34 s | 约 67–68 Hz | 419 mg |
| 2 | 70.20–89.12 s | 18.92 s | 约 100 Hz，后升至 106–107 Hz | 746 mg |
| 3 | 92.04–108.98 s | 16.94 s | 前段 138–143 Hz，后段稳定约 77 Hz | 483 mg |
| 4 | 126.82–139.00 s | 12.18 s | 前段 135–138 Hz，后段 157–161 Hz | 608 mg |

结论：接触检测和主频跟踪均正常工作，4 个接触段中频率平台稳定；但 `SS` 只在自由振动阶段短暂出现 0.68 Hz，未在任何接触段稳定建立，因此本文件仍不能作为自动四档 `SS` 的正式验收数据。丢失的 3.04 s 需要标注为盲区。

## 阶段 4：测试2 自动 1 Hz 接触语义问题（2026-11-04）

输入文件：`C:\Users\Lenovo\Downloads\测试2.txt`（`SEQ=0000~4834`，4835 帧，96.68 s，0 丢帧、0 校验错）。

关键现象：

- `SEQ=0218~0224`：快速空握出现约 191.3~195.0 Hz、9~26 mg 的弱瞬态，`VIB=1` 但 `CT=0`。这是低幅机械瞬态，不是接触。
- `SEQ=0280~0297`：主频估计在 97.2→106.0→109.5→106.7→109.0 Hz 间变化。主频是 128 ms 窗、每 64 ms 更新的测量值，不是 PWM 设定值；约 ±3.5 Hz 波动属于正常测频/负载变化。
- `SEQ=4030~4834`：自动 1 Hz 段 `SS=1.00`，但 `CT` 随每次起停脉冲变为 1/0，并未保持连续。

1 Hz 段中 `SEQ=4131~4162` 的证据链：

| 帧 | 幅值 | 主频 | VIB | CT | 说明 |
|---|---:|---:|---:|---:|---|
| 4131 | 266 mg | 84.0 Hz | 1 | 0 | 幅值未达接触进入门限 400 mg |
| 4141 | 417 mg | 122.3 Hz | 1 | 0 | 刚超过 400 mg，等待 100 ms 确认 |
| 4146 | 533 mg | 128.6 Hz | 1 | 1 | 接触确认成立 |
| 4150 | 206 mg | 129.8 Hz | 1 | 1 | 幅值跌破退出线，但主频仍有效，接触保持 |
| 4156 | 8 mg | 0 Hz | 0 | 1 | 幅值/主频均掉，接触开始退出计时 |
| 4162 | 7 mg | 0 Hz | 0 | 0 | 100 ms 后接触退出 |

结论：当前 `CT` 语义是“姿态闭合 + 振动幅值/主频证据”，不是“机械上一直夹住”。因此自动启停的 OFF 段会使 `CT=0`。若赛项要求“夹持期间即使振动间歇也持续给 CT=1”，现版本不满足，需要增加基于 `closed` 姿态门的接触保持/超时逻辑（超时必须大于最长 OFF 段，例如 0.5 Hz 档 >1 s）。

## 数据结论（结论是什么）

1. T009 新版固件已可烧：4 按键功能（三态选源 / 长按切模式 / 跳默认 / 切周期档 / ±5%）+ 现有串口命令行 + 状态打印全部就位，编译 0 警。
2. 方案沿革：C8T6+OLED → C8T6 → ESP32+OLED → **ESP32+4 按键+串口**（本次），改动量最小（现成固件 + 4 键映射）。
3. 未动原 dual 工程与 vibmon_v5 侧。

## 异常与未解决项

- **本阶段未实机验证**：需人类烧录后按键 + 串口实测。
- 待登记：新振子默认占空比（占位 70%）、旧振子默认占空比（占位 100%）——以「vibmon 稳定检出 ct=1」为准，确定后改 `config.h` 两宏重烧。
- 待实测回传：KEY1 三态循环 ×4、长按切模式、KEY2 跳默认/切档、±5% 步进与 0/100 夹取、自动四档 SS（用 vibmon `$VD` 帧佐证，对齐 T008：1Hz 档 SS≈1.00，四档各 ≥20s）。
- 前一份 `RT009-20261103.md`（C8T6 + Keil + OLED 方案）**已作废**，按新方案重做，见本文件。
