wmsz88/flex-vib-monitor/vibmon_v5/结果/RT009-20261105.md

# RT009-20261105 — T009 双重踢修复 + 启停 CT 保持门控

任务号: T009
执行模型: flash（Codex 执行侧）
执行日期: 2026-11-05
署名: 2026-11-05 · Codex(flash)

> 本份覆盖任务 A 的双重踢修复与补充任务 B 的 `CT_HOLD_ENABLE` 门控实现。实板数据尚未采集。

## 改动摘要（做了什么）

### 任务 A：振动源双重踢修复

- `C:\Users\Lenovo\Desktop\STM32project\vibsource_c3_key\vibsource_c3_key.ino`
  - `autoTick()` 的 OFF→ON 分支改为先执行 `CYCLE_KICK_MS=80ms` 小踢，再直接 `pwmWrite(CYCLE_ON_DUTY)` 并同步 `g_out`，不再经 `setOut()` 触发第二次 `KICK_MS=200ms` 启动踢。
  - 串口 `T0~T3` 命令不再先 `setMode(MODE_AUTO)` 调一次 `autoStart()` 后再调第二次，避免双启动。

### 任务 B：启停 CT 保持门控

- `config.h`
  - 新增 `CT_HOLD_ENABLE`，默认 `0`；新增 `CT_HOLD_MS=1200`。
  - 新增编译期检查：`CT_HOLD_ENABLE` 只能为 0/1；开宏时 `CT_HOLD_MS > CT_CONFIRM_MS`。
- `state.cpp`
  - 维护最近一次 `(ampEff || freqEff)` 振动证据时间戳。
  - 仅在 `CT_HOLD_ENABLE=1` 且姿态仍成立时，用 `CT_HOLD_MS` 延长 contact 保持。
  - 接触进入条件保持原样（姿态 + 幅值 + 频率三路同时成立）；姿态打开立即清除 hold。
  - 状态复位、平放基准清空、标定应用、姿态输入失效时同步清除 hold 状态。
  - 开宏时提供 `stateContactHoldOk()` / `stateContactMsSinceEvidence()` 给 D 命令使用。
- `output.cpp`
  - 仅 `#if CT_HOLD_ENABLE` 时，D 命令 DUMP 表头和数据行追加 `holdOk,msSinceEvidence`；默认构建不变。
- `test/contact_test.cpp`
  - 增加宏开用例 H1（到期退出）、H2（证据刷新顺延）、H3（姿态打开后 ≤0.2s 退出），并兼容宏开时 C10/C11 的保持语义。
- `_probe/t009b/dump_hold_probe.cpp`
  - 新增 D 命令开宏列数/字段探针。

## 测试/测量数据（测到什么）

### 任务 A 编译

| 配置 | FQBN | Warning | Flash | RAM |
|---|---|---|---:|---:|
| UART | `esp32:esp32:esp32c3` | 0 | 313848 B (23%) | 14532 B (4%) |
| CDC | `esp32:esp32:esp32c3:CDCOnBoot=cdc` | 0 | 309384 B (23%) | 14708 B (4%) |

构建产物已更新到 `_probe\t009\build_uart\` 和 `_probe\t009\build\`。

| 配置 | `.bin` SHA-256 |
|---|---|
| UART | `d49b1737269f445138ffc0a15bb8d871a42651cb0ed25da2441600a167e6540d` |
| CDC | `ed8cae92bcf86bd62fd3dd6fcffd3df6f04868658c3f6b8e1e20b34bfe50e9b3` |

### 任务 B 宿主测试

| 测试 | 配置 | 结果 |
|---|---|---:|
| contact_test | 默认 `CT_HOLD_ENABLE=0` | 46/46 |
| contact_test | `-DCT_HOLD_ENABLE=1` | 56/56（含 H1/H2/H3） |
| dump_test | 默认 | 19 pass / 0 fail |
| gyro_test | 默认 | 8/8 |
| comp_frame_test | 默认 | 22 pass / 0 fail |
| dump_hold_probe | `-DCT_HOLD_ENABLE=1` | 5/5，表头/数据均为 25 个逗号 |

### 任务 B 固件编译

| 配置 | FQBN | 宏 | Warning | Flash | RAM | `.bin` SHA-256 |
|---|---|---|---:|---:|---:|---|
| 默认 UART | `esp32:esp32:esp32c3` | 0 | 0 | 366342 B (27%) | 30092 B (9%) | `76ff9910fb4ae7119e761d407710a373b46f1beba90dc721318a8923e94280d4` |
| 默认 CDC | `esp32:esp32:esp32c3:CDCOnBoot=cdc` | 0 | 0 | 371442 B (28%) | 30268 B (9%) | `7024a406ec4c9a0258fc69ff547bfded211e71c3685d267ff455c42da27067f1` |
| Hold UART | `esp32:esp32:esp32c3` | 1 | 0 | 366654 B (27%) | 30100 B (9%) | `ef87b296d578a123860c468ee420d3083f145ea73ebaeed238cbb1ace6d7d419` |
| Hold CDC | `esp32:esp32:esp32c3:CDCOnBoot=cdc` | 1 | 0 | 371768 B (28%) | 30284 B (9%) | `602f97f65a914c55c7c6e3ea87f83fc8000e4d27ad9001a4ee002e16e48ae0b1` |

Hold 构建产物位于 `_probe\t009b\build_hold_uart\` 与 `_probe\t009b\build_hold_cdc\`。宏 1 用 `compiler.cpp.extra_flags=-DCT_HOLD_ENABLE=1` 注入，保留 FQBN 的 CDC 宏。

### 默认构建哈希差异审查

默认构建在改动前后 Flash/RAM 完全相同，但 `.bin` SHA-256 不同。逐字节差异范围：

- UART：`176~207`（32 字节 ELF SHA）、`9991~9992`、`9994~9995`（编译时间 `00:15:54`→`00:27:13`）、末尾 `366463~366495`（镜像摘要）。
- CDC：`176~207`（32 字节 ELF SHA）、`9923~9924`、`9926~9927`（编译时间）、末尾 `371551~371583`（镜像摘要）。
- 将上述元数据区段清零后，UART 与 CDC 的改动前/后镜像均逐字节相等。

### 数据文件

目录：`data\t009b_20261105\`

- `contact_base.log` / `contact_after_default.log` / `contact_after_hold.log`
- `dump_base.log` / `dump_after_default.log` / `dump_hold_probe.log`
- `gyro_base.log` / `gyro_after_default.log`
- `comp_frame_base.log` / `comp_frame_after_default.log`
- `build_base_uart.log` / `build_base_cdc.log`
- `build_after_default_uart.log` / `build_after_default_cdc.log`
- `build_hold_uart_cpp.log` / `build_hold_cdc_cpp.log`
- `t009_afix_build_uart.log` / `t009_afix_build_cdc.log`
- `summary.json`、`default_baseline.sha256`、`default_after.sha256`、`hold.sha256`、`t009_afix.sha256`、`default_hash_diff_review.txt`
- `suite_summary.json`：单测 1~6 汇总
- `t009_rawlog_analysis.txt` / `t009_suite_analysis.txt` / `t009_trials_detail.txt`：原始日志、分档与接触段分析输出

### 实板完整测试文件（人类 2026-11-05 提供）

文件：`C:\Users\Lenovo\Downloads\serial_session_20261105_100245.txt`（491951 B，14102 行显示记录）。

| 项 | 结果 |
|---|---|
| 可解析 `$VD` 帧 | **7399 帧**，本次解析 XOR 错 0 |
| 时间范围 | 09:57:56.198–10:01:35.861（约 219.7 s，含一次重启空档） |
| 重启 | 2 次 ROM 启动：1 次 `POWERON`、1 次 `RTC_SW_SYS_RST`；`SEQ 0942→0000` 重新开始；无 `BROWNOUT_RST` |
| `SS` 分布 | `0.00`：6204 帧；`0.50`：1098 帧；`1.81`：12 帧；`1.82`：54 帧；`2.06`：31 帧 |
| `CT` / `VIB` | CT=1 共 1111 帧；VIB=1 共 3155 帧 |
| 最大幅值 | 1223 mg |

有效启停段：

| 段 | 帧段 | 持续 | SS 读数 | CT=1 比例 | 备注 |
|---|---|---:|---:|---:|---|
| 2Hz 试段 | 1380–1391 | 0.22 s | `181`（1.81Hz） | 0/12 | 短段，未到 20 s |
| 2/3Hz 试段 | 1578–1662 | 1.68 s | `206/182`（2.06/1.82Hz） | 26/85 | 短段，频率未稳定到 2.00/3.00 |
| 0.5Hz 正式段 | 5487–6584 | 21.94 s | **`050`（0.50Hz），1098 帧全部一致** | **497/1098 = 45.3%** | CT 仍随 ON/OFF 每拍闪断 |

0.5 Hz 段 10 次 `VIB 1→0` 后，CT 落 0 的延迟为 2~6 帧：

```text
100, 100, 100, 100, 120, 120, 40, 80, 80, 100 ms
```

其中 40 ms 的短延迟对应 VIB 下降沿与 CT 确认链的时间对齐，其余均在 `CT_CONFIRM_MS=100 ms` 量级。该行为是默认构建，不是 `CT_HOLD_ENABLE=1` 的 `CT_HOLD_MS=1200 ms` 保持构建。

### 单测 1：`T009\单测\1.txt`

文件 339689 B、9841 行显示记录；文件内包含前序记录、重复段和最后一次上电重启。统计取最后一次重启后的完整运行：

| 项 | 结果 |
|---|---|
| 最后运行 | `SEQ=0000~3671`，3672 帧，73.44 s |
| 校验 | 0 错 |
| `SS` | 3672 帧全为 0.00 Hz（本文件不是启停测试） |
| `VIB` | 1：1270 帧；0：2402 帧 |
| `CT` | 1：35 帧（0.95%）；0：3637 帧 |
| 最大幅值 | 1179 mg |
| `CT=1` 唯一段 | `SEQ=3248~3282`，64.96~65.64 s，持续 0.68 s |

唯一 CT 段内幅值 0~1011 mg，频率先后出现 120.7/106.1/109.0/199.0/166.9 Hz；该段前后大量 VIB 脉冲的 CT 均为 0。两次最大幅值 1179 mg 分别位于 `SEQ=1813` 和 `SEQ=2757`，均为 `CT=0`。

### T009 单测套件 1~6（2026-11-05 实板）

说明文件：`T009\单测\说明.md`。日志均为检测板 `$VD`，**没有 T009 的 `[SRC]/[MODE]` 状态行，也没有 `D/#DUMP` 输出**。`2.txt~6.txt` 是相互重叠的 20000 行日志切片，不是互斥文件。

| 说明编号 / 项目 | 帧数/主要数据 | 结果 |
|---|---|---|
| 1 平放、移动 | 最后运行 3672 帧/73.42 s；CT=1 仅 35 帧 | 出现 1 段 `0.68 s` 的短 CT；其余大振动均 CT=0 |
| 2 空握（快/慢合拢） | 11669 帧；VIB=1 共 598 帧；最大 1016 mg | **CT 全程 0 帧**，未出现空握误报 |
| 3 空握/4cm 方块/4cm 圆柱/5cm 方块 | 10159 帧；VIB=1 共 1307 帧；最大 1126 mg | **CT 全程 0 帧**，本轮夹持物体未形成任何接触判定 |
| 4 新振子多占空比 | 最后运行 4813 帧/96.24 s；CT 段 `988~4000` 共 3013 帧 | CT 在 60.24 s 内 **3013/3013 全为 1**；主要频率平台约 67~75、92~94、99~111、84 Hz |
| 5 旧振子多占空比 | 最后运行 4785 帧/95.68 s；CT 段 `963~1728`、`2858~3745` | 两段分别 15.30 s/17.74 s 且段内 CT 全 1；中间约 39~55 s 频率 96~99 Hz、幅值约 300 mg，CT=0 |
| 6 自动启停 0.5/1/2/3Hz | 最后运行 7067 帧/141.32 s | 四档 SS 均值分别 **0.5000/1.0014/1.9949/2.9387 Hz**；CT 比例 34.3%/37.0%/0%/0% |

自动启停分档明细：

| 目标档 | 样本数 | 持续 | SS 均值 | CT=1 比例 |
|---|---:|---:|---:|---:|
| 0.5 Hz | 597 | 11.92 s | 0.5000 Hz | 34.3% |
| 1 Hz | 698 | 13.94 s | 1.0014 Hz | 37.0% |
| 2 Hz | 798 | 15.94 s | 1.9949 Hz | 0% |
| 3 Hz | 1000 | 19.98 s | 2.9387 Hz | 0% |
| 1 Hz 复测 | 273 | 5.44 s | 1.0000 Hz | 38.8% |
| 3 Hz 复测 | 441 | 8.80 s | 2.9447 Hz | 0% |

文件汇总：`data\t009b_20261105\suite_summary.json`。

## 数据结论（结论是什么）

1. 任务 A 双重踢已修复：自动重启只保留 80ms 小踢；`T0~T3` 也只启动一次。UART/CDC 两套编译均 0 warning。
2. 任务 B 默认关闭时宿主测试全部保持原结果；默认 UART/CDC 固件在剔除编译时间、ELF SHA、镜像摘要后逐字节一致。
3. 开宏宿主测试 56/56 通过：证据消失后保持到 `CT_HOLD_MS`、保持期内证据刷新会顺延、姿态打开后 contact 在 0.2s 内退出。
4. 开宏 UART/CDC 固件均 0 warning；D 命令开宏输出新增 `holdOk,msSinceEvidence` 两列。
5. 实板完整文件证明 0.5 Hz 启停频率读数稳定为 `0.50`，但当前固件 CT 仍按默认 100 ms 证据退出，0.5 Hz 段 CT=1 仅 45.3%。
6. 实板 2/3 Hz 短段给出的 SS 为 1.81/1.82/2.06×100，且文件中没有 `D` 命令的 hold 列，不能证明当前烧录的是任务 A 修复版或任务 B 开宏版。
7. 单测 1 最后运行全部为手动/瞬态振动，`SS=0`；仅 0.68 s 出现 CT=1，不能作为接触稳定性或启停 CT 保持的验收数据。
8. 单测套件的自动启停四档 SS 均值均已对上目标档（3Hz 均值 2.9387Hz），说明双重踢修复版对应的启停周期已经正常。
9. 自动启停段 CT 没有持续保持：0.5Hz 为 34.3%、1Hz 为 37.0%，2/3Hz 为 0%；当前烧录行为仍不是 `CT_HOLD_ENABLE=1` 的保持版。
10. 新振子多占空比段接触稳定；旧振子有至少一个约 96~99Hz、约 300mg 的平台未过 400mg 接触进入门限，CT=0。

## 异常与未解决项

- 本轮未烧录任务 A/任务 B 新构建；实板四档 20 s 数据、松手退出和单次关源退出仍未采集。
- 两振子默认占空比仍未登记。
- 任务 A 构建产物已更新到 `_probe\t009\`；尚未实板验证双重踢修复后的 2Hz/3Hz 实际启停周期。
- 任务 B 开宏版仅在宿主测试中验证，尚未验证平台侧 1Hz/0.5Hz 实板表现。
- 2026-11-05 完整实板文件显示当前烧录行为仍为默认 CT 退出（约 40~120 ms），尚未观察到 `CT_HOLD_MS=1200 ms` 的 OFF 段保持效果；2/3 Hz SS 也未达到 2.00/3.00。
- 单测 1 的 `CT=1` 仅 35/3672 帧（0.95%），其中两次 1179 mg 峰值均未形成接触；该文件不能用于四档 SS 或 CT 保持验收。
- 单测套件没有 T009 状态行和 `D/#DUMP`，无法从日志直接复核 KEY1~KEY4 的按键动作、模式切换、`holdOk/msSinceEvidence`。
- 单测 2 和 3 的 CT 全程为 0；其中 3 号项目若确实是 4cm 方块/圆柱/5cm 方块夹持，则需要按实板操作重新确认姿态/基准与夹持动作，因为本轮没有产生接触判定。
- 单测 6 日志含 1 次 `BROWNOUT_RST`、多次重启；自动四档前四段中的前 3 段持续时间为 11.92/13.94/15.94s，未达到说明中的每档 ≥20s。
