wmsz88/flex-vib-monitor/vibmon_v5/结果/RT011-20261105.md

# RT011-20261105 — 启停节奏进入接触（场外）

任务号: T011
执行模型: Claude (OUTSIDER)
执行日期: 2026-11-05
署名: 2026-11-05 23:30 · Claude (OUTSIDER)

## 改动摘要（做了什么）

- `config.h`：新增 `CT_SS_ENTRY_ENABLE`（默认 = `CT_HOLD_ENABLE`）、`CT_SS_ENTRY_MIN_HZ=1.5f`；编译期检查：只能 0/1，开启必须同时开 `CT_HOLD_ENABLE`。
- `state.cpp` `combineContact`：进入条件 `姿态 && 幅值 && 频率` → `姿态 && ((幅值 && 频率) || ssEff)`，`ssEff = ssValid && ssHz ≥ 1.5`；`ssEff` 同时计入 hold 证据。宏关时 `ssEff` 恒 0，逻辑与原来一致。
- `test/contact_test.cpp`：新增 S1~S4（仅宏开编译）。
- `AGENTS.md`：新增场外角色行与 §1.2。`规划/tasks/T011-…（场外）.md` 新卡。

## 测试/测量数据（测到什么）

### 宿主测试

| 配置 | contact_test | dump_test | gyro_test | comp_frame_test |
|---|---:|---:|---:|---:|
| HOLD=0（宏全关） | 46/46 | 19/19 | 8/8 | 22/22 |
| HOLD=1, SS_ENTRY=0 | 56/56 | 15/19 | 8/8 | 22/22 |
| HOLD=1, SS_ENTRY=1 | **65/65** | 15/19 | 8/8 | 22/22 |

- dump_test 在 HOLD=1 下 4 项失败，SS_ENTRY=0 时同样 4 项失败：原因是该测试按默认 24 列写死，hold 版多 2 列（RT009 已另用 dump_hold_probe 验证），与本卡无关。
- 负对照：`CT_SS_ENTRY_MIN_HZ=10` 时 S1 失败（64/65），说明 S1 确实依赖新路径。
- `CT_HOLD_ENABLE=0 + CT_SS_ENTRY_ENABLE=1` 编译报 #error，符合设计。

### 固件

| 配置 | FQBN | Warning | Flash | RAM | `.bin` SHA-256 |
|---|---|---:|---:|---:|---|
| HOLD=1, SS_ENTRY=1（config.h 当前默认） | `esp32:esp32:esp32c3` | 0 | 366688 B | 30100 B | `2ad0072eff18b5438b16f4a8bbac563d6287046f56c62405afca3e604c14bf06` |

产物：`_probe\t011\build_uart\`。注意：arduino-cli 输出路径含中文时链接失败，需用纯英文 `--build-path` 再拷回。

### 离线数据依据（`_probe\t011\`）

`bursts_out.txt`（振动段统计，幅值 ≥100mg 连续帧）：

| 数据 | 60~300ms 段数 | 连续 3 帧 ≥250mg | 峰值最大 | 启停读数出现过 |
|---|---:|---:|---:|---|
| 1 平放移动 | 37 | 10 | 1179mg | 无 |
| 2 空握 | 10 | 1 | 1016mg | 0.11Hz |
| 3 夹不振动物体 | 24 | 6 | 1126mg | 0.87Hz |

`replay_out.txt`（6.1/6.2 按 4s 窗回放，假设手指全程闭合）：

| 档位 | 原 CT | 新规则 CT（稳定窗） |
|---|---:|---:|
| 0.5/1Hz | 83~100% | 不变 |
| 2Hz | 0~100% | 96~100% |
| 3Hz | 0% | 92~100% |

过渡窗（刚切档、启停读数还没锁定）为 32~70%。

## 数据结论（结论是什么）

1. 新进入路径在宿主测试中按设计工作：3Hz 节奏锁定后进入、OFF 段保持；首周期不进入；未闭合不进入；1Hz 不走新路径；节奏中松手 0.2s 内退出。
2. 宏全关时 4 项宿主测试结果与改动前一致。
3. 离线回放预计 2/3Hz 稳定段 CT ≥92%；进入延迟约 2 个启停周期（2Hz ≈1s，3Hz ≈0.7s）。
4. 空握/夹物/移动瞬态在 1~3 号数据中从未产生 ≥1.5Hz 的启停读数；降幅值门到 250mg 则有 17 段可能在闭合时误进。

## 异常与未解决项

- 未实板验证。回放无姿态列，假设启停段手指全程闭合。
- 人有节奏地反复抖动手指 ≥1.5Hz 且每次 >180mg 时，理论上可走新路径误进；1~3 号数据未出现，实板需专门测一次。
- `config.h` 中 `CT_HOLD_ENABLE` 当前默认 1（非本卡改动），plan 写的出发固件为 0，出发前需确认用哪一版。
