wmsz88/flex-vib-monitor/vibmon_v5/结果/RT011-20261106.md

# RT011-20261106 — T011 实板复测分析 + 启停缺口假边沿修正（场外）

任务号: T011
执行模型: Claude (OUTSIDER)
执行日期: 2026-11-06
署名: 2026-11-06 00:40 · Claude (OUTSIDER)

数据：`结果\T009\新\1~4.txt`（人类 2026-11-05 23:49~23:57 采，T011 固件 SHA 2ad0072e…）、`说明.txt`。
脚本：`_probe\t011\timeline.py`、`ss_replay.cpp`。

## 改动摘要（做了什么）

- `config.h`：新增 `SS_EDGE_FIX_ENABLE`（默认 = `CT_HOLD_ENABLE`）及 0/1 检查。
- `state.cpp` `stateOnGap`：宏开时缺口后 `s_ssVib=1`（原为 0），缺口后必须先确认一次下降才接受起振。
- `test/contact_test.cpp`：新增 E2（仅宏开编译）。
- `_probe\t011\ss_replay.cpp`：把实板 AMP 序列回放进真实 `state.cpp` 启停支路。
- 试过「从最新周期往回取一致段」，回放显示空握假读数增加，已撤回，代码中不保留。

## 测试/测量数据（测到什么）

### 实板 2/3Hz（4.txt）

| 档位 | 稳定段 CT | 启停读数 |
|---|---:|---|
| 1Hz | 100% | 1.00 |
| 2Hz | 100%（160~184s） | 1.99~2.01 |
| 3Hz | 100%（196~211s） | 2.88~2.97 |

### 空握（新\1.txt，108s）

CT=1 共 1142 帧，6 次进入，合计约 23s：

| 时刻 | 200ms 内幅值峰值 | 进入时启停读数 | 持续 | 走的路径 |
|---|---:|---:|---:|---|
| 15.5s | 730 | 0 | 2.8s | 原幅值路径 |
| 40.8s | 735 | 1.25 | 2.7s | 原幅值路径 |
| 46.2s | 841 | 0 | 1.4s | 原幅值路径 |
| 61.0s | 615 | 0 | 4.0s | 原幅值路径 |
| **69.3s** | **307** | **1.78** | **5.7s** | **T011 启停路径** |
| 80.3s | 620 | 4.12 | 6.3s | 原幅值路径 |

本文件 2~86s 持续出现 300~989mg、80~170Hz 振动，与单测\2.txt（空握，CT 全 0）差别很大。

### 0.5Hz 启停读数慢、中途掉线（3.txt 62~120s）

- 起振边沿周期 1.96~2.04s，很规则。
- 62.8s 起振，70.8s 才出读数：起振前约 55s 的残留振动留下一个 7.5s 离群周期，要等它滑出 4 周期窗口。
- 75.8s ON 段中一帧 AMP=0（采样缺口），之后读数掉到 84.8s。

回放 3.txt 与 空握数据（每秒是否有启停读数）：

| 版本 | 3.txt 0.5Hz 首读数 | 3.txt 76~83s 有读数 | 新\1 空握有读数秒数（≥1.5Hz） | 单测\2 空握 |
|---|---:|---:|---:|---:|
| 修正前（与实板逐秒一致） | 70s | 0/8s | 11（7） | 0 |
| **缺口修正（采用）** | 70s | **8/8s** | 9（7） | 0 |
| 缺口修正 + 往回取一致段（撤回） | 66s | 8/8s | 27（16） | 23 |

### 宿主测试

| 配置 | contact_test | dump | gyro | comp_frame |
|---|---:|---:|---:|---:|
| HOLD=0 | 46/46 | 19/19 | 8/8 | 22/22 |
| HOLD=1, SS_ENTRY=0, EDGE_FIX=0 | 56/56 | — | — | — |
| HOLD=1（全开） | **67/67** | 15/19（既有列数问题，同 RT011-20261105） | 8/8 | 22/22 |

负对照：测试块强开、`SS_EDGE_FIX_ENABLE=0` → E2 失败（66/67），复现实板掉线。

### 固件

| 配置 | Warning | Flash | RAM | `.bin` SHA-256 |
|---|---:|---:|---:|---|
| HOLD=1（T011 + 缺口修正） | 0 | 366692 B | 30100 B | `e945d95808d8ecf4d62d099e960725def849d8dcc86a5226ff5e7b871c3e49f6` |

产物：`_probe\t011\build_uart_b\`。

## 数据结论（结论是什么）

1. T011 实板达标：2/3Hz 稳定段 CT 100%，启停读数准确。
2. **勘误 RT011-20261105 结论 4**：空握会产生 ≥1.5Hz 启停读数（新\1.txt 1.78Hz），T011 路径在空握中误进 1 次、5.7s；同文件另有 5 次误进来自原幅值路径。
3. 0.5Hz 中途掉线由采样缺口后的假起振边沿引起，修正后回放消失，空握假读数不增加。
4. 0.5Hz 起始慢有两部分：至少 2 个周期（4s）是测频率的下限；超出的 4s 来自残留离群周期，能修，但修法会让空握假读数翻倍，不采用。
5. 1Hz「接触已 1、启停仍 0」：接触走幅值路径约 0.1s 进入，启停读数要攒 2 个周期（≥2s），属于两者原理不同，不是故障。

## 异常与未解决项

- 缺口修正未上实板。
- 新\1.txt 空握期间持续 300~989mg 振动的来源不明，决定接触能否「闭合即锁存」。
