wmsz88/flex-vib-monitor/vibmon_v5/结果/RT012-20261106.md

# RT012-20261106 — v6 接触三条（场外）

任务号: T012
执行模型: Claude (OUTSIDER)
执行日期: 2026-11-06
署名: 2026-11-06 01:30 · Claude (OUTSIDER)

## 改动摘要（做了什么）

新目录 `代码\vibmon_v6\`，由 v5 源码拷贝（含 T011 与缺口修正），`vibmon_v5.ino` 改名 `vibmon_v6.ino`，其余文件名不变。

- `config.h`：新增 `CT_V6_ENABLE`、`GYRO_LP_HZ`、`CT_SETTLE_ENABLE/DPS/MS`、`CT_RELEASE_DEG`、`SS_CLEAR_ON_SETTLE` 及编译检查。
- `state.h`：`Result` 新增 `gyroLpW`、`settled`、`ctMovedDeg`。
- `state.cpp`：
  - `gyroLpStep`：每个陀螺样本做每轴两级低通，算"已停下"；接触后累计超过停下门限的转角。削顶样本不进滤波、按停下处理。
  - `combineContact` v6 分支：进入 = 姿态 + 停下 + 证据；已接触时只在转角 > 10° 退出。
  - `ctStep`：无陀螺/陀螺停更时 settled 按 1；张开时复位"本次收拢已清"标志；收拢后第一次真停下清启停历史。
  - 各复位点调用 `v6Clear`。
- `output.cpp`：`d` 调试行多一行 `#V6`。
- `test/contact_test.cpp`：H1/H2/C14 按 v6 语义分支；新增 V1~V5。

## 测试/测量数据（测到什么）

### 宿主测试

| 配置 | contact_test | gyro | comp_frame | dump |
|---|---:|---:|---:|---:|
| v6 默认 | **85/85** | 8/8 | 22/22 | 15/19（既有 hold 列数问题） |
| `CT_V6_ENABLE=0` | 67/67 | — | — | — |
| `CT_V6_ENABLE=0 CT_HOLD_ENABLE=0` | 46/46 | — | — | — |

负对照：

| 改动 | 失败用例 | 说明 |
|---|---|---|
| `CT_SETTLE_ENABLE=0` | V1 | 收拢途中有振动会进接触 |
| `CT_RELEASE_DEG=1000` | V3 | 接触后再转动不退出 |
| `GYRO_LP_HZ=60` | V5 | 振动串进陀螺，lpW 9.8~132.6dps，判不出停下 |

V5（陀螺带 300dps 正弦，按 250Hz 采样相位）：80/120/180Hz 低通后 lpW 0.0~0.1dps，settled=1，contact=1，累计转角 0°。

### 离线标定（v5\_probe\t011\）

| 量 | 结果 |
|---|---|
| 闭合振动时原始 gyroW 中位数 | 22~93dps（55 个 CSV） |
| 闭合安静时原始 gyroW 中位数 | 5.5dps |
| 负样本振动占比（1.5s 窗、≥200mg） | 移动 31%、空握 17%、夹不振动物体 33% |
| 正样本振动占比 | 2Hz 19~47%、3Hz 12~49% |

### 固件

| FQBN | Warning | Flash | RAM | `.bin` SHA-256 |
|---|---:|---:|---:|---|
| `esp32:esp32:esp32c3` | 0 | 367598 B | 30156 B | `4e8ef5f45bda59efa18f9db081f29038f549e83f739a1bdebe75007aabad81ee` |

产物：`vibmon_v6\build_uart\`。

## 数据结论（结论是什么）

1. 三条规则在宿主测试中按设计工作，且每条都有负对照证明用例确实依赖新逻辑。
2. 停下判据必须先滤波：原始角速度在振动时远超任何静止门限；4Hz 两级低通在合成数据上把 300dps 振动压到 0.1dps。
3. 单靠加速度占比无法区分真假接触，正负样本重叠；v6 的区分力来自"手指已停下"，这一点只能实板验证。
4. 关掉 `CT_V6_ENABLE` 后行为与 v5 + T011 一致。

## 异常与未解决项

- 未实板。合成正弦不含实际振动的谐波与削顶不对称，实板 lpW 需看 `#V6` 行确认。
- 现有日志均无每轴陀螺数据，"停下"判据无法离线回放。
- dump_test 在 hold 构建下 4 项失败为既有问题（列数写死）。
