wmsz88/flex-vib-monitor/vibmon_v5/结果/RT012-20261106b.md

# RT012-20261106b — v6 实板复测分析 + 三处修正（场外）

任务号: T012
执行模型: Claude (OUTSIDER)
执行日期: 2026-11-06
署名: 2026-11-06 13:00 · Claude (OUTSIDER)

数据：`vibmon_v6\测试\V6\1~5.txt`、`说明.txt`（人类 11:04~11:38 采，v6 固件 SHA 4e8ef5f4…）。日志无 `#V6` 调试行（未按 `d`）。
脚本：`vibmon_v6\测试\V6\_win.py`、`vibmon_v6\test\ss_replay.cpp`、`vibmon_v6\test\ss_eval.py`。

## 实板结果（测到什么）

| 项 | 结果 |
|---|---|
| 1 空握 ×3 | 1 次误进 2.2s（11:14:51，几次敲击形成 2.48Hz 启停读数，走启停路径），之后自行退出 |
| 2 4cm 无振动 ×3 | CT 全 0 |
| 3 新旧振子各 30s | 11:30:40~11:32:00 CT 100%；11:31:16~11:31:24 振动停 8s 仍为 1（锁存生效） |
| 4 新振子启停 + 振动中松手 | 0.5/1/3Hz CT 100%；11:34:06 松手 CT 掉 0、振动仍在 |
| 5 旧振子启停 | 0.5/1Hz CT 100%；**2Hz 段振幅/读数正常但 CT 掉 4 次**（11:37:20/30/36/45）；3Hz 无读数 |

问题定位：

| 问题 | 原因 |
|---|---|
| 0.5Hz 首读数晚（新 8.0s、旧 15.9s） | 起振前的离群周期（旧振子一处 7.94s）占住 4 周期窗口，要等它滑出 |
| 旧振子 3Hz 无读数 | ON 段峰值只有 150~212mg，180mg 起振门大半拍跨不过，边沿漏记 |
| 旧振子 2Hz 接触掉 4 次 | v6 下只有陀螺能让 CT 退出；推测启停反扭矩让手指来回摆，旧算法累计 \|角速度\| 把来回摆当成转动（无 `#V6` 行，未直接证实） |

## 改动摘要（做了什么）

`vibmon_v6\`：

- `config.h`：`SS_HI_MG/SS_LO_MG` 180/150 → 120/80；新增 `SS_TRAIL_IN_CONTACT`（默认跟随 v6）、`CT_RELEASE_NET=1`、`CT_RELEASE_TAU_MS=500`。
- `state.cpp`：
  - `ssEvaluate`：contact=1 时从最新周期往回取连续一致段；contact=0 时规则不变。
  - `gyroLpStep`：分离判据改为每轴低通角速度带泄漏积分的净转角，取本次接触内最大值。
  - 新增 `moveClear`、测试钩子 `stateTestSetContact`。
- `test/contact_test.cpp`：新增 V6（2Hz 来回摆）、V7（接触中离群周期）。
- `test/ss_replay.cpp`、`test/ss_eval.py`：带 CT 列的回放与 17 段评估。

## 测试数据

### 回放（ss_eval.py，读数在目标 ±10% 的帧占比 / 段起点到首个正确读数）

| 段 | 修正前 | 修正后 |
|---|---:|---:|
| 新 0.5Hz | 50% / 9.8s | 70% / 5.7s |
| 旧 0.5Hz | 42% / 17.4s | 55% / 13.4s |
| 新 1Hz | 67% / 6.0s | 78% / 3.9s |
| 旧 1Hz | 57% / 5.7s | 71% / 3.7s |
| 旧 2Hz | 44% / 5.8s | 38% / 5.2s |
| **旧 3Hz（实板失败段）** | **0%** | **59% / 3.2s** |
| 新 2Hz | 45% / 1.7s | 52% / 0.7s |
| 6.1 2Hz | 59% | 78% |
| 6.2 3Hz | 74% | 94% |
| 固定振动 新旧 / 单测4 / 单测5 假读数 | 0 / 0 / 0 s | 0 / 2 / 0 s |
| 空握 假读数 | 2 s | 3 s |

另试过只开「接触中取最新一致段」不降门限：单测5（固定振动、夹持中）假读数 0 → 9s，原因是 150~210mg 的弱振动在 180/150 两门间来回跨；降到 120/80 后为 0。

### 宿主测试

| 配置 | contact_test |
|---|---:|
| v6 默认 | **89/89** |
| `CT_RELEASE_NET=0` | V6 失败（累计转角 20.9°） |
| `SS_TRAIL_IN_CONTACT=0` | V7 失败 |
| `CT_SETTLE_ENABLE=0` / `GYRO_LP_HZ=60` | V1 / V5 失败（同前） |
| 关 v6 且 SS 门限 180/150 | 67/67；再关 hold 46/46 |

gyro 8/8、comp_frame 22/22、dump 15/19（既有列数问题）。

### 无振动接触可行性（v5\data\*.csv，每次闭合取静止段角度中位数）

| 工况 | 次数 | 最小 | 中位 | 最大 |
|---|---:|---:|---:|---:|
| 空握 | 36 | 100.6° | 117.8° | 161.3° |
| 夹 4cm 方块 | 23 | 110.1° | 118.7° | 143.8° |

### 固件

| FQBN | Warning | Flash | RAM | `.bin` SHA-256 |
|---|---:|---:|---:|---|
| `esp32:esp32:esp32c3` | 0 | 367892 B | 30156 B | `0bf3c2fdeae35bb48353389650d618d22df92c81da5c05d72d472efedff5ad89` |

## 数据结论（结论是什么）

1. v6 三条规则实板生效：振动中松手 CT 掉 0、振动停而手不动 CT 保持 1、无振动夹物 CT 为 0。
2. 0.5Hz 首读数的下限是 2 个周期（4s）；接触中已去掉离群周期造成的额外等待，回放提前 4s。再快只能 1 个周期出读数，会让弱固定振动产生假读数，不采用。
3. 旧振子 3Hz 失败是起振门太高，降到 120/80 后回放可读出。
4. 旧振子 2Hz 接触掉线按「来回摆」推测修正，宿主用例证实新判据不误分离、旧判据会；实板原因待 `#V6` 行证实。
5. 无振动接触不能靠闭合角判断：空握与夹 4cm 方块的角度范围完全重叠。

## 异常与未解决项

- 修正后固件未上实板。
- 旧振子 2Hz 掉线原因需要按 `d` 录 `#V6` 行证实。
- 空握误进 1 次 2.2s（启停路径），本轮未处理。
