wmsz88/flex-vib-monitor/vibmon_v5/规划/tasks/T014-v8分层检测.md

# T014 — v8 分层检测

状态: doing
任务号: T014
派卡模型: glm5.3 (PLANNER-B)
派发日期: 2026-11-07 00:10
执行模型: EXEC (flash)
涉及目录: `代码\vibmon_v8\`、`代码\vibmon_v5\结果\`
前置: 无（V6 最终版冻结；V7 参考版冻结；两者都不改）

## 一、目标

在 V6 出发版基础上新建 **vibmon_v8**，把检测架构明确拆成两层：

1. **实时层**：输出当前 `VIB` / `CT`，50Hz，供比赛平台读取
2. **均匀/稳态层**：滑窗统计主频、幅值、启停频率，输出稳定性和离散度，供答辩与后续平台扩展

要求：

- V8 是**独立实验线**
- V6 最终版源码、预编译 `bin`、T013 验收状态全部不动
- V7 只作现场适配参考，不作为 V8 基线以外的直接来源
- V8 默认 `$VD` 帧仍为 35 字节，不改比赛帧
- 均匀层结果先走调试行，不进 `$VD`

## 二、基线与目录

| 版本 | 角色 | 处理方式 |
|---|---|---|
| V6 | 最终版 / 出发版 | 不改 |
| V7 | 现场适配参考版 | 不改 |
| V8 | 分层检测实验版 | 新建 `代码\vibmon_v8\` |

创建方式：

```text
复制 `vibmon_v6\` → `vibmon_v8\`
重命名 `vibmon_v6.ino` → `vibmon_v8.ino`
更新 README 为 v8
```

## 三、代码改动范围

### A. 新增实时层与均匀层

新增两个模块：

```text
vibmon_v8\layered_detection.h
vibmon_v8\layered_detection.cpp
```

要求：

- `RealtimeDetector`
  - 输出 `vib` / `contact`
  - 保持与 V6 接触三条语义一致
  - 振动状态带 120/80mg 滞回
- `UniformDetector`
  - 滑窗统计主频、幅值、启停频率
  - 输出中位数、离散度、有效率
  - 输出 `stable`

可参考：

```text
赛前准备\10_软件解读与现场更改\代码示例\layered_detection.h
赛前准备\10_软件解读与现场更改\代码示例\layered_detection.cpp
赛前准备\10_软件解读与现场更改\代码示例\layered_detection_test.cpp
```

但集成时必须按 v8 命名与代码风格整理，不要直接粗暴复制未适配的示例。

### B. 接入点

建议修改：

```text
state.cpp
state.h
vibmon_v8.ino
output.cpp
```

接入要求：

1. `stateOnFrame()` 后构造 `InputFrame`
2. 同一帧分别送入 `RealtimeDetector` 和 `UniformDetector`
3. 不改变 V6 现有 `Result.contact/vib/ss/freq` 的取值
4. 新层输出仅作观测，不反向影响 V6 判据
5. `d` 调试模式下新增一行：

```text
#LAYER vib= ct= stable= fmed= fspread= amed= aspread= ssmed= valid=
```

字段含义：

| 字段 | 含义 |
|---|---|
| `vib` | 实时层振动状态 |
| `ct` | 实时层接触状态 |
| `stable` | 均匀层是否稳定 |
| `fmed` | 滑窗主频中位数 |
| `fspread` | 主频离散度 |
| `amed` | 滑窗幅值中位数 |
| `aspread` | 幅值离散度 |
| `ssmed` | 滑窗启停频率中位数 |
| `valid` | 有效样本百分比 |

### C. 配置宏

`config.h` 新增：

```c
#define LAYERED_DETECT_ENABLE  1
#define LAYER_WINDOW_N         50
#define LAYER_FREQ_SPREAD_MAX  0.08f
#define LAYER_ENV_SPREAD_MAX   0.25f
#define LAYER_VALID_RATIO_MIN  0.70f
```

要求：

- `LAYERED_DETECT_ENABLE=0` 时编译无新增调试行，行为与 V6 相同
- 编译期断言参数合法
- 不引入堆分配
- 不阻塞主循环

## 四、测试要求

### 1. 新增宿主测试

新增：

```text
test\layered_detection_test.cpp
```

覆盖：

1. 实时层初始为 0
2. 连续 3 个高包络后 `vib=1`
3. 低包络后 `vib=0`
4. 闭合 + 停下 + 振动后 `contact=1`
5. 松开后 `contact=0`
6. 稳定信号 `stable=1`
7. 漂移信号 `stable=0`
8. 有效样本不足 `stable=0`
9. 窗口滑动行为正确
10. `LAYERED_DETECT_ENABLE=0` 回到 V6 行为

### 2. 全量回归

在 `test\run_all.ps1` 中纳入 `layered_detection_test`。

合格线：

| 测试 | 目标 |
|---|---|
| contact_test | 89/89 |
| gyro_test | 8/8 |
| comp_frame_test | 22/22 |
| dump_test | 15/19（4 项既有失败） |
| led_test | 可运行；若继承 V7 则 64/64 |
| ss_replay | 可运行 |
| layered_detection_test | 新增，全过 |

### 3. 双 FQBN 编译

| FQBN | 要求 |
|---|---|
| `esp32:esp32:esp32c3` | 0 warning |
| `esp32:esp32:esp32c3:CDCOnBoot=cdc` | 0 warning |

记录：

- Flash
- RAM
- `.bin` SHA
- 构建路径
- 源码文件 SHA

### 4. 帧格式回归

编译宏全关时：

```text
$VD,SEQ,FREQx10,AMP_MG,VIB,CT,SSx100,VALID,CHK
```

要求：

- 帧长仍为 35 字节
- CHK 抽 5 帧，5/5 对
- SEQ 无不连续
- 不引入 `stable` 字段

### 5. 实板验证

1. 上电 / 复位后 START 姿态
2. 插 USB-CDC，发 `d`
3. 观测 `#LAYER` 调试行
4. 空握：`ct=0`，`stable=0`
5. 持续振动：`vib=1`，`ct=1`，`stable` 应在窗口后变为 1
6. 松手：`ct=0`
7. 启停振动：`ssmed` 正确，`stable` 允许为 0
8. `LAYERED_DETECT_ENABLE=0` 构建：无 `#LAYER` 行，`$VD` 与 V6 相同

## 五、交付物

1. `代码\vibmon_v8\`
2. `README.md`：
   - V8 是什么
   - 与 V6/V7 的关系
   - 分层架构图
   - 编译方法
   - `#LAYER` 字段说明
3. `结果\RT014-YYYYMMDD.md`
4. 测试数据目录：

```text
代码\vibmon_v8\测试\V8\
```

## 六、验收标准

1. V6/V7 未被修改
2. v8 独立目录存在，源码可编译
3. 宿主测试全过
4. 双 FQBN 0 warning
5. 默认 `$VD` 帧仍为 35 字节
6. `#LAYER` 调试行可用
7. 均匀层输出不改变 V6 判据
8. `LAYERED_DETECT_ENABLE=0` 可完整回退

## 七、纪律

1. 不改 `dsp.cpp / mpu.cpp / posture.cpp / sampler.cpp` 判据与采样链路
2. 不改比赛口协议
3. 不引入动态内存分配
4. 不在主循环做阻塞计算
5. 不把 v8 称为最终版；最终版仍是 V6

## 八、完成记录

（flash 交卷后由规划模型验收填写）
