wmsz88/flex-vib-monitor/vibmon_v5/规划/tasks/T013-v6出发版收口与烧录验证.md

# T013 — v6 出发版收口与烧录验证

状态: done（2026-11-06 19:40 · glm5.3 (PLANNER-B) 验收通过）
任务号: T013
派卡模型: glm5.3 (PLANNER-B)
派卡日期: 2026-11-06 13:30
来源: plan.md 2026-11-06 13:10 Claude (OUTSIDER) 交接口径——「建议出发固件 v6，人类未最终拍板；config.h 中 CT_HOLD_ENABLE 在 v5 现为 1，与本文件不一致，收尾时需确认；未采集 `#V6` 调试行」
执行模型: EXEC (flash)
派发日期: 2026-11-06 13:40 · glm5.3 (PLANNER-B)
涉及目录: `代码\vibmon_v6\`（主）、`代码\vibmon_v5\结果\`（RT 落这里）
前置: 无（T009/T010 不阻塞本卡；T010 码改部分排在本卡之后）

## 目标

把 v6 从「场外验证版」变成可出发的版本：**不改判据逻辑**，只做三件事——① 提交与文档落盘；② 回放脚本按 RT012 结论复现一遍；③ 上板做一次出发前体检（含 `#V6` 调试行），供人类在 v5 默认版与 v6 之间拍板。

## 改什么（只允许这三类）

1. **git**：`vibmon_v6\` 已于 2026-11-06 由 PLANNER-B 提交入库（当前基线 `bf7b780`；此前相关提交为 `0948585`），flash 只需在其后继续提交，不得 `reset`/`rebase` 掉既有提交。
2. **文档**：在 `代码\README.md` 顶部说明区新增「当前版本」小节：v5 = 历史默认版（当前工作区实为 `CT_HOLD_ENABLE=1` + T011 行为）；v6 = 接触三条候选版 + 三个现场开关 + 编译方法；两者均未由人类拍板为出发版。其它历史文档（`当前状态.md` 等）仍只读，不更新。
3. **测试收口**（可选，但推荐）：新增 `test\run_all.ps1`，一条命令跑完 contact / gyro / comp_frame / dump 四个宿主测试（用 MinGW g++，链接 `state.cpp posture.cpp dsp.cpp output.cpp`，依赖桩写在脚本里），并在末尾打印 pass/fail 汇总。脚本不进固件。

**禁止**：改 `vibmon_v5` 的代码与 `规划\`；给 v6 加任何判据逻辑（RT012 六条结论已定，见下）。

## 已定事项（不要再改）

- SS 起振门 `SS_HI_MG/SS_LO_MG = 120/80`：实板 3Hz 由 0% 提到 59%（回放）。
- 接触中启停取「最新一致段」（`SS_TRAIL_IN_CONTACT=1`）。
- 分离判据用净转角（`CT_RELEASE_NET=1`，10°/泄漏 500ms）。
- 无振动接触：闭合角与撞击抖动两条路都已被数据排除，不再尝试。

## 验收标准

| # | 项 | 判据 |
|---|---|---|
| 1 | 全量宿主测试 | contact 89/89、gyro 8/8、comp_frame 22/22、dump 15/19（4 项失败为既有列数问题，须列明是哪 4 项且与 v5 基线一致） |
| 2 | 双 FQBN 编译 | `esp32:esp32:esp32c3` 与 `esp32:esp32:esp32c3:CDCOnBoot=cdc`（按本机已验证的写法）均 0 warning，记录 Flash/RAM 与 `.bin` SHA-256 |
| 3 | 回放复现 | `test\ss_replay.cpp` + `ss_eval.py` 对 V6\1~8 与单测 1~6 重跑，三个关键数复现：旧 3Hz 59%、6.2 档 94%、固定振动假读数 0s |
| 4 | v5 对照 | v5 当前 config（`CT_HOLD_ENABLE=1` + T011）同样跑一遍 contact_test，报数（预期 65/65，以实测为准） |
| 5 | 出发判断表 | 在 RT 里给出 v5 / v6 两版一页对照：进入条件、保持、分离、0.5Hz 首读数、2/3Hz 读数、空握误进次数、关闭振动后退出延迟、dump/帧格式差异 |

## 实板体检（人类操作，flash 写脚本+播报提示，一轮跑完）

沿用 `..\vib_range_test\实板测试模式.md`：脚本后台采集 + 语音逐步提示 + 一轮跑完。开 `d` 采 `#V6` 行。

1. **检查 A（#V6 取证）**：旧振子 2Hz 启停 30s，手指保持不动；把 `lpW / settled / moved` 的中位、最大写进 RT——目的是把 RT012「来回摆」从推测变成证据。
2. **检查 B（退出延迟）**：连续振动中松手，用 $VD 帧时间戳量化「松手→ct 掉 0」的毫秒数（≥3 次），与 v5 的 0.30~0.42s 对比。
3. **检查 C（空握误进）**：空握 10 次，记 ct=1 的持续总时长（v6 两轮历史：1 次 2.2s / 0 次）。
4. **检查 D（帧格式）**：出厂帧仍 35 字节、CHK 全对；与 T008 默认构建逐域对照（v6 只应多 `#V6` 调试行，帧不应变）。

合计一轮约 **2 名操作者 40 分钟**；数据放 `代码\vibmon_v6\测试\V6b\`。

## 要求回传的数据

- `结果\RT013-YYYYMMDD.md`：上面 5 条验收 + 4 项实板检查，每项「测到什么 → 结论是什么」，不写「建议下一步」。
- `测试\V6b\说明.txt`：采集顺序、固件 SHA、开没开 `d`。
- 最终上板/下板情况（哪个 bin、烧完是否烧回）。

> 说明：本卡不决定出发固件，只把对照材料做齐。人类拍板后，未选中版本归档为 `_backups\`，选中版本写进 `当前状态.md` 只读存档。
