wmsz88/flex-vib-monitor/vibmon_v5/规划/tasks/T009-C8T6振动源驱动器.md

# T009 — ESP32 振动源驱动器（4 按键 + 串口状态 + 手动/自动启停）

状态: done（2026-11-06 · glm5.3 (PLANNER-B) 收尾：任务 A 以驱动板回归 vibsource_esp32_dual 原版结案；任务 B hold 版已实板验收；B-2 进入门放宽人类 2026-11-06 00:05 拍板暂缓，2/3Hz 进入改由 T011/T012 承担。驱动板/检测板最终烧录版本见 plan.md「当前阶段」）
任务号: T009
派卡模型: glm5.3 (PLANNER-B)
派卡日期: 2026-11-03 23:30（23:45 修订分工；23:52 改 OLED；11-04 18:30 弃 C8T6 改回 ESP32；18:40 四改：去 OLED 用串口；11-05 00:03 五改：并入补充任务 B「启停 CT 保持门控」（人类 m01268 指示不开新卡）；11-05 09:40 曾并入补充任务 C「比赛 LED 预案」，**09:45 人类改指示（m01349）开独立 T010 卡，任务 C 移出本卡**；**11-05 18:05 六改：人类指示（m01501）弃 vibsource_c3_key，驱动固件回归 vibsource_esp32_dual 原版，任务 A 以回归结案（详见完成记录）**；**11-05 21:50 七改：人类指示（m01717「行就是行，不行就是不行……思考完善代码」）追加补充修订 B-2「启停档 CT 进入门放宽」，宏 CT_HOLD_ENABLE=1 时生效，默认构建不变（详见 B-2 节）**）
来源: 人类指示（m01001/m01023/m01047/m01061/m01087）——振动源驱动器：flash 写代码并协助人类交结果，人类做实板测试，规划模型出规格与验收。方案演变：C8T6+OLED → ESP32+OLED → **ESP32 + 4 按键 + 串口**（改动量最小：现成固件 + 4 个按键）
结果文件: （完成后填：RT009-YYYYMMDD.md）

## 目标

在现有 ESP32-C3 SuperMini 双路固件（Desktop\STM32project\vibsource_esp32_dual\）基础上，**只加 4 个物理按键**，串口命令行与状态输出沿用现状：
1. KEY1 三态循环选源（新 → 旧 → 全关，循环）；
2. KEY2 跳默认驱动点（各振子一个默认值；自动模式下复用为切周期档）；
3. KEY3/KEY4 占空比 +5% / -5%（0~100 夹取）；
4. 手动/自动启停（KEY1 长按 ≥1s 切换；自动=0.5/1/2/3Hz 四档播放）；
5. **串口即状态界面**——每次按键/命令后打印状态（沿用现有 printStatus 模式），板载 LED 给运行指示。

**这是改动量最小的方案**：固件的串口命令行、状态打印、双路 PWM、踢一脚、四档周期表全部现成；按键只是把现有命令（a/b/z/p/+/-/T0-3/T）映射到 GPIO 输入。无 OLED、无新库、无新依赖。

**本卡含两个任务**：任务 A = 驱动器（上文全部内容，vibsource_c3_key 工程）；任务 B = 启停 CT 保持门控（vibmon_v5 侧，见「补充任务 B」节，人类 2026-11-05 00:00 指示并入）。执行顺序：**任务 A 剩余项（修双重踢 bug → 人类按键实测回传 → 默认占空比登记）先行，再做任务 B**。原 11-05 09:40 曾并入的「任务 C：比赛 LED 预案」已按人类 09:45 指示移至独立 T010 卡（现场适配预案清单）。

## 引脚方案（ESP32-C3 SuperMini，PLANNER-B 拟定待人类接线确认）

> 依据 config.h 引脚禁区（GPIO11~17=Flash、GPIO18/19=USB、GPIO2/8/9=strapping；安全区 GPIO0~7、GPIO10）。已用 GPIO3/4（PWM）与 GPIO8（LED）。

| 功能 | 引脚 | 说明 |
|---|---|---|
| PWM_A → 新振子 | GPIO3 | 沿用现接线（T006 修正档案：GPIO3 实接新低速振子 71~120Hz）——**新固件标签直接按实况命名：A=新** |
| PWM_B → 旧振子 | GPIO4 | 沿用现接线（GPIO4 实接原振子 101~175.7Hz）——**B=旧** |
| KEY1（选源循环；长按 ≥1s=手动/自动切换） | GPIO7 | INPUT_PULLUP，按下 LOW，另一端 GND |
| KEY2（跳默认；自动模式=切周期档） | GPIO10 | 同上 |
| KEY3（占空比 +5） | GPIO0 | 同上 |
| KEY4（占空比 -5） | GPIO1 | 同上 |
| 板载 LED | GPIO8 | 低电平点亮（沿用 config.h LED_PIN=8） |

按键均不需外部电阻（内部上拉）。GPIO5/6 空出不用。

## 按键功能规格（经人类确认，四轮演变后最终版）

| 键 | 功能 | 细节 |
|---|---|---|
| KEY1 短按 | 三态循环选源 | 按 1→新振子开（旧关），按 2→旧振子开（新关），按 3→全关，按 4→回到新振子，无限循环。三态：NEW / OLD / OFF |
| KEY1 长按 ≥1s | 手动/自动切换 | 手动=常开（当前振子+占空比）；自动=按当前档位启停；串口即时回显；长按触发后本按不再算短按 |
| KEY2 | 跳默认 / 切周期档 | 手动模式：跳当前振子默认占空比；自动模式：周期档循环 0.5→1→2→3→0.5Hz |
| KEY3 | 占空比 +5% | 步进 +5，0~100 夹取不回绕 |
| KEY4 | 占空比 -5% | 步进 -5，0~100 夹取不回绕 |

开机默认：手动模式、OFF 态、占空比 0。

### 默认值登记（人类接线后实测填）

- 新振子（GPIO3）默认占空比：**待填**（建议 70% 起步，以「vibmon 可稳定检出 ct=1」为准）
- 旧振子（GPIO4）默认占空比：**待填**（同上）

## 串口状态输出（沿用现有模式，小幅扩展）

- 波特率 115200（config.h SERIAL_BAUD 不变）；命令行 a/b/0-9/h/p/+/-/s/x/T0-3/z/q/? **原样保留**；
- 每次按键操作后走与串口命令相同的 printStatus 路径（一行两通道状态 + 当前选中），**另加两行：模式（手动/自动+档位）**，格式规整便于脚本 parse；
- 按键与串口命令并存互不干扰：按键改状态后串口 q 查询应一致（同一状态机，两条入口）。

## 现成代码底子（flash 在 vibsource_esp32_dual 上做增量，禁止推倒重写）

源：Desktop\STM32project\vibsource_esp32_dual\vibsource_esp32_dual.ino（278 行）+ config.h（75 行）。**全部可直接复用**：
- 双路 LEDC PWM（ledcAttach GPIO3/4，20kHz/10bit，config.h:28-30）；
- 「踢一脚」启动（0→非0 先 100%/200ms，KICK_DUTY/KICK_MS config.h:49-51；55% 低于马达启动门槛 ~74% 不踢起不来）；
- 四档周期表（CYCLE_TABLE config.h:61-66：0.5Hz=1000/1000、1Hz=500/500、2Hz=250/250、3Hz=167/166ms，照抄）；
- 自动通断 ON 占空比固定 85%（CYCLE_ON_DUTY config.h:57）+ 每拍 80ms 小踢（CYCLE_KICK_MS）——**决策：不与手动设定联动**（启停考 SS 读数，保证振动强度）；
- 占空比换算四舍五入（.ino:59 `((duty*MAX)+50)/100`）、LED 运行指示（.ino:272-275：运行=亮，空闲=500ms 心跳闪）、printStatus/printHelp、cycleStart/cycleStop/cycleTick。

按键映射到现有命令语义：KEY1 短按≈a/b/z 三态循环（注意：现有 a/b 只是选通道不停对方，**新固件按三态语义实现：切源即停另一路**）；KEY1 长按≈T（停通断）/恢复自动；KEY2 手动≈p（跳默认，PRESET_DUTY 改为各振子独立默认值）；KEY2 自动≈T0→T1→T2→T3 循环；KEY3/KEY4≈+/-。

## 实现约束（flash 写代码遵守）

1. **flash 写码 + 协助交结果；人类实测**——一次给可烧的完整工程，不让人读代码调 bug；
2. 工具链：Arduino IDE + ESP32 core（与 vibmon_v5 相同），**无新库依赖**；
3. 新工程目录：`Desktop\STM32project\vibsource_c3_key\`（与 vibsource_esp32_dual 并列；**不动 vibsource_esp32_dual 原文件**，拷贝后增量改）；
4. 按键消抖必须做（10~20ms 采样/计数）；长按检测与短按互斥（松手判定：按住超时=长按已触发，本按不再算短按）；
5. NEW/OLD 互斥：切源即停另一路（三态语义，覆盖原 a/b 只选不停的行为）；
6. 占空比 0~100 一律夹取；
7. 自动模式期间 KEY3/KEY4 调的是**手动模式记忆值**（自动 ON 固定 85% 不受影响，切回手动即用新值）；KEY1 短按切源下一拍生效；
8. **任务 A（驱动部分）不改 vibmon_v5 侧任何代码**——验收时查 sketch 源码时间戳；也不改 vibsource_esp32_dual 原工程。（任务 B 豁免范围见文末补充节：仅 config.h / state.cpp / test\contact_test.cpp / output.cpp 的 #if 门控部分）

## 验收标准（规划模型执行，人类实测数据交回后）

1. **KEY1 三态循环**：短按 4 次依次 NEW→OLD→OFF→NEW（串口状态行复核）；
2. **KEY1 长按切模式**：手动↔自动切换串口即时回显；自动模式下状态行显示当前档位；
3. **KEY2 跳默认**：两振子各自默认值一次跳中，与登记值一致（串口显示）；
4. **KEY3/KEY4 步进**：±5 单步精确，0/100 夹取不回绕（串口显示）；
5. **手动模式**：常开输出（vibmon $VD 帧 VIB=1 恒定佐证）；
6. **自动模式四档**：0.5/1/2/3Hz 各档切换生效——**vibmon $VD 帧 SS 字段佐证**（对齐 T008 P3 先例：1Hz 档 SS 应读 ~1.00，四档各测 ≥20s）；
7. **按键与串口一致性**：按键改状态后串口 q 查询一致；串口命令改状态后按键行为正确（同一状态机）；
8. **任务 A 零改动**：vibsource_esp32_dual 目录文件时间戳不变；vibmon_v5 中任务 B 豁免范围之外的源码时间戳不变；
9. RT009 记录（flash 协助人类写）：工具链、引脚分配表、默认值登记、四档 SS 实测数据、串口状态样例誊录，全部署名。

## 补充任务 B —— 启停 CT 保持门控（vibmon_v5 侧，CT_HOLD_ENABLE 默认 0）

> **背景**：1Hz 自动启停夹持全程 CT 每拍闪 1/0（占空比 ≈55~70%，T008 P3 s3 同场景 ct=55%）。机理：CT 是证据驱动（姿态+幅值+频率、CT_CONFIRM_MS=100ms 确认），OFF 段振动证据消失 CT 掉 0；SS 是事件驱动边沿间保持，所以 SS 恒 100 而 CT 闪。单 MPU6050 在 OFF 段无法区分静态夹持与空手（T003 六年调研无历届考核）——只能靠「闭合姿态 + 近期振动证据」的推理链延长。
> **决策**：三选项（A 不改 / B 直接改 / C 门控默认关）人类 2026-11-04 23:55 选 **C**（m01247）；2026-11-05 00:00 人类指示不开新卡、并入本卡执行（m01268），原拟 T010 卡已撤销。

### 目标（任务 B）

启停（周期性振动 ON/OFF）场景下，**夹持姿态未打开时让 CT 在 OFF 段保持 1**；编译期宏 `CT_HOLD_ENABLE` 门控，**默认 0，出发固件与现状逐字节一致**；开宏版作赛场备选固件赛前编译烧录测一遍，现场按平台要求决定带哪个（COMP_FRAME_CL 同款先例）。

### 涉及文件（任务 B 唯一豁免范围，其余 vibmon 文件仍禁改）

- `config.h`（新增宏 + 编译期断言）
- `state.cpp`（`combineContact` 保持分支 + 最近证据时间戳维护）
- `test\contact_test.cpp`（新增开宏用例，宏=0 时用例不生效）
- `output.cpp` **只允许**在 `#if CT_HOLD_ENABLE` 下给 D 命令 DUMP 加辅助列（默认构建 D 行一个字节不能变）
- **禁止**：`mpu.*`、`sampler.*`、$VD 帧格式（35 字节不变，hold 状态不上帧）、`posture.*`

### 改动规格（行为契约，具体落点 flash 定）

1. `config.h`：`#define CT_HOLD_ENABLE 0`（默认关；现场开=一行改 1 重烧）；`#define CT_HOLD_MS 1200`（覆盖 0.5Hz 档 OFF 段 1000ms+余量；平台 OFF 段更长则现场调此宏）；编译期断言 `CT_HOLD_MS > CT_CONFIRM_MS`、且仅在 CT_HOLD_ENABLE=1 时约束 CT_HOLD_MS 合法。
2. `state.cpp` `combineContact` 保持分支：维护「最近一次 `(ampEff || freqEff)` 为真」时间戳（lastEvidence）；保持条件由 `postureOk && (ampEff || freqEff)` 扩展为 `postureOk && (ampEff || freqEff || holdOk)`，`holdOk = CT_HOLD_ENABLE && (now - lastEvidence) <= CT_HOLD_MS`。**进入条件不变**（三路全真）——hold 只延长保持，不放宽进入。**姿态路是安全边界不许动**：`!postureOk`（松手/角度打开）仍走原有退出+100ms 确认，hold 不得在姿态打开后续命；数据失效（I2C 掉线）致 postureOk=false 同理立即退出。
3. D 命令 DUMP（仅 `#if CT_HOLD_ENABLE`）：追加两列 `holdOk`、`msSinceEvidence` 供实板验证。

### 验收标准（任务 B 专用）

- [ ] 1. config.h 宏与断言按规格落地，默认 `CT_HOLD_ENABLE=0`
- [ ] 2. **默认构建零变化**：全部既有宿主测试（contact/gyro/comp_frame/dump）结果与改动前一致；默认构建 .hex/.bin 哈希与改动前对比（工具链若无法逐字节一致，须给差异审查说明 + 全测试一致证明）
- [ ] 3. 开宏构建宿主新用例通过：H1 证据消失+姿态闭合→CT 保持至 CT_HOLD_MS 到期才掉 0；H2 保持期内证据刷新→CT 持续 1；H3 保持期内角度打开→CT ≤CT_CONFIRM_MS 掉 0；H4 宏=0 时行为与现状一致
- [ ] 4. 双 FQBN 编译 0 warning（宏 0/1 两个配置都编）
- [ ] 5. 实板（开宏烧录）：1Hz 自动启停夹持 ≥30s **CT 连续=1 占比 ≥95%**（基线 55%）；0.5Hz 档（OFF 1s）CT 不掉
- [ ] 6. 实板（开宏）：夹持中松手→CT 掉 0 ≤0.2s
- [ ] 7. 实板（开宏）：单次关源退出时间**如实记录**（预期 ≈1.2s vs 默认构建 0.42s），作现场决策依据
- [ ] 8. **测完烧回默认构建**，RT 写明烧了什么/烧回什么/当时验证帧
- [ ] 9. RT 附「现场决策两行表」：平台启停段查 CT 持续→带开宏固件；平台查关源快速退出/严格证据语义→带默认固件

### 数据要求（任务 B，并入 RT009 或续写新日期 RT 均可，须标注任务 B）

- 宿主测试两套输出（宏=0 全量回归 + 宏=1 新用例），注明命令与用例数
- 改动前后默认构建产物哈希对比
- `data\t009b_YYYYMMDD\`（或 t010 命名亦可）：开宏实板段 CSV（1Hz 启停 ≥30s、0.5Hz ≥30s、松手段、单次关源段）+ summary
- CT 占比统计、退出时间表（关源/松手 × 两构建）、烧录流水、验收标准 9 条逐条对照、署名

### 纪律（任务 B）

- 默认构建一个字节都不能变行为——这是 C 方案的全部价值，破坏等同返工
- 数据难看如实记（关源退出 ≈1.2s 不是失败，是两固件取舍的证据）
- 署名制（AGENTS.md §4 第 8 条）

### 补充修订 B-2 —— 启停档 CT 进入门放宽（2026-11-05 21:50 追加，人类 m01717 指示；宏 CT_HOLD_ENABLE=1 时生效）

> **背景**：任务 B（hold 1200ms）已解决 OFF 段保持（0.5/1Hz 实测 CT 连续，21:20 条验收 5 通过），但 2/3Hz 档仍 CT=0——卡在**进入门**：ON 窗 250/167ms 内 ERM（起振时间常数 ~100ms）只建到 amp 300~430/160~350mg，过不了 CT_FLAT_A_ON_MG=400mg。人类裁定（m01717）：**400mg 是自定标定参数不是物理常数，应当调**。
> **设计定位**：与 hold 同宏绑定（CT_HOLD_ENABLE=1 时一并生效），默认构建仍逐字节一致；进入门放宽与 hold 保持互补——hold 解决「进得去后 OFF 段不掉」，B-2 解决「进得去」。

#### 改动规格（B-2，全部在任务 B 已豁免的 4 个文件内，不新增豁免）

1. `config.h`：`#if CT_HOLD_ENABLE` 下门限取值放宽——进入幅值门 `CT_FLAT_A_ON_MG` 400→**250**、保持幅值门 `CT_FLAT_A_OFF_MG` 300→**180**（保 70mg 滞回带）；确认时间 `CT_CONFIRM_MS` 100→**60ms**（进入/退出确认一并）。宏=0 时三个值与现状完全一致。
2. `state.cpp`：门限/确认时间的取值处按宏切换（实现机制 flash 定：#if 或条件表达式均可）；**姿态路、频率门（F_ON=75/F_OFF=63Hz）、hold 判据与姿态安全边界一律不动**。
3. `test\contact_test.cpp` 新增用例（仅宏=1 编译）：R1 amp=300mg+freq=100Hz+姿态闭合持续 ≥60ms → CT=1（现行 400 门应拒此输入）；R2 amp=26mg（空握瞬态级）+freq=190Hz → CT=0；R3 amp=200mg+freq 有效+姿态闭合 → CT=0（低于 250 门）；R4 amp=260/180mg 滞回带行为记档（R4 只记档不设硬门槛）。既有 H1~H4 用例回归不受影响。

#### 数值依据与安全余量

- **A2 空握**：瞬态 9~26mg，对 250 门有 ~10 倍余量，R2 用例锁定。
- **2Hz 档**（amp 300~430mg）：放宽后 ON 窗内大部分时间过门，60ms 确认 @50Hz=3 帧可达 → 预期每拍进入，hold 1200ms 覆盖 OFF 250ms → CT 连续。
- **3Hz 档**（amp 160~350mg）：上坡段过门约 60~100ms，进入为边缘事件；若实测覆盖率 <95%，允许微调第二档 **200/150/50ms** 复测一轮（R2/R3 安全用例必须仍过）。
- **正向副作用**：5 号场景旧振子 96~99Hz/约 300mg 平台段将进入 CT（82.1% → 预期 ~100%），并顺带覆盖 T010 预案⑦「平台件 <400mg」场景。
- **已知暴露（RT 记档）**：移动瞬态（124~199Hz）在现行 400 门下已会过门 0.68s，放宽后 180~400mg 段新增过门窗口略增——赛场模块静止不触发，不构成回归阻塞。

#### 验收（B-2 追加）

- [ ] B2-1 宏=0 默认构建：全部既有测试通过 + 产物与任务 B 交付时逐字节一致（或差异审查说明+全测试一致）
- [ ] B2-2 宏=1 宿主用例：R1~R4 + H1~H4 全过，双 FQBN 0 warning
- [ ] B2-3 实板（宏开）：**2Hz 档 CT 连续占比 ≥95%**（基线：6.1 新振子 35/38、6.2 旧振子 0/18）
- [ ] B2-4 实板（宏开）：**3Hz 档 CT 连续占比 ≥95%**（基线 0）；不达 → 按 200/150/50ms 复测一轮；两轮均不达 → 如实记录 + 启用驱动侧备选（下条）
- [ ] B2-5 回归：0.5/1Hz 档 CT 保持不劣化；A1 松手 CT 掉 0 ≤0.2s；A2 空握 0 误报；关源退出时间如实记（60ms 确认下 hold 到期 ~1.2s 量级不变）
- [ ] B2-6 RT「现场决策两行表」升级三行：平台查 CT 启停持续 → 默认带 hold+B-2 版；平台查严格证据语义/关源快速退出 → 默认版；两版 hex 存档并列
- **驱动侧备选（仅当 B2-4 两轮不达才启用，属自测设备不涉比赛判据）**：`vibsource_esp32_dual\config.h` CYCLE_TABLE 非对称占空比——2Hz 档 ON 400/OFF 100、3Hz 档 ON 250/OFF 83（周期不变保 SS 读数），改前先验证 OFF 段包络能跌破 SS_LO=150mg 保边沿存活。

#### 数据要求（B-2，并入 RT 或新日期 RT，标注任务 B-2）

- 宿主 R1~R4 输出 + 宏=0 回归对照；默认构建产物哈希对比
- 实板 2/3Hz 档各 ≥30s：CT 连续占比、进入帧证据链（amp/freq/ct 三列）、若调第二档两轮对照
- data\t009c_YYYYMMDD\ 落盘 + 署名

## 完成记录

（人类实测 + flash 协助交卷后由规划模型验收填写：署名 + 达标 / 返工 + 一句话依据）

**2026-11-05 21:50 · glm5.3 (PLANNER-B)：追加补充修订 B-2（进入门放宽）并派发。** 依据人类 m01717「行就是行，不行就是不行，语义和合理为什么不思考完善代码」——PLANNER-B 接受批评：21:20 条把 2/3Hz CT=0 定性为「物理不可达、备答辩口径」是错误立场，400mg 进入门是自定标定参数不是物理常数。根因链：hold 已解决 OFF 段保持（0.5/1Hz 验收 5 通过），遗留卡在**进入门**——2/3Hz ON 窗 250/167ms 内 ERM 只建到 300~430/160~350mg 过不了 400mg。B-2 规格：宏开时进入门 400→250、保持门 300→180（滞回带 70mg 保留）、确认 100→60ms；空握 9~26mg 对 250 门 10 倍余量（R2 用例锁定）；3Hz 不达准可降第二档 200/150/50ms；驱动侧非对称占空比（dual CYCLE_TABLE）作末位备选。改动全在任务 B 已豁免 4 文件内，默认构建仍逐字节一致。待 flash 实现后实板复测 2/3Hz CT 连续占比 ≥95%（B2-3/B2-4）。

**2026-11-05 21:20 · glm5.3 (PLANNER-B) —— 6.1/6.2 四档复测独立复算：任务 B（CT_HOLD）实板验收通过；「SS 全 000」确认为 PLANNER-B 解析 bug（幸存者偏差），固件无此问题；唯一遗留=2/3Hz 档 CT=0，定性为 ERM 物理起振时间限制，非 bug。**

- 数据：单测\6.1.txt（新振子四档，17:51~18:07）+ 6.2.txt（旧振子四档，18:06~18:09）。采集配置：驱动板=c3_key 带双重踢版（dual 未及烧回）、检测板=hold 开宏版（m01493 D 命令自证）。
- **勘误（PLANNER-B 自纠）**：b25/17:05 条所记「6.txt SS 均值 0.50/1.00/1.99/2.94 全准」当时实为 vib 边沿推算值；随后 _p61/_p62 脚本报「SS 域全 000」亦错——根因是 VALID/CHK 域为十六进制（9/B/D/F），旧正则 (\d+) 把 VAL=B/D/F（SS 非零）的帧全部丢弃，幸存者偏差。_p63（VAL 分布+SEQ 捕获率 100%）+ _p64（正则 [0-9A-F]+）复算为准。
- **SS 四档读数全准**（任务 A 相关验收）：0.5Hz→0.50~0.52、1Hz→1.00、2Hz→1.99~2.02、3Hz→2.90~2.96（新旧振子一致）；SS=000 帧为锁定/超时呼吸（OFF 后 2×周期超时清、下拍重锁），SS 非零帧率 24%~83%，读数出现时无一错档。旧振子 1Hz 档非零率 24% 偏低（周期 1s vs 超时窗 2s 临界横跳），读数本身仍准。
- **hold 生效铁证（任务 B 验收 5 通过）**：0.5/1Hz 段 OFF 相位（amp 5~9mg、vib=0）CT=1 保持（6.1 SEQ2013~2030 连续段；6.2 18:08:48 SEQ2067 CT=1 amp 261→438 爬升）。CT 不再每拍闪 1/0，且 SS+ 帧跨 OFF 段保持。
- **2/3Hz 档 CT=0 唯一遗留，定性物理**：ON 窗 250/167ms 内 ERM（起振时间常数 ~100ms）只建到 amp 300~430/160~350mg，未过 CT_FLAT_A_ON_MG=400 进入门。CT during vib-on：6.1 2Hz 35/38、3Hz 0/31；6.2 2Hz 0/18、3Hz 0/62。**判据无罪、检测板无罪**——赛题启停考核点=SS 读数（已全准），CT 语义=接触（绑定持续振动证据，2/3Hz 高频通断下 CT 低占空比是如实表达）。答辩口径：读数忠实反映物理，3Hz 档 167ms 通电窗在 400mg 判据下数学上不可达，若平台质疑可现场用 1Hz 档演示 CT 保持。
- 振动建立 amp 指纹（ON 相位）：0.5Hz ~500mg、1Hz ~620mg、2Hz 300~430mg、3Hz 160~350mg。
- 剩余待办收窄为：①驱动板烧回 dual 原版（vibsource_esp32_dual.ino Upload，可选——c3_key 版四档 SS 已证准，烧回只为去掉双重踢对 2/3Hz amp 的影响+回归定案口径）②测后检测板烧回默认构建（config.h CT_HOLD_ENABLE 改回 0，默认版出发）③可选：dual 原版下复测 2/3Hz 档 amp（双重踢消除后 ON 段全程 85% 稳定驱动，amp 应上探更高）。

**2026-11-04 23:25 · glm5.3 (PLANNER-B) —— 阶段 1 验收：达标（带 1 个待修 bug），卡转 doing**

- flash 已交 RT009-20261104.md（阶段 1 可烧工程 + 编译 0 警，及阶段 2~4 数据：COM3 直读 1141 帧 0 校验错、测试1.txt 7430 帧、测试2.txt 4835 帧解读）；RT009-20261103.md（C8T6+OLED 旧方案）已由 flash 声明作废。
- 独立复核通过：①源码逐条对卡（引脚 KEY1=GPIO7/KEY2=GPIO10/KEY3=GPIO0/KEY4=GPIO1、消抖 15ms、长按 1000ms 且长短按互斥、三态切源即停另一路、KEY2 手动跳默认/自动切档双语义、±5 夹取 0~100、自动模式 KEY3/4 只改手动记忆值、自动 ON 固定 85%、四档周期表照抄、串口命令全套保留、printStatus 补 [SRC]/[MODE] 行）；②零改动经时间戳核实（dual 源文件停在 11-02 21:29、vibmon_v5 全源码 ≤11-02；dual\build 目录 11-04 有变动属构建产物，源码零改动结论成立）；③测试2.txt 逐帧复核：4835 帧、SEQ 4131/4141/4146/4150/4156/4162 六帧证据链逐帧对上、尾部 800 帧 SS 全 100（1Hz 档精确）；④data\t009_20261104\ 文件与 RT 叙述一致（含 0 字节失败采集留痕）。
- **发现 bug（RT 未报，PLANNER-B 代码审查发现）：自动模式 OFF→ON 双重踢一脚**——autoTick 显式踢 80ms（CYCLE_KICK_MS）后调 setOut()，setOut 检测 g_out==0→d>0 又触发第二次踢（KICK_DUTY=100% + KICK_MS=200ms），合计 280ms 满压。原 dual 固件 cycleTick 只踢 80ms 一次（直接 pwmWrite 不走 setDuty）。后果：1Hz 档正常（ON=500ms，测试2 SS=1.00 已证），**2Hz 档实际 ~1.9Hz、3Hz 档实际 ~2.24Hz**（ON 周期 250/167ms < 280ms 整拍被踢占满），验收标准第 6 条（四档 SS 佐证）2/3Hz 档会不过。修法：autoTick 的 OFF→ON 分支照原版直接 `pwmWrite(src, CYCLE_ON_DUTY)` 不走 setOut（或给 setOut 加跳过踢一脚的入口）。
- 小瑕疵（不阻塞）：串口 T0~T3 命令 setMode(MODE_AUTO)+autoStart 连调两次多一次 200ms 启动踢；阶段 2 记录 BROWNOUT_RST×1 + POWERON×3——满压踢时供电跌，现场避免弱 USB 口供电。
- 阶段 4 的 CT 语义发现（自动启停 OFF 段 CT 掉 0）经逐帧复核属实，**定性为设计行为非 bug**：CT=姿态+振动证据（OFF 段无证据 100ms 后退出），CL 字段才表达「夹着」；T008 P3 同场景先例 ct=55%。是否改 vibmon 判据为规划决策，PLANNER-B 立场：**赛前不改**（启停考核点在 SS/VIB 读数，测试2 已证 SS=1.00；3 天内动 state.cpp 有回归风险）。
- 转 done 前必须：①修双重踢 bug 重烧；②人类按键实测回传（三态×4 / 长按切模式 / 跳默认 / 切档 / ±5 夹取 / 四档 SS 各 ≥20s）；③登记两振子默认占空比（现占位 A=70/B=100，以「vibmon 稳定检出 ct=1」为准）；④补充任务 B 九条验收（默认构建零变化 + 开宏版实板数据）。

**2026-11-05 09:45 · glm5.3 (PLANNER-B)：按人类指示（m01349「不对应该写成T010，先把所有可能更改的东西列出来，然后每个至少给出3种情况参考」）撤销 09:40 并入的「补充任务 C」，LED 预案移入独立新卡 T010（现场适配预案清单卡，含全部现场可能更改项 ×每项 ≥3 种情况参考）。09:40 的并入记录保留作历史，以本条为准。T009 范围恢复为任务 A + 任务 B。**

**2026-11-05 00:03 · glm5.3 (PLANNER-B)：按人类指示（m01268「不需要开新卡，继续在T009补充就行」）撤销独立 T010 卡，其全部规格并入本卡为「补充任务 B」节；实现约束 #8 与验收标准 #8 的「零改动」范围改写为仅约束任务 A（驱动部分），任务 B 豁免范围以补充节所列为限。原 规划\tasks\T010-启停CT保持门控.md 文件已删除。**

**2026-11-05 18:05 · glm5.3 (PLANNER-B)：按人类指示（m01501「不行，这个太乱了，不如 vibsource_esp32_dual」）——任务 A 最终定案：弃 vibsource_c3_key 固件，驱动板回归 vibsource_esp32_dual 原版（零改动）。人类 18:04 补充（m01509）：按键未接线的另一个原因是命令大小写区分问题当时没摸清，现已会用，串口命令操作顺畅。**

- 结案依据：按键硬件从未接线（m01497「没有按键，只有串口」），c3_key 的增量价值（4 按键 + 各振子独立默认 + 三态切源）均无法实测也无现场用途；dual 原版串口命令齐全（a/b/0-9/p/+/-/T0~T3/z/q，大小写敏感），采集脚本零适配，且**双重踢 bug 为 c3_key 引入（autoTick 走 setOut），dual 原版 cycleTick 只踢一次 80ms，四档天然正常**。
- 处置：vibsource_c3_key 工程（含 11-05 双重踢修复）保留存档不删除；如赛前改变主意要按键，5 分钟接线后烧 `_probe\t009\build_uart\`（SHA-256 d49b1737…）即可。
- 任务 A 验收口径改写：①驱动板烧 dual 原版（Arduino IDE 打开 vibsource_esp32_dual.ino Upload）②四档启停 T0~T3 各 ≥20s 用 $VD SS 佐证（重点 2/3Hz 档 amp 应显著高于 205/127mg）③原验收 1~4/7（按键项）与「三态切源」「独立默认占空比」随方案放弃，标记"已实现未实测（无硬件）"④默认占空比登记项取消（dual 的 PRESET_DUTY=55 单值沿用）。
- 任务 B 不受影响：检测板 hold 开宏版已烧并自证（D 命令 holdOk/msSinceEvidence 列，m01493）。四档复测同时验证任务 B 验收 5（启停 CT 连续 ≥95%）。
- 复测清单（纯串口、dual 原版，命令大小写敏感）：a/b 选路、z 全关、p 跳 55、+/- 调占空比、T0~T3 四档各 ≥20s；检测板同步抓 $VD。测完检测板烧回默认构建（config.h CT_HOLD_ENABLE 改回 0）。

**2026-11-05 17:05 · glm5.3 (PLANNER-B) —— 单测 1~6 独立验收 + RT009-20261105 复核：代码与构建全部就绪，但本轮实板数据均采自旧固件，任务 A 修复版与任务 B hold 版都还没上过板。卡仍 doing。**

一、RT009-20261105.md（flash 16:52 交）复核通过：任务 A 双重踢修复（autoTick OFF→ON 只保留 80ms 小踢+直接 pwmWrite，T0~T3 去双启动）与任务 B CT_HOLD 门控（默认 0、CT_HOLD_MS=1200、姿态打开立即清 hold、H1/H2/H3 宿主用例）实现与卡规格一致；宿主测试默认 46/46、开宏 56/56、dump_hold_probe 5/5；默认构建剔除 ELF SHA/编译时间/镜像摘要后逐字节一致；hold 产物经 PLANNER-B 实证确为宏开（build.options.json 带 `-DCT_HOLD_ENABLE=1`，elf 字符串含 DUMP 表头 `holdOk,msSinceEvidence`）。

二、单测 1~6（人类 15:30~16:45 采，PLANNER-B 逐帧独立复核约 5.7 万帧）判决：
- 1 平放移动：CT 尖峰 35 帧/0.68s（移动瞬态 124~199Hz 过门），非 bug；赛场静止测试不触发，备答辩口径。
- 2 空握：CT=0 零误报 ✅。
- 3 夹不动物（不同大小）：CT=0 **是预期语义非异常**——接触判定绑定振动证据，CL=1/CT=0 正是设计（T003 六年调研背书）。**纠正 RT「异常与未解决项」第 191 行将 3 号当疑点的误判**。
- 4 新振子多占空比：证据帧（>60Hz 且 >100mg）CT=97.6%，最长连续 CT=1 达 3013 帧/60.3s ✅ 优。
- 5 旧振子：证据帧 CT=82.1%；中段 96~99Hz/约 300mg 平台未过 400mg 进入门如实不判，非 bug。
- 6 启停四档：SS 均值 0.50/1.00/1.99/2.94 全准，但 CT=34.3%/37.5%/**0%/0%**——2/3Hz 档振动从未建立（amp p50 仅 205/127mg）。

三、**固件版本裁定（核心结论）**：本轮实板两块板烧的都还是旧固件——检测板 CT 在 vib 1→0 边沿后 100~120ms 掉 0（=CT_CONFIRM_MS 默认行为；hold 版应保持 ≥1200ms），且日志无 DUMP hold 列、无 [SRC]/[MODE] 状态行。人类自述「用的 CT_HOLD 开宏版」与数据不符，判定烧录时选错 bin（疑烧了 default_after 或更早产物）。**纠正 RT 结论 8 的过度推断**：四档 SS 对上目标档不能证明双重踢修复版已生效——SS 由启停边沿计时，与踢一脚无关，未修复版同样给准 SS；修复是否上板的指纹在 2/3Hz 档幅值（本轮 205/127mg=未修复指纹）。

四、转 done 前必须（更新）：①驱动板烧任务 A 修复 bin（`_probe\t009\build_uart\`，SHA-256 d49b1737…）②检测板烧任务 B hold bin（`_probe\t009b\build_hold_uart\`，SHA-256 ef87b296…）③烧录后自证（D 命令应输出 holdOk/msSinceEvidence 两列；驱动板 q 应回 [SRC]/[MODE] 行）④复测 6 号场景四档各 ≥20s（hold 版预期 0.5/1Hz 档 CT 显著抬升；2/3Hz 档 amp 应显著高于本轮 205/127mg）⑤按键序列实测 ⑥默认占空比登记 ⑦测后烧回默认构建。
