wmsz88/flex-vib-monitor/vibmon_v5/规划/tasks/T001-比赛帧CL字段.md

# T001 — 比赛帧增加 CL 字段（closed，配置门控）

状态: done
任务号: T001
派卡模型: glm5.3 (PLANNER-B)
来源: `大模型/评审报告_20261102.md` 建议1 + 建议2；`小模型/检验方案.md` 赛前改动清单
结果文件: （flash 完成后填：RT001-YYYYMMDD.md）

## 目标

在 `$VD` 比赛帧中增加 `CL` 字段（手指闭合状态 closed，1 位，0/1），使平台可区分「手没合 / 空握 / 合拢且有接触」三种状态；实现必须用**编译期宏门控、默认关闭**，默认构建行为与当前逐字节一致。

## 背景与上下文

- 评审报告建议1：当前 35 字节帧缺 `closed`，CT=0 时平台无法区分「松手」和「空握」
- 前提未定：现场平台是否允许帧格式变更尚不知道 → 故采用门控设计，**默认 CL 功能关闭**，现场确认可调后一行配置打开，不改代码
- 冻结约束：`CT_MODE=4`、`UART_SWAP=1`、`COMP_FRAME_ENABLED=1`、烧录 `CDCOnBoot=cdc` 不得变更
- 新帧格式（CL 开启时，35→约37字节）：
  `$VD,SEQ,FREQx10,AMP_MG,VIB,CT,CL,SSx100,VALID,CHK\r\n`（CL 插在 CT 之后）

## 涉及文件

- `config.h`（新增宏，如 `COMP_FRAME_CL`，默认 0）
- `output.cpp`（`compBuildFrame()` 增加门控的 CL 拼装）
- `output.h`（如需）
- `test/comp_frame_test.cpp`（补 CL 开启/关闭两种构建的断言）

## 验收标准

- [ ] 默认构建（CL=0）：帧格式与当前**逐字节一致**（35 字节，字段序不变），comp_frame_test 原有断言全过
- [ ] CL=1 构建：帧含 CL 字段、位置在 CT 后、XOR 校验覆盖新字段，新断言全过
- [ ] CDC 与非 CDC 双 FQBN 编译均 **0 warning**
- [ ] 宿主测试：`comp_frame_test` 全部通过（含新旧两种模式）；如改到 state 相关则加跑 `contact_test`、`gyro_test`
- [ ] 确认 `config.h` 中 `COMP_FRAME_ENABLED=1` 冻结值未被误动（原样保留）
- [ ] 结果文件 `RT001-YYYYMMDD.md` 已按模板写入 `结果/`

## 数据要求（flash 必须在结果文件中回传）

1. 两种构建各自的一帧完整样例（hex 或文本），标注字节长度
2. 双 FQBN 编译输出摘要（warning 数）
3. comp_frame_test 结果（通过数/总数，新旧模式分别列出）
4. CL=1 模式下 XOR 校验的手工验算一例（证明校验覆盖 CL）
5. `config.h` 冻结宏当前值清单（CT_MODE、UART_SWAP、COMP_FRAME_ENABLED、COMP_FRAME_CL）

## 完成记录

2026-11-02 17:10 · glm5.3 (PLANNER-B)：**达标**。PLANNER-B 独立复跑全部对上（comp_frame 22/22 + CL=1 25/25、contact 46/46、gyro 8/8，冻结宏四项原样，CL=0 与 HEAD 逐字节一致的对比证据充分）；XOR 手工验算 0x7E/0x7F 覆盖 CL 字段。遗留小项（实板 37 字节抓帧核对）归入检验阶段 P4，不构成返工。
