wmsz88/flex-vib-monitor/vibmon_v5/规划/tasks/T004-实板检验第一轮.md

# T004 — 实板检验第一轮：P0 硬件证据 + P1 核心判据 + 双振源 + T1 工单

状态: done
任务号: T004
派卡模型: glm5.3 (PLANNER-B)
来源: `小模型/检验方案.md` P0/P1 + plan.md「下一步方向」遗留项 1/2/3；人类 2026-11-02 确认硬件已修复
结果文件: （flash 完成后填：RT004-YYYYMMDD.md）

## 目标

硬件修复后的第一轮实板检验，一次性采集四组证据：P0 硬件稳定性量化证据、P1 核心判据（松手/空握/接触/退出）、4cm 方块+新旧双振源两段频带、T1 工单（抽走马达看 ct 退出），并顺带完成 A5 五轮重复性验收。

## 背景与上下文

- 人类已确认 MPU6050 I2C 焊点修复，但**必须留下量化证据**（历史掉线是 I2C错 587/读失败 505 级别的，"感觉好了"不算数）
- 测试台串口分工：COM9=检测模块（vibmon_v5，USB-CDC）；COM7=振源控制（vibsource，单字符 0~9/h/p/+/-/z/q/?，55%≈约80Hz）
- 双振源频带：原振子约 102~182Hz、新低速振子约 80~128Hz
- 实板测试模式（历史既定偏好）：**脚本后台连续采集 + 语音播报逐步提示 + 人类在提示下做动作，一轮跑完**；不掐秒表、不按回车、不固定时间表。完整做法见 `..\vib_range_test\实板测试模式.md`
- 串口命令速查见 `小模型/检验方案.md`：`S`（状态）、`w`（一行数据）、`D`（T002 新增全量 CSV，含 condPosture/condAmp/condFreq 三路）、`Q`（姿态）
- 4cm 方块 + 双振源是**最贴近比赛工况**的组合（人类定的优先项）

## 涉及文件

- 无固件代码改动预期。测试脚本与采集数据存 `_probe/` 或 `data/` 下新建 `t004_20261102\` 目录
- 若检验中发现代码问题：**不要现场改代码**，写进结果文件「异常与未解决项」，由规划侧开返工卡

## 检验项与执行顺序（一轮跑完，语音播报引导）

### 第 1 组：P0 硬件证据（修复确认）

| 编号 | 项目 | 方法 | 合格标准 |
|---|---|---|---|
| H1 | I2C 静态 | 上电标定完成后静止 60s，期间每隔 10s 采一条 `S` | 全程 I2C错=0、读失败=0、不连续=0 |
| H3 | I2C 弯折 | 模拟仿生手指弯折连续 3 分钟（语音提示节奏），期间连续采集 `w` 或 `D` | 无 `[FAULT]`、无 `传感器无响应`、I2C错=0 |

### 第 2 组：P1 核心判据 + A5 五轮重复

| 编号 | 项目 | 操作 | 合格标准 |
|---|---|---|---|
| A1 | 松手 | 张开手指静止 10s | closed=0 10/10、ct=0 10/10 |
| A2 | 空握 | 闭合不接触任何物体静止 10s | closed=1 10/10、**ct=0 10/10（不许误报）** |
| A3 | 接触(4cm+原振源) | 夹 4cm 方块、原振源激励持续 10s | closed=1、ct=1 保持率 ≥90% |
| A4 | 接触退出 | A3 进行中关振源 | ct 0.5s 内变 0 |
| **T1 工单** | 保持规则检验 | A3 稳定后**抽走振源物体但保持振源开启** | 按 §13 判读：100~300ms 掉 0 正常 / >5s 保持规则过宽（开返工卡） / 跳变查滞回 |
| A5 | 五轮重复 | A1→A2→A3(含新振源)→A4 循环 ×5 | 5/5 轮全部通过 |

### 第 3 组：双振源两段频带（A3 变体，并入五轮）

| 编号 | 振源 | 验证点 | 合格标准 |
|---|---|---|---|
| B-orig | 原振子（102~182Hz） | 4cm 方块夹持，中高频段激励 | ct=1 稳定、F 读数与振源频率一致（±5Hz） |
| B-new | 新低速振子（80~128Hz） | 同上，低频段激励 | 同上 |

### 第 4 组：D 命令 + CL 帧实板顺带验证

- 空握与接触场景各敲一次 `D`，抓取实际输出行（补 T002 遗留的实板验证）
- 若当前烧录为默认构建（CL=0）：用串口助手抓 10 帧确认 35 字节格式正常（补 T001 遗留）；无需重烧 CL=1 版

### 第 5 组：边界频率端点抽样（历史缺口补测）

| 编号 | 振源档位 | 验证点 | 合格标准 |
|---|---|---|---|
| E-80 | 新低速振子最低档（≈80Hz） | 4cm 方块夹持，赛题下限端点 | F 读数 80±5Hz、ct=1 |
| E-180 | 原振子最高档（≈182Hz） | 同上，赛题上限端点 | F 读数 180±5Hz、ct=1 |
| E-mid | 90Hz 与 165Hz 各一档（回归） | 历史待补回归点 | F 读数 ±5Hz |

> 背景：现有实板实证只有 157.8~179Hz 与 165~167Hz，80Hz 与 180Hz 端点从未抽样（共享记忆「未完成的验收项」明示）。

## 本卡专用注意事项（来自项目实测记忆，flash 必读）

1. **测前采 START 基线**：每个测试 session 开始前按 `P` 采基线，动作顺序 START→FINISH→HONGEST→START；P 命令有防呆（闭合角>8° 或姿态偏差超限会被拒绝），被拒绝时让人类回到张开平放位再按，**不要绕过**。
2. **空握与夹物的终角只差 11~24°**（空握 111°、夹 4cm 方块 100°，机械重复性/装贴所限）：两者 `closed` 都会是 1，**区分完全靠幅值门（>400mg）**。若 A2 空握出现 ct=1 误报，第一嫌疑是装贴/机械状态变化，不要现场调阈值——记录数据即可。
3. **幅值门才是真正把关者**：空夹假频 86~169Hz 与真接触主频 157.8~179Hz 频段重叠，频率门单独区分不了；分析数据时按「幅值证据优先」判读。
4. 检验中 `[MPU] 无应答(寄存器 0x75)` 或 I2C 错误重现 ⇒ 如实记录并中止该轮，等待人类检查连接；不要反复重烧尝试"恢复"。

## 验收标准

- [ ] H1：静止 60s 全程 I2C错=0（逐条 `S` 记录为证）
- [ ] H3：弯折 3min 无 FAULT 无掉线
- [ ] A1/A2：松手与空握均零误报（ct=0 逐秒记录）
- [ ] A3/A4：接触保持率 ≥90%、关源退出 ≤0.5s
- [ ] T1：抽走物体后 ct 退出时间记录在案（按三档判读归档）
- [ ] A5：五轮全部通过（这是历史从未通过的项，本轮重点）
- [ ] 双振源：B-orig、B-new 各至少一轮稳定 ct=1 + F 读数对上
- [ ] D 命令实板输出样例已抓取
- [ ] 全部原始数据（CSV）留存 `data\t004_20261102\`，结果文件按模板写入 `结果/RT004-*.md`

## 数据要求（flash 必须在结果文件中回传）

1. H1/H3 的 `S` 输出全文或关键摘录（I2C错/读失败/不连续计数）
2. A1~A5 每项的逐秒 ct/closed 序列（或 D 命令行序列）
3. T1 工单：抽走物体动作时间点 + ct 翻转时间点 + 差值
4. 双振源各自的 F 读数与 ct 保持率
5. D 命令实板输出 2 行样例（空握 + 接触）
6. 边界端点 E-80/E-180 与 90/165Hz 回归的 F 读数、ct 状态
7. START 基线采集情况（每 session 是否成功采基线、有无被 P 防呆拒绝）
8. 全部异常/中断/重测情况的如实记录（哪怕数据不好看）

## 完成记录

2026-11-02 22:46 · glm5.3 (PLANNER-B)：**达标（带 3 项记录在案的缺项），转 done**。独立复核通过：H1/H3 段内读失败与 I2C错增量逐快照核验为 0；A1/A2 五轮零误报、A3 五轮 9/10、A4 首个 ct=0 逐条定位 0.42~0.43s；A5 五轮重复 5/5 为**历史首次通关**；双振源两段 11/12 与 F 读数复核一致；D 命令实板样例在 raw 中存在。缺项（并入下卡补测，不返工）：① 第 5 组 E-80/E-180 边界端点整组未测；② D 命令缺接触场景样例（交了张开+空握）；③ START 基线未采集未回传（实测影响小，closed/ct/condPosture 判读全正常）。

**验收方补充发现（RT004 未报）**：dual 段关源后 4s 内 ct 全程保持 1（幅值中位仅 7~9mg）——与 T1 锁存同根源、更极端，作为退出行为诊断卡的关键证据。

**【2026-11-02 23:10 勘误 · glm5.3 (PLANNER-B)】**上一条"验收方补充发现"是**误读**：复核原始行，`dual_orig_off`/`dual_new_off` 首行（t=0.00）ct=1 是关源瞬间的残留，**0.64~0.65s 起 ct 即为 0**（后续 7 行全 0，A 5~14mg）。当时把统计输出"ct1=1/8"误读成"全程保持 1"，A 中位 7~9mg 是退出后各行的中位。该段实为**正常快速退出**，不是锁存证据。三份"锁存"证据实际只有 T1（抽走物体但振源仍开）一份成立——T005/RT005 已实测复核。据此修正：退出行为诊断的证据基础 = T1 一例 + A4 耗时 0.42s（含 100ms 确认延时，属正常耗时非锁存）。

**T1 工单归档**：按 §13 三档判读落在「跳变查滞回 + >5s 保持过宽」交界（1.7s 掉 0 → 3.2s 跳回 → 锁存 ≈6s 至窗口尾）→ 触发退出行为诊断新卡（T005）。
