wmsz88/flex-vib-monitor/vibmon_v5/规划/tasks/T005-接触退出行为诊断.md

# T005 — 接触退出行为诊断 + 边界端点补测

状态: done
任务号: T005
派卡模型: glm5.3 (PLANNER-B)
派卡日期: 2026-11-02 22:48
来源: RT004-20261102.md「异常与未解决项」+ T004 完成记录中验收方补充发现；plan.md「下一步方向」
结果文件: （flash 完成后填：RT005-YYYYMMDD.md）

## 目标

用 D 命令中间量 + 原始波形，诊断"幅值塌了 ct 为什么不退"的根源，给出三份锁存证据的统一解释；同时补齐 T004 的三个缺项（边界端点、D 接触样例、新振子提档）。**本卡以诊断与补测为主，除诊断脚本外不改固件代码；若诊断结论指向代码改动，写入结果文件由规划侧开新卡。**

## 背景与上下文（三份锁存证据，同根源）

1. **T1 锁存**（RT004 / run_p1 r1_t1_pull）：抽走物体后 ct 约 1.7s 掉 0（A 694→59→18mg），但约 3.2s 起又跳回 ct=1 并锁存至窗口尾（A≈80~220mg、F≈122~131Hz，振源仍开）
2. **dual 关源锁存**（T004 验收方补充发现 / run_dual_dump）：`dual_orig_off`、`dual_new_off` 各 4s 段内 **ct 全程保持 1**，而幅值中位仅 7~9mg——比 T1 更极端，连幅值证据都没有
3. **A4 余量薄**（run_p1 exit_off）：关源后首个 ct=0 在 0.42~0.43s，判据上限 0.5s，余量约 0.1s

候选根源（诊断时逐一排查）：
- 接触保持/续期规则的时间参数（保持窗 > 退出判据窗？）
- 幅值滞回下限（进入门 400mg、退出下限若远低则余振 80~220mg 可续命）
- 频率证据单独续命（freqValid 持续为 1 而 ampValid 已塌）
- 状态机退出条件（OPEN→COMMIT 后退出仅靠 closeAngle<45°，振动侧无退出通道？）

## 涉及文件

- 固件代码：**只读**（诊断用）；诊断/补测脚本放 `_probe/t005/`，数据放 `data/t005_<YYYYMMDD>/`
- 若需复用 T004 脚本：`_probe/t004/run_t004.py` 可读可复制改造，原文件不删

## 诊断任务（第 1 部分）

### D1 静态分析（先做，不碰硬件）

读 `contact`/`combineContact`/相关保持与滞回逻辑源码，回答：
1. ct 从 1 退到 0 的**全部条件**是什么（与？或？各阈值与时窗）
2. 退出条件里幅值、频率、闭合角各扮演什么角色；滞回下限数值是多少
3. 用上述规则**手工推演** T1 时序（A 694→59→18→80~220mg、F 122~131Hz 持续）和 dual 关源时序（A 塌到 7~9mg）——推演结果与实测 ct 曲线是否吻合；若吻合，指出哪条规则是锁存主因；若不吻合，指出分歧点（那就是更深的问题）

### D2 实板 D 命令时序（复现 + 中间量观测）

搭一段采集：接触稳定（4cm+原振子）→ 关源 → **持续敲 D（≥2Hz）追 30s**，抓 condAmp/ampMg/condFreq/freqHz/freqValid/ct 全时序。目标：看到"幅值塌了但 ct=1"区间里各中间量的真实取值，与 D1 推演互相印证。至少跑 3 次重复。

## 补测任务（第 2 部分，顺带完成）

| 编号 | 项目 | 方法 | 合格标准 |
|---|---|---|---|
| E-80 | 新振子最低档端点 | 4cm 方块 + 新低速振子最低档（≈80Hz）夹持 10s | F 读数 80±5Hz、ct=1 稳定（≥9/10） |
| E-180 | 原振子最高档端点 | 4cm 方块 + 原振子最高档（≈182Hz）夹持 10s | F 读数 180±5Hz、ct=1 稳定（≥9/10） |
| E-mid | 90/165Hz 回归 | 各一档夹持 10s | F 读数 ±5Hz、ct=1 稳定 |
| P-new | 新振子提档 | 55%→60%→70% 逐档夹持 10s | 找到 A 稳定 >400mg 的最低档，记录各档 A/F |
| D-contact | D 命令接触样例 | 接触稳定时敲 D 一行 | 抓到 condAmp=1 的 #DUMP 行（补 T004 缺项） |

## 本卡专用注意事项

1. T004 的四条实测记忆注意事项全部适用（START 基线、幅值门把关、装贴嫌疑、I2C 处置）——**这次 START 基线必须采**（T004 缺项之一），采集情况写进结果文件
2. 诊断结论只写"规则是什么、哪条导致锁存、证据是什么"，**不写改法建议**（推进决策归规划侧）
3. E-80 若幅值过不了 400mg 门：如实记录（这正是 P-new 提档要回答的问题），不要现场调阈值
4. 全程遵守 AGENTS.md §4 第 8 条：产出带日期+模型署名

## 验收标准

- [ ] D1：退出条件全清单 + 滞回/保持参数数值表 + T1 与 dual 两时序的手工推演结论（吻合/分歧 + 主因规则名）
- [ ] D2：≥3 次关源复现的 D 命令中间量时序（原始行留存），锁存区间内各中间量取值与 D1 互相印证
- [ ] E-80/E-180/E-mid：F 读数与 ct 状态逐条记录
- [ ] P-new：各档 A/F 曲线 + 稳定过门最低档结论
- [ ] D-contact：condAmp=1 的 #DUMP 行样例 ≥1 条
- [ ] START 基线采集情况已回传
- [ ] 原始数据留存 `data/t005_<YYYYMMDD>/`，结果文件按模板写入 `结果/RT005-*.md`（署名制）

## 数据要求（flash 必须在结果文件中回传）

1. 退出条件全清单与参数数值（含源码位置引用）
2. T1 时序 + dual 关源时序的推演对照表（规则推演值 vs 实测 ct）
3. D2 三次复现的中间量时序摘录（锁存区间的完整 D 行）
4. E-80/E-180/E-mid/P-new 的 F、A、ct 逐条数据
5. D-contact 样例行
6. START 基线采集情况
7. 异常与未解决项如实记录

## 完成记录

**2026-11-02 23:12 · glm5.3 (PLANNER-B)：达标 ✅，转 done。**独立复核通过：D1 退出条件全清单与滞回参数逐条对上源码（state.cpp:264-275、config.h 各阈值），T1 时序推演与实测吻合——**锁存主因确认 = 保持规则允许频率证据单独续命（F_OFF 下限 63Hz，余振 115~131Hz 持续过门）**；D2 三次关源复现 0.42~0.43s 正常退出（两路证据同塌），**未复现锁存**。补测抽查全对上：E-80 边缘达标（77.1Hz ct 8/8）、E-mid 达标、P-new 60% 中位 402mg 勉强过门、D-contact 3 条、START 基线已采。三份锁存证据经复核只剩 T1 一份成立——RT005 纠正了 T004 验收方（本模型）的一处误读（"dual 关源锁存 4s"实为 0.64s 正常退出），已在 T004 卡追加勘误，此纠错成立。

**遗留（并入 T006）**：①E-180 未达标（原振子满档实测 165.8Hz，够不到 180Hz 端点）；②振源通道↔标签疑似接反（GPIO3 实测 71~120Hz 落新振子频段、GPIO4 实测 104~166Hz 落原振子频段，软件对调 `--old-sel/--new-sel` 可确认）；③锁存是否改码 → 规划侧决策：**赛前冻结不改**（证据仅 T1 一例，比赛场景关源两路同塌 0.42s 退出，保持规则系有意设计），写入答辩材料。
