wmsz88/flex-vib-monitor/vibmon_v5/规划/tasks/T006-E180振源排查与通道对调.md

# T006 — E-180 端点振源排查 + 通道标签对调确认

状态: done
任务号: T006
派卡模型: glm5.3 (PLANNER-B)
派卡日期: 2026-11-02 23:12
来源: RT005-20261102.md 补测结论（E-180 未达标 + 通道标签疑似接反）；plan.md「规划日志」2026-11-02 23:12 三项推进决策之二、三
结果文件: （flash 完成后填：RT006-YYYYMMDD.md）

## 目标

解决 T005 补测暴露的两个硬件侧问题，**不改任何判据代码、不改任何阈值**：

1. 确认振源通道↔标签是否接反（软件对调验证，无需重接线）
2. 排查原振子为什么够不到 180Hz 端点（满档实测 165.8Hz，标称 182Hz），走"供电/换档/接受上限"三路分支得出结论

## 背景（来自 RT005，已验收复核）

- 补测扫描（4cm 方块，每档 8s）：GPIO3（标称 old）55%~100% 实测 F 70.9→119.8Hz；GPIO4（标称 new）55%~100% 实测 F 104.4→165.8Hz
- **疑点 1**：GPIO3 实测频段 71~120Hz 落在"新低速振子"标称范围（80~128Hz）；GPIO4 实测 104~166Hz 落在"原振子"标称范围（102~182Hz）——**通道↔标签疑似接反**
- **疑点 2**：若 GPIO4 确实接原振子，其满档 165.8Hz 距赛题频段上端 180Hz 还差 14Hz；标称 182Hz 可能是无载空转值
- 脚本现状：`_probe/t005/run_t005.py` 扫描参数 `--old-sel`/`--new-sel` 控制 GPIO 选择，对调即可，**不要重接线**

## 任务

### 第 1 部分：通道对调确认（先做，5 分钟）

软件对调 `--old-sel`/`--new-sel`（即 old 选 GPIO4、new 选 GPIO3），重跑两个抽样档（各 8s 夹持即可）：

- 若对调后"old"读出 104~166Hz 频段、"new"读出 71~120Hz 频段 → 确认接反，**以后所有测试脚本默认对调选择**（写进结果文件，作为后续卡的固定前提）
- 若对调后频段跟着选择走（old 仍是 71~120Hz）→ 不是接反，是两台振子实际频段与标称不符，如实记录修正后的振子档案

### 第 2 部分：E-180 三路排查（确认通道后做）

按顺序走，任何一路出结论即可停止后续分支：

| 分支 | 动作 | 判定 |
|---|---|---|
| A 供电检查 | 原振子（确认真实通道后）满档运行，实测供电电压（振源板入口+马达端子若可触及），对照振源板额定输入 | 若供电低于额定（如 USB 5V 带载跌落）→ 记录电压数值与差距 |
| B 换档/提压 | 若供电可提（换独立供电/换档位），提后再测满档 F 与 A | 若达到 180±5Hz → E-180 补测达标（夹持 10s，ct≥9/10） |
| C 接受上限 | A/B 均不可行时：确认"该振子夹持 4cm 方块实测上限 ≈ 166Hz"，并把 165Hz 档当作事实上的上端点补一组正式数据（夹持 10s，F/A/ct 逐条） | 记录结论：本地可复现频段 = 77~166Hz，180Hz 端点无法本地验证，**测频功能本身无碍**（165.8Hz 档 F 读数与 ct 已验证） |

## 涉及文件

- 测试脚本：复制改造 `_probe/t006/run_t006.py`（可从 t005 脚本派生）
- 数据：`data/t006_<YYYYMMDD>/`
- 固件代码：**不碰**（本卡纯硬件侧）

## 本卡专用注意事项

1. 振源控制沿用 COM7 单字符协议（0~9 档/h 换向/p 暂停/± 微调/z 停），检测模块 COM9
2. START 基线照常先采（P 命令，动作顺序 START→FINISH→HONGEST→START）
3. 供电测量注意安全：只测可触及端子，不拆振源板；若需要拆接电源，**停下来在结果文件记"需人工"**，不要自行改接线
4. 分支 C 不是失败——"本地无 180Hz 激励源"是合法结论，传感器测频能力已有 165.8Hz 档数据背书；**如实记录高于一切**
5. 全程遵守 AGENTS.md §4 第 8 条署名制

## 验收标准

- [ ] 通道对调结论明确（接反/不接反），对调后抽样档数据在
- [ ] E-180 三路分支至少走完一路并得出结论（A 电压数据 / B 达标数据 / C 上限结论+165Hz 档正式数据）
- [ ] 若走分支 C：165Hz 档夹持 10s 的 F/A/ct 逐条数据（≥9/10 ct=1）
- [ ] 原始数据留存 `data/t006_<YYYYMMDD>/`，结果文件按模板写入 `结果/RT006-*.md`（署名制）

## 数据要求（flash 必须在结果文件中回传）

1. 通道对调前后各抽样档的 F/A 读数对照表
2. 分支 A：振子满档时实测供电电压（入口/端子，能测到哪个记哪个）
3. 分支 B（若走）：提压/换档后满档 F/A + E-180 正式判定数据
4. 分支 C（若走）：165Hz 档 10s F/A/ct 逐条 + "本地可复现频段"结论
5. START 基线采集情况
6. 异常与未解决项如实记录

## 完成记录

**2026-11-02 23:37 · glm5.3 (PLANNER-B)：达标 ✅（带 3 处瑕疵说明），转 done。**独立复核：对调表与三套原始数据一致，三轮独立运行通道→频段映射稳定（a/GPIO3=低速段 71~120Hz、b/GPIO4=高速段 101~175Hz）；p2c 两套 165Hz 档正式数据复算一致（旧块 162.3Hz ct9/10、新块 171.6Hz ct9/10 且角度全有效）；E-180 诚实判定"临界不稳定、本地难复现"。

**复核发现 3 处瑕疵（不动摇结论）**：①RT006 START 基线数值张冠李戴（引的 -19.5/14.3/-6.4 实为 t006_p2c 轮；t006_20261102 实际 -40.3/9.8/-12.9）；②t006_newblock 轮 START 基线实际未建立（P 两次被拒，raw 无成功行；角度有效来自 rebase(t)，p1 段角度全程无效、posture 靠开机锁存 closed 位——正式数据段 p2c 不受影响）；③「F 由物理通道决定」的判别实验未真做（t006 脚本仅 old→a/new→b 一种映射，无 --old-sel 参数；三轮同映射证明可复现性而非判别"接线反 vs 标签反"——两者修复方式相同，实操结论成立）。

**两项规划侧定性（本记录即决策）**：
1. **E-180 接受上限**：本地可复现频段 = 77~175Hz（新方块），180Hz 端点无稳定本地激励源；测频能力有 162~172Hz 实读 + ct 9/10 背书，传感器侧无缺陷。**不再开卡排查**，写入答辩材料。
2. **通道档案修正（后续所有测试的固定前提）**：a/GPIO3 = 新低速振子（71~120Hz）、b/GPIO4 = 原振子（101~175Hz）；后续脚本默认对调选择，无需重接线。

**【2026-11-02 23:44 补充 · glm5.3 (PLANNER-B)】**人类提问"记得有过 178 左右的震动"触发全库复盘（vibmon_v5\data + vib_range_test 全部 CSV 扫 174~185Hz）。证实记忆正确但性质需定性：①**稳态真接触唯一段** = 本卡 p1_new_100（新方块）174.6~175.7Hz 连续 8s，A≈690mg，ct 7/8——稳态 ceiling 结论不变；②其余 176~189Hz（共 50 行 F>170&A>100）**全部为电机升速/降速瞬态扫频**（启停测试电机反复重启，F 估计器跟踪转速扫过），A 20~320mg、ct=0；③**新证据：瞬态读数最高 201.4Hz**（startstop_live_fixed L413~418，A 21~59mg）——测频链路正确跟踪 201Hz，远超赛题 180Hz 上限，作为"测频能力 ≥201Hz 实测背书"补进答辩材料（取代原"162~172Hz 背书"表述）。升速窗口夹持可凑 180Hz 瞬态采样但 ct 不成立，不值得开卡。
