wmsz88/flex-vib-monitor/vibmon_v5/规划/tasks/T007-答辩材料整理.md

# T007 — 答辩材料整理

状态: done
任务号: T007
派卡模型: glm5.3 (PLANNER-B)
派卡日期: 2026-11-02 23:45
来源: T001~T006 全部 done 后的赛前收官项；plan.md「规划日志」2026-11-02 23:37/23:44 两次定性沉淀
结果文件: RT007-20261103.md（flash 2026-11-03 12:47 交卷）
产出位置: `答辩\` 目录（本卡明确授权 flash 新建并写入该目录；其余写权限边界不变）

## 目标

把 T001~T006 沉淀的全部技术证据整理成**答辩材料**，供赛前与现场答辩使用。**只引用已有 RT 文件与数据，不新造任何数据**；每个论点标注来源（RT 号 + 数据文件路径），做到句句有出处。

## 素材清单（按论点组织，来源已核对）

### 1. 独有增量（历届六年调研背书，T003）

- **依据**：RT003-20261102.md——2021~2026 六届无一届要求"无振动接触检测"；同赛项他人开源 zhangxianggan/zongjisa-mpu6050（ESP32-C3+MPU6050）判据仅频带 RMS + 过零频率二重与（main.c:178-180），**连接触判定都没有**
- 我方独有：①CT 三重接触判据（姿态+幅值+频率）；②CL 闭合字段（T001，COMP_FRAME_CL 门控）；③D 命令 DUMP 24 列诊断（T002）；④posture 诊断
- 答辩口径（已定，勿改）：「CL=1 表示握住，CT=0 表示无振动证据；接触判据按命题绑定振动激励设计，防合拢误判」

### 2. 量化证据（各 RT 与 data/）

| 论点 | 数据 | 来源 |
|---|---|---|
| 判据正确性 | 宿主 contact 46/46、gyro 8/8、comp_frame 22/22+25/25、dump 19/19 | RT001/RT002 独立复跑 |
| 五轮重复性 | A5 五轮完整通关（**历史首次**） | RT004，data\t004_20261102\run_p1 |
| 核心判据 | A1/A2 零误报（0/10）、A3 接触保持 9/10、A4 关源退出 0.42s | RT004 |
| 频段覆盖 | 双振子互补 77~175.7Hz 稳态（a/GPIO3 低速 71~120、b/GPIO4 高速 101~175.7） | RT005/RT006 三轮一致 |
| 测频能力上限 | 瞬态正确跟踪 **201.4Hz**（远超赛题 180Hz 上限） | startstop_live_20261102_fixed.csv L413~418；T006 卡 23:44 补充记录 |
| 启停响应 | 0.50/1.00/2.00/2.94Hz 四档实测 | vib_range_test 历史数据 |
| 下扫低端 | 55%≈82Hz 全程 ct=1，关源 1.1s 回 0 | 历史数据（RT 系列引用） |
| 帧兼容性 | 默认帧 35 字节与 HEAD 逐字节一致（8/8 组输入）；CL 开启后 37 字节 | RT001 |

### 3. 设计定性（为什么这样设计——答辩必问）

- **接触保持规则（"锁存"）**：进入需三证齐全，保持只需姿态+幅值/频率任一——**有意设计**，防间歇激励时误退出（比赛激励由平台控制启停）。实测：关源两路证据同塌 0.42s 正常退出（RT005 D2 三次复现）；"锁存"证据仅 T1 一例（抽走物体但振源仍开的非比赛工况）。来源：RT005 + state.cpp:264-275
- **180Hz 端点**：本地稳态激励上限 175.7Hz（新方块），180Hz 无稳定本地激励源；测频能力有 162~172Hz 稳态 + 201.4Hz 瞬态背书，传感器侧无缺陷。来源：RT006 + T006 卡 23:44 补充
- **双轴架构**：θ>60° 判闭合 + A>400mg 且 F>75Hz 判接触；陀螺积分角（±500dps，GYRO_FS_SEL=1）解决 D 投影角分辨力不足。来源：陀螺仪改造方案.md + PLANNER-A 评审报告

### 4. 风险预案（现场 SOP）

- **平台帧格式未确认**：COMP_FRAME_CL 默认 0（逐字节兼容现状）；现场确认可调后一行配置打开（T001）
- **平台要求先不发数据**：COMP_FRAME_ENABLED 冻结 1，到场快速改 0 重烧（人工操作 SOP 已列 T001 验证项）
- **开机姿态**：复位后必须张开静止（不在 START 位 P 会被拒，t006_newblock 教训）
- **振源控制**：COM7 单字符协议；通道档案 a=低速 b=高速（T006 修正，勿再按旧标签）

## 产出要求

1. `答辩\答辩材料主文档.md`：按上面四块组织，论点→数据→来源三段式；控制在答辩可讲的篇幅（主文档精炼，证据表可附录）
2. `答辩\答辩问答预案.md`：≥10 个预设问题+一句话回答（覆盖：为何不做无振动接触、锁存是 bug 吗、180Hz 怎么没测到、精度多少、和别的队差异、帧格式对接、启停检测原理、MPU6050 为何够用、角度怎么算的、现场出问题怎么办）
3. 每个数字标注来源文件；引用 RT 数据前**回读原文件核对**，不凭记忆转抄
4. 署名制：文档头部 + RT007 头部带日期+模型

## 涉及文件

- 读：结果\RT001~RT006、data\ 各目录、要求\官网资料\历届命题调研_20261102\、大模型\评审报告_20261102.md、陀螺仪改造方案.md、当前状态.md、电路搭建\柔性振动检测模块_规则与要求整理.md
- 写：`答辩\`（本卡授权）、`结果\RT007-*.md`、`_probe\t007\`（如需脚本）
- 不碰：固件代码、规划\

## 验收标准

- [x] 主文档四块齐全（独有增量/量化证据/设计定性/风险预案），每个论点有来源标注
- [x] 问答预案 12 条（≥10），覆盖上述方向
- [x] 抽查数字与原始数据一致（验收方独立复核，见完成记录）
- [x] 文档头部署名完整（2026-11-03 · Codex(flash)）

## 完成记录

【2026-11-03 12:55 · glm5.3 (PLANNER-B) 验收：达标，T007 done】

产出：答辩\答辩材料主文档.md（四块+附录帧/命令速查）、答辩\答辩问答预案.md（12 条）；RT007-20261103.md。flash 未改任何代码/阈值/规划文件。

验收方独立复核（不信自报，逐项重查原始数据）：
① 201.4Hz 瞬态——startstop_live_20261102_fixed.csv 三行 @12:51:07.854、A 35.1/53.0/58.7mg、vib=1 ct=0，与 RT007 完全一致 ✅
② D 命令样例——t005 run.dump.csv condAmp=1 三条 ampMg 907.1/907.7/937.5（RT007 写 907~938）✅
③ A1/A2/A3/A5——t004 run_p1 五轮逐段统计：open/empty 各轮全 0/10、contact_on 五轮均 9/10 ✅
④ 稳态上限——t006_newblock p1_new_100 段 8 行采样：首行 103.4Hz 升速瞬态 ct=0，后 7 行 174.6~175.7Hz/A 665.9~698.3mg 全 ct=1 → flash 写「ct 7/8」为**严谨口径**（T006 卡「连续8行ct=1」是把 p1_new_off 首行 175.6Hz 计入的另一口径，两者均成立）✅
⑤ 帧 35/37 字节、供电 5V 无跌落——对上 RT001/RT006 ✅

加分项：flash 主动规避了 T006 复核发现的 START 基线张冠李戴数值（答辩文档不引该数）；「±5Hz 精度」如实标注为概括说法而非统计结论。

小瑕疵（不动摇达标）：问答预案 Q12 引用了 vibsource 固件 config.h 路径（Desktop\STM32project\vibsource_esp32_dual）——超出 T007 卡内列出的读范围，属只读引用无害，但下不为例。

至此 T001~T007 全部 done。赛前主线收官，剩余两项均为人类/到场依赖：USB-TTL $VD 35 字节帧实板核对（GPIO21）、平台对接 C4。
