wmsz88/flex-vib-monitor/vibmon_v5/规划/tasks/T008-串口模拟赛场验证.md

# T008 — 串口模拟赛场验证

状态: done
任务号: T008
派卡模型: glm5.3 (PLANNER-B)
派卡日期: 2026-11-03 12:58
来源: T007 收官后人类指示的最后一卡——把"等 USB-TTL"的 $VD 帧实板核对（T001 遗留 P4 项）与"平台侧收帧行为"合成一张卡，在赛前用串口把赛场平台完整模拟一遍
结果文件: RT008-20261103.md

## 目标

用宿主机脚本**扮演比赛平台**，通过 USB-TTL 从 GPIO21 比赛口连续收 $VD 帧，完成三件事：①默认 35 字节帧的实板逐帧核对（历史一直缺的 P4 项）；②CL=1 构建 37 字节帧再核一轮；③模拟平台使用场景（振动启停时看 VIB/CT/SS 字段语义）。

## 前置条件（人类操作，flash 不可代做）

- **接线**：USB-TTL 模块的 RX 接板上 **GPIO21（比赛口 TX）**，GND 接 GND；**不接 3.3V/5V**（板子经 USB 自供电）。插上电脑后记下新增 COM 口号。
- 波特率：flash 先读 `config.h` 确认比赛口 UART 的实际波特率（勿凭记忆，以配置为准）再开串口。
- **若 USB-TTL 未到位**：本卡停在接线确认步骤，如实回报等待，不伪造数据、不用调试口替代比赛口交差。

## 执行模式（2026-11-03 18:45 · glm5.3 补充）

沿用 T004~T006 实板测试模式：**振源由脚本经 COM7 单字符协议自动控制**（开/关/启停档由脚本下发——P3 退出延迟量级仅 ~0.42s，关源时刻必须与帧时间戳精确对齐，人工掐秒不可行）；**人类只做物理动作**（夹持/松开 4cm 方块）与接线；串口帧由脚本自动采集+逐帧校验（P1 60s 约 600+ 帧的 CHK/帧长核对靠脚本，人工盯屏不可行）。动作窗口用语音播报（Huihui）提示，同前几轮。脚本同时开两个串口：新增 USB-TTL 口（收 $VD）+ COM7（控源），互不冲突。

## 任务内容

### P0 接线与链路确认

1. 识别新增 COM 口（可用 pyserial 列举，对比插拔前后差异）
2. 开串口（波特率按 config.h），先收 10s 确认有 $VD 帧流出、无乱码（波特率错误表现为乱码，此时回报而不是换波特率硬凑）

### P1 默认构建 35 字节帧核对（T001 遗留 P4 闭环）

3. 连续收帧 **≥60s（静止工况）**：
   - 逐帧校验：帧头 `$VD`、行结尾 `\r\n`、域数、**CHK 校验和**逐帧重算比对
   - 统计：总帧数、校验错帧数（应为 0）、实际帧率（Hz）
   - 字段合理性：FREQ=0、AMP 为 mg 级小值、VIB=0、CT=0、SS=0、VALID 正常
4. 帧长统计：所有帧应恰 35 字节（含 `\r\n`），记录 min/max

### P2 CL=1 构建（37 字节）再核一轮

5. 烧录 `COMP_FRAME_CL=1` 构建（其余冻结宏不动），重复 P1 收 30s：
   - 帧长应恰 37 字节，CL 域插在 CT 后，CHK 覆盖 CL
   - 静止时 CL 应=1（握住姿态时）或按实际姿态记录
6. 核毕**烧回默认构建**（COMP_FRAME_CL=0），现场带默认固件出发

### P3 平台使用场景模拟（启停 + 接触）

7. 振源开 → 夹持方块 → 收帧 30s：VIB=1、CT=1、FREQ 落在振源档位、AMP 数百 mg
8. 关源 → 继续收帧 10s：CT 回 0 的延迟（对齐 A4 历史值 0.42s 量级）
9. 启停档（1Hz 或 2Hz 任一档）→ 收帧 30s：SS_Hz 域读数应落在对应档位附近
10. 每场景记录一段原始帧样本（≥20 行/场景）供验收复核

## 数据与产出

- 数据目录：`data\t008_YYYYMMDD\`（分段：p0_link / p1_default / p2_cl / p3_scene）
- 平台模拟脚本：`_probe\t008\`（建议 pyserial，超时与断线重连有兜底）
- 结论写 `结果\RT008-*.md`：改动摘要（应为零代码改动，仅烧录切换构建）/ 测试数据 / 数据结论
- 署名制照旧（RT 头部 + 数据目录名带日期）

## 纪律

- 不改任何固件代码、阈值、规划文件（烧录两种既有构建不算改动，需在 RT 里写明烧录了哪个构建、烧回什么状态）
- 数据难看（校验错、帧长漂移、CT 延迟异常）如实记录，不现场修
- 校验和算法若与 RT001 记载不一致，以实板帧为准先记录，不擅自改代码

## 验收标准

- [ ] P0 链路确认有证据（COM 口号 + 首 10s 帧样本）
- [ ] P1 ≥60s 默认帧：校验错=0、帧长恒 35、帧率统计在
- [ ] P2 CL 构建：37 字节帧核对通过，且核毕烧回默认构建（RT 写明）
- [ ] P3 三场景字段语义与历史值对得上（VIB/CT/SS/退出延迟）
- [ ] 每场景留 ≥20 行原始帧样本
- [ ] 全程零代码改动声明

## 完成记录

【2026-11-03 23:08 · glm5.3 (PLANNER-B) 验收】**达标，done。** 独立复核（不信自报，逐项回查 data\t008_20261103\）：

1. **P0/P1/P2 全对上**：四段 summary 独立读取——p0_link_12v 510/510 校验错 0、恒 35 字节 51.5Hz；p1_default 3008/3008 错 0、恒 35 字节 50.2Hz；p2_cl 1512/1512 错 0、恒 37 字节 10 域 50.5Hz；p2_back_default 303/303 错 0、恒 35 字节（烧回默认构建复核过）。**CHK 抽 6 帧手工 XOR 重算全部命中**（p0 两帧 16/12、p1 头尾 16/10、p2cl 0C、p2back 1D）——T001 遗留 P4 实板帧核对正式闭环。
2. **P3 场景语义复核**：p3_scene3 scene.csv 3534 帧逐段重算——s1 ct=1 占 1489/1512（98.5%）、F 中位 159.7Hz、A 633mg ✅；s2 关源后 amp 从 725mg 衰减、ct 靠频率证据续命至第 16 帧转 0（≈0.30s，seq 3134→3149，与 A4 历史 0.42s 同量级）✅；s3 启停 1Hz：SS 读数 {1.00, 1.02}、VIB 交替 69.6% ✅。
3. **零代码改动核实**：sketch 根目录全部 .cpp/.h/.ino 最后修改时间 ≤2026-11-02（T008 全程 11-03 执行）——RT"零改动"声明属实；_probe\t008\ 下的源码副本为 arduino-cli 构建缓存。
4. **两个瑕疵（不动摇达标）**：①RT 表中 s3"F 中位 81.7Hz（振动段）"**对不上任何数据**——p3_scene3 振动段实测中位 126.2Hz/均值 118.0Hz，前两轮 127.8~132Hz，81.7 来源不明，应以 scene.csv 复算值为准（不影响验收标准任何一条，SS/VIB/CT 语义才是 P3 考核点）；②P3 按"解析后 CSV+逐帧 chk_ok 列"保存而非逐行原文，与卡面"≥20 行原始帧样本"字面有偏差但证据等价（P1/P2 有原文 .frames.txt）。
5. **CL=1 轮 CL 全 0**：测试时模块张开姿态，未取到 CL=1 样本——RT 如实记录，符合卡内"按实际姿态记录"要求，不返工。
6. **赛场要点（RT 异常项沉淀）**：USB-TTL 与模块**必须共地**否则收 0 字节（比赛 4pin 接口自带 GND 天然满足）；波特率 115200、帧率 50Hz、TX=GPIO21/RX=GPIO20。

**T001~T008 八卡全部 done。项目赛前状态完整：判据链+帧格式+平台行为三方证据齐备，答辩材料就绪，出发固件=默认构建（35 字节）。**
