wmsz88/flex-vib-monitor/vibmon_v5/规划/tasks/T011-启停节奏进入接触（场外）.md

# T011 — 启停节奏进入接触（场外）

状态：done（2026-11-06 · Claude，人类指示结束；后续由 T012/v6 接替，未达项见卡末）
起草/执行：2026-11-05 23:30 · Claude (OUTSIDER)
人类授权原话：「机械限制导致无震动接触无法实现，只能通过间接数据判断……建立一个场外模型，你可以提出计划并执行修改」

## 问题

- 机械限制：无振动接触无法直接测，接触只能靠间接数据（姿态闭合 + 振动证据）判断。
- 启停 2/3Hz 档 CT=0：ON 窗 250/167ms 内振子只建到 160~430mg，过不了进入幅值门 400mg。0.5/1Hz 档已由 CT_HOLD 解决。

## 方案：启停节奏作为第二条进入证据

进入条件由「姿态 && 幅值 && 频率」扩为「姿态 && ((幅值 && 频率) || 启停频率已锁定且 ≥ CT_SS_ENTRY_MIN_HZ)」。启停锁定期间同时刷新 hold 证据。姿态门不动，松手立即退出。

依据（单测 1/2/3/6.1/6.2 逐帧统计，脚本见 RT011）：

- 手指动作瞬态与 2/3Hz ON 段幅值、时长、频率重叠：移动/空握/夹物共 71 段 60~300ms 振动，其中 17 段连续 3 帧 ≥250mg，峰值到 1016~1179mg。**降幅值门（B-2）会让这些瞬态在闭合时进入接触。**
- 启停频率要 ≥2 个规律周期才出读数。空握/夹物时出现过的读数只有 0.11Hz、0.87Hz，从未 ≥1.5Hz。
- 回放 6.1/6.2：3Hz 档 CT 从 0% 升到稳定窗 92~100%，2Hz 稳定窗 96~100%，0.5/1Hz 不变。

## 改动范围

- `config.h`：新增 `CT_SS_ENTRY_ENABLE`（默认跟随 `CT_HOLD_ENABLE`，开启必须同时开 hold）、`CT_SS_ENTRY_MIN_HZ=1.5`。
- `state.cpp`：`combineContact` 增加启停进入证据。宏关时代码不参与编译。
- `test/contact_test.cpp`：新增 S1~S4 用例（仅宏开编译）。

## 与在办卡关系

- 与 T009 B-2（进入门 400→250mg）**目标相同、手段冲突**。本卡数据显示 B-2 有空握误报风险，建议 B-2 暂缓，由人类拍板。本卡不改 T009 卡内容。
- 不动 T009 任务 B 的 hold 逻辑与参数。

## 验收

- [x] 宏关构建：宿主测试 46/46，默认行为不变（2026-11-05 23:30 · Claude）
- [x] 宏开构建：原 56 项 + S1~S4 全过（65/65），固件 0 warning（2026-11-05 23:30 · Claude）
- [ ] 实板（人类）：2/3Hz 档 CT 连续占比 ≥95%；空握、夹不振动物体 CT 误报 0；0.5/1Hz 不劣化；松手 ≤0.2s 掉 0
- [x] RT011 交结果（结果/RT011-20261105.md）
- [x] 实板 2/3Hz：4.txt 稳定段 CT 100%（2026-11-06 · Claude，见 RT011-20261106）
- [ ] 实板空握误报 0：**未达**——新\1.txt 6 次误进，其中 1 次走本卡路径（1.78Hz）；依据中「从未 ≥1.5Hz」一条已勘误

## 结案（2026-11-06 · Claude）

- 2/3Hz 进入接触：达标（新\4.txt 稳定段 100%）。
- 空握误报 0：v5 固件下未达；v6 下空握误进 1 次 2.2s（V6\1.txt），之后两轮（V6\2.txt、8.txt）为 0。
- 本卡的启停进入路径与缺口修正已并入 v6 继续使用。

## 补充 T011-2：启停缺口假边沿（2026-11-06 00:40 · Claude）

人类反馈「0.5Hz 出现有点慢」。3.txt 定位到采样缺口后假起振边沿，加 `SS_EDGE_FIX_ENABLE`（跟随 hold），宿主 67/67，固件 `_probe\t011\build_uart_b\`（SHA e945d958…）。待实板。
