wmsz88/flex-vib-monitor/vibmon_v5/规划/tasks/T012-v6接触三条（场外）.md

# T012 — v6 接触三条（场外）

状态：done（2026-11-06 · Claude，人类指示结束，交其他模型收尾）
起草/执行：2026-11-06 01:30 · Claude (OUTSIDER)
代码目录：`代码\vibmon_v6\`（由 v5 拷贝；v5 冻结不动，仍是默认出发版本）
人类授权原话：「手指还没有收拢，就没有开始接触测震动……接触代表角速度的立体坐标没有线性变化，此时不看加速度……接触确定分离应该是看角速度。整理一下思路，可以的话就开始v6」

## 三条规则

| | 条件 | 看什么 |
|---|---|---|
| 进入 | 角度门闭合 + **手指已停下** + 振动证据（幅值且频率，或启停 ≥1.5Hz） | 陀螺先，加速度后 |
| 保持 | 不再看加速度，不再有 1.2s 超时 | 只看陀螺 |
| 分离 | 角度门张开，**或**进入后又转过 10°（含继续收拢 = 物体滑脱） | 只看陀螺 |

「已停下」：每轴陀螺两级一阶低通 4Hz，合成 < 10dps 持续 150ms。陀螺削顶时按停下处理。
启停：收拢后第一次真停下时清一次启停历史；最低仍需 2 个周期。

## 数据依据（v5\_probe\t011\）

- 原始陀螺不能直接判静止：data\*.csv 55 个文件，闭合振动时 gyroW 中位数 22~93dps。
- 纯加速度占比分不开真假：负样本（移动/空握/夹不振动物体）滑窗占比 17~33%，3Hz 正样本 12~49%（evidence_calib.py）。

## 验收

- [x] 宿主：v6 默认 85/85；关 v6 回到 67/67；全关 46/46（2026-11-06 · Claude）
- [x] 负对照：关停下门 V1 失败；分离门 1000° V3 失败；低通 60Hz V5 失败
- [x] 固件 0 warning（`vibmon_v6\build_uart\` SHA 4e8ef5f4…）
- [x] 实板第一轮（V6\1~5.txt，RT012-20261106b）：松手掉 0、停振保持、无振动夹物为 0 均生效；空握误进 1 次 2.2s
- [x] 第二轮固件（SHA 0bf3c2fd…）实板复测（V6\6~8.txt，2026-11-06 · Claude）：旧振子 3Hz 读数 2.93~2.95Hz；2/3Hz 接触只在两次松手时退出；0.5Hz 接触后 3.3~3.8s 出读数；空握/4cm 无振动 CT 全 0
- [x] 撞击抖动判接触：不可行（空握撞击峰值 172~1167mg，夹 4cm 152~887mg，完全重叠）
- [ ] 实板 `#V6` 行（lpW/settled/moved）：**未采集**，两轮日志都没按 `d`。旧振子 2Hz 掉接触的「来回摆」原因未直接证实，只是修正后现象消失
- [x] 夹不振动物体 CT 0（V6\2.txt、8.txt）；空握：第一轮误进 1 次 2.2s（启停路径），第二轮 0
- [x] 持续振动与 0.5/1/2/3Hz 启停接触稳定；振源停 8s、手不动 CT 保持 1（V6\3.txt）
- [x] 振动中松手 CT 掉 0（V6\4.txt、6.txt）；退出延迟未单独量化（帧里无姿态列）

## 结案交接（2026-11-06 · Claude）

- 建议出发固件：v6（`vibmon_v6\build_uart\`，SHA 0bf3c2fd…），v5 默认版做备份。人类未最终拍板。
- 无振动接触：闭合角与撞击抖动两条路都已用数据排除，现有硬件判不了。
- 已知遗留：空握启停路径偶发误进（1 次 2.2s）；dump_test 在 hold 构建下 4 项失败（列数写死，既有问题）。
