wmsz88/flex-vib-monitor/vibmon_v5/结果/T009/单测/说明.md

每组 30s：
1. 平放，移动
2. 空握（快速合拢×3 + 缓慢合拢×3，看 VIB 瞬态）
3. 夹不动物体（大/小各一次，抓 D 命令各 3 行）
4. 新振子：55%/70%/100% 三档，每档夹→松→夹
5. 旧振子：55%/70%/100% 三档，每档夹→松→夹
6. 启停：0.5/1/2/3Hz 四档各 ≥20s（重点 2/3Hz）

实测：
1.慢收，快收，上下移动，轴心移动
2.空握*4，先平放，然后抬高，然后再放回
3.空握，4cm方块，4cm圆柱，5cm方块
4.50%，70%，90%，60%
5.50%，40%，60%，50%，70%，90%
6.0.5,0,1,0,2,0,3,0,1,0,3,0
6.1新振子T0,T,T1,T,T2,T,T3,T
6.2旧振子同上
