wmsz88/flex-vib-monitor/vibmon_v5/结果/T009/新/说明.txt

1.只有空握
2.0.5Hz，问题0.5出现的有点慢
3.1Hz，也是明明接触显示1了，启停还是0
4.2Hz和3Hz一起测了，关于接触为0的问题应该是解决了。不过，还有逻辑上的接触为1，明明就算机械限制，刚开始接触无震动为0，但是震动开始后没有明显复位变化，接触就因为静止归0，或者说，怎么在机械限制下，最大程度把接触判断出来
