wmsz88/flex-vib-monitor/vibmon_v5/结果/_结果模板.md

# RTxxx-YYYYMMDD — 任务号 + 任务主题的数据结论

> flash 执行任务结束后，复制本模板到 `结果/`，文件名格式 `RTxxx-YYYYMMDD.md`。
> **只写数据与结论，禁止写"建议下一步""应该怎么规划"——推进决策权在规划侧。**

任务号: Txxx
执行模型: flash
执行日期: YYYY-MM-DD

## 改动摘要（做了什么）

- （文件级列表：改了哪些文件、每处改动一句话说明）

## 测试/测量数据（测到什么）

（表格或数值列表，注明测试条件。数据要求以任务卡「数据要求」小节为准）

| 项目 | 条件 | 数值 | 备注 |
|---|---|---|---|

## 数据结论（结论是什么）

1. （1~3 条，直接从上面的数据得出，不夹带规划建议）

## 异常与未解决项

- （执行中遇到的问题、没测到的东西、需要规划侧注意的事实——只陈述事实，不出主意）
