wmsz88/flex-vib-monitor/vibmon_v5/结果/RT003-20261102.md

# RT003-20261102 — T003 历届赛题调研：同类赛项是否要求无振动接触

任务号: T003
执行模型: flash
执行日期: 2026-11-02

## 改动摘要（做了什么）

无代码改动。产出为调研结论，过程资料存 `D:\大学\课程\工科赛\要求\官网资料\历届命题调研_20261102\`：

| 文件 | 大小 | 有效性 | 来源 |
|---|---|---|---|
| 2021年广东省工科大学生实验综合技能竞赛实施方案.pdf | 769,604 B | 有效（PDF 魔数 25 50 44 46） | 广东理工学院教务处转载 https://www.gdlgxy.edu.cn/info/1861/18091.htm （附件直链 /__local/6/B8/D9/EE91CE0295C01B2138EF8A226DD_DAC51491_BBE44.pdf） |
| 2022年广东省工科大学生实验综合技能竞赛实施方案.pdf | 751,773 B | 有效（PDF 魔数 25 50 44 46） | 深圳技术大学创意设计学院转载 https://comecenter.sziit.edu.cn/fj/6.pdf |
| 2024年广东省工科大学生实验综合技能竞赛实施方案.pdf | 3,805 B | **无效**（下载被附件验证码 HTML 页拦截，未拿到正文） | 尝试自 https://jwb.gdupt.edu.cn/info/1057/9076.htm 附件 |
| 2023年实施方案_gqt直链.pdf | 1,263,196 B | **有效**（2026-11-02 二轮 ego-browser 补获；pymupdf 提取 24 页/11,741 字符） | 广州城市理工团委转载 https://gqt.gcut.edu.cn/_upload/article/files/c3/69/0857a00f40ed8d709828356cbeb8/3e8e9b45-8fb0-43ef-8b1d-1f4dd7450900.pdf （通知页 https://gqt.gcut.edu.cn/2023/0704/c6468a154655/page.htm ） |
| 2026同赛项他人代码_zongjisa-mpu6050_main.c.txt | 11,180 B | 有效（GitHub raw 抓取存档） | https://github.com/zhangxianggan/zongjisa-mpu6050 |
| 2026同赛项他人代码_zongjisa-mpu6050_README.md | 731 B | 有效（同上） | 同上 |

另用 Python(pymupdf) 将 2021/2022 两份有效 PDF 全文提取为文本逐段核查；2025 命题用本地 `2025赛项1\2025电机检测模块命题.docx` 解包 word/document.xml 读全文。

## 测试/测量数据（测到什么）

### 逐届赛项与"无振动接触"判定表

| 年份 | 赛项构成 | 检测对象 | 有无"无振动/静态接触检测"要求 | 命题关键原文（接触相关） | 来源 |
|---|---|---|---|---|---|
| 2021 | ①智能终端配送机器人 ②3D设计与制作 ③全地形越障排爆小车 | 机器人自主配送/越障、3D 打印件 | **无** | 全文"接触"仅两处：「人为接触车辆」终止比赛、「无接触式启动」按钮——均为机器人操作规则，非检测要求 | 本地 PDF（上表 2021 行） |
| 2022 | ①智能终端配送机器人 ②3D设计与制作 ③全地形越障排爆小车 | 同 2021 | **无** | 同 2021：「人为接触车辆」「10 秒静止不动」均为违规条款 | 本地 PDF（上表 2022 行） |
| 2023 | ①智能终端配送机器人 ②3D设计与制作 ③全地形越障运送小车 ④智能分拣竞争赛 | 机器人配送/越障/分拣、3D 打印件 | **无** | 全文"接触"仅两处：「机器人在行进时人为接触车辆」终止比赛、「只能用脚底接触地面」（人形双足机器人规格条款）——均非检测要求；传感器相关仅「所用传感器和电机的种类及数量不限」 | **原文已获得**：广州城市理工团委转载 https://gqt.gcut.edu.cn/_upload/article/files/c3/69/0857a00f40ed8d709828356cbeb8/3e8e9b45-8fb0-43ef-8b1d-1f4dd7450900.pdf （通知页 https://gqt.gcut.edu.cn/2023/0704/c6468a154655/page.htm ）；本地 `历届命题调研_20261102\2023年实施方案_gqt直链.pdf`（1,263,196 B 有效） |
| 2024 | ①越障救援机器人 ②3D设计与制作 ③药丸抓取分装 ④智能分拣竞争 | 机器人越障救援/抓取分拣、3D 打印件 | **无** | 通知原文列四赛项，无任何接触/振动检测表述 | 广东石油化工学院教务部 https://jwb.gdupt.edu.cn/info/1057/9076.htm （转发《2024年…实施方案》四赛项原文） |
| 2025 | 赛项1 电机功率检测模块（STM32G030K8T6） | 电机电压（0~12V）、电流（0.05~0.2A）、瞬时功率 | **无** | 「完成对电机电压和电流的实时检测，并进行功率计算」「通过USART串口稳定输出电机的电压、电流及功率的数据」——无接触状态检测 | 本地 `要求\官网资料\2025赛项1\2025电机检测模块命题.docx`（官网 2025年附件1-5.zip，公告 https://jnds.gdut.edu.cn/info/1023/1223.htm ） |
| 2026 | 赛项1 柔性振动检测模块（ESP32-C3） | 接触状态 + 持续/周期振动 | **无**（无振动接触） | 「检测接触状态、目标物体的持续振动或周期振动」；测试平台为**可控振动激励**标准测试件 | 本地 `柔性振动检测模块的设计赛项命题.pdf`、`要求\官网资料\2026年评分标准.pdf` |

### 检索范围说明

1. **官网 jnds.gdut.edu.cn「大赛动态」全 4 页（共 53 条，2016-06~2026-10）逐条核对**：列表在 2020-10-13（info/1023/1173.htm）之后直接跳 2025-06-13（info/1023/1223.htm），**2021~2024 年的动态在官网缺失**，故该四年从高校转载渠道取证。
2. 官网「最新资讯」子栏（zxzx.htm）与「大赛成果」栏（dscg.htm，仅 1 条 2018 汇总页）同步核查，无 2021~2024 命题。
3. 「赛项安排」页为 2016 旧信息空壳（PLANNER-B 卡内已侦察确认，未重复访问）。
4. 搜索词：`2024年广东省工科大学生实验综合技能竞赛 通知 赛项`、`2023年…实施方案 赛项`、`2022年…`、`2021年…`（multi_search，引擎 bing + anysearch）。
5. 2023 实施方案 PDF：第一轮从 gcu.edu.cn / gcut.edu.cn 转载直链下载均 404（服务器已下架）；Wayback Machine 本机网络不可达；**2026-11-02 二轮 ego-browser 必应检索换到 `gqt.gcut.edu.cn`（团委）镜像成功**。检索词同第 4 条。
6. 本地 `要求\官网资料\历届比赛串口协议调研.md`（2026-10-31）只覆盖串口协议，未覆盖接触判据——本任务补上该块。
7. 二轮 ego-browser 补充检索：GitHub 站内搜「广东省工科大学生实验综合技能竞赛」（全称+短名，2 次）+「MPU6050 振动检测」，探测官网 info/1023 编号段 1180~1222（10 个，全部 404）。

## 数据结论（结论是什么）

1. **2021~2026 六届中，没有任何一届出现过"检测无振动状态下的接触"（静态夹物判接触）要求**，无逐届例外。
2. 历届传感器检测类赛项只有两届：2025（电参数检测）与 2026（振动检测）；其余均为机器人/3D 打印类。2026 的接触检测在命题里明确与「持续振动或周期振动」绑定，接触对象始终是带可控振动激励的测试件。
3. 「静止无振动接触」既非历届要求，也与本届命题原文不符——该场景不构成命题缺口，属物理判据上限（与既有调研结论一致，现有了历届证据支撑）。
4. **开源代码佐证（2026-11-02 ego-browser 二轮补充）**：同赛项其他队伍公开仓库 `zhangxianggan/zongjisa-mpu6050`（ESP32-C3+MPU6050，ESP-IDF）的判据为「频带内 RMS 门限 + 过零频率」二重与（`main.c:178-180`: `in_vibration_band && strongest_rms >= rms_threshold`），**完全没有接触/静态夹物判定**；其串口帧字段 `vibration,carrier_hz,start_stop_hz,rms_g` 与我方 $VD 帧的 VIB/F/SS/AMP 字段一一对应，印证"接触状态输出"是我方相对同赛项其他队的独有增量。已存档其 main.c 与 README 至 `历届命题调研_20261102\2026同赛项他人代码_*.txt/.md`。

## 异常与未解决项

- ~~2023 实施方案原文 PDF 未获得~~ **已解决（2026-11-02 二轮）**：ego-browser 必应检索命中广州城市理工团委转载直链并成功下载，24 页全文核查完毕；此前 404 的 `syzx.gcut.edu.cn` 附件为另一失效镜像。
- 2024 实施方案 PDF 下载被广东石油化工学院附件系统的**图形验证码**拦截（页面 JS `createimage.jsp`），正文未拿到；判定基于该通知页面内嵌的四赛项完整描述文字（通知自称按实施方案原文转述）。
- 官网 info 编号段探测（1180~1222 共 10 个编号）全部 404——2021~2024 年的动态确非被删除编号，而是官网在 2020-10~2025-06 期间**未在「大赛动态」栏目发布**（或发布在已改版的其他栏目）。
- 无效下载残留（`2024年…实施方案.pdf` 3,805 B 验证码页、`2023年…实施方案.pdf` 146 B/`2023方案_try1.pdf`/`2023方案_try2.pdf` 404 页）留在 `历届命题调研_20261102\` 目录内未删除（安全删除策略下风险大于收益），已在上表标注无效性。
- GitHub 站内检索（竞赛全称/短名）共命中 4 个历届参赛相关仓库，其中 3 个（配送小车、排爆救援机器人、药丸分拣）与接触检测无关；唯一同类 `zongjisa-mpu6050` 已全文核查（见数据结论 4）。
