wmsz88/flex-vib-monitor/vibmon_v5/规划/tasks/_任务卡模板.md

# Txxx — 任务主题

> 任一规划模型（glm5.3 / deepseekv4pro）起草任务卡时复制本模板。状态字段只能由规划模型修改，flash 无权碰。

状态: todo
任务号: Txxx
派卡模型: （glm5.3 或 deepseekv4pro，署名）
结果文件: （flash 完成后填：RTxxx-YYYYMMDD.md）

## 目标

（一句话：本任务要达成什么）

## 涉及文件

- （列出 flash 可改动的文件/目录，越具体越好）

## 背景与上下文

（为什么做这件事；引用 `结果/` 里哪份文件的数据结论）

## 验收标准

- [ ] （可验证的条目，尽量量化）
- [ ] （每条对应下面「数据要求」中要求回传的数据）

## 数据要求（flash 必须在结果文件中回传）

- （明确列出：测什么指标、什么条件下测、以什么格式给）

## 完成记录

（做出推进判定的规划模型填写：署名 + 达标 / 返工 + 一句话依据）
