wmsz88/flex-vib-monitor/vibmon_v5/规划/tasks/T003-历届赛题调研无振动接触.md

# T003 — 历届赛题调研：同类赛项是否要求无振动接触

状态: done
任务号: T003
派卡模型: glm5.3 (PLANNER-B)
来源: 人类 2026-11-02 提问"查历届比赛，确认相同类型是否要求无振动接触"；PLANNER-B 已完成初步侦察（见下）
结果文件: （flash 完成后填：RT003-YYYYMMDD.md）

## 目标

调研广东省工科大学生实验综合技能竞赛（官网 jnds.gdut.edu.cn）**历届同类型赛项**的命题原文，回答一个问题：**往届是否有"检测无振动状态下的接触"这一要求**（即静态夹物判接触），还是所有届都只要求"接触带振动激励的物体"。

## 背景与上下文

- 本届（2026 赛项1 柔性振动检测模块）命题原文已核对：测试平台为"**可控振动激励**标准测试件"，功能要求是"检测接触状态、目标物体的持续振动或周期振动"——**没有**无振动接触要求
- 人类想知道：往届同类赛项是否出现过这个要求（影响 ct 判据设计是否需要支持静态夹物场景）
- 本地已有 `要求\官网资料\历届比赛串口协议调研.md`（2026-10-31），其中事实可复用：官网历年命题都在"大赛动态"新闻页发布；2025 赛项1 为电机功率检测模块（STM32）
- 该调研只查了串口协议，**没查过接触判据要求**，本任务补上这一块

## PLANNER-B 已完成的侦察（flash 直接接着做，不要重做）

- 官网首页 https://jnds.gdut.edu.cn/index.htm
- 赛项安排页是空壳（2016 旧信息），**不用去**
- 命题公告都在「大赛动态」栏目：https://jnds.gdut.edu.cn/dsdt.htm（列表分页，翻页找 2025/2024/2023 年的命题公告）
- 已见条目：`/info/1023/1298.htm`（2026 竞赛日程）、`/info/1023/1297.htm`（酒店预订）等，编号约 12xx~13xx
- 本地已有 2025 命题：`要求\官网资料\2025赛项1\2025电机检测模块命题.docx`（电机功率检测，可先读它确认 2025 无此要求）
- 搜索引擎入口（备用）：Bing 搜 `site:jnds.gdut.edu.cn 命题`
- 浏览器工具：本机可用 ego-browser（PowerShell 运行 `ego-browser nodejs -e "await import('file:///C:/.../task.mjs')"`，脚本写法见 `C:\Users\Lenovo\.agents\skills\ego-browser\SKILL.md`）；或 bsk（用户登录态，需 danger-full-access）

## 涉及文件

- 无代码改动。产出物为调研结论，写入 `结果/RT003-YYYYMMDD.md`
- 调研过程资料（网页快照、下载的命题文件）可存 `D:\大学\课程\工科赛\要求\官网资料\` 下新建 `历届命题调研_20261102\` 子目录

## 验收标准

- [ ] 覆盖至少 2023、2024、2025 三届的赛项命题（找到原文或官网公告链接；找不到的说明找过哪里）
- [ ] 逐届列出：赛项名称、检测对象、**有无"无振动/静态接触检测"要求**（引用原文措辞）
- [ ] 给出总结论：历届是否出现过无振动接触要求（即使只有一届出现也要点名）
- [ ] 所有结论附来源 URL 或本地文件路径
- [ ] 结果文件 `RT003-YYYYMMDD.md` 已按模板写入 `结果/`

## 数据要求（flash 必须在结果文件中回传）

1. 每届一条记录：年份 / 赛项名 / 命题原文关键句（接触/检测相关）/ 来源链接
2. "无振动接触要求"逐届判定表：有 / 无 / 命题未找到
3. 下载到本地的命题文件清单（如有）
4. 检索范围说明：查了官网哪些页面、用了什么搜索词、哪些年份没找到

## 完成记录

2026-11-02 17:50 · glm5.3 (PLANNER-B)：**达标**。PLANNER-B 独立抽查：2023 直链 PDF 用 pymupdf 复核（24 页有效，"接触"仅 2 处且均为机器人操作规则——脚底触地/人为接触终止比赛），四赛项名称与结论表一致；2021/2022 PDF 同法复核"接触"上下文均为违规条款。六年逐届判定表完整、来源可溯、检索范围如实（含失败渠道）。**核心结论：2021~2026 六届无一届要求"无振动接触检测"，静态夹物场景不构成命题缺口**——ct 判据设计维持现状的决策获得历届证据支撑。2024 验证码拦截缺口判定可接受（通知页转述四赛项全文，且 2024 为机器人类赛项，与接触检测无关）。加分项：同赛项他人开源代码佐证我方"接触状态输出"为独有增量。
