wmsz88/flex-vib-monitor/vibmon_v8/测试/V6/说明.txt

1.空握*3
2.4cm无震动*3
3.新旧振子各30s震动
4.新振子启停震动，最后松手继续震动，接触成功归0
5.就振子启停， 松手再握手，期间震动不停，成功区分接触为0为1的时机，但是旧振子的T3检测失败，最后换成新振子才成功
总结，v6要解决的问题应该是完成了，但是0.5启停检测还是太慢了，还有无震动接触到底可不可行

6.旧振子T2,T3启停，期间各松手一次
7.新旧振子T0启停
8.一空握一4cm*3
对了，接触物体时的抖动可不可以判断接触
