wmsz88/flex-vib-monitor/资料/02_硬件设计/PCB布局分区图.png

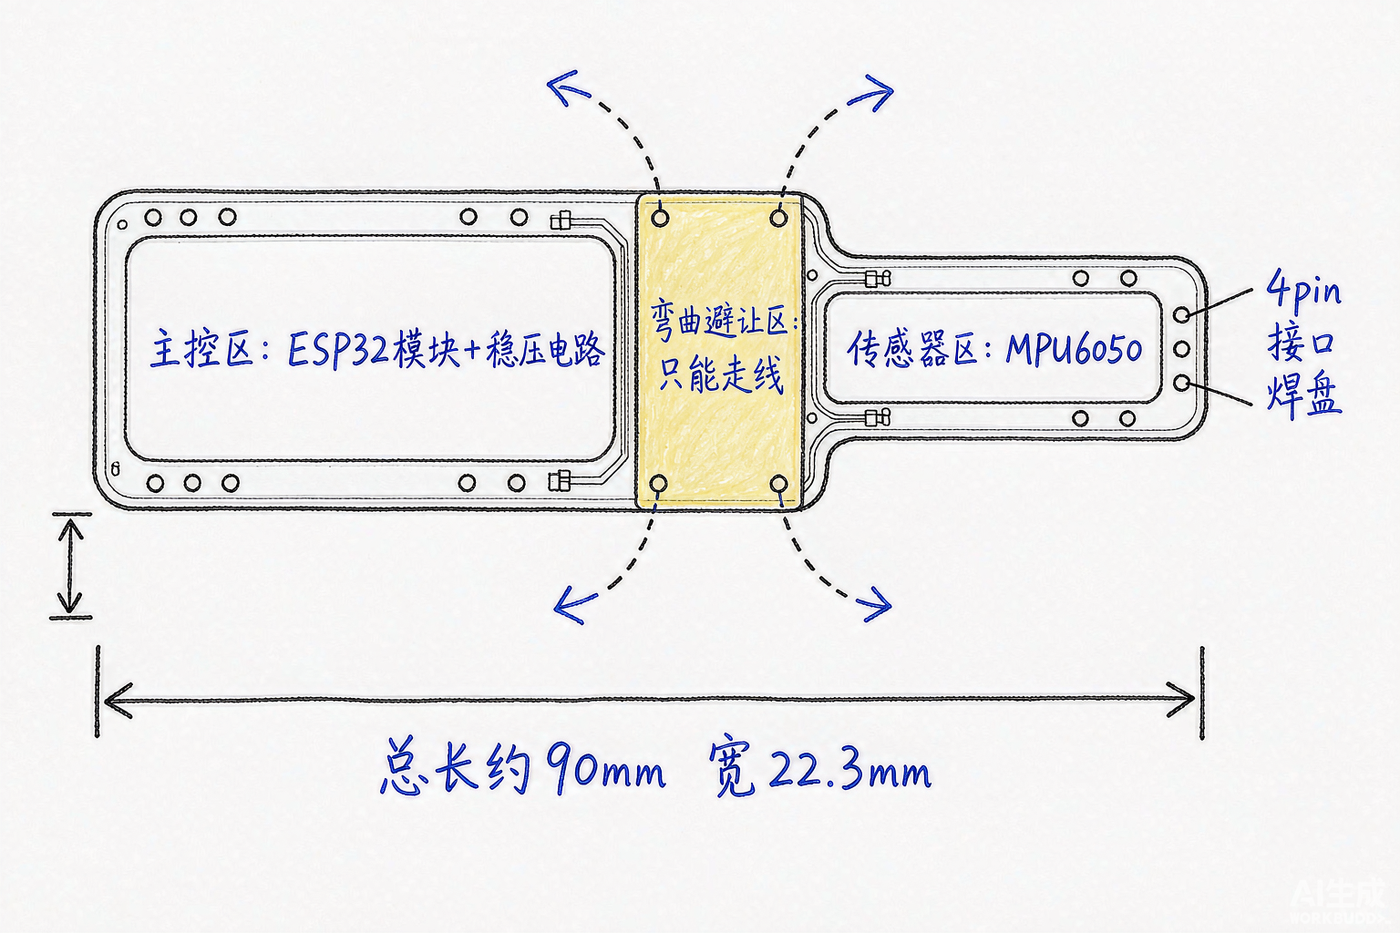
资料/02_硬件设计/PCB布局分区图.png
