wmsz88/flex-vib-monitor/资料/02_硬件设计/电路连接图.png

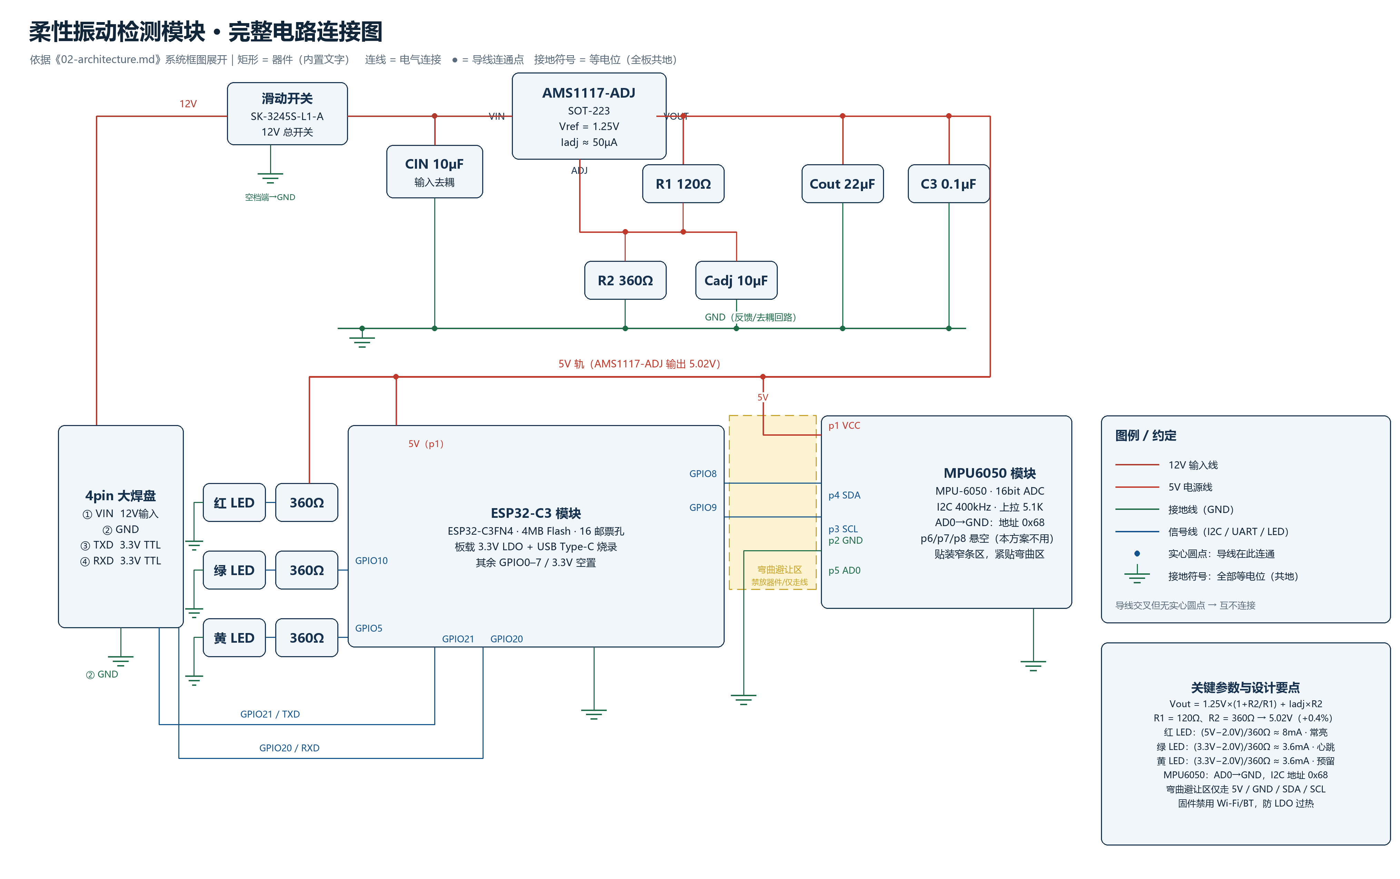
资料/02_硬件设计/电路连接图.png
