wmsz88/flex-vib-monitor/资料/02_硬件设计/系统框图.png

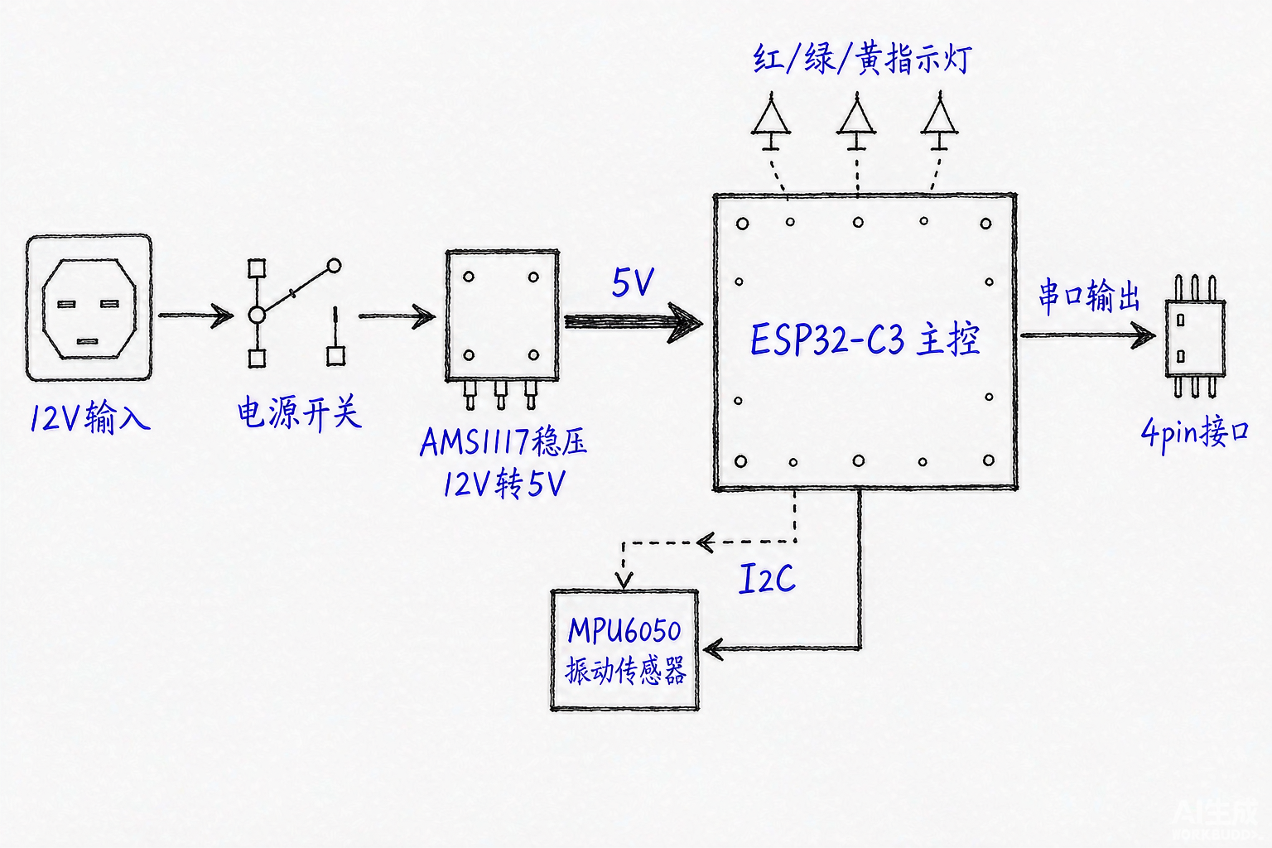
资料/02_硬件设计/系统框图.png
