wmsz88/flex-vib-monitor/资料/02_硬件设计/硬件设计说明/03-components.md

# 03 关键选型 — 柔性振动检测模块

**日期**：2026-09-20

> 全部器件由组委会现场发放，**禁止自行采购替代**。以下资料均来自赛题资料包本地文件，用于设计前通读。

## 关键 IC / 模块

| 器件 | 型号 | 关键参数（源自数据手册） | 手册位置（赛题资料包） |
|---|---|---|---|
| 主控 | ESP32-C3 扩展模块（ESP32-C3FN4，4MB Flash，QFN32） | RISC-V 32位，Wi-Fi/BLE（本方案不用射频）；16 个邮票孔位：5V/G/3.3/GPIO0-7/GPIO8=SDA/GPIO9=SCL/GPIO10/GPIO20=RX/GPIO21=TX；板载 USB Type-C 烧录 + RST/BOOT 键 | `数据手册\单片机模块.pdf` + 命题图6 |
| 传感器 | MPU6050 扩展模块（MPU-6050 QFN 4×4mm） | 加速度计 ±2/4/8/16g 可选，16bit ADC；I2C 400kHz，地址由 AD0 决定（AD0=GND→0x68）；模块引脚：1 VCC / 2 GND / 3 SCL / 4 SDA / 5 AD0 / 6 AUX_CL / 7 AUX_DA / 8 INT；板载 LDO + 5.1K 上拉 | `数据手册\传感器模块.pdf` + 命题表2 |
| 电源 | AMS1117-ADJ（SOT-223） | VREF=1.25V（1.231~1.269V，精度1.5%）；压差 1.05V@typ/1.2V@1A；Iadj≈50µA；VIN 最大 18V、推荐 ≤12V ✓；过流+过热保护；SOT-223 Rja≈90~120°C/W | `数据手册\电源稳压芯片.pdf` |

## 功能件

| 器件 | 型号/规格 | 用途 | 备注 |
|---|---|---|---|
| 滑动开关 | SK-3245S-L1-A（卧贴两档3脚） | 12V 电源总开关 | `数据手册\滑动开关.pdf`（加密/无文本，以封装库为准） |
| 贴片 LED | 0805 红/绿/黄（NCD0805 系列） | 电源/心跳/预留指示 | 红 VF=1.8~2.6V@20mA、IF 极限 25mA、PD=65mW |
| 杜邦线 | 单公头 30mm ×4 | 4pin 接口焊接线 | 线序 VIN(12V)/GND/TXD/RXD |

## 被动元件分配（清点用，不超清单数量）

| 用途 | 器件 | 数量 | 清单余量 |
|---|---|---|---|
| 稳压反馈 R1 | 120Ω 0805 | 1 | 5 用 1 |
| 稳压反馈 R2 | 360Ω 0805 | 1 | 5 用 1 |
| 红绿黄 LED 限流 | 360Ω 0805 | 3 | 5 用 3 |
| LDO 输入电容 | 10µF 0805 | 1 | 2 用 1 |
| ADJ 旁路电容 | 10µF 0805 | 1 | 2 用 1 |
| LDO 输出电容 | 22µF 0805 | 1 | 2 用 1 |
| 5V 轨高频去耦 | 0.1µF 0805 | 1 | 3 用 1 |

**备选取舍**：若现场测温发现 LDO 过热，可将 R1 改为 1K∥1K、R2=1.5K（Vout≈5.08V，分流从 10.4mA 降到 2.5mA），只动 3 颗电阻。
