wmsz88/flex-vib-monitor/资料/02_硬件设计/物料清单.xlsx

序号 | 名称 | 型号/数值 | 封装 | 数量
1 | 贴片电容 | 0.1uF | 0805_C | 3
2 | 贴片电容 | 1uF | 0805_C | 3
3 | 贴片电容 | 10uF | 0805_C | 2
4 | 贴片电容 | 22uF | 0805_C | 2
5 | 贴片电阻 | 120Ω | 0805_R | 5
6 | 贴片电阻 | 360Ω | 0805_R | 5
7 | 贴片电阻 | 1KΩ | 0805_R | 5
8 | 贴片电阻 | 1.5KΩ | 0805_R | 5
9 | 贴片电阻 | 3KΩ | 0805_R | 5
10 | 贴片电阻 | 4.7KΩ | 0805_R | 5
11 | 贴片LED | 红色 | 0805_LED | 2
12 | 贴片LED | 绿色 | 0805_LED | 2
13 | 贴片LED | 黄色 | 0805_LED | 2
14 | 滑动开关 | 卧贴两档3脚 | SK-3245S-L1-A | 1
15 | 电源稳压芯片 | AMS1117-ADJ | SOT-223 | 1
16 | 单片机模块 | ESP32C3 | ESP32C3 | 1
17 | 传感器模块 | MPU-6050模块 | MPU6050 | 1
18 | 杜邦线 | 单公头 30mm | 4PIN-Land | 6
19 | 仿生手 |  | / | 1
