wmsz88/flex-vib-monitor/vibmon_v7/_variants/固件变体清单.md

# 固件变体清单（T010 预编译存档）

> 2026-11-06 · flash (EXEC) 编译归档
> 源码：`代码\vibmon_v7\`。v7 相对 v6 只改两个文件，其余固件源码逐字节相同：
> `config.h` SHA-256 `0b400e0ae4172fe5691d8688a96a8f5da46fe92713ad5033d581760727b778ee`、
> `output.cpp` SHA-256 `106caf99d5b4fb9ecd514fcabfc1e01511789b89df49a906dc772d8183ed0686`
> 工具链：arduino-cli 1.5.1 + esp32 3.3.12，`--warnings all` → **全部 0 warning**
> 对应手册：`代码\vibmon_v5\答辩\现场适配预案手册_20261106.md`

## 一、七个变体

每个目录里有 4 个文件：`vibmon_v7.ino.bin`（应用）+ `.bootloader.bin` + `.partitions.bin` + `boot_app0.bin`，够完整烧录。

| 变体 | 编译宏 | FQBN | Flash (B) | RAM (B) | `.bin` 字节 | `.bin` SHA-256 |
|---|---|---|---:|---:|---:|---|
| `def` | （无，**出发版**） | esp32c3:CDCOnBoot=cdc | 373262 | 30340 | 373408 | `c4c3895fdcbaece090a1c0e8a8e84963f8f3ad2d227c0bd67245732e442b08bd` |
| `cl` | `-DCOMP_FRAME_CL=1` | esp32c3:CDCOnBoot=cdc | 373358 | 30340 | 373504 | `ec4790db0c153b74912eb14b0d343e5d6fd83f542d020c739e2a77aeece58d54` |
| `csv` | `-DCOMP_FRAME_CSV=1` | esp32c3:CDCOnBoot=cdc | 372940 | 30340 | 373088 | `9dff6af1fadeeabb5a3f3bfbefd48041907d6a2c08fee352ebd42d93697a9f2a` |
| `div2` | `-DCOMP_FRAME_DIV=2` | esp32c3:CDCOnBoot=cdc | 373318 | 30340 | 373472 | `dac192f0c2a08b793058c874a144e68efcd4241023d0881ff386cf4fbe1c8aa4` |
| `gate` | `-DCOMP_FRAME_GATED=1` | esp32c3:CDCOnBoot=cdc | 373462 | 30340 | 373616 | `bd88418ad47d1d7ca89c38755139368ca684986c3f5d1528038d5f4a310f63bf` |
| `v5sem` | `-DCT_V6_ENABLE=0` | esp32c3:CDCOnBoot=cdc | 372070 | 30300 | 372224 | `5733ac910b9621abd6a9698a18cc31eaee616080f6bb6ecb4d59a29359ac024a` |
| `uart` | （无，非 CDC） | esp32c3 | 368156 | 30156 | 368304 | `0cff7828bf43dfc9f9e9a15bd353a637b5cb9c94483382f91e54a964fcf30017` |

**`.bin` SHA 的用法**：ESP32 的 `.bin` 里嵌了编译时刻与 ELF 指纹，同一份源码两次编译 SHA **必然不同**（T013 实测差 68 字节）。所以上表的 SHA 只用来对"我手里这份存档文件"做完整性核对；**认固件版本请看变体名 + 上面两个源文件的 SHA-256**，不要拿它跟重新编译的产物比对。

**编译方式的一点提醒**：这 7 个变体不要并行编 —— 第一次 7 个一起编时 `gate` 失败了一次（`Error during build: exit status 1`，无编译错误信息），单独重编就 0 warning 通过；多个 arduino-cli 同时写同一个 `Arduino15` 构建缓存会互相踩。要并行就把 `--build-cache` 指到各自的目录。

## 二、怎么烧

```bash
# 比赛用（CDC 构建，6 个 CDC 变体都这么烧）；COMx 换成实际口
arduino-cli upload -p COMx --fqbn esp32:esp32:esp32c3:CDCOnBoot=cdc --input-dir "<本目录>\def"

# uart 变体（非 CDC）
arduino-cli upload -p COMx --fqbn esp32:esp32:esp32c3 --input-dir "<本目录>\uart"
```

急着用整片镜像时也可以用 `.merged.bin`（本目录没放，需要时同名目录重新编译会生成），
或直接 `esptool write_flash` 按 `flash_args` 的四个偏移写。

## 三、怎么重新编出这些变体

1. 把 `代码\vibmon_v7\` 的 `*.ino`、`*.h`、`*.cpp` 拷到一个**不含中文**的临时目录（文件夹名保持 `vibmon_v7`）；
2. 编默认版：

```bash
arduino-cli compile --fqbn "esp32:esp32:esp32c3:CDCOnBoot=cdc" --warnings all "<临时目录>/vibmon_v7"
```

3. 编变体就在上面加 `--build-property "compiler.cpp.extra_flags=-D<宏>=<值>"`，宏见上表。

> 也可以不改宏、直接改 `代码\vibmon_v7\config.h` 里的默认值再编默认版 —— 结果等价，但记得改回来。
