wmsz88/flex-vib-monitor/vib_range_test/data/contact_duty_sweep_live_20261102.summary.md

# 接触判据 x 振源下扫结果（2026-11-02）

> 方法：`D:\大学\课程\工科赛\代码\vib_range_test\实板测试模式.md`
> 编排脚本：`run_contact_sweep.py`
> 原始数据：`contact_duty_sweep_live_20261102.csv`
> 原始串口：`contact_duty_sweep_live_20261102.csv.raw.txt`
> 分段标记：`contact_duty_sweep_live_20261102.csv.markers.json`

## 流程

```text
张开复位 -> 闭合夹住 4cm 方块 -> 振源 100% -> 80% -> 65% -> 55%
-> 关振源 -> 松手
```

每档保持：100% 20s；80% 18s；65% 18s；55% 18s；关源后 12s。

## 分段结果

| 段 | n | ct=1 | cl=1 | A min/中位/max (mg) | F min/中位/max (Hz) |
|---|---:|---:|---:|---|---|
| start_logger（张开基线） | 7 | 0 | 0 | 5.2 / 5.5 / 7.0 | 无效 |
| close（闭合、源关） | 28 | 0 | 26 | 4.4 / 5.8 / 704.7 | 177.3（单点瞬态） |
| duty100 | 23 | 22 | 23 | 414.7 / 477.5 / 719.7 | 114.4 / 119.4 / 121.4 |
| duty80 | 23 | 23 | 23 | 496.4 / 519.8 / 543.2 | 106.3 / 106.9 / 107.7 |
| duty65 | 25 | 25 | 25 | 286.8 / 468.1 / 491.1 | 84.3 / 95.7 / 96.1 |
| duty55 | 23 | 23 | 23 | 289.3 / 302.7 / 353.4 | 83.5 / 84.2 / 95.4 |
| source_off | 14 | 1 | 3 | 5.0 / 6.2 / 297.4 | 84.6（单点） |
| end | 1 | 0 | 0 | 5.8 | 无效 |

## 结论

- 张开基线：`ct=0`，A≈5.5 mg。
- 闭合但振源关：`ct=0`；闭合瞬态有一次 A=704.7 mg / F=177.3 Hz 的单点，
  但 `CT_CONFIRM_MS=100` 未让它进入 `ct=1`。
- 100% / 80% / 65% / 55% 全部 `ct=1`；100% 首点预热，22/23。
- 55% 段 A 中位数 302.7 mg（低于 A_ON=400），但 F≈84 Hz 仍在，
  接触靠保持规则继续为 1；说明低档退出由 A/F 哪一路先跌破 OFF 决定。
- 65% 段 A 最小值 286.8 mg 低于 A_OFF=300，但 F≈84~96 Hz 仍在，
  所以 `ct` 未掉；这验证了“姿态 + A/F 任一保持”的滞回规则。
- 关振源后首次 `ct=0` 出现在 1.1s（logger 1Hz 采样分辨率内）。
- 全程没有 `ang=?`；角度有效。
