wmsz88/flex-vib-monitor/vib_range_test/data/object_off_20261102.summary.md

# 夹住 4cm 方块 + 振源关（C5，2026-11-02）

> 方法：`实板测试模式.md`，`logger.py` 采集 `#SWEEP`，振源关闭。

## 结果

- 采样：15s，共 22 行
- 闭合段：10 行（`closed=1`）
- 闭合段 `ct=1`：0/10
- 闭合段 `closed=1`：10/10
- 闭合段 A：4.9 / 6.0 / 92.8 mg（min / 中位 / max）
- 闭合段闭合角：80~92°（中位 90.5°）
- 闭合段有效主频：2 行，中位约 182.7Hz（闭合瞬态）
- 全程 `ct=1`：0/22

## 结论

夹住 4cm 方块但振源关闭时，`closed=1`、`ct=0`，没有把“夹住但没振动”
误报为接触。闭合瞬态有单点 A=92.8mg / F≈183Hz，但未达到接触判据。

原始数据：

- `object_off_20261102.csv`
- `object_off_20261102.csv.raw.txt`
