wmsz88/flex-vib-monitor/资料/02_硬件设计/硬件设计说明/05-validation.md

# 05 验证计划 — 柔性振动检测模块

**日期**：2026-09-20（校赛前自验 + 现场赛程两阶段）

## 阶段一：设计验证（9/20–9/29，出 Gerber 前）

| # | 验证项 | 方法 | 通过标准 |
|---|---|---|---|
| V1 | 规则自检 | 04 文件 16 条清单逐条对照嘉立创 DRC 报告 | 全部通过，0 违例 |
| V2 | 稳压计算复核 | 手算 + 仿真：Vout=1.25×(1+360/120)+50µA×360Ω | 5.02V ±1.5% |
| V3 | 封装核对 | 导入组委会封装库后与图5/图6/图8 逐脚比对 | 引脚 1:1，无镜像错误 |
| V4 | 可制造性 | 嘉立创下单助手预览 Gerber | FPC 工艺可识别、层数正确 |

## 阶段二：现场实践验证（制板返回后）

| # | 验证项 | 方法 | 通过标准 | 失败排查 |
|---|---|---|---|---|
| V5 | 焊接目检 | 放大镜查连锡/虚焊，重点 0805 与邮票孔 | 无桥连 | 吸锡带返修 |
| V6 | 电源上电 | 开关闭合，万用表测 5V 轨 | 4.95~5.10V，红 LED 亮 | 断电查开关极性/LDO 焊向 |
| V7 | 3.3V 与启动 | 烧录点灯程序（Type-C 烧录） | 绿 LED 按 1Hz 闪 | 查 BOOT 进下载模式步骤 |
| V8 | I2C 连通 | GPIO8/9 扫地址 | 应答 0x68 | 查 SDA/SCL 是否对调、上拉 |
| V9 | 加速度读数 | 读三轴原始值，静置 | Z≈+1g±5%，X/Y≈0 | 查 VCC 5V、AD0 接地 |
| V10 | 振动响应 | 标准测试件 80~180Hz 扫频 | 频率误差 ≤±2Hz | 采样率≥1kHz、加 DLPF、FFT 窗长核对 |
| V11 | 启停频率 | 0~3Hz 通断振动 | 识别 ≤0.5s 延迟 | 包络检测阈值整定 |
| V12 | 串口输出 | 测试平台收 UART | 波特率一致、帧格式合规 | TX/RX 交叉核对 |
| V13 | 温升 | 连续运行 10min 手触 AMS1117 | 可触摸（<70°C） | 关 Wi-Fi、降主频、换 R1 方案 B |
| V14 | 弯曲可靠性 | 上指后反复弯曲 20 次 | 无焊点开裂/断线 | 弯曲区过孔减量、线宽加大 |
