wmsz88/flex-vib-monitor/vib_range_test/data/empty_grip_20261102.summary.md

# 空握（C3，2026-11-02）

> 方法：`实板测试模式.md`，`logger.py` 采集 `#SWEEP`，振源关闭。

## 结果

- 采样：15s，共 21 行
- `ct=1`：0/21
- `closed=1`：12/21（闭动作发生在采样中段，后半段 `closed=1`）
- `vib=1`：1/21（闭合瞬态）
- A：4.5 / 6.1 / 16.3 mg（min / 中位 / max）
- 闭合角：0~115°，中位 114°
- 主频：全程无效
- 末行：`D=1700mg ang=114deg vib=0 ct=0 cl=1`

## 结论

空握闭合后 `closed=1`、`ct=0`，A 仍然很小，没有误报接触。

原始数据：

- `empty_grip_20261102.csv`
- `empty_grip_20261102.csv.raw.txt`
