wmsz88/flex-vib-monitor/vib_range_test/data/release_20261102b.summary.md

# 松手/张开基线（2026-11-02）

> 方法：`实板测试模式.md`，`logger.py` 采集 `#SWEEP`，源保持关闭。

## 结果

- 采样：15s，共 21 行
- `ct=1`：0/21
- `closed=1`：0/21
- `vib=1`：0/21
- A：4.8 / 5.4 / 6.4 mg（min / 中位 / max）
- 闭合角：0°（全程有效）
- 主频：全程无效
- 末行：`D=14mg ang=0deg vib=0 ct=0 cl=0`

## 结论

松手/张开基线通过：无振动、无接触、未闭合、闭合角为 0。

原始数据：

- `release_20261102b.csv`
- `release_20261102b.csv.raw.txt`

备注：第一次 `release_20261102.csv` 因复位时姿态未保持张开，`ang=?`，
不作为基线；`release_20261102b.csv` 是有效版本。
