wmsz88/flex-vib-monitor/vib_range_test/data/release_source_on_20261102.summary.md

# 松手 + 振源开（C2，2026-11-02）

> 方法：`实板测试模式.md`，`logger.py` 采集 `#SWEEP`。

## 结果

- 采样：15s，共 22 行
- `ct=1`：0/22
- `closed=1`：0/22
- `vib=1`：0/22
- A：4.0 / 5.8 / 7.1 mg（min / 中位 / max）
- 闭合角：0°（全程有效）
- 主频：全程无效
- 末行：`D=20mg ang=0deg vib=0 ct=0 cl=0`

## 结论

松手且振源开时未误报：无接触、未闭合、无持续振动。

原始数据：

- `release_source_on_20261102.csv`
- `release_source_on_20261102.csv.raw.txt`
