wmsz88/flex-vib-monitor/vib_range_test/data/5round_repeat_20261102.csv

round | phase | elapsed_s | phase | Freq_Hz | Amp_mg | FlatDist_mg | CloseAngle_deg | RefSwing_mg | vib | contact | gripNoObject | closed | gyroW | clipLimited | axis | ok
0 | boot | 0.0 | boot |  | 4.7 | 1611 |  | 3 | 0 | 0 | 0 | 0 | 0.2 | 0 | 2 | 0
1 | wait_open | 0.0 | wait_open |  | 5.1 | 1611 |  | 3 | 0 | 0 | 0 | 0 | 0.2 | 0 | 2 | 0
1 | wait_open | 0.6 | wait_open |  | 5.1 | 1611 |  | 3 | 0 | 0 | 0 | 0 | 0.2 | 0 | 2 | 0
1 | wait_open | 1.3 | wait_open |  | 5.2 | 1611 |  | 3 | 0 | 0 | 0 | 0 | 0.3 | 0 | 2 | 0
1 | wait_open | 1.6 | wait_open |  | 4.4 | 1612 |  | 3 | 0 | 0 | 0 | 0 | 0.3 | 0 | 2 | 0
1 | wait_open | 2.2 | wait_open |  | 6.6 | 1612 |  | 3 | 0 | 0 | 0 | 0 | 0.1 | 0 | 2 | 0
1 | wait_open | 2.5 | wait_open |  | 6.4 | 1612 |  | 3 | 0 | 0 | 0 | 0 | 0.1 | 0 | 2 | 0
1 | wait_open | 3.2 | wait_open |  | 6.2 | 1612 |  | 3 | 0 | 0 | 0 | 0 | 0.2 | 0 | 2 | 0
1 | wait_open | 3.8 | wait_open |  | 4.6 | 1613 |  | 3 | 0 | 0 | 0 | 0 | 0.1 | 0 | 2 | 0
1 | wait_open | 4.1 | wait_open |  | 5.7 | 1613 |  | 3 | 0 | 0 | 0 | 0 | 0.4 | 0 | 2 | 0
1 | wait_open | 4.7 | wait_open |  | 5.2 | 1613 |  | 3 | 0 | 0 | 0 | 0 | 0.2 | 0 | 2 | 0
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
