wmsz88/flex-vib-monitor/vib_range_test/data/5round_repeat_20261102_r1.csv

round | elapsed_s | phase | Freq_Hz | Amp_mg | FlatDist_mg | CloseAngle_deg | RefSwing_mg | vib | contact | gripNoObject | closed | gyroW | clipLimited | axis | ok
0 | 0.0 | boot |  | 6.0 | 1651 | 96 | 2 | 0 | 0 | 0 | 1 | 0.1 | 0 | 2 | 0
1 | 0.0 | wait_open |  | 5.9 | 1652 | 96 | 2 | 0 | 0 | 0 | 1 | 0.1 | 0 | 2 | 0
1 | 0.6 | wait_open |  | 4.9 | 1652 | 96 | 2 | 0 | 0 | 0 | 1 | 0.3 | 0 | 2 | 0
1 | 1.3 | wait_open |  | 5.6 | 1652 | 96 | 2 | 0 | 0 | 0 | 1 | 0.1 | 0 | 2 | 0
1 | 1.6 | wait_open |  | 5.8 | 1653 | 96 | 2 | 0 | 0 | 0 | 1 | 0.1 | 0 | 2 | 0
1 | 2.2 | wait_open |  | 5.5 | 1652 | 96 | 2 | 0 | 0 | 0 | 1 | 0.1 | 0 | 2 | 0
1 | 2.5 | wait_open |  | 5.2 | 1653 | 96 | 2 | 0 | 0 | 0 | 1 | 0.1 | 0 | 2 | 0
1 | 3.2 | wait_open |  | 5.7 | 1653 | 96 | 2 | 0 | 0 | 0 | 1 | 0.2 | 0 | 2 | 0
1 | 3.8 | wait_open |  | 5.3 | 1653 | 96 | 2 | 0 | 0 | 0 | 1 | 0.2 | 0 | 2 | 0
1 | 4.1 | wait_open |  | 5.9 | 1652 | 96 | 2 | 0 | 0 | 0 | 1 | 0.2 | 0 | 2 | 0
1 | 4.7 | wait_open |  | 4.9 | 1654 | 96 | 2 | 0 | 0 | 0 | 1 | 0.2 | 0 | 2 | 0
1 | 5.0 | wait_open |  | 5.5 | 1653 | 96 | 2 | 0 | 0 | 0 | 1 | 0.2 | 0 | 2 | 0
1 | 5.7 | wait_open |  | 5.2 | 1653 | 96 | 2 | 0 | 0 | 0 | 1 | 0.1 | 0 | 2 | 0
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
