wmsz88/flex-vib-monitor/vib_range_test/data/5round_repeat_20261102_r1b.csv

round | elapsed_s | phase | Freq_Hz | Amp_mg | FlatDist_mg | CloseAngle_deg | RefSwing_mg | vib | contact | gripNoObject | closed | gyroW | clipLimited | axis | ok
0 | 0.0 | boot |  | 5.8 | 3 | 0 | 1 | 0 | 0 | 0 | 0 | 0.1 | 0 | 2 | 0
1 | 0.0 | wait_open |  | 6.6 | 4 | 0 | 1 | 0 | 0 | 0 | 0 | 0.2 | 0 | 2 | 0
1 | 0.0 | wait_closed | 145.6 | 157.6 | 18 | 2 | 1 | 1 | 0 | 0 | 0 | 27.6 | 0 | 1 | 1
1 | 0.6 | wait_closed | 165.6 | 194.5 | 179 | 27 | 1 | 1 | 0 | 0 | 0 | 204.7 | 0 | 1 | 1
1 | 1.3 | wait_closed | 85.6 | 324.4 | 1352 | 94 | 1 | 1 | 0 | 0 | 1 | 23.2 | 0 | 2 | 1
1 | 0.0 | closed_off | 93.8 |  | 1323 |  | 1 | 1 | 0 | 0 | 0 | 65.0 | 0 | 2 | 0
1 | 1.3 | closed_off | 165.7 | 46.3 | 1656 |  | 1 | 1 | 0 | 0 | 0 | 0.6 | 0 | 1 | 1
1 | 2.3 | closed_off |  | 5.0 | 1660 |  | 1 | 0 | 0 | 0 | 0 | 0.5 | 0 | 2 | 0
1 | 3.2 | closed_off |  | 5.5 | 1663 |  | 1 | 0 | 0 | 0 | 0 | 0.2 | 0 | 2 | 0
1 | 4.2 | closed_off |  | 5.6 | 1663 |  | 1 | 0 | 0 | 0 | 0 | 0.5 | 0 | 2 | 0
1 | 0.0 | source_on |  | 5.4 | 1665 |  | 1 | 0 | 0 | 0 | 0 | 0.1 | 0 | 2 | 0
1 | 1.3 | source_on | 110.5 | 644.3 | 1672 |  | 1 | 1 | 0 | 0 | 0 | 64.3 | 0 | 0 | 1
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
