wmsz88/flex-vib-monitor/vib_range_test/data/5round_repeat_20261102_r1c.csv

round | elapsed_s | phase | Freq_Hz | Amp_mg | FlatDist_mg | CloseAngle_deg | RefSwing_mg | vib | contact | gripNoObject | closed | gyroW | clipLimited | axis | ok
0 | 0.0 | boot |  | 5.9 | 1 | 0 | 1 | 0 | 0 | 0 | 0 | 0.3 | 0 | 2 | 0
1 | 0.0 | wait_open |  | 5.1 | 1 | 0 | 1 | 0 | 0 | 0 | 0 | 0.3 | 0 | 2 | 0
1 | 0.0 | wait_closed |  | 6.2 | 1 | 0 | 1 | 0 | 0 | 0 | 0 | 0.1 | 0 | 2 | 0
1 | 0.6 | wait_closed |  | 5.9 | 1 | 0 | 1 | 0 | 0 | 0 | 0 | 0.2 | 0 | 2 | 0
1 | 1.3 | wait_closed |  | 4.4 | 1 | 0 | 1 | 0 | 0 | 0 | 0 | 0.3 | 0 | 2 | 0
1 | 1.6 | wait_closed |  | 5.6 | 1 | 0 | 1 | 0 | 0 | 0 | 0 | 0.2 | 0 | 2 | 0
1 | 2.2 | wait_closed |  | 4.9 | 1 | 0 | 1 | 0 | 0 | 0 | 0 | 0.1 | 0 | 2 | 0
1 | 2.5 | wait_closed |  | 5.6 | 0 | 0 | 1 | 0 | 0 | 0 | 0 | 0.2 | 0 | 2 | 0
1 | 3.2 | wait_closed |  | 5.3 | 1 | 0 | 1 | 0 | 0 | 0 | 0 | 0.2 | 0 | 2 | 0
1 | 3.8 | wait_closed |  | 6.2 | 1 | 0 | 1 | 0 | 0 | 0 | 0 | 0.2 | 0 | 2 | 0
1 | 4.1 | wait_closed |  | 4.5 | 1 | 0 | 1 | 0 | 0 | 0 | 0 | 0.3 | 0 | 2 | 0
1 | 4.8 | wait_closed |  | 6.7 | 1 | 0 | 1 | 0 | 0 | 0 | 0 | 0.1 | 0 | 2 | 0
1 | 5.1 | wait_closed |  | 6.1 | 1 | 0 | 1 | 0 | 0 | 0 | 0 | 0.1 | 0 | 2 | 0
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
