wmsz88/flex-vib-monitor/vib_range_test/data/5round_repeat_20261102b.csv

round | phase | elapsed_s | phase | Freq_Hz | Amp_mg | FlatDist_mg | CloseAngle_deg | RefSwing_mg | vib | contact | gripNoObject | closed | gyroW | clipLimited | axis | ok
0 | boot | 0.0 | boot |  | 5.4 | 11 | 0 | 1 | 0 | 0 | 0 | 0 | 0.2 | 0 | 2 | 0
1 | wait_open | 0.0 | wait_open |  | 4.8 | 12 | 0 | 1 | 0 | 0 | 0 | 0 | 0.2 | 0 | 2 | 0
1 | wait_closed | 0.0 | wait_closed |  | 5.9 | 0 | 0 | 1 | 0 | 0 | 0 | 0 | 0.3 | 0 | 2 | 0
1 | wait_closed | 0.6 | wait_closed |  | 5.3 | 1 | 0 | 1 | 0 | 0 | 0 | 0 | 0.2 | 0 | 2 | 0
1 | wait_closed | 1.3 | wait_closed |  | 4.9 | 1 | 0 | 1 | 0 | 0 | 0 | 0 | 0.0 | 0 | 2 | 0
1 | wait_closed | 1.6 | wait_closed |  | 5.1 | 1 | 0 | 1 | 0 | 0 | 0 | 0 | 0.1 | 0 | 2 | 0
1 | wait_closed | 2.2 | wait_closed |  | 5.0 | 1 | 0 | 1 | 0 | 0 | 0 | 0 | 0.2 | 0 | 2 | 0
1 | wait_closed | 2.5 | wait_closed |  | 5.7 | 1 | 0 | 1 | 0 | 0 | 0 | 0 | 0.4 | 0 | 2 | 0
1 | wait_closed | 3.2 | wait_closed |  | 5.9 | 1 | 0 | 1 | 0 | 0 | 0 | 0 | 0.2 | 0 | 2 | 0
1 | wait_closed | 3.8 | wait_closed |  | 6.4 | 2 | 0 | 1 | 0 | 0 | 0 | 0 | 0.2 | 0 | 2 | 0
1 | wait_closed | 4.1 | wait_closed |  | 5.6 | 2 | 0 | 1 | 0 | 0 | 0 | 0 | 0.2 | 0 | 2 | 0
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
