wmsz88/flex-vib-monitor/vib_range_test/data/contact_duty_sweep_live_20261102.csv

wall | epoch | t_s | Freq_Hz | Amp_mg | FlatDist_mg | ang_deg | tr_mg | vib | ct | grip | closed | w_dps | cliplim | axis | ok
12:24:14.940 | 1793593454.941 | 185 |  |  | 3 | 0 | 1 | 0 | 0 | 0 | 0 | 0.1 | 0 | 2 | 0
12:24:16.060 | 1793593456.061 | 186 |  |  | 2 | 0 | 1 | 0 | 0 | 0 | 0 | 0.3 | 0 | 2 | 0
12:24:17.161 | 1793593457.162 | 187 |  | 5.2 | 2 | 0 | 1 | 0 | 0 | 0 | 0 | 0.3 | 0 | 2 | 0
12:24:18.282 | 1793593458.283 | 188 |  | 5.5 | 2 | 0 | 1 | 0 | 0 | 0 | 0 | 0.1 | 0 | 2 | 0
12:24:19.402 | 1793593459.402 | 189 |  | 6.0 | 3 | 0 | 1 | 0 | 0 | 0 | 0 | 0.3 | 0 | 2 | 0
12:24:20.522 | 1793593460.523 | 190 |  | 5.5 | 2 | 0 | 1 | 0 | 0 | 0 | 0 | 0.1 | 0 | 2 | 0
12:24:21.623 | 1793593461.624 | 191 |  | 7.0 | 3 | 0 | 1 | 0 | 0 | 0 | 0 | 0.5 | 0 | 1 | 0
12:24:22.724 | 1793593462.724 | 192 |  |  | 17 | 1 | 1 | 1 | 0 | 0 | 0 | 31.4 | 0 | 1 | 0
12:24:23.764 | 1793593463.764 | 193 |  |  | 8 | 3 | 1 | 1 | 0 | 0 | 0 | 23.4 | 0 | 1 | 0
12:24:24.826 | 1793593464.826 | 194 | 177.3 | 704.7 | 608 | 73 | 1 | 1 | 0 | 0 | 1 | 287.3 | 0 | 1 | 1
12:24:25.887 | 1793593465.888 | 196 |  | 22.0 | 1715 | 115 | 1 | 0 | 0 | 0 | 1 | 3.5 | 0 | 1 | 0
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
