wmsz88/flex-vib-monitor/vibmon_v9/mpu.h

// MPU 驱动模块：初始化、寄存器回读、读取加速度、通信错误统计。
#pragma once
#include <stdint.h>

enum MpuInitResult : uint8_t {
  MPU_OK = 0,
  MPU_ERR_NO_ACK,      // WHO_AM_I 读不到
  MPU_ERR_WHOAMI,      // 读到了但不是 0x68
  MPU_ERR_WRITE,       // 配置寄存器写失败
  MPU_ERR_VERIFY,      // 回读值与写入值不符
};

/* 六轴原始值。加速度 x/y/z 与陀螺 gx/gy/gz 共用一次突发读（0x3B 起 14 字节）。
 * v5 起陀螺才被真正使用；v4 及以前只读加速度，g* 恒为 0。 */
struct MpuRaw { int16_t x, y, z; int16_t gx, gy, gz; };

void        mpuBusBegin(void);
// 完整初始化：探测 → 软复位 → 唤醒 → 写配置 → 逐个回读校验。失败时 *badReg 给出出错寄存器。
MpuInitResult mpuInit(uint8_t* badReg);
bool        mpuReadAccel(MpuRaw* out);     // 6 字节突发读，失败计入错误数
// 14 字节突发读：加速度 6 + 温度 2 + 陀螺 6。比 mpuReadAccel 慢一倍多，
// 只在需要角速度的 tick 调用（见 config.h 的 GYRO_DIV）。
bool        mpuReadAll(MpuRaw* out);
float       mpuLsbPerG(void);
float       mpuLsbPerDps(void);
uint32_t    mpuErrCount(void);
void        mpuClearErr(void);
const char* mpuResultStr(MpuInitResult r);
