wmsz88/flex-vib-monitor/(commit log)

2026-10-13 feat: 导入工创赛代码目录基线
    首次纳入版本管理。包含柔性振动检测模块的全部开发成果与配套文档。
    子项目：
    - vibmon_v2 当前主版本，模块化固件（config/mpu/sampler/dsp/state/output）
    - vibmon 上一版固件
    - zlj v1.1 原始版（sketch_oct12a）
    - mpu6050_min MPU6050 最小验证程序
    - selftest 自检程序
    - esp32c3 ESP32-C3 最小程序
    文档：
    - README.md 工程总说明
    - 串口帧协议草案.md 比赛帧协议草案
    - MPU6050寄存器速查.md 寄存器查阅表
    - 代码文件2.docx 代码说明文档
    - vibmon_v2/README.md v2 维护说明与调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
2026-10-18 config: 加速度计量程由 ±2g 改为 ±4g
    ACCEL_FS_SEL 从 0 改为 1，量程上限由 ±2g 提升到 ±4g，换取更大的抗削顶余量。
    换算逻辑不需要改动：mpuLsbPerG() 按 16384 >> ACCEL_FS_SEL 自动返回 8192 LSB/g，
    dsp.cpp 的两处换算都引用该函数，因此 mg 换算随配置自动生效。分辨率由
    16384 LSB/g 降到 8192 LSB/g，单位 mg 的分辨率相应由约 0.061 mg 变为约 0.122 mg。
    按 config.h 自身注释的要求，换量程后仍需实测确认振动峰值不削顶，并重新标定；
    削顶阈值 ACCEL_CLIP_RAW 保持 32700 不变。
    验证：test/host_test.cpp 编译通过（-std=c++17 -Wall），14 项全部通过。
    注意该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
2026-10-18 feat(vibmon_v2): 同步到 2026-10-18 开发版
    用工作区 C:\Users\Lenovo\Downloads\工创赛\vibmon_v2 的当前内容覆盖
    本仓库的 vibmon_v2/，共 29 个文件（16 个更新、13 个新增），无删除。
    逐文件 SHA256 与源目录一致。
    这一版对应问题清单 2026-10-18 状态：9 项（Q1~Q4、A1~A5）在代码层面
    已全部处理完毕，实板层面尚待实测。
    新增主机测试（test/，13 个文件）：
    - cal_test 标定候选提交与失败保留（Q1）
    - clip_test 削顶质量策略（A3）
    - comp_test 比赛帧打包与越界防护（A1）
    - gap_test 缺样后的状态层失效（Q3）
    - lock_probe 缓冲区同步与锁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
    [config.h, dsp.cpp, dsp.h, mpu.cpp, mpu.h, output.cpp, output.h]
2026-10-19 feat(vibmon_v2): 接触判据改为「到接触姿态的距离」(CT_MODE=2)
    接触判据（Q4）
    - 新增模式 2：以现场按 t 记录的「接触姿态」为参考点，求当前姿态到它的
    三轴距离；进入 400mg / 退出 700mg 形成滞回。
    - 模式 0/1 实测会全程误报（握住时姿态旋转约 100 度、振动同时变大），
    默认值改为 2，旧模式保留做对比与回归。
    参考点采集
    - 两阶段：先等 CT_REF_SETTLE_MS(300ms) 让手到位，再平均
    CT_REF_AVG_MS(500ms) 的样本。按瞬时值会偏离稳态约 1593mg。
    - 全程非阻塞，采样器保持运行，避免与 I2C 总线争用。
    其他
    - dsp: DspFrame 增加 ctAxis[3]，保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
2026-10-19 chore(vibmon_v2): 移除测试与临时调试模块，生成比赛烧录版
    为比赛烧录精简目录，删除不参与固件构建的内容：
    - test/（12 个主机测试 + 桩）：只在 PC 上编译，Arduino 构建本就不合并；
    - motor_test.h/.cpp：同板驱动马达的临时调试模块（MOTOR_TEST_ENABLE=0）。
    源码引用同步清理（共 5 处，无功能变更）：
    - vibmon_v2.ino：删除 #include 与 setup/loop 中的两处条件调用；
    - output.cpp：删除 #include 与 outPollCmd 中 m/H/P/q/r/W 命令分支。
    验证：
    - 全部 5 个编译单元（mpu/sampler/dsp/state/output）在主机桩下
    以 -Wall -fsyntax-only 通过，0 error；
    - 全目录 #includ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
    [output.cpp]
2026-10-19 docs(vibmon_v2): 新增「本烧录版改进说明」章节
    在模块划分与「相对 v1.1 的修改」之间插入新章节，说明 dc2d2c6 → 4db2630
    这一版到底改了什么：
    - 代码层面：移除 test/(17 文件) 与 motor_test(2 文件)，
    清理 .ino / output.cpp 中 5 处悬空引用（与 MOTOR_TEST_ENABLE=0 时行为等价）；
    - 文档层面：模块表标注烧录版性质、测试章节改为「如何取回」、新增本章；
    - 验证：5 个 .cpp 经主机桩 -Wall -fsyntax-only 全部 0 error，
    include 无悬空，{}/#if 配平；并注明未做真实 ESP32 工具链编译。
    数字均按 git 与实际目录核对：目录 33 → 14 个文件。
2026-10-19 refactor(vibmon_v3): 目录与版本号统一改为 v3
    将 vibmon_v2 更名为 vibmon_v3，并同步所有指向本目录的引用。
    重命名
    - 目录 vibmon_v2/ -> vibmon_v3/
    - 主程序 vibmon_v2.ino -> vibmon_v3.ino（Arduino 要求 .ino 与目录同名）
    - git 识别为 14 个 rename（R098~R100），历史完整保留
    内容同步
    - vibmon_v3.ino：文件头注释 v2.0 -> v3.0
    - output.cpp：上电横幅 vibmon v2.0 -> v3.0（会打印到串口）
    - README.md：标题改为 v3，新增版本沿革说明；
    模块表、arduino-cli 编译命令、测试取回命令中的目录名改为 vibmon_v3
    - 待补充内容与问题清单.md：标题与 .ino 行号引用改为 v3
    有意保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
    [config.h, dsp.cpp, dsp.h, mpu.cpp, mpu.h, output.cpp, output.h, sampler.cpp]
2026-10-29 fix(vibmon_v4): clear held gates on invalid data; default STRICT=1
    [C1_O1.csv, C1_run1.csv, C3_fix.csv, C3_run1.csv, C3_strict.csv, C4_fix.csv, C4_run1.csv, C5_run1.csv]
2026-10-29 feat(vibmon_v5): gyro-based closure angle judgment
    [H2.csv, axis_air.csv, axis_air2.csv, traj.csv, traj3.csv, v5_C3.csv, v5_C3b.csv, v5_C3c.csv]
2026-10-29 fix(vibmon_v5): gripNoObject needs real amplitude evidence; export closed/gyroW
    [output.cpp, state.cpp, state.h]
2026-10-30 docs(vibmon_v5): record C6 coupling retry
2026-10-30 fix(vibmon_v5): restore calibration and start-stop detection
    [config.h, output.cpp, state.cpp]
2026-10-31 docs(vibmon_v5): record cylinder tests and I2C blocker
2026-10-31 test(vibmon_v5): validate competition frame protocol
2026-10-31 test(vibmon_v5): remove debug printf from frame test
2026-10-31 docs(vibmon_v5): annotate core driver and posture flow
2026-10-31 fix(vibmon_v5): close review findings and align frequency gate
    [config.h, posture.cpp, state.cpp]
2026-10-31 fix(vibmon_v5): cover 80Hz contact band
    [config.h]
2026-10-31 fix(vibmon_v5): apply second-round field checklist
    [config.h, state.cpp]
2026-11-06 chore(t012): track v6 (contact rules v6) plus vib_range_test and uart_loopback; unfreeze v5 hold-era edits
    - v6: three-rule contact (settle + vibration to enter, gyro-only hold, gyro release)
    - host: contact_test 89/89, comp_frame 22/22, gyro 8/8 re-verified 2026-11-06
    - firmware SHA 0bf3c2fd... (build_uart, gitignored)
    - v5: T011/T009-era edits were uncommitted; committed as-is (still the default field build)
    [5round_repeat_20261102.csv, 5round_repeat_20261102_r1.csv, 5round_repeat_20261102_r1b.csv, 5round_repeat_20261102_r1c.csv, 5round_repeat_20261102b.csv, contact_duty_sweep_live_20261102.csv, contact_duty_sweep_vibmon_v5_fixed_20261102.csv, empty_grip_20261102.csv]
2026-11-06 chore(v5): commit T009/T011/T012-era edits and planning/result docs; drop core.a and pycache from index
    config.h CT_HOLD_ENABLE=1, SS gates 120/80, ss edge fix, README/current-state notes.
    .gitignore: *.a, core/, __pycache__/.
    [4cm_5round_20261102.csv, 4cm_5round_20261102b.csv, 4cm_repeat_20261102_r2.csv, 4cm_repeat_20261102_r3.csv, 4cm_repeat_20261102_r4.csv, 4cm_repeat_20261102_r5.csv, 4cm_source_check_20261102.csv, 4cm_source_check_20261102_run1.csv]
2026-11-06 chore(t013): v6 收口——宿主测试全绿、双 FQBN 0 warning、回放复现、README 当前版本
    - test/run_all.ps1: 一键跑 contact/gyro/comp_frame/dump/ss_replay，与基线比对
    - 测试/V6b: 出发体检采集脚本 + 流程（实板 A~D 未跑）
    - 代码/README.md: 新增「〇、当前版本」（v5/v6 差异、v6 现场开关、编译方法）
    - 结果/RT013-20261106.md: 验收 1~5 数据 + 出发判断表
    未改任何固件源码；v5 源码与 规划\ 未动。
2026-11-06 test(t013): 实板体检 A/C 落地——旧振子2Hz接触100%不掉、空握0误进
    - 新增 测试\V6b\振源控制.py / 分析.py；补 说明.txt
    - 数据：检查A-旧2Hz.txt（35s，#V6 moved 恒0.9°、ct 176/176）、检查C-空握.txt（70s，ct=1 0帧）
    - RT013 更新实板段；B/D 待把第二根 USB 换成 4pin(CH340) 后补
    未改任何固件源码。
2026-11-06 test(t013): 实板体检 B/D 落地——松手 20~396ms 退出、关源手握着 16.4s 不退、帧 35 字节
    - 新增 测试\V6b\退出延迟.py（用 的 AMP 塌陷定位松手时刻）
    - 数据：检查B-松手.txt（78s/3906帧）、检查B-松手2.txt（62s/3102帧）、cues
    - 检查D：正文 33 + CRLF = 35 字节、CHK 抽 5 帧全对、SEQ 不连续 0
    - RT013：补 B/D + 出发判断表退出延迟行
    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
2026-11-06 docs(t013): RT013 补上板/下板情况（体检后未烧回，板上仍是 v6 CDC 构建）
2026-11-06 feat(v6/t010): 黄灯接触闪 + y 三态命令；CSV/分频/命令门控预案宏（默认关）
    - output.cpp: LED_RUN 黄灯改 CT 联动 2Hz 闪；新增 'y' 三态 AUTO/ON/OFF + [LEDY] 回显；
    printStatus 增黄灯行；帮助加 y
    - config.h: 新增 COMP_FRAME_CSV / COMP_FRAME_DIV / COMP_FRAME_GATED 三只门控（默认 0/1/0，
    出发版字节流与判据零变化）+ 编译期校验
    - output.cpp: compBuildFrame 增 CSV 分支；compPeriodic 增分频与比赛口 'S'/'X' 命令门控；
    编码函数按 COMP_FRAME_CSV 条件编译，避免 -Wall 未使用函数警告
    - test/led_test.cpp: 新增（64 项：绿心跳、黄 AUTO/ON/OFF、FAULT/CAL 不回归、帮助含 y）
    - test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
2026-11-06 docs(t010): 现场适配预案手册 + 七个预编译固件变体清单
    - 答辩\现场适配预案手册_20261106.md: 17 项 × 3 情况 + 改法(宏名/文件) + 验证 + 成本分类；
    现场决策两行表、串口速查、GBK 答辩口径一行
    - vibmon_v6\_variants\: def/cl/csv/div2/gate/v5sem/uart 七个变体产物 + 固件变体清单.md
    （源码 a57322d，全部 0 warning）
    - .bin 不入库（项目 .gitignore），清单里记 SHA + 提交号 + 重编方法
2026-11-06 docs(t010): RT010 交卷（宿主 + 七变体 + 手册齐；实板 7 条验收待上板）
    未改任何判据链代码；实板段等检测模块插回来补。
2026-11-06 refactor(t010): 改动整体挪到新项目 vibmon_v7，vibmon_v6 恢复 T013 验收原样
    人类指示：不该改原来那份文件，要另建项目。
    - 新增 代码\vibmon_v7\：vibmon_v6 拷贝 + 黄灯接触闪 / y 三态 / 三只预案宏；
    与 v6 的固件源码差异只有 config.h 与 output.cpp，判据链逐字节相同
    - vibmon_v6\ 整体恢复到 366874e（T013 验收时的状态），_variants 与 led_test 移出
    - 手册、变体清单、RT010 里的路径一律改指 vibmon_v7
    - 七个变体从 vibmon_v7 重编（0 warning），SHA 更新；
    记录一条坑：7 个 arduino-cli 并行编会争用 Arduino15 构建缓存，gate 曾失败一次，单独重编即过
    - 代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
2026-11-06 test(t010): v7 上板，黄灯命令/回显/CAL 已证；CT 联动被振源 BROWNOUT 挡住
    - 新增 测试\V7\黄灯检查.py + 采集记录（黄灯.txt / 黄灯CT联动*.txt）
    - 实测端口映射：COM7=振源 C3-KEY，COM9=检测模块 v7
    - 实测 A/B 两路 90% 时模块只读到 A=6mg，且振源板 COM7 掉线重枚举（BROWNOUT 复位）
    - 手册 §14 补现场判据：串口消失几秒又回来 = 板子复位；RT010 记录进度与阻塞点
2026-11-06 test(t010): 实板 7 条验收全过——黄灯闪/灭/闪、$VD 506 帧全 35 字节 CHK 全对
    - 新增 测试\V7\读模块.py（先探 #F 再决定要不要补发 d，避免把调试行关掉）
    - 数据：黄灯CT联动8.txt（ct 1→0→1：71/75/41 帧，人确认灯态）、帧格式-300帧.txt（506 帧）
    - RT010：实板表 7 条全绿 + 结论 6；异常里记 ang 漂移观察项与换线约束
2026-11-08 fix(comp): switch competition frame to 0x55 binary
    9600 8N1 frame: 0x55 | vib_int | vib_dec | vib | contact | 0x0D. Frequency is split at 0.1Hz and invalid values send 0,0. COMP_FRAME_TRAILER_EN=0 builds the 5-byte variant for platforms that treat 'stop bit' as UART framing.
    Rewrite comp_frame_test for the binary frame (24/24, 5-byte variant 22/22) and document the 2026-11-08 competition failure: the module sent the self-designed \ ASCII frame while the platform expected 0x55.
    [config.h, output.cpp]
2026-11-08 docs: add version history from v1 to v9
    Document each version's role, changes, test status and remaining issues, including the four-generation contact-criterion evolution and the serial frame history.
2026-11-08 docs: add background, problem statement and source materials
    Add a readable background/problem overview plus an indexed 资料/ tree: official problem and scoring PDFs, extracted text, rules summary, BOM/netlist/pinout, hardware design notes, and software/version guides.
    [物料清单.xlsx]
2026-11-08 docs: add hands-on serial protocol exercises
    Add a six-level exercise from hand encoding to a streaming parser, a runnable Python drill with 19 checks, and a reference answer sheet. Covers 9600 8N1 timing, 0x55 framing, 0x55-in-payload resync, buffering and fault injection.
